molinzhao27/AmazingHand/README.md

## This fork: the 5-digit AmazingHand

This fork adds a pinky to the stock hand and rebuilds it around slim, styled 3-phalanx fingers and a powered 2-DOF wrist. The final version is the right hand `AH_Right_5F_3S_Wrist`.

| Full hand | Without the palm shell | Without shell or finger covers |
|:---:|:---:|:---:|
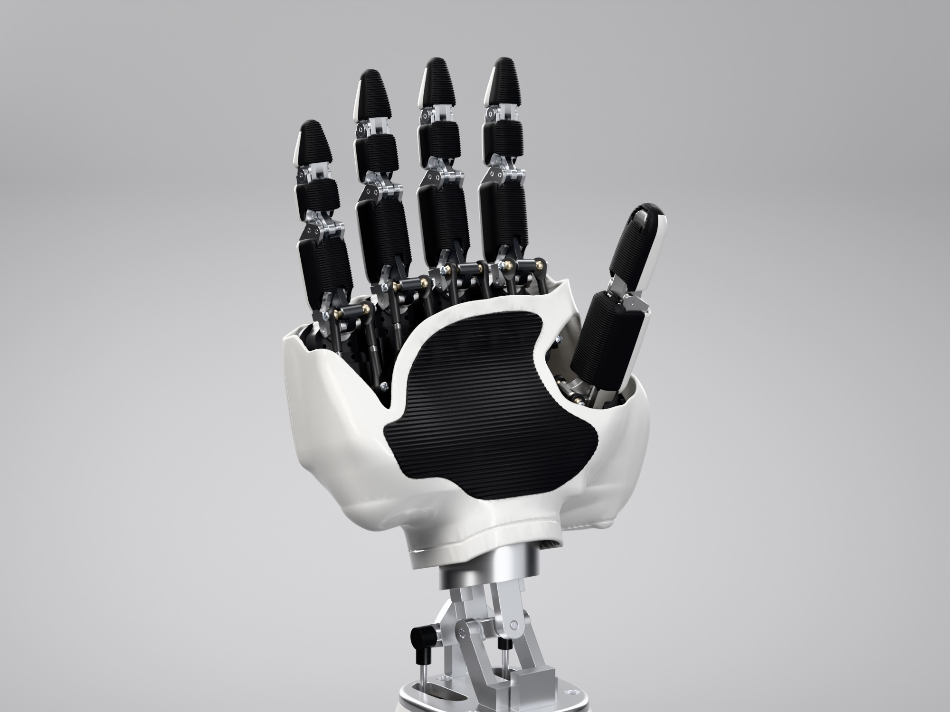
[picture p1: Demo/AHSimulation/five_finger/renders/beauty/hero.jpg]
final hand
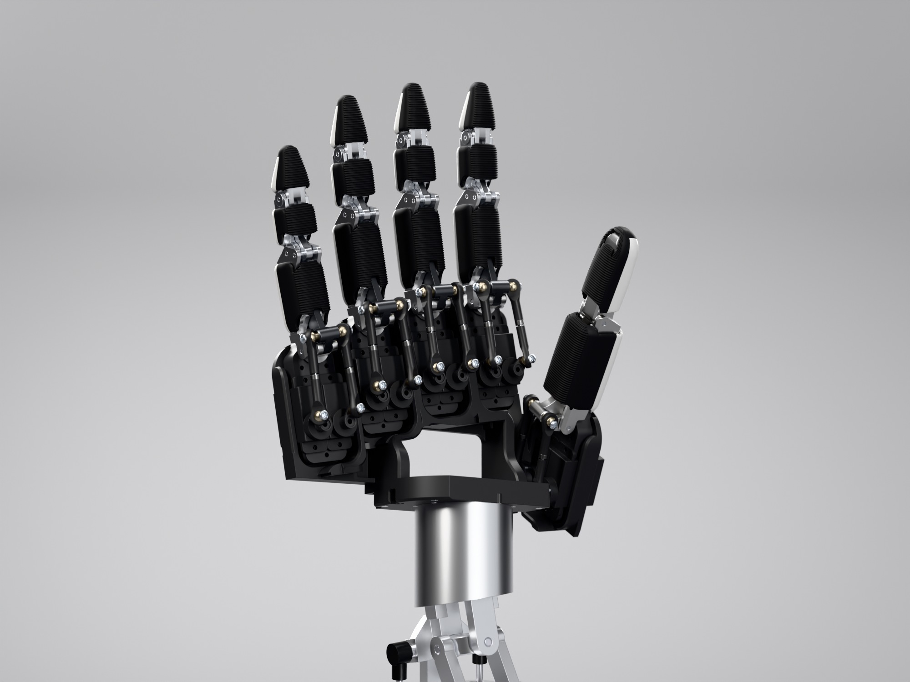
[picture p2: Demo/AHSimulation/five_finger/renders/beauty/no_shells/hero.jpg]
final hand, no palm shell
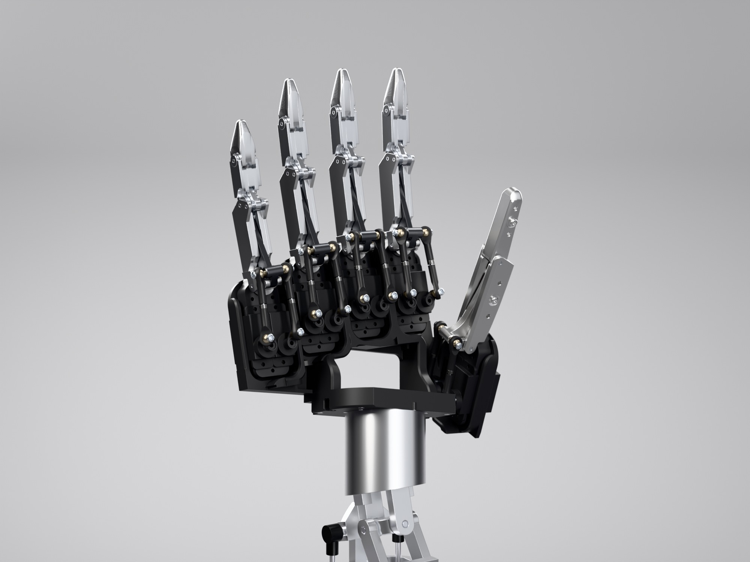
[picture p3: Demo/AHSimulation/five_finger/renders/beauty/no_covers/hero.jpg]
final hand, no shell or covers
|  |  |  |

| What | Where |
|---|---|
| Design notes, BOM delta, servo IDs, power | [FIVE_FINGER.md](FIVE_FINGER.md) |
| Assembled CAD (STEP + 3MF) | [cad/five_finger/assembly/](cad/five_finger/assembly/) |
| Palm plate, palm/back shells and grip pads (STL) | [cad/five_finger/stl/](cad/five_finger/stl/) |
| 3-phalanx fingers and thumb (STEP + STL) | [cad/five_finger/ultimate_finger/](cad/five_finger/ultimate_finger/) |
| Wrist and forearm base (STEP + STL) | [cad/five_finger/wrist/](cad/five_finger/wrist/) |
| MuJoCo model | [Demo/AHSimulation/AHSimulation/AH_Right_5F_3S_Wrist/mjcf/](Demo/AHSimulation/AHSimulation/AH_Right_5F_3S_Wrist/mjcf/) |
| Webcam teleop (sim; drives the final hand, wrist held straight) | [Demo/Teleop/](Demo/Teleop/) |

```bash
python -m mujoco.viewer --mjcf=Demo/AHSimulation/AHSimulation/AH_Right_5F_3S_Wrist/mjcf/scene_shells.xml
```

The other `AH_*_5F*` models are earlier steps. The build scripts still use `AH_Right_5F`, `AH_Right_5F_Slim` and `AH_Right_5F_3S` as inputs to the final one.

Everything below is the upstream Pollen Robotics README.

---

Project is licensed under [Apache 2.0](https://www.apache.org/licenses/LICENSE-2.0)

Mechanical design is licensed under a:
[Creative Commons Attribution 4.0 International License][cc-by].
[][cc-by]
[][cc-by]

[cc-by]: http://creativecommons.org/licenses/by/4.0/
[cc-by-image]: https://licensebuttons.net/l/by/4.0/88x31.png
[cc-by-shield]: https://img.shields.io/badge/License-CC%20BY-lightgrey.svg

# Amazing Hand project

Patterns

Robotic hands are often very expensive and not so expressive. More dexterous ones often need cables and deported actuators in the forearm, i.e.,

The aim of this project is to be able to explore humanoid hand possibilities on a real robot (and Reachy2 is the perfect candidate for that !) with moderate cost.
=> Wrist interface is designed for Reachy2's wrist (Orbita 3D), but it can be easily adapted to other robot's wrist...

Reachy

Amazing Hand is:
- 8 dofs humanoid hand with 4 fingers
- 2 phalanxes per finger articulated together
- flexible shells almost everywhere
- All actuators inside the hand, without any cables
- 3D printable
- 400g weight
- low-cost (<200€)
- open-source

[AmazingHand_Overview](/docs/AmazingHand_Overview.pdf)

Hand Overview
Each finger is driven by a parallel mechanism. 
That means 2x small Feetech SCS0009 servos are used to move each finger in flexion/extension and abduction/adduction

Finger Overview

Two control methods are available:
- Use a serial bus driver (Waveshare i.e.) + Python script
- Use an Arduino + Feetech TTL Linker

Detailed explanations are available for both ways, and basic demo software is also available.
Up to you !

##
## UPDATE : Amazing Hand become **enhanced**, follow the branch "Amazing Hand Enhanced" : https://github.com/pollen-robotics/AmazingHand/tree/Amazing-Hand-Enhanced/AmazingHand_Enhanced

## Table of contents

- [Build Resources](#build-resources)
    - [BOM (Bill Of Materials)](#bom-bill-of-materials)
    - [CAD Files and Onshape document](#cad-files-and-onshape-document)
    - [Assembly Guide](#assembly-guide)
    - [Run_basic_Demo](#run-basic-demo)    
- [Disclaimer](#disclaimer)
- [AmazingHand advanced Demo](#amazinghand-advanced-demo)   
- [Don't want to build it by yourself? Kits are available!](#don't-want-to-build-it-by-yourself-?)    
- [Project Updates & Community](#project-updates-&-community)
    - [To Do List](#to-do-list)
    - [FAQ](#faq)
    - [Contact](#contact)
    - [Thank you](#thank-you)

# Build Resources
## BOM (Bill Of Materials)
List of all needed components is available here:  
[AmazingHand BOM](https://docs.google.com/spreadsheets/d/1QH2ePseqXjAhkWdS9oBYAcHPrxaxkSRCgM_kOK0m52E/edit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)  
BOM

And remember to add control choice cost (2 options detailed previously)

Details for custom 3D printed parts are here: 
[3Dprinted parts](https://docs.google.com/spreadsheets/d/1QH2ePseqXjAhkWdS9oBYAcHPrxaxkSRCgM_kOK0m52E/edit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)

3Dparts

Here is a guide explaining how to print all the needed custom parts:
[=> 3D Printing Guide](/docs/AmazingHand_3DprintingTips.pdf)
3DPrint_example 

## CAD Files and Onshape document
STL and Steps files can be found [here](https://github.com/pollen-robotics/AmazingHand/tree/main/cad) 

Note that fingers are the same if you want to build a left hand, but some parts are symmetrical. Specific right hand parts are preceded by an "R", and other left hand parts by an "L".

Heart

Everyone can access the Onshape document too:   
[Link Onshape](https://cad.onshape.com/documents/430ff184cf3dd9557aaff2be/w/e3658b7152c139971d22c688/e/bd399bf1860732c6c6a2ee45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)  

Note that predefined positions are available in the "named position" tooling, with corresponding servo angles

Onshape&Named_Pos  

## Assembly Guide

Assembly guide for the Amazing Hand in combination with standard components in the BOM is here:  
[=> Assembly Guide](/docs/AmazingHand_Assembly.pdf)  
Assembly_example  

You will need a simple program / script to calibrate each finger, available here:
- With Python & Waveshare serial bus driver: [here](https://github.com/pollen-robotics/AmazingHand/tree/main/PythonExample)
- With Arduino & TTLinker: [here](https://github.com/pollen-robotics/AmazingHand/tree/main/ArduinoExample)

Note that this assembly guide is for a standalone right hand.

If you need to build a standalone left hand, you can keep the same IDs for servo locations, and select if it's a right or left hand in the software.

## Run basic Demo

A basic demo is available with both Python & Arduino.

You will need an external power supply to be able to power the 8 actuators inside the hand.

If you don't have one already, a simple external power supply could be a DC/DC 220V -> 5V / 2A adapter with jack connector.
Check on the BOM list:
[AmazingHand BOM](https://docs.google.com/spreadsheets/d/1QH2ePseqXjAhkWdS9oBYAcHPrxaxkSRCgM_kOK0m52E/edit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) 

- Python script: "AmazingHand_Demo.py" [here](https://github.com/pollen-robotics/AmazingHand/tree/main/ArduinoExample)
  
- Arduino program: "AmazingHand_Demo.ino" [here](https://github.com/pollen-robotics/AmazingHand/tree/main/PythonExample)

https://github.com/user-attachments/assets/485fc1f4-cc57-4e59-90b5-e84518b9fed0

## You need both right & left hands on the same bus ?

If you need to build both right and left hands to plug them on a robot, you will have to attribute different IDs for right and left hands. You can't have same ID for different servos on the same serial bus...
Very important thing is to keep same assembly order for servos, but set them different IDs than for the right hand, as follows:
IDs

Specific software is also needed, in order to drive each hand independently.
This simple demo runs the same hand patterns on both hands simultaneously, but it's only available in Python:
"AmazingHand_Demo_Both" [here](https://github.com/pollen-robotics/AmazingHand/tree/main/PythonExample)

# Disclaimer

I noticed some variations between theoretical angles for Flexion / Extension, Abduction / Adduction and angles in real life prototypes. This is probably due to several sources of variation (3D printed parts are not perfect, balljoint rods are manually adjusted one by one, servo horn rework, flexibility of plastic parts...).

This design has not yet been tested for long and complex prehensile tasks. Before being able to grasp objects safely (that means without damaging servos or mechanical parts), a kind of smart software needs to be built.
SCS0009 servos have smart capabilities as:
- Torque enable / disable
- Torque feedback
- Current position sensor
- Heat temperature feedback
- ...

# AmazingHand advanced Demo
Tracking demo (https://www.youtube.com/watch?v=U0TfeG3ZUto)

For more advanced usage using inverse/forward kinematics there are several examples in the [Demo](Demo) directory along with some useful tools to test/configure the motors.

# Don't want to build it by yourself?
=> Kits are available here :

Seeed Studio :
https://www.seeedstudio.com/Amazing-Hand-Right-Hand-The-Open-Source-Robotic-Hand-Developer-Kit.html

WowRobo :
https://shop.wowrobo.com/products/amazing-hand-the-open-source-robotic-hand-kit

# Project Updates & Community
## Updates from community

- ### Amazing Base for the amazing hand : 
Base
STL or Step file can be found [here](https://github.com/pollen-robotics/AmazingHand/tree/main/cad) 

- ### Specific Chinese BOM available here :
[Chinese BOM](https://docs.google.com/spreadsheets/d/1fHZiTky79vyZwICj5UGP2c_RiuLLm89K8HrB3vpb2h4/edit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)

Thanks to Jianliang Shen !

- ### Amazing Hand Control : Python GUI and CLI tools for controlling the AmazingHand
Key features :
- Control the fingers independently
- Real time monitoring of servo feedbacks
- Create custom animations by saving positions and replaying them sequentially
  
AmazingHandControl

Link to repository : [Link](https://github.com/Betatester777/AmazingHandControl)

Thanks to Betatester777 !

- ### Amazing hand with SG90 servos + force control setup 🔥

Force_control
Force_control_setup

GitHub with code: (https://github.com/joanbox24/AmazingHand-with-sg90-servo-force-control)

- ### Amazing hand interface for SO-Arm 🔥

SoHand

STL or Step file can be found [here](https://github.com/pollen-robotics/AmazingHand/tree/main/cad)
Or directly on onshape workspace, folder "community update"

## To Do List
- Design small custom pcb with serial hub and power supply functions, to fit everything in the hand
- Test with prehensile tasks 
      => Add smarter behaviour for closing hand, based on available motors feedbacks
- Study possibility to have 4 different fingers length, or add a 5th finger
- Study possibility to use STS3032 Feetech motors instead of SCS0009
      => Stronger for quite the same volume, but servo horn is different
- Study possibility to add compliancy by replacing rigid links to springs
- Add fingertip sensor to push one step higher smart control

## FAQ
WIP

## Contact

You can reach public discord channel here : 
[Discord AmazingHand](https://discord.com/channels/519098054377340948/1395021147346698300)

Or 
[Contact me or Pollen Robotics](/docs/contact.md)

## Thank you
Huge thanks to those who have contributed to this project so far:
- [Steve N'Guyen](https://github.com/SteveNguyen) for beta testing, Feetech motors integration in Rustypot, Mujoco/Mink and hand tracking demo
- [Pierre Rouanet](https://github.com/pierre-rouanet) for Feetech motors integration in pypot  
- [Augustin Crampette](https://fr.linkedin.com/in/augustin-crampette) & [Matthieu Lapeyre](https://www.linkedin.com/in/matthieulapeyre/) for open discussions and mechanical advices
