molinzhao27/AmazingHand/cad/five_finger/mockup/report.txt

All-printed mock-up of AH_Right_5F_3S_Wrist: printed stand-ins for the bought parts (generated by make_mockup.py; do not edit)

Fits (mm, diameter): PIN_D 2.0, AXLE_D 2.1, BALL_HOLE 2.0, PEG_D 2.0, STUB_D 4.0, HORN_BORE 3.9, BALL_D 5.0, CUP_CLEAR 0.15, CUP_LIP 1.2, SLIT_W 0.6, WBALL_D 5.8, WBALL_HOLE 3.2, BALL_HALF 2.0, HORN_BOSS 1.6, WCUP_LIP 1.4, STS_STUB_D 6.0, DISC_BORE 5.9, M25_PEG_D 2.4, DISC_HOLE 2.3, F683_OD 7.1, F683_BORE 3.25, PIN3_D 3.05, STUD_TOP_SHANK 4.1, STUD_ARM_SHANK 3.3, INSERT_OD 4.1, INSERT_ID 2.85, M3_PEG_D 3.0, FILAMENT 1.75, CLEAR_FRAME 0.15

stand-in                  qty   deepest overlap with a printed part  note
Axle_D2.1_L20               5    0.05 mm  thumb_Link                  through the Link's d2.2 ball-stud hole, a Ball_D5 pressed on each end
Ball_D5                    20    0.00 mm  -                           d5 ball, pressed flush on the end of a Link axle (2 per Link) or a horn's stud pin (1 per horn)
Bushing_0608               10    0.00 mm  thumb_Gimbal                replaces Bushing_0608 (same shape)
Dummy_SCS0009              10    0.00 mm  -                           servo stand-in; its ear holes (d2.0) take 1.75 mm filament pins into the finger frames
Mock_Horn                  10    0.00 mm  -                           cross horn + the stud's nut; slides onto the Dummy_SCS0009 stub (friction)
Peg_2.5x16                  3                 (no place in the sim)  back shell -> palm plate ribs (2.5x16 thermoplastic screws)
Peg_2.5x6                   4                 (no place in the sim)  hand adapter -> palm plate legs (2.5x6 thermoplastic screws)
Peg_2.5x8                  22                 (no place in the sim)  2.5x8 thermoplastic screw: gimbal (with the washer) 5, finger frames -> plate 3 per digit, back shell -> hand adapter 2
Pin_D2_L10                  6    0.70 mm  thumb_Proximal_Slim         d2 x 10 dowel: printed pin, or a 1.75 mm filament piece (looser)
Pin_D2_L12                 12    0.03 mm  middle_P1_Proximal          d2 x 12 dowel: printed pin, or a 1.75 mm filament piece (looser)
Pin_D2_L16                  6    0.00 mm  thumb_Proximal_Slim         d2 x 16 dowel: printed pin, or a 1.75 mm filament piece (looser)
Pin_D2_L8                   8    0.03 mm  pinky_P3_Distal_S088        d2 x 8 dowel: printed pin, or a 1.75 mm filament piece (looser)
Rod_index_M1                1    0.00 mm  -                           push rod, 33.00 mm between ball centres: cup with the mouth up on the horn ball, the other on the Link ball
Rod_index_M2                1    0.00 mm  -                           push rod, 33.00 mm between ball centres: cup with the mouth up on the horn ball, the other on the Link ball
Rod_middle_M1               1    0.00 mm  -                           push rod, 33.00 mm between ball centres: cup with the mouth up on the horn ball, the other on the Link ball
Rod_middle_M2               1    0.00 mm  -                           push rod, 33.00 mm between ball centres: cup with the mouth up on the horn ball, the other on the Link ball
Rod_pinky_M1                1    0.00 mm  -                           push rod, 33.00 mm between ball centres: cup with the mouth up on the horn ball, the other on the Link ball
Rod_pinky_M2                1    0.00 mm  -                           push rod, 33.00 mm between ball centres: cup with the mouth up on the horn ball, the other on the Link ball
Rod_ring_M1                 1    0.00 mm  -                           push rod, 33.00 mm between ball centres: cup with the mouth up on the horn ball, the other on the Link ball
Rod_ring_M2                 1    0.00 mm  -                           push rod, 33.00 mm between ball centres: cup with the mouth up on the horn ball, the other on the Link ball
Rod_thumb_M1                1    0.00 mm  -                           push rod, 33.00 mm between ball centres: cup with the mouth up on the horn ball, the other on the Link ball
Rod_thumb_M2                1    0.00 mm  -                           push rod, 33.00 mm between ball centres: cup with the mouth up on the horn ball, the other on the Link ball
Stud_Pin_D2.1_L8           10    0.00 mm  -                           the horn's ball stud: pressed through the arm and its boss, flush below; a Ball_D5 pressed on top
Washer_M2.5                 5    0.00 mm  thumb_Gimbal                replaces Washer_M2.5 (same shape)
Ball_D5.8                   4    0.00 mm  -                           d5.8 ball, pressed flush on the end of a ball stud's neck
Ball_Stud_Arm               2    0.23 mm  Wrist_Horn_Arm_2            M3 ball stud stand-in, a pin printed lying down: shank presses through the horn arm (no nut); a Ball_D5.8 pressed flush on the neck
Ball_Stud_Top               2    0.00 mm  -                           M3 ball stud stand-in, a pin printed lying down: shank presses into the lever bar's insert hole; a Ball_D5.8 pressed flush on the neck
Bushing_F683                4    0.09 mm  R-Wrist_Fork                F683ZZ flanged bearing stand-in (4 lugs)
Disc_Horn                   2    0.23 mm  Wrist_Horn_Arm_1            25T disc horn stand-in: slides onto the Dummy_STS3215 stub; the Wrist_Horn_Arm pegs onto it
Dummy_STS3215               2    0.10 mm  R-Wrist_Servo_Frame         STS3215 stand-in (make_wrist's servo box) with a plain d6 output stub
Insert_M3                  12                 (no place in the sim)  M3 heat-set insert stand-in, pressed into the d4.0 insert holes (the bar's 2 take the ball studs)
Peg_M2.5x6                  8                 (no place in the sim)  Wrist_Horn_Arm -> Disc_Horn (4 per arm)
Peg_M3x10                   8                 (no place in the sim)  fork cap 4, elbow flange 4
Peg_M3x8_CSK                4                 (no place in the sim)  servo frame
Pin_D3_L10                  4    0.10 mm  Wrist_Gimbal_Ring           d3 x 10 gimbal pin (press into the ring)
Rod_Wrist_M1                1    0.00 mm  -                           wrist push rod, 66.0 mm between ball centres (cups snap onto the studs)
Rod_Wrist_M2                1    0.00 mm  -                           wrist push rod, 96.0 mm between ball centres (cups snap onto the studs)
