molinzhao27/AmazingHand/cad/five_finger/assembly/report.txt

Assembled CAD of AH_Right_5F_3S_Wrist (generated by make_assembly.py; do not edit)

Sim: Demo/AHSimulation/AHSimulation/AH_Right_5F_3S_Wrist/mjcf/scene_shells.xml, keyframe 'zero' (wrist at wrist_flexion -0.107 deg, wrist_deviation +0.168 deg, wrist_motor1 +0.048 deg, wrist_motor2 +0.222 deg).
Frame: the hand's CAD frame (the palm plate's, as every part in cad/), mm: x index -> pinky, y along the fingers, z towards the back.
256 sim mesh geoms = 255 parts (the hand adapter is split in the sim: interface plate + neck).

AH_Right_5F_3S_Wrist_assembly.step: 98 parts as B-rep (STEP of the part, or the solid it is built from), in sub-assemblies palm, index, middle, ring, pinky, thumb, wrist.
  re-imported: 98 parts, names all match, vertices within 9.8e-11 mm of where they were put, volumes within 2.8e-06 (relative).
AH_Right_5F_3S_Wrist_assembly.3mf: all 255 parts as meshes (the sim meshes, 91 distinct), same names and frame.
  re-imported: 255 parts; every sim vertex within 1.2e-05 mm of its part's vertices.

Placement check (B-rep parts): sim -> CAD = distance of the sim mesh's world vertices to the placed B-rep surface, tessellated to 0.002 mm (max / 99th percentile, limit 0.05 mm); CAD -> sim = the B-rep's surface to the sim mesh (max, limit 1.0 mm): mostly the sim STL's own chordal error (the cad/ STLs are exported with cadquery's relative tolerance), it would catch a STEP feature that the STL lacks.
Mesh parts: the file placed by its 3MF transform vs the sim's world vertices: <= 4.2e-06 mm.
Result: every B-rep part is in place.

part                                       in    source                                                              sim->CAD max/p99  CAD->sim
R-Hand_Plate_5F                            STEP  cad/five_finger/step/R-Hand_Plate_5F.step                            0.0037 / 0.0009    0.0177
R-Palm_Pad_Palm_5F                         3MF   cad/five_finger/stl/R-Palm_Pad_Palm_5F.stl                         
R-Palm_Shell_5F                            3MF   cad/five_finger/stl/R-Palm_Shell_5F.stl                            
R-Top_Shell_5F                             3MF   cad/five_finger/stl/R-Top_Shell_5F.stl                             
index_Bushing_0608_1                       3MF   Demo/AHSimulation/AHSimulation/AH_Right_5F_3S_Wrist/mjcf/assets/bushing_0608_04.stl (m) 
index_Bushing_0608_2                       3MF   Demo/AHSimulation/AHSimulation/AH_Right_5F_3S_Wrist/mjcf/assets/bushing_0608_04.stl (m) 
index_Finger_Frame-1                       STEP  cad/step/Amazing Hand Parts - Finger_Frame-1.step (ICP onto the sim STL)   0.0004 / 0.0004    0.0054
index_Finger_Frame-2                       STEP  cad/step/Amazing Hand Parts - Finger_Frame-2.step (ICP onto the sim STL)   0.0003 / 0.0003    0.0038
index_Gimbal                               STEP  cad/step/Amazing Hand Parts - Gimbal.step (ICP onto the sim STL)     0.0009 / 0.0007    0.0095
index_L2_Coupler                           STEP  cad/five_finger/ultimate_finger/step/UF_L2_Coupler.step              0.0000 / 0.0000    0.0000
index_P1_Pad                               3MF   cad/five_finger/ultimate_finger/stl/UF_P1_Pad.stl                  
index_P1_Proximal                          STEP  cad/five_finger/ultimate_finger/step/UF_P1_Proximal.step             0.0034 / 0.0002    0.0017
index_P1_Shell                             3MF   cad/five_finger/ultimate_finger/stl/UF_P1_Shell.stl                
index_P2_Middle                            STEP  cad/five_finger/ultimate_finger/step/UF_P2_Middle.step               0.0000 / 0.0000    0.0000
index_P2_Pad                               3MF   cad/five_finger/ultimate_finger/stl/UF_P2_Pad.stl                  
index_P2_Shell                             3MF   cad/five_finger/ultimate_finger/stl/UF_P2_Shell.stl                
index_P3_Distal                            3MF   cad/five_finger/ultimate_finger/stl/UF_P3_Distal.stl               
index_P3_Pad                               3MF   cad/five_finger/ultimate_finger/stl/UF_P3_Pad.stl                  
index_P3_Shell                             3MF   cad/five_finger/ultimate_finger/stl/UF_P3_Shell.stl                
index_Pin_2x10                             3MF   Demo/AHSimulation/AHSimulation/AH_Right_5F_3S_Wrist/mjcf/assets/parallel_pin_2_x_10__fee063fca0c8b40e46bbc4ffff61d999.stl (m) 
index_Rod_M2_L18_M1                        3MF   Demo/AHSimulation/AHSimulation/AH_Right_5F_3S_Wrist/mjcf/assets/m2_rod_l18.stl (m) 
index_Rod_M2_L18_M2                        3MF   Demo/AHSimulation/AHSimulation/AH_Right_5F_3S_Wrist/mjcf/assets/m2_rod_l18.stl (m) 
index_Rotule_Ball_1                        3MF   Demo/AHSimulation/AHSimulation/AH_Right_5F_3S_Wrist/mjcf/assets/rotule_ball.stl (m) 
index_Rotule_Ball_2                        3MF   Demo/AHSimulation/AHSimulation/AH_Right_5F_3S_Wrist/mjcf/assets/rotule_ball.stl (m) 
index_Rotule_Ball_M1                       3MF   Demo/AHSimulation/AHSimulation/AH_Right_5F_3S_Wrist/mjcf/assets/rotule_ball.stl (m) 
index_Rotule_Ball_M2                       3MF   Demo/AHSimulation/AHSimulation/AH_Right_5F_3S_Wrist/mjcf/assets/rotule_ball.stl (m) 
index_Rotule_Lever_M1_1                    3MF   Demo/AHSimulation/AHSimulation/AH_Right_5F_3S_Wrist/mjcf/assets/rotule_lever.stl (m) 
index_Rotule_Lever_M1_2                    3MF   Demo/AHSimulation/AHSimulation/AH_Right_5F_3S_Wrist/mjcf/assets/rotule_lever.stl (m) 
index_Rotule_Lever_M2_1                    3MF   Demo/AHSimulation/AHSimulation/AH_Right_5F_3S_Wrist/mjcf/assets/rotule_lever.stl (m) 
index_Rotule_Lever_M2_2                    3MF   Demo/AHSimulation/AHSimulation/AH_Right_5F_3S_Wrist/mjcf/assets/rotule_lever.stl (m) 
index_SCS0009_Servo_M1                     3MF   Demo/AHSimulation/AHSimulation/AH_Right_5F_3S_Wrist/mjcf/assets/scs0009.stl (m) 
index_SCS0009_Servo_M2                     3MF   Demo/AHSimulation/AHSimulation/AH_Right_5F_3S_Wrist/mjcf/assets/scs0009.stl (m) 
index_Screw_2.5x8_Torx                     3MF   Demo/AHSimulation/AHSimulation/AH_Right_5F_3S_Wrist/mjcf/assets/std00333_plast_tcb_torx_2_5x8__configuration_copy_of_default.stl (m) 
index_Screw_M2x10_Pan_1                    3MF   Demo/AHSimulation/AHSimulation/AH_Right_5F_3S_Wrist/mjcf/assets/ph_pan_head_screw_m2x0_40_x_10__2803432263e518bbd16bccbbef8784ed.stl (m) 
index_Screw_M2x10_Pan_2                    3MF   Demo/AHSimulation/AHSimulation/AH_Right_5F_3S_Wrist/mjcf/assets/ph_pan_head_screw_m2x0_40_x_10__2803432263e518bbd16bccbbef8784ed.stl (m) 
index_Screw_M2x10_Pan_M1                   3MF   Demo/AHSimulation/AHSimulation/AH_Right_5F_3S_Wrist/mjcf/assets/ph_pan_head_screw_m2x0_40_x_10__2803432263e518bbd16bccbbef8784ed.stl (m) 
index_Screw_M2x10_Pan_M2                   3MF   Demo/AHSimulation/AHSimulation/AH_Right_5F_3S_Wrist/mjcf/assets/ph_pan_head_screw_m2x0_40_x_10__2803432263e518bbd16bccbbef8784ed.stl (m) 
index_Servo_Horn_M1                        3MF   Demo/AHSimulation/AHSimulation/AH_Right_5F_3S_Wrist/mjcf/assets/custom_servo_horn.stl (m) 
index_Servo_Horn_M2                        3MF   Demo/AHSimulation/AHSimulation/AH_Right_5F_3S_Wrist/mjcf/assets/custom_servo_horn.stl (m) 
index_Spacer_M1                            STEP  cad/step/BallJoint_Rod - Spacer.step (ICP onto the sim STL)          0.0002 / 0.0002    0.0019
index_Spacer_M2                            STEP  cad/step/BallJoint_Rod - Spacer.step (ICP onto the sim STL)          0.0002 / 0.0002    0.0019
index_UF_Link                              STEP  cad/five_finger/ultimate_finger/step/UF_Link.step                    0.0002 / 0.0002    0.0024
index_Washer_M2.5                          3MF   Demo/AHSimulation/AHSimulation/AH_Right_5F_3S_Wrist/mjcf/assets/plain_washer_large_grade_a_m2_5__9a369f0dc77bf9c598cdf3fb468977e5.stl (m) 
index_pin_2x12_A                           STEP  cad/five_finger/ultimate_finger/step/pin_2x12_A.step                 0.0000 / 0.0000    0.0008
index_pin_2x12_DIP                         STEP  cad/five_finger/ultimate_finger/step/pin_2x12_DIP.step               0.0000 / 0.0000    0.0008
index_pin_2x12_PIP                         STEP  cad/five_finger/ultimate_finger/step/pin_2x12_PIP.step               0.0000 / 0.0000    0.0008
index_pin_2x16_MCP                         STEP  cad/five_finger/ultimate_finger/step/pin_2x16_MCP.step               0.0000 / 0.0000    0.0008
index_pin_2x8_B                            STEP  cad/five_finger/ultimate_finger/step/pin_2x8_B.step                  0.0000 / 0.0000    0.0008
index_pin_2x8_P4                           STEP  cad/five_finger/ultimate_finger/step/pin_2x8_P4.step                 0.0000 / 0.0000    0.0008
middle_Bushing_0608_1                      3MF   Demo/AHSimulation/AHSimulation/AH_Right_5F_3S_Wrist/mjcf/assets/bushing_0608_04.stl (m) 
middle_Bushing_0608_2                      3MF   Demo/AHSimulation/AHSimulation/AH_Right_5F_3S_Wrist/mjcf/assets/bushing_0608_04.stl (m) 
middle_Finger_Frame-1                      STEP  cad/step/Amazing Hand Parts - Finger_Frame-1.step (ICP onto the sim STL)   0.0004 / 0.0004    0.0054
middle_Finger_Frame-2                      STEP  cad/step/Amazing Hand Parts - Finger_Frame-2.step (ICP onto the sim STL)   0.0003 / 0.0003    0.0038
middle_Gimbal                              STEP  cad/step/Amazing Hand Parts - Gimbal.step (ICP onto the sim STL)     0.0009 / 0.0007    0.0095
middle_L2_Coupler                          STEP  cad/five_finger/ultimate_finger/step/UF_L2_Coupler.step              0.0000 / 0.0000    0.0000
middle_P1_Pad                              3MF   cad/five_finger/ultimate_finger/stl/UF_P1_Pad.stl                  
middle_P1_Proximal                         STEP  cad/five_finger/ultimate_finger/step/UF_P1_Proximal.step             0.0034 / 0.0002    0.0017
middle_P1_Shell                            3MF   cad/five_finger/ultimate_finger/stl/UF_P1_Shell.stl                
middle_P2_Middle                           STEP  cad/five_finger/ultimate_finger/step/UF_P2_Middle.step               0.0000 / 0.0000    0.0000
middle_P2_Pad                              3MF   cad/five_finger/ultimate_finger/stl/UF_P2_Pad.stl                  
middle_P2_Shell                            3MF   cad/five_finger/ultimate_finger/stl/UF_P2_Shell.stl                
middle_P3_Distal                           3MF   cad/five_finger/ultimate_finger/stl/UF_P3_Distal.stl               
middle_P3_Pad                              3MF   cad/five_finger/ultimate_finger/stl/UF_P3_Pad.stl                  
middle_P3_Shell                            3MF   cad/five_finger/ultimate_finger/stl/UF_P3_Shell.stl                
middle_Pin_2x10                            3MF   Demo/AHSimulation/AHSimulation/AH_Right_5F_3S_Wrist/mjcf/assets/parallel_pin_2_x_10__fee063fca0c8b40e46bbc4ffff61d999.stl (m) 
middle_Rod_M2_L18_M1                       3MF   Demo/AHSimulation/AHSimulation/AH_Right_5F_3S_Wrist/mjcf/assets/m2_rod_l18.stl (m) 
middle_Rod_M2_L18_M2                       3MF   Demo/AHSimulation/AHSimulation/AH_Right_5F_3S_Wrist/mjcf/assets/m2_rod_l18.stl (m) 
middle_Rotule_Ball_1                       3MF   Demo/AHSimulation/AHSimulation/AH_Right_5F_3S_Wrist/mjcf/assets/rotule_ball.stl (m) 
middle_Rotule_Ball_2                       3MF   Demo/AHSimulation/AHSimulation/AH_Right_5F_3S_Wrist/mjcf/assets/rotule_ball.stl (m) 
middle_Rotule_Ball_M1                      3MF   Demo/AHSimulation/AHSimulation/AH_Right_5F_3S_Wrist/mjcf/assets/rotule_ball.stl (m) 
middle_Rotule_Ball_M2                      3MF   Demo/AHSimulation/AHSimulation/AH_Right_5F_3S_Wrist/mjcf/assets/rotule_ball.stl (m) 
middle_Rotule_Lever_M1_1                   3MF   Demo/AHSimulation/AHSimulation/AH_Right_5F_3S_Wrist/mjcf/assets/rotule_lever.stl (m) 
middle_Rotule_Lever_M1_2                   3MF   Demo/AHSimulation/AHSimulation/AH_Right_5F_3S_Wrist/mjcf/assets/rotule_lever.stl (m) 
middle_Rotule_Lever_M2_1                   3MF   Demo/AHSimulation/AHSimulation/AH_Right_5F_3S_Wrist/mjcf/assets/rotule_lever.stl (m) 
middle_Rotule_Lever_M2_2                   3MF   Demo/AHSimulation/AHSimulation/AH_Right_5F_3S_Wrist/mjcf/assets/rotule_lever.stl (m) 
middle_SCS0009_Servo_M1                    3MF   Demo/AHSimulation/AHSimulation/AH_Right_5F_3S_Wrist/mjcf/assets/scs0009.stl (m) 
middle_SCS0009_Servo_M2                    3MF   Demo/AHSimulation/AHSimulation/AH_Right_5F_3S_Wrist/mjcf/assets/scs0009.stl (m) 
middle_Screw_2.5x8_Torx                    3MF   Demo/AHSimulation/AHSimulation/AH_Right_5F_3S_Wrist/mjcf/assets/std00333_plast_tcb_torx_2_5x8__configuration_copy_of_default.stl (m) 
middle_Screw_M2x10_Pan_1                   3MF   Demo/AHSimulation/AHSimulation/AH_Right_5F_3S_Wrist/mjcf/assets/ph_pan_head_screw_m2x0_40_x_10__2803432263e518bbd16bccbbef8784ed.stl (m) 
middle_Screw_M2x10_Pan_2                   3MF   Demo/AHSimulation/AHSimulation/AH_Right_5F_3S_Wrist/mjcf/assets/ph_pan_head_screw_m2x0_40_x_10__2803432263e518bbd16bccbbef8784ed.stl (m) 
middle_Screw_M2x10_Pan_M1                  3MF   Demo/AHSimulation/AHSimulation/AH_Right_5F_3S_Wrist/mjcf/assets/ph_pan_head_screw_m2x0_40_x_10__2803432263e518bbd16bccbbef8784ed.stl (m) 
middle_Screw_M2x10_Pan_M2                  3MF   Demo/AHSimulation/AHSimulation/AH_Right_5F_3S_Wrist/mjcf/assets/ph_pan_head_screw_m2x0_40_x_10__2803432263e518bbd16bccbbef8784ed.stl (m) 
middle_Servo_Horn_M1                       3MF   Demo/AHSimulation/AHSimulation/AH_Right_5F_3S_Wrist/mjcf/assets/custom_servo_horn.stl (m) 
middle_Servo_Horn_M2                       3MF   Demo/AHSimulation/AHSimulation/AH_Right_5F_3S_Wrist/mjcf/assets/custom_servo_horn.stl (m) 
middle_Spacer_M1                           STEP  cad/step/BallJoint_Rod - Spacer.step (ICP onto the sim STL)          0.0002 / 0.0002    0.0019
middle_Spacer_M2                           STEP  cad/step/BallJoint_Rod - Spacer.step (ICP onto the sim STL)          0.0002 / 0.0002    0.0019
middle_UF_Link                             STEP  cad/five_finger/ultimate_finger/step/UF_Link.step                    0.0002 / 0.0002    0.0024
middle_Washer_M2.5                         3MF   Demo/AHSimulation/AHSimulation/AH_Right_5F_3S_Wrist/mjcf/assets/plain_washer_large_grade_a_m2_5__9a369f0dc77bf9c598cdf3fb468977e5.stl (m) 
middle_pin_2x12_A                          STEP  cad/five_finger/ultimate_finger/step/pin_2x12_A.step                 0.0000 / 0.0000    0.0008
middle_pin_2x12_DIP                        STEP  cad/five_finger/ultimate_finger/step/pin_2x12_DIP.step               0.0000 / 0.0000    0.0008
middle_pin_2x12_PIP                        STEP  cad/five_finger/ultimate_finger/step/pin_2x12_PIP.step               0.0000 / 0.0000    0.0008
middle_pin_2x16_MCP                        STEP  cad/five_finger/ultimate_finger/step/pin_2x16_MCP.step               0.0000 / 0.0000    0.0008
middle_pin_2x8_B                           STEP  cad/five_finger/ultimate_finger/step/pin_2x8_B.step                  0.0000 / 0.0000    0.0008
middle_pin_2x8_P4                          STEP  cad/five_finger/ultimate_finger/step/pin_2x8_P4.step                 0.0000 / 0.0000    0.0008
ring_Bushing_0608_1                        3MF   Demo/AHSimulation/AHSimulation/AH_Right_5F_3S_Wrist/mjcf/assets/bushing_0608_04.stl (m) 
ring_Bushing_0608_2                        3MF   Demo/AHSimulation/AHSimulation/AH_Right_5F_3S_Wrist/mjcf/assets/bushing_0608_04.stl (m) 
ring_Finger_Frame-1                        STEP  cad/step/Amazing Hand Parts - Finger_Frame-1.step (ICP onto the sim STL)   0.0004 / 0.0004    0.0054
ring_Finger_Frame-2                        STEP  cad/step/Amazing Hand Parts - Finger_Frame-2.step (ICP onto the sim STL)   0.0003 / 0.0003    0.0038
ring_Gimbal                                STEP  cad/step/Amazing Hand Parts - Gimbal.step (ICP onto the sim STL)     0.0009 / 0.0007    0.0095
ring_L2_Coupler                            STEP  cad/five_finger/ultimate_finger/step/UF_L2_Coupler.step              0.0000 / 0.0000    0.0000
ring_P1_Pad                                3MF   cad/five_finger/ultimate_finger/stl/UF_P1_Pad.stl                  
ring_P1_Proximal                           STEP  cad/five_finger/ultimate_finger/step/UF_P1_Proximal.step             0.0034 / 0.0002    0.0017
ring_P1_Shell                              3MF   cad/five_finger/ultimate_finger/stl/UF_P1_Shell.stl                
ring_P2_Middle                             STEP  cad/five_finger/ultimate_finger/step/UF_P2_Middle.step               0.0000 / 0.0000    0.0000
ring_P2_Pad                                3MF   cad/five_finger/ultimate_finger/stl/UF_P2_Pad.stl                  
ring_P2_Shell                              3MF   cad/five_finger/ultimate_finger/stl/UF_P2_Shell.stl                
ring_P3_Distal                             3MF   cad/five_finger/ultimate_finger/stl/UF_P3_Distal.stl               
ring_P3_Pad                                3MF   cad/five_finger/ultimate_finger/stl/UF_P3_Pad.stl                  
ring_P3_Shell                              3MF   cad/five_finger/ultimate_finger/stl/UF_P3_Shell.stl                
ring_Pin_2x10                              3MF   Demo/AHSimulation/AHSimulation/AH_Right_5F_3S_Wrist/mjcf/assets/parallel_pin_2_x_10__fee063fca0c8b40e46bbc4ffff61d999.stl (m) 
ring_Rod_M2_L18_M1                         3MF   Demo/AHSimulation/AHSimulation/AH_Right_5F_3S_Wrist/mjcf/assets/m2_rod_l18.stl (m) 
ring_Rod_M2_L18_M2                         3MF   Demo/AHSimulation/AHSimulation/AH_Right_5F_3S_Wrist/mjcf/assets/m2_rod_l18.stl (m) 
ring_Rotule_Ball_1                         3MF   Demo/AHSimulation/AHSimulation/AH_Right_5F_3S_Wrist/mjcf/assets/rotule_ball.stl (m) 
ring_Rotule_Ball_2                         3MF   Demo/AHSimulation/AHSimulation/AH_Right_5F_3S_Wrist/mjcf/assets/rotule_ball.stl (m) 
ring_Rotule_Ball_M1                        3MF   Demo/AHSimulation/AHSimulation/AH_Right_5F_3S_Wrist/mjcf/assets/rotule_ball.stl (m) 
ring_Rotule_Ball_M2                        3MF   Demo/AHSimulation/AHSimulation/AH_Right_5F_3S_Wrist/mjcf/assets/rotule_ball.stl (m) 
ring_Rotule_Lever_M1_1                     3MF   Demo/AHSimulation/AHSimulation/AH_Right_5F_3S_Wrist/mjcf/assets/rotule_lever.stl (m) 
ring_Rotule_Lever_M1_2                     3MF   Demo/AHSimulation/AHSimulation/AH_Right_5F_3S_Wrist/mjcf/assets/rotule_lever.stl (m) 
ring_Rotule_Lever_M2_1                     3MF   Demo/AHSimulation/AHSimulation/AH_Right_5F_3S_Wrist/mjcf/assets/rotule_lever.stl (m) 
ring_Rotule_Lever_M2_2                     3MF   Demo/AHSimulation/AHSimulation/AH_Right_5F_3S_Wrist/mjcf/assets/rotule_lever.stl (m) 
ring_SCS0009_Servo_M1                      3MF   Demo/AHSimulation/AHSimulation/AH_Right_5F_3S_Wrist/mjcf/assets/scs0009.stl (m) 
ring_SCS0009_Servo_M2                      3MF   Demo/AHSimulation/AHSimulation/AH_Right_5F_3S_Wrist/mjcf/assets/scs0009.stl (m) 
ring_Screw_2.5x8_Torx                      3MF   Demo/AHSimulation/AHSimulation/AH_Right_5F_3S_Wrist/mjcf/assets/std00333_plast_tcb_torx_2_5x8__configuration_copy_of_default.stl (m) 
ring_Screw_M2x10_Pan_1                     3MF   Demo/AHSimulation/AHSimulation/AH_Right_5F_3S_Wrist/mjcf/assets/ph_pan_head_screw_m2x0_40_x_10__2803432263e518bbd16bccbbef8784ed.stl (m) 
ring_Screw_M2x10_Pan_2                     3MF   Demo/AHSimulation/AHSimulation/AH_Right_5F_3S_Wrist/mjcf/assets/ph_pan_head_screw_m2x0_40_x_10__2803432263e518bbd16bccbbef8784ed.stl (m) 
ring_Screw_M2x10_Pan_M1                    3MF   Demo/AHSimulation/AHSimulation/AH_Right_5F_3S_Wrist/mjcf/assets/ph_pan_head_screw_m2x0_40_x_10__2803432263e518bbd16bccbbef8784ed.stl (m) 
ring_Screw_M2x10_Pan_M2                    3MF   Demo/AHSimulation/AHSimulation/AH_Right_5F_3S_Wrist/mjcf/assets/ph_pan_head_screw_m2x0_40_x_10__2803432263e518bbd16bccbbef8784ed.stl (m) 
ring_Servo_Horn_M1                         3MF   Demo/AHSimulation/AHSimulation/AH_Right_5F_3S_Wrist/mjcf/assets/custom_servo_horn.stl (m) 
ring_Servo_Horn_M2                         3MF   Demo/AHSimulation/AHSimulation/AH_Right_5F_3S_Wrist/mjcf/assets/custom_servo_horn.stl (m) 
ring_Spacer_M1                             STEP  cad/step/BallJoint_Rod - Spacer.step (ICP onto the sim STL)          0.0002 / 0.0002    0.0019
ring_Spacer_M2                             STEP  cad/step/BallJoint_Rod - Spacer.step (ICP onto the sim STL)          0.0002 / 0.0002    0.0019
ring_UF_Link                               STEP  cad/five_finger/ultimate_finger/step/UF_Link.step                    0.0002 / 0.0002    0.0024
ring_Washer_M2.5                           3MF   Demo/AHSimulation/AHSimulation/AH_Right_5F_3S_Wrist/mjcf/assets/plain_washer_large_grade_a_m2_5__9a369f0dc77bf9c598cdf3fb468977e5.stl (m) 
ring_pin_2x12_A                            STEP  cad/five_finger/ultimate_finger/step/pin_2x12_A.step                 0.0000 / 0.0000    0.0008
ring_pin_2x12_DIP                          STEP  cad/five_finger/ultimate_finger/step/pin_2x12_DIP.step               0.0000 / 0.0000    0.0008
ring_pin_2x12_PIP                          STEP  cad/five_finger/ultimate_finger/step/pin_2x12_PIP.step               0.0000 / 0.0000    0.0008
ring_pin_2x16_MCP                          STEP  cad/five_finger/ultimate_finger/step/pin_2x16_MCP.step               0.0000 / 0.0000    0.0008
ring_pin_2x8_B                             STEP  cad/five_finger/ultimate_finger/step/pin_2x8_B.step                  0.0000 / 0.0000    0.0008
ring_pin_2x8_P4                            STEP  cad/five_finger/ultimate_finger/step/pin_2x8_P4.step                 0.0000 / 0.0000    0.0008
pinky_Bushing_0608_1                       3MF   Demo/AHSimulation/AHSimulation/AH_Right_5F_3S_Wrist/mjcf/assets/bushing_0608_04.stl (m) 
pinky_Bushing_0608_2                       3MF   Demo/AHSimulation/AHSimulation/AH_Right_5F_3S_Wrist/mjcf/assets/bushing_0608_04.stl (m) 
pinky_Finger_Frame-1                       STEP  cad/step/Amazing Hand Parts - Finger_Frame-1.step (ICP onto the sim STL)   0.0004 / 0.0004    0.0054
pinky_Finger_Frame-2                       STEP  cad/step/Amazing Hand Parts - Finger_Frame-2.step (ICP onto the sim STL)   0.0003 / 0.0003    0.0038
pinky_Gimbal                               STEP  cad/step/Amazing Hand Parts - Gimbal.step (ICP onto the sim STL)     0.0009 / 0.0007    0.0095
pinky_L2_Coupler_S088                      STEP  cad/five_finger/ultimate_finger/step/UF_L2_Coupler_S088.step         0.0000 / 0.0000    0.0000
pinky_P1_Pad_S088                          3MF   cad/five_finger/ultimate_finger/stl/UF_P1_Pad_S088.stl             
pinky_P1_Proximal_S088                     STEP  cad/five_finger/ultimate_finger/step/UF_P1_Proximal_S088.step        0.0040 / 0.0002    0.0017
pinky_P1_Shell_S088                        3MF   cad/five_finger/ultimate_finger/stl/UF_P1_Shell_S088.stl           
pinky_P2_Middle_S088                       STEP  cad/five_finger/ultimate_finger/step/UF_P2_Middle_S088.step          0.0000 / 0.0000    0.0000
pinky_P2_Pad_S088                          3MF   cad/five_finger/ultimate_finger/stl/UF_P2_Pad_S088.stl             
pinky_P2_Shell_S088                        3MF   cad/five_finger/ultimate_finger/stl/UF_P2_Shell_S088.stl           
pinky_P3_Distal_S088                       3MF   cad/five_finger/ultimate_finger/stl/UF_P3_Distal_S088.stl          
pinky_P3_Pad_S088                          3MF   cad/five_finger/ultimate_finger/stl/UF_P3_Pad_S088.stl             
pinky_P3_Shell_S088                        3MF   cad/five_finger/ultimate_finger/stl/UF_P3_Shell_S088.stl           
pinky_Pin_2x10                             3MF   Demo/AHSimulation/AHSimulation/AH_Right_5F_3S_Wrist/mjcf/assets/parallel_pin_2_x_10__fee063fca0c8b40e46bbc4ffff61d999.stl (m) 
pinky_Rod_M2_L18_M1                        3MF   Demo/AHSimulation/AHSimulation/AH_Right_5F_3S_Wrist/mjcf/assets/m2_rod_l18.stl (m) 
pinky_Rod_M2_L18_M2                        3MF   Demo/AHSimulation/AHSimulation/AH_Right_5F_3S_Wrist/mjcf/assets/m2_rod_l18.stl (m) 
pinky_Rotule_Ball_1                        3MF   Demo/AHSimulation/AHSimulation/AH_Right_5F_3S_Wrist/mjcf/assets/rotule_ball.stl (m) 
pinky_Rotule_Ball_2                        3MF   Demo/AHSimulation/AHSimulation/AH_Right_5F_3S_Wrist/mjcf/assets/rotule_ball.stl (m) 
pinky_Rotule_Ball_M1                       3MF   Demo/AHSimulation/AHSimulation/AH_Right_5F_3S_Wrist/mjcf/assets/rotule_ball.stl (m) 
pinky_Rotule_Ball_M2                       3MF   Demo/AHSimulation/AHSimulation/AH_Right_5F_3S_Wrist/mjcf/assets/rotule_ball.stl (m) 
pinky_Rotule_Lever_M1_1                    3MF   Demo/AHSimulation/AHSimulation/AH_Right_5F_3S_Wrist/mjcf/assets/rotule_lever.stl (m) 
pinky_Rotule_Lever_M1_2                    3MF   Demo/AHSimulation/AHSimulation/AH_Right_5F_3S_Wrist/mjcf/assets/rotule_lever.stl (m) 
pinky_Rotule_Lever_M2_1                    3MF   Demo/AHSimulation/AHSimulation/AH_Right_5F_3S_Wrist/mjcf/assets/rotule_lever.stl (m) 
pinky_Rotule_Lever_M2_2                    3MF   Demo/AHSimulation/AHSimulation/AH_Right_5F_3S_Wrist/mjcf/assets/rotule_lever.stl (m) 
pinky_SCS0009_Servo_M1                     3MF   Demo/AHSimulation/AHSimulation/AH_Right_5F_3S_Wrist/mjcf/assets/scs0009.stl (m) 
pinky_SCS0009_Servo_M2                     3MF   Demo/AHSimulation/AHSimulation/AH_Right_5F_3S_Wrist/mjcf/assets/scs0009.stl (m) 
pinky_Screw_2.5x8_Torx                     3MF   Demo/AHSimulation/AHSimulation/AH_Right_5F_3S_Wrist/mjcf/assets/std00333_plast_tcb_torx_2_5x8__configuration_copy_of_default.stl (m) 
pinky_Screw_M2x10_Pan_1                    3MF   Demo/AHSimulation/AHSimulation/AH_Right_5F_3S_Wrist/mjcf/assets/ph_pan_head_screw_m2x0_40_x_10__2803432263e518bbd16bccbbef8784ed.stl (m) 
pinky_Screw_M2x10_Pan_2                    3MF   Demo/AHSimulation/AHSimulation/AH_Right_5F_3S_Wrist/mjcf/assets/ph_pan_head_screw_m2x0_40_x_10__2803432263e518bbd16bccbbef8784ed.stl (m) 
pinky_Screw_M2x10_Pan_M1                   3MF   Demo/AHSimulation/AHSimulation/AH_Right_5F_3S_Wrist/mjcf/assets/ph_pan_head_screw_m2x0_40_x_10__2803432263e518bbd16bccbbef8784ed.stl (m) 
pinky_Screw_M2x10_Pan_M2                   3MF   Demo/AHSimulation/AHSimulation/AH_Right_5F_3S_Wrist/mjcf/assets/ph_pan_head_screw_m2x0_40_x_10__2803432263e518bbd16bccbbef8784ed.stl (m) 
pinky_Servo_Horn_M1                        3MF   Demo/AHSimulation/AHSimulation/AH_Right_5F_3S_Wrist/mjcf/assets/custom_servo_horn.stl (m) 
pinky_Servo_Horn_M2                        3MF   Demo/AHSimulation/AHSimulation/AH_Right_5F_3S_Wrist/mjcf/assets/custom_servo_horn.stl (m) 
pinky_Spacer_M1                            STEP  cad/step/BallJoint_Rod - Spacer.step (ICP onto the sim STL)          0.0002 / 0.0002    0.0019
pinky_Spacer_M2                            STEP  cad/step/BallJoint_Rod - Spacer.step (ICP onto the sim STL)          0.0002 / 0.0002    0.0019
pinky_UF_Link_S088                         STEP  cad/five_finger/ultimate_finger/step/UF_Link_S088.step               0.0002 / 0.0002    0.0024
pinky_Washer_M2.5                          3MF   Demo/AHSimulation/AHSimulation/AH_Right_5F_3S_Wrist/mjcf/assets/plain_washer_large_grade_a_m2_5__9a369f0dc77bf9c598cdf3fb468977e5.stl (m) 
pinky_pin_2x12_A_S088                      STEP  cad/five_finger/ultimate_finger/step/pin_2x12_A_S088.step            0.0000 / 0.0000    0.0008
pinky_pin_2x12_DIP_S088                    STEP  cad/five_finger/ultimate_finger/step/pin_2x12_DIP_S088.step          0.0000 / 0.0000    0.0008
pinky_pin_2x12_PIP_S088                    STEP  cad/five_finger/ultimate_finger/step/pin_2x12_PIP_S088.step          0.0000 / 0.0000    0.0008
pinky_pin_2x16_MCP_S088                    STEP  cad/five_finger/ultimate_finger/step/pin_2x16_MCP_S088.step          0.0000 / 0.0000    0.0008
pinky_pin_2x8_B_S088                       STEP  cad/five_finger/ultimate_finger/step/pin_2x8_B_S088.step             0.0000 / 0.0000    0.0008
pinky_pin_2x8_P4_S088                      STEP  cad/five_finger/ultimate_finger/step/pin_2x8_P4_S088.step            0.0000 / 0.0000    0.0008
thumb_Bushing_0608_1                       3MF   Demo/AHSimulation/AHSimulation/AH_Right_5F_3S_Wrist/mjcf/assets/bushing_0608_04.stl (m) 
thumb_Bushing_0608_2                       3MF   Demo/AHSimulation/AHSimulation/AH_Right_5F_3S_Wrist/mjcf/assets/bushing_0608_04.stl (m) 
thumb_Distal_Pad                           3MF   cad/five_finger/ultimate_finger/stl/Thumb_Distal_Pad.stl           
thumb_Distal_Shell                         3MF   cad/five_finger/ultimate_finger/stl/Thumb_Distal_Shell.stl         
thumb_Distal_Slim                          STEP  cad/five_finger/slim_fingers/step/Distal_Slim.step                   0.0029 / 0.0011    0.0297
thumb_Finger_Frame-1                       STEP  cad/step/Amazing Hand Parts - Finger_Frame-1.step (ICP onto the sim STL)   0.0004 / 0.0004    0.0054
thumb_Finger_Frame-2                       STEP  cad/step/Amazing Hand Parts - Finger_Frame-2.step (ICP onto the sim STL)   0.0003 / 0.0003    0.0038
thumb_Gimbal                               STEP  cad/step/Amazing Hand Parts - Gimbal.step (ICP onto the sim STL)     0.0009 / 0.0007    0.0095
thumb_Link                                 STEP  cad/step/Amazing Hand Parts - Link.step (ICP onto the sim STL)       0.0009 / 0.0003    0.0750
thumb_Pin_2x10_1                           3MF   Demo/AHSimulation/AHSimulation/AH_Right_5F_3S_Wrist/mjcf/assets/parallel_pin_2_x_10__fee063fca0c8b40e46bbc4ffff61d999.stl (m) 
thumb_Pin_2x10_2                           3MF   Demo/AHSimulation/AHSimulation/AH_Right_5F_3S_Wrist/mjcf/assets/parallel_pin_2_x_10__fee063fca0c8b40e46bbc4ffff61d999.stl (m) 
thumb_Pin_2x16_1                           3MF   Demo/AHSimulation/AHSimulation/AH_Right_5F_3S_Wrist/mjcf/assets/parallel_pin_2_x_16__da4b7ddbe9d803fe3fbc70f2e822b99b.stl (m) 
thumb_Pin_2x16_2                           3MF   Demo/AHSimulation/AHSimulation/AH_Right_5F_3S_Wrist/mjcf/assets/parallel_pin_2_x_16__da4b7ddbe9d803fe3fbc70f2e822b99b.stl (m) 
thumb_Proximal_Pad                         3MF   cad/five_finger/ultimate_finger/stl/Thumb_Proximal_Pad.stl         
thumb_Proximal_Shell                       3MF   cad/five_finger/ultimate_finger/stl/Thumb_Proximal_Shell.stl       
thumb_Proximal_Slim                        STEP  cad/five_finger/slim_fingers/step/Proximal_Slim.step                 0.0036 / 0.0005    0.0473
thumb_Rod_M2_L18_M1                        3MF   Demo/AHSimulation/AHSimulation/AH_Right_5F_3S_Wrist/mjcf/assets/m2_rod_l18.stl (m) 
thumb_Rod_M2_L18_M2                        3MF   Demo/AHSimulation/AHSimulation/AH_Right_5F_3S_Wrist/mjcf/assets/m2_rod_l18.stl (m) 
thumb_Rotule_Ball_1                        3MF   Demo/AHSimulation/AHSimulation/AH_Right_5F_3S_Wrist/mjcf/assets/rotule_ball.stl (m) 
thumb_Rotule_Ball_2                        3MF   Demo/AHSimulation/AHSimulation/AH_Right_5F_3S_Wrist/mjcf/assets/rotule_ball.stl (m) 
thumb_Rotule_Ball_M1                       3MF   Demo/AHSimulation/AHSimulation/AH_Right_5F_3S_Wrist/mjcf/assets/rotule_ball.stl (m) 
thumb_Rotule_Ball_M2                       3MF   Demo/AHSimulation/AHSimulation/AH_Right_5F_3S_Wrist/mjcf/assets/rotule_ball.stl (m) 
thumb_Rotule_Lever_M1_1                    3MF   Demo/AHSimulation/AHSimulation/AH_Right_5F_3S_Wrist/mjcf/assets/rotule_lever.stl (m) 
thumb_Rotule_Lever_M1_2                    3MF   Demo/AHSimulation/AHSimulation/AH_Right_5F_3S_Wrist/mjcf/assets/rotule_lever.stl (m) 
thumb_Rotule_Lever_M2_1                    3MF   Demo/AHSimulation/AHSimulation/AH_Right_5F_3S_Wrist/mjcf/assets/rotule_lever.stl (m) 
thumb_Rotule_Lever_M2_2                    3MF   Demo/AHSimulation/AHSimulation/AH_Right_5F_3S_Wrist/mjcf/assets/rotule_lever.stl (m) 
thumb_SCS0009_Servo_M1                     3MF   Demo/AHSimulation/AHSimulation/AH_Right_5F_3S_Wrist/mjcf/assets/scs0009.stl (m) 
thumb_SCS0009_Servo_M2                     3MF   Demo/AHSimulation/AHSimulation/AH_Right_5F_3S_Wrist/mjcf/assets/scs0009.stl (m) 
thumb_Screw_2.5x5_Thermo_1                 3MF   Demo/AHSimulation/AHSimulation/AH_Right_5F_3S_Wrist/mjcf/assets/thermo_screw_m2_5x5.stl (m) 
thumb_Screw_2.5x5_Thermo_2                 3MF   Demo/AHSimulation/AHSimulation/AH_Right_5F_3S_Wrist/mjcf/assets/thermo_screw_m2_5x5.stl (m) 
thumb_Screw_2.5x5_Thermo_3                 3MF   Demo/AHSimulation/AHSimulation/AH_Right_5F_3S_Wrist/mjcf/assets/thermo_screw_m2_5x5.stl (m) 
thumb_Screw_2.5x5_Thermo_4                 3MF   Demo/AHSimulation/AHSimulation/AH_Right_5F_3S_Wrist/mjcf/assets/thermo_screw_m2_5x5.stl (m) 
thumb_Screw_2.5x8_Torx                     3MF   Demo/AHSimulation/AHSimulation/AH_Right_5F_3S_Wrist/mjcf/assets/std00333_plast_tcb_torx_2_5x8__configuration_copy_of_default.stl (m) 
thumb_Screw_M2x10_Pan_1                    3MF   Demo/AHSimulation/AHSimulation/AH_Right_5F_3S_Wrist/mjcf/assets/ph_pan_head_screw_m2x0_40_x_10__2803432263e518bbd16bccbbef8784ed.stl (m) 
thumb_Screw_M2x10_Pan_2                    3MF   Demo/AHSimulation/AHSimulation/AH_Right_5F_3S_Wrist/mjcf/assets/ph_pan_head_screw_m2x0_40_x_10__2803432263e518bbd16bccbbef8784ed.stl (m) 
thumb_Screw_M2x10_Pan_M1                   3MF   Demo/AHSimulation/AHSimulation/AH_Right_5F_3S_Wrist/mjcf/assets/ph_pan_head_screw_m2x0_40_x_10__2803432263e518bbd16bccbbef8784ed.stl (m) 
thumb_Screw_M2x10_Pan_M2                   3MF   Demo/AHSimulation/AHSimulation/AH_Right_5F_3S_Wrist/mjcf/assets/ph_pan_head_screw_m2x0_40_x_10__2803432263e518bbd16bccbbef8784ed.stl (m) 
thumb_Servo_Horn_M1                        3MF   Demo/AHSimulation/AHSimulation/AH_Right_5F_3S_Wrist/mjcf/assets/custom_servo_horn.stl (m) 
thumb_Servo_Horn_M2                        3MF   Demo/AHSimulation/AHSimulation/AH_Right_5F_3S_Wrist/mjcf/assets/custom_servo_horn.stl (m) 
thumb_Spacer_M1                            STEP  cad/step/BallJoint_Rod - Spacer.step (ICP onto the sim STL)          0.0002 / 0.0002    0.0019
thumb_Spacer_M2                            STEP  cad/step/BallJoint_Rod - Spacer.step (ICP onto the sim STL)          0.0002 / 0.0002    0.0019
thumb_Washer_M2.5                          3MF   Demo/AHSimulation/AHSimulation/AH_Right_5F_3S_Wrist/mjcf/assets/plain_washer_large_grade_a_m2_5__9a369f0dc77bf9c598cdf3fb468977e5.stl (m) 
Elbow_Flange                               STEP  cad/five_finger/wrist/step/Elbow_Flange.step                         0.0148 / 0.0009    0.0099
R-Forearm_Back                             STEP  cad/five_finger/wrist/step/R-Forearm_Back.step                       0.0277 / 0.0017    0.0124
R-Forearm_Front                            STEP  cad/five_finger/wrist/step/R-Forearm_Front.step                      0.0188 / 0.0017    0.0128
R-Wrist_Fork                               STEP  cad/five_finger/wrist/step/R-Wrist_Fork.step                         0.0028 / 0.0016    0.0137
R-Wrist_Hand_Adapter                       STEP  cad/five_finger/wrist/step/R-Wrist_Hand_Adapter.step                 0.0104 / 0.0012    0.0099
R-Wrist_Servo_Frame                        STEP  cad/five_finger/wrist/step/R-Wrist_Servo_Frame.step                  0.0000 / 0.0000    0.0006
Wrist_Gimbal_Ring                          STEP  cad/five_finger/wrist/step/Wrist_Gimbal_Ring.step                    0.0038 / 0.0000    0.0034
Wrist_Horn_Arm_1                           STEP  cad/five_finger/wrist/step/Wrist_Horn_Arm.step                       0.0029 / 0.0000    0.0039
Wrist_Horn_Arm_2                           STEP  cad/five_finger/wrist/step/Wrist_Horn_Arm.step (ICP onto the sim STL)   0.0029 / 0.0000    0.0039
wrist_F683ZZ_+x                            STEP  cad/five_finger/wrist/make_wrist.py                                  0.0000 / 0.0000    0.0013
wrist_F683ZZ_+z                            STEP  cad/five_finger/wrist/make_wrist.py                                  0.0000 / 0.0000    0.0013
wrist_F683ZZ_-x                            STEP  cad/five_finger/wrist/make_wrist.py                                  0.0000 / 0.0000    0.0013
wrist_F683ZZ_-z                            STEP  cad/five_finger/wrist/make_wrist.py                                  0.0000 / 0.0000    0.0013
wrist_STS3215_motor1                       STEP  cad/five_finger/wrist/make_wrist.py                                  0.0000 / 0.0000    0.0037
wrist_STS3215_motor2                       STEP  cad/five_finger/wrist/make_wrist.py                                  0.0000 / 0.0000    0.0037
wrist_link_bot_1                           STEP  cad/five_finger/wrist/make_wrist.py                                  0.0039 / 0.0024    0.0015
wrist_link_bot_2                           STEP  cad/five_finger/wrist/make_wrist.py                                  0.0039 / 0.0024    0.0015
wrist_link_top_1                           STEP  cad/five_finger/wrist/make_wrist.py                                  0.0039 / 0.0024    0.0015
wrist_link_top_2                           STEP  cad/five_finger/wrist/make_wrist.py                                  0.0040 / 0.0024    0.0015
wrist_pin_d3x10_+x                         STEP  cad/five_finger/wrist/make_wrist.py                                  0.0001 / 0.0001    0.0008
wrist_pin_d3x10_+z                         STEP  cad/five_finger/wrist/make_wrist.py                                  0.0001 / 0.0001    0.0008
wrist_pin_d3x10_-x                         STEP  cad/five_finger/wrist/make_wrist.py                                  0.0001 / 0.0001    0.0008
wrist_pin_d3x10_-z                         STEP  cad/five_finger/wrist/make_wrist.py                                  0.0001 / 0.0001    0.0008
wrist_rod_1                                STEP  cad/five_finger/wrist/make_wrist.py                                  0.0001 / 0.0001    0.0008
wrist_rod_2                                STEP  cad/five_finger/wrist/make_wrist.py                                  0.0001 / 0.0001    0.0008
wrist_stud_arm_1                           STEP  cad/five_finger/wrist/make_wrist.py                                  0.0010 / 0.0007    0.0062
wrist_stud_arm_2                           STEP  cad/five_finger/wrist/make_wrist.py                                  0.0010 / 0.0007    0.0071
wrist_stud_top_1                           STEP  cad/five_finger/wrist/make_wrist.py                                  0.0010 / 0.0007    0.0071
wrist_stud_top_2                           STEP  cad/five_finger/wrist/make_wrist.py                                  0.0010 / 0.0007    0.0062

Mesh-only parts (157, in the 3MF only; no B-rep of them exists in the repo: the shells, covers and pads are implicit/voxel solids, UF_P3_Distal is trimmed by a mesh boolean, the hand's bought parts are the onshape-to-robot meshes):
  Bushing_0608 x10, Distal_Pad x1, Distal_Shell x1, P1_Pad x3, P1_Pad_S088 x1, P1_Shell x3, P1_Shell_S088 x1, P2_Pad x3, P2_Pad_S088 x1, P2_Shell x3, P2_Shell_S088 x1, P3_Distal x3, P3_Distal_S088 x1, P3_Pad x3, P3_Pad_S088 x1, P3_Shell x3, P3_Shell_S088 x1, Pin_2x10 x6, Pin_2x16 x2, Proximal_Pad x1, Proximal_Shell x1, R-Palm_Pad_Palm_5F x1, R-Palm_Shell_5F x1, R-Top_Shell_5F x1, Rod_M2_L18 x10, Rotule_Ball x20, Rotule_Lever x20, SCS0009_Servo x10, Screw_2.5x5_Thermo x4, Screw_2.5x8_Torx x5, Screw_M2x10_Pan x20, Servo_Horn x10, Washer_M2.5 x5
