molinzhao27/AmazingHand/cad/five_finger/ultimate_finger/report_cad_S088.txt

make_ultimate_finger.py report (all mm, finger design frame); phalanx length scale 0.88
2D layout: 15 parts, motion sampled at 434 Link angles -26.8..81.5 deg [11 s]
cores and pins: 11 solids [6 s]
  P1 cover: back 150000 / glove 150000 faces; skin (inner offset to outer surface) min 1.22, 1st percentile 1.24, median 1.31 mm; thinner than 1.0 mm (opening r 0.5): 14.4 mm3, up to 0.27 mm deep
  P2 cover: back 88880 / glove 150000 faces; skin (inner offset to outer surface) min 1.23, 1st percentile 1.24, median 1.31 mm; thinner than 1.0 mm (opening r 0.5): 12.3 mm3, up to 0.17 mm deep
  P3 cover: back 109052 / glove 150000 faces; skin (inner offset to outer surface) min 1.22, 1st percentile 1.25, median 1.32 mm; thinner than 1.0 mm (opening r 0.5): 7.0 mm3, up to 0.17 mm deep
implicit covers [85 s]
  P3 core tip trimmed to the cap cavity - 0.30 mm from y = 69.24 (mesh boolean): 2075 -> 1579 mm3, watertight True
exported 17 parts [117 s]

== parts (B-rep validity of the re-imported STEP, 'STL only' for the implicit covers; STL watertight; volume from the STL; bbox mm)
  link                   valid True  solids 1  watertight True  volume   1012.1 mm3  x [ -5.15,   5.15] y [ -3.00,  41.45] z [-14.05,  -1.94]
  P1                     valid True  solids 1  watertight True  volume   3983.9 mm3  x [ -8.70,   7.50] y [ -3.30,  44.36] z [ -8.45,   9.57]
  P2                     valid True  solids 1  watertight True  volume   1341.2 mm3  x [ -6.00,   6.00] y [ 35.06,  67.24] z [ -4.40,   6.45]
  P3                     valid True  solids 1  watertight True  volume   1578.7 mm3  x [ -4.75,   4.75] y [ 54.19,  84.75] z [ -5.52,   6.15]
  L2                     valid True  solids 1  watertight True  volume    256.9 mm3  x [ -1.50,   1.50] y [ 37.41,  59.29] z [ -8.45,   6.25]
  pin_PIP                valid True  solids 1  watertight True  volume     37.4 mm3  x [ -6.00,   6.00] y [ 40.36,  42.36] z [ -1.00,   1.00]
  pin_A                  valid True  solids 1  watertight True  volume     37.4 mm3  x [ -6.00,   6.00] y [ 39.01,  41.01] z [ -6.85,  -4.85]
  pin_DIP                valid True  solids 1  watertight True  volume     37.4 mm3  x [ -6.00,   6.00] y [ 63.24,  65.24] z [ -1.00,   1.00]
  pin_P4                 valid True  solids 1  watertight True  volume     24.9 mm3  x [ -4.00,   4.00] y [ 36.56,  38.56] z [  2.95,   4.95]
  pin_B                  valid True  solids 1  watertight True  volume     24.9 mm3  x [ -4.00,   4.00] y [ 55.69,  57.69] z [  2.65,   4.65]
  pin_MCP                valid True  solids 1  watertight True  volume     50.0 mm3  x [ -8.60,   7.40] y [ -1.00,   1.00] z [ -1.00,   1.00]
  P1_Shell               valid STL only  solids 1  watertight True  volume    727.9 mm3  x [ -8.44,   8.44] y [  8.44,  38.05] z [  5.97,  11.94]
  P1_Pad                 valid STL only  solids 1  watertight True  volume   1218.2 mm3  x [ -8.45,   8.45] y [  8.34,  38.07] z [ -7.44,   6.82]
  P2_Shell               valid STL only  solids 1  watertight True  volume    266.9 mm3  x [ -7.94,   7.94] y [ 44.19,  60.56] z [  2.37,   7.31]
  P2_Pad                 valid STL only  solids 1  watertight True  volume    478.7 mm3  x [ -7.95,   7.95] y [ 45.34,  61.38] z [ -7.96,   2.60]
  P3_Shell               valid STL only  solids 1  watertight True  volume    325.2 mm3  x [ -6.66,   6.66] y [ 66.28,  81.89] z [ -1.02,   6.80]
  P3_Pad                 valid STL only  solids 1  watertight True  volume    513.7 mm3  x [ -6.66,   6.66] y [ 67.50,  86.29] z [ -8.16,   2.94]

== pin-hole walls in the rigid parts (in-plane, from the carved profiles; rule >= 1.5 mm)
  P1        PIP  hole d1.95: 4 slab(s), thinnest wall 2.02 mm (|x| band 4.25..6.00)
  P1        A    hole d1.95: 2 slab(s), thinnest wall 1.62 mm (|x| band 4.25..6.00)
  P2        PIP  hole d2.15: 4 slab(s), thinnest wall 1.62 mm (|x| band 1.75..4.00)
  P2        P4   hole d1.95: 4 slab(s), thinnest wall 1.52 mm (|x| band 1.75..4.00)
  P2        DIP  hole d1.95: 6 slab(s), thinnest wall 2.02 mm (|x| band 4.25..5.85)
  P3        DIP  hole d2.15: 5 slab(s), thinnest wall 1.92 mm (|x| band 1.50..1.75)
  P3        B    hole d1.95: 2 slab(s), thinnest wall 1.52 mm (|x| band 1.75..4.00)
  L2        A    hole d2.15: 1 slab(s), thinnest wall 1.52 mm (|x| band 1.50..1.50)
  L2        B    hole d2.15: 1 slab(s), thinnest wall 1.52 mm (|x| band 1.50..1.50)
  link_arm  P4   hole d2.15: 1 slab(s), thinnest wall 1.52 mm (|x| band 1.50..1.50)

== thin features: slab material narrower than 1.2 mm in-plane (volume, share of the part)
  P1            7.3 of  3960.7 mm3 ( 0.2 %)
  P2            6.6 of  1848.2 mm3 ( 0.4 %)
  P3            0.7 of  2118.9 mm3 ( 0.0 %)
  L2            0.0 of   278.8 mm3 ( 0.0 %)
  link_arm      0.6 of   644.2 mm3 ( 0.1 %)

== widths across the finger (x) and depths (z), including covers and pins
  proximal widest  16.90 mm at y  15.0 (x -8.45..+8.45); cover (shell + glove)  16.90 mm at y  15.0; cover depth 19.37 mm
  middle   widest  15.90 mm at y  50.4 (x -7.95..+7.95); cover (shell + glove)  15.90 mm at y  50.4; cover depth 15.28 mm
  distal   widest  13.32 mm at y  69.2 (x -6.66..+6.66); cover (shell + glove)  13.32 mm at y  69.2; cover depth 14.97 mm
  knuckles (cores + pins): MCP end 16.2 (stock Proximal ears around the stock gimbal), PIP 12.0, DIP 12.0

== cover skin (implicit field): inner offset surface to the outer surface, where the cover exists (rule >= 1.2);
   cut rims: material thinner than 1.0 mm (what an opening with a 0.5 mm ball removes; < 0.3 mm deep = rounded rim corners, deeper = a feathered wedge)
  P1         min 1.22, 1st percentile 1.24, median 1.31 mm; thinner than 1.0 mm: 14.4 mm3, at most 0.27 mm deep
  P2         min 1.23, 1st percentile 1.24, median 1.31 mm; thinner than 1.0 mm: 12.3 mm3, at most 0.17 mm deep
  P3         min 1.22, 1st percentile 1.25, median 1.32 mm; thinner than 1.0 mm: 7.0 mm3, at most 0.17 mm deep

== covers on their own core (straight finger): overlap and min gap core surface -> cover surfaces
  P1_Shell  overlap with its core 0.000 mm3; min gap 0.255 mm
  P1_Pad    overlap with its core 0.000 mm3; min gap 0.235 mm
  P2_Shell  overlap with its core 0.000 mm3; min gap 0.256 mm
  P2_Pad    overlap with its core 0.000 mm3; min gap 0.242 mm
  P3_Shell  overlap with its core 0.000 mm3; min gap 0.185 mm
  P3_Pad    overlap with its core 0.000 mm3; min gap 0.231 mm

== joint sweeps (3-D, whole servo travel, 0.5 deg Link steps): covers vs everything moving past them
  P1 cover (shell + glove) min clearance to swept: gimbal 0.77, link 0.62 (glove), P2 0.77 (glove), P3 >3, L2 0.81 (glove)
  P2 cover (shell + glove) min clearance to swept: gimbal >3, link >3, P1 0.77 (glove), P3 0.77 (glove), L2 0.73 (glove)
  P3 cover (shell + glove) min clearance to swept: gimbal >3, link >3, P1 >3, P2 0.77 (glove), L2 >3

done [296 s]
