molinzhao27/AmazingHand/cad/five_finger/fingers/report_sim.txt

styled model: /private/tmp/claude-501/-Users-molin-Documents-AmazingHand--claude-worktrees-priceless-hypatia-125ced/f9a6c4f0-93d0-4f45-a5e2-f4ccd045e29b/scratchpad/fingers/simwork/AH_Right_5F_styled/mjcf (mujoco 3.15.0)
  geoms: stock 208, styled 218 (+10 pads; 20 shell/pad geoms); body masses identical: True
== 1. palm side (CAD frame: x = pin axis, y = along the finger)
  OpenHand: index distal tip at [ 0.8 90.  -1.6] mm in the proximal shell frame, distal rotated -2.4 deg about the pin axis x
  CloseHand: index distal tip at [  0.8  65.8 -35.4] mm in the proximal shell frame, distal rotated -68.8 deg about the pin axis x
  -> flexing moves the distal tip -33.8 mm along z of the shell frame: the palm (flexion) side is -z (where the pads are)
== 2. self-clearance of the added surface over the 9x9 grid (all digits at the same command; samples every 0.3 mm, contact: < 0.225 mm) [settled in 1 s]
  index  proximal land/nail ( 7128 samples): min clearance  3.37 mm at (+90,-90) [distal_shell]; touching at 0/81 poses
  index  proximal pad       (26229 samples): min clearance  5.05 mm at (+90,-90) [distal_shell]; touching at 0/81 poses
  index  distal   land/nail (10634 samples): min clearance  6.25 mm at (+90,-90) [proximal_shell]; touching at 0/81 poses
  index  distal   pad       (35400 samples): min clearance  7.93 mm at (+90,-90) [proximal_shell]; touching at 0/81 poses
  middle proximal land/nail ( 7128 samples): min clearance  3.37 mm at (+90,-90) [distal_shell]; touching at 0/81 poses
  middle proximal pad       (26229 samples): min clearance  5.05 mm at (+90,-90) [distal_shell]; touching at 0/81 poses
  middle distal   land/nail (10634 samples): min clearance  6.25 mm at (+90,-90) [proximal_shell]; touching at 0/81 poses
  middle distal   pad       (35400 samples): min clearance  7.93 mm at (+90,-90) [proximal_shell]; touching at 0/81 poses
  ring   proximal land/nail ( 7128 samples): min clearance  3.37 mm at (+90,-90) [distal_shell]; touching at 0/81 poses
  ring   proximal pad       (26229 samples): min clearance  5.05 mm at (+90,-90) [distal_shell]; touching at 0/81 poses
  ring   distal   land/nail (10634 samples): min clearance  6.25 mm at (+90,-90) [proximal_shell]; touching at 0/81 poses
  ring   distal   pad       (35400 samples): min clearance  7.93 mm at (+90,-90) [proximal_shell]; touching at 0/81 poses
  thumb  proximal land/nail ( 7128 samples): min clearance  3.37 mm at (+90,-90) [distal_shell]; touching at 0/81 poses
  thumb  proximal pad       (26229 samples): min clearance  5.05 mm at (+90,-90) [distal_shell]; touching at 0/81 poses
  thumb  distal   land/nail (10634 samples): min clearance  6.25 mm at (+90,-90) [proximal_shell]; touching at 0/81 poses
  thumb  distal   pad       (35400 samples): min clearance  7.93 mm at (+90,-90) [proximal_shell]; touching at 0/81 poses
  pinky  proximal land/nail ( 7128 samples): min clearance  3.37 mm at (+90,-90) [distal_shell]; touching at 0/81 poses
  pinky  proximal pad       (26229 samples): min clearance  5.05 mm at (+90,-90) [distal_shell]; touching at 0/81 poses
  pinky  distal   land/nail (10634 samples): min clearance  6.25 mm at (+90,-90) [proximal_shell]; touching at 0/81 poses
  pinky  distal   pad       (35400 samples): min clearance  7.93 mm at (+90,-90) [proximal_shell]; touching at 0/81 poses
  -> added surface (lands, nail plates, pads) vs the rest of its digit and the palm: min clearance 3.37 mm (index proximal land/nail), touching poses 0 [129 s]
== 3. ring vs pinky, every pair of grid poses (81x81), stock vs styled shells:
  [stock] ring (A) vs pinky (B): min clearance 0.00 mm at A(-45,-45) B(+22,+68) [parallel_pin_2_x_10__fee063fca0c8b40e46bbc4ffff61d999 (parallel_pin_2_x_10__fee063fca0c8b40e46bbc4ffff61d999_3) / proximal (parallel_pin_2_x_16__da4b7ddbe9d803fe3fbc70f2e822b99b_5)]; pose pairs touching or overlapping (< 0.23 mm): 887/6561
    touching parts: proximal_shell/proximal_shell x228, proximal/proximal_shell x172, distal_shell/distal_shell x69, distal/distal_shell x60, ph_pan_head_screw_m2x0_40_x_10__2803432263e518bbd16bccbbef8784ed/proximal_shell x58, proximal_shell/std00447_thermoplastique_m2_5x6__configuration_default x57, proximal/proximal x46, distal_shell/proximal_shell x28, link/proximal_shell x24, link/proximal x21, proximal/std00447_thermoplastique_m2_5x6__configuration_default x17, distal_shell/std00447_thermoplastique_m2_5x6__configuration_default x17, distal/proximal x13, distal/proximal_shell x12, distal/distal x9, proximal_shell/rotule_lever x6, distal_shell/link x6, parallel_pin_2_x_16__da4b7ddbe9d803fe3fbc70f2e822b99b/proximal x5, distal_shell/proximal x5, parallel_pin_2_x_10__fee063fca0c8b40e46bbc4ffff61d999/proximal x5, distal/std00447_thermoplastique_m2_5x6__configuration_default x5, link/std00447_thermoplastique_m2_5x6__configuration_default x4, distal/link x4, distal/parallel_pin_2_x_10__fee063fca0c8b40e46bbc4ffff61d999 x3, link/parallel_pin_2_x_16__da4b7ddbe9d803fe3fbc70f2e822b99b x2, distal_shell/parallel_pin_2_x_10__fee063fca0c8b40e46bbc4ffff61d999 x2, parallel_pin_2_x_10__fee063fca0c8b40e46bbc4ffff61d999/parallel_pin_2_x_10__fee063fca0c8b40e46bbc4ffff61d999 x1, parallel_pin_2_x_10__fee063fca0c8b40e46bbc4ffff61d999/proximal_shell x1, proximal_shell/rotule_ball x1, std00447_thermoplastique_m2_5x6__configuration_default/std00447_thermoplastique_m2_5x6__configuration_default x1, parallel_pin_2_x_10__fee063fca0c8b40e46bbc4ffff61d999/parallel_pin_2_x_16__da4b7ddbe9d803fe3fbc70f2e822b99b x1, link/link x1, distal/parallel_pin_2_x_16__da4b7ddbe9d803fe3fbc70f2e822b99b x1, parallel_pin_2_x_16__da4b7ddbe9d803fe3fbc70f2e822b99b/proximal_shell x1, distal_shell/parallel_pin_2_x_16__da4b7ddbe9d803fe3fbc70f2e822b99b x1
    [221 s]
  [styled] ring (A) vs pinky (B): min clearance 0.00 mm at A(-90,-45) B(+90,+45) [proximal_pad (parallel_pin_2_x_16__da4b7ddbe9d803fe3fbc70f2e822b99b_3) / std00447_thermoplastique_m2_5x6__configuration_default (parallel_pin_2_x_16__da4b7ddbe9d803fe3fbc70f2e822b99b_5)]; pose pairs touching or overlapping (< 0.23 mm): 887/6561
    touching parts: proximal_shell/proximal_shell x177, proximal/proximal_shell x136, ph_pan_head_screw_m2x0_40_x_10__2803432263e518bbd16bccbbef8784ed/proximal_shell x62, distal_shell/distal_shell x57, proximal_shell/std00447_thermoplastique_m2_5x6__configuration_default x53, proximal/proximal x42, distal/distal_shell x41, proximal_pad/proximal_shell x40, distal_pad/distal_shell x32, proximal/proximal_pad x28, distal_shell/proximal_shell x21, proximal/std00447_thermoplastique_m2_5x6__configuration_default x21, distal_shell/std00447_thermoplastique_m2_5x6__configuration_default x21, distal/distal_pad x17, link/proximal x17, link/proximal_shell x13, distal/distal x12, distal/proximal x9, distal_shell/proximal x8, distal/proximal_shell x8, distal_pad/std00447_thermoplastique_m2_5x6__configuration_default x8, link/proximal_pad x7, distal/std00447_thermoplastique_m2_5x6__configuration_default x5, parallel_pin_2_x_16__da4b7ddbe9d803fe3fbc70f2e822b99b/proximal_shell x5, parallel_pin_2_x_10__fee063fca0c8b40e46bbc4ffff61d999/proximal x4, distal_pad/distal_pad x4, distal_shell/link x4, distal/link x3, parallel_pin_2_x_16__da4b7ddbe9d803fe3fbc70f2e822b99b/proximal x3, proximal_shell/rotule_lever x3, distal_shell/parallel_pin_2_x_10__fee063fca0c8b40e46bbc4ffff61d999 x3, link/std00447_thermoplastique_m2_5x6__configuration_default x3, parallel_pin_2_x_10__fee063fca0c8b40e46bbc4ffff61d999/proximal_shell x3, proximal_pad/std00447_thermoplastique_m2_5x6__configuration_default x2, distal_shell/parallel_pin_2_x_16__da4b7ddbe9d803fe3fbc70f2e822b99b x2, distal/parallel_pin_2_x_10__fee063fca0c8b40e46bbc4ffff61d999 x2, parallel_pin_2_x_10__fee063fca0c8b40e46bbc4ffff61d999/parallel_pin_2_x_16__da4b7ddbe9d803fe3fbc70f2e822b99b x2, proximal_pad/proximal_pad x1, parallel_pin_2_x_10__fee063fca0c8b40e46bbc4ffff61d999/parallel_pin_2_x_10__fee063fca0c8b40e46bbc4ffff61d999 x1, link/parallel_pin_2_x_10__fee063fca0c8b40e46bbc4ffff61d999 x1, distal/proximal_pad x1, std00447_thermoplastique_m2_5x6__configuration_default/std00447_thermoplastique_m2_5x6__configuration_default x1, link/link x1, distal/parallel_pin_2_x_16__da4b7ddbe9d803fe3fbc70f2e822b99b x1, parallel_pin_2_x_10__fee063fca0c8b40e46bbc4ffff61d999/proximal_pad x1, distal_pad/proximal_shell x1
    [173 s]
/Users/molin/Documents/AmazingHand/.claude/worktrees/priceless-hypatia-125ced/Demo/AHSimulation/five_finger/check_finger_shells.py:386: RuntimeWarning: invalid value encountered in subtract
  f"touch in stock: {np.min(np.where(np.isfinite(t_s) & (t_s >= touch), t_y - t_s, np.inf)) * 1e3:+.3f} mm")
  ring/pinky: touching pose pairs stock 887, styled 887; same touching set: True; touching only with the styled shells: 0; min clearance change over the pairs that do not touch in stock: -0.030 mm
== 3. index vs middle, every pair of grid poses (81x81), stock vs styled shells:
  [stock] index (A) vs middle (B): min clearance 0.00 mm at A(-90,-68) B(-22,-22) [distal (parallel_pin_2_x_10__fee063fca0c8b40e46bbc4ffff61d999) / distal_shell (parallel_pin_2_x_10__fee063fca0c8b40e46bbc4ffff61d999_2)]; pose pairs touching or overlapping (< 0.23 mm): 973/6561
    touching parts: proximal_shell/proximal_shell x244, proximal/proximal_shell x184, distal_shell/distal_shell x75, ph_pan_head_screw_m2x0_40_x_10__2803432263e518bbd16bccbbef8784ed/proximal_shell x65, proximal_shell/std00447_thermoplastique_m2_5x6__configuration_default x61, proximal/proximal x58, distal/distal_shell x50, proximal/std00447_thermoplastique_m2_5x6__configuration_default x37, link/proximal x29, link/proximal_shell x25, distal_shell/std00447_thermoplastique_m2_5x6__configuration_default x21, distal/proximal_shell x21, distal_shell/proximal_shell x20, distal/proximal x16, distal/distal x11, distal_shell/proximal x10, link/std00447_thermoplastique_m2_5x6__configuration_default x6, parallel_pin_2_x_16__da4b7ddbe9d803fe3fbc70f2e822b99b/proximal_shell x6, parallel_pin_2_x_16__da4b7ddbe9d803fe3fbc70f2e822b99b/proximal x5, distal/std00447_thermoplastique_m2_5x6__configuration_default x4, distal/parallel_pin_2_x_16__da4b7ddbe9d803fe3fbc70f2e822b99b x3, proximal_shell/rotule_lever x3, distal_shell/parallel_pin_2_x_10__fee063fca0c8b40e46bbc4ffff61d999 x3, distal_shell/link x3, distal/parallel_pin_2_x_10__fee063fca0c8b40e46bbc4ffff61d999 x2, distal_shell/parallel_pin_2_x_16__da4b7ddbe9d803fe3fbc70f2e822b99b x2, parallel_pin_2_x_10__fee063fca0c8b40e46bbc4ffff61d999/proximal_shell x2, link/parallel_pin_2_x_16__da4b7ddbe9d803fe3fbc70f2e822b99b x2, distal/link x1, parallel_pin_2_x_16__da4b7ddbe9d803fe3fbc70f2e822b99b/parallel_pin_2_x_16__da4b7ddbe9d803fe3fbc70f2e822b99b x1, link/link x1, proximal_shell/rotule_ball x1, std00447_thermoplastique_m2_5x6__configuration_default/std00447_thermoplastique_m2_5x6__configuration_default x1
    [190 s]
  [styled] index (A) vs middle (B): min clearance 0.00 mm at A( +0,-68) B(+45,+45) [distal_shell (parallel_pin_2_x_10__fee063fca0c8b40e46bbc4ffff61d999) / std00447_thermoplastique_m2_5x6__configuration_default (parallel_pin_2_x_10__fee063fca0c8b40e46bbc4ffff61d999_2)]; pose pairs touching or overlapping (< 0.23 mm): 971/6561
    touching parts: proximal_shell/proximal_shell x222, proximal/proximal_shell x135, distal_shell/distal_shell x70, ph_pan_head_screw_m2x0_40_x_10__2803432263e518bbd16bccbbef8784ed/proximal_shell x64, proximal_shell/std00447_thermoplastique_m2_5x6__configuration_default x54, proximal/proximal x48, proximal_pad/proximal_shell x40, distal/distal_shell x39, distal_pad/distal_shell x37, proximal/proximal_pad x34, proximal/std00447_thermoplastique_m2_5x6__configuration_default x28, link/proximal x26, distal_shell/std00447_thermoplastique_m2_5x6__configuration_default x23, distal_shell/proximal_shell x17, distal/distal_pad x15, link/proximal_shell x14, distal/proximal_shell x12, distal_shell/proximal x12, distal/proximal x11, distal/distal x9, distal/std00447_thermoplastique_m2_5x6__configuration_default x7, parallel_pin_2_x_16__da4b7ddbe9d803fe3fbc70f2e822b99b/proximal_shell x6, proximal_pad/std00447_thermoplastique_m2_5x6__configuration_default x5, link/std00447_thermoplastique_m2_5x6__configuration_default x4, parallel_pin_2_x_16__da4b7ddbe9d803fe3fbc70f2e822b99b/proximal x4, proximal_pad/proximal_pad x3, link/proximal_pad x3, distal_pad/std00447_thermoplastique_m2_5x6__configuration_default x3, distal/proximal_pad x3, proximal_shell/rotule_lever x3, distal_pad/distal_pad x3, distal_shell/link x3, distal/link x2, parallel_pin_2_x_10__fee063fca0c8b40e46bbc4ffff61d999/proximal_shell x2, distal_shell/parallel_pin_2_x_10__fee063fca0c8b40e46bbc4ffff61d999 x2, parallel_pin_2_x_16__da4b7ddbe9d803fe3fbc70f2e822b99b/parallel_pin_2_x_16__da4b7ddbe9d803fe3fbc70f2e822b99b x1, proximal_shell/rotule_ball x1, distal/parallel_pin_2_x_10__fee063fca0c8b40e46bbc4ffff61d999 x1, std00447_thermoplastique_m2_5x6__configuration_default/std00447_thermoplastique_m2_5x6__configuration_default x1, distal_pad/proximal x1, distal_shell/parallel_pin_2_x_16__da4b7ddbe9d803fe3fbc70f2e822b99b x1, link/parallel_pin_2_x_16__da4b7ddbe9d803fe3fbc70f2e822b99b x1, distal_pad/proximal_shell x1
    [157 s]
  index/middle: touching pose pairs stock 973, styled 971; same touching set: False; touching only with the styled shells: 0; min clearance change over the pairs that do not touch in stock: -0.036 mm
== 3. thumb vs index, every pair of grid poses (81x81), stock vs styled shells:
  [stock] thumb (A) vs index (B): min clearance 0.00 mm at A(+90,+22) B(+90,-68) [distal_shell (parallel_pin_2_x_10__fee063fca0c8b40e46bbc4ffff61d999_4) / std00447_thermoplastique_m2_5x6__configuration_default (parallel_pin_2_x_10__fee063fca0c8b40e46bbc4ffff61d999)]; pose pairs touching or overlapping (< 0.23 mm): 262/6561
    touching parts: distal_shell/distal_shell x113, distal_shell/proximal_shell x67, distal/distal_shell x46, distal/distal x10, distal_shell/std00447_thermoplastique_m2_5x6__configuration_default x9, distal/proximal_shell x8, distal_shell/proximal x5, distal/std00447_thermoplastique_m2_5x6__configuration_default x4
    [21 s]
  [styled] thumb (A) vs index (B): min clearance 0.00 mm at A(+22,-22) B(+90,-90) [distal_shell (parallel_pin_2_x_10__fee063fca0c8b40e46bbc4ffff61d999_4) / std00447_thermoplastique_m2_5x6__configuration_default (parallel_pin_2_x_10__fee063fca0c8b40e46bbc4ffff61d999)]; pose pairs touching or overlapping (< 0.23 mm): 273/6561
    touching parts: distal_pad/distal_shell x63, distal_shell/proximal_pad x58, distal_shell/distal_shell x49, distal/distal_pad x28, distal/distal_shell x19, distal_shell/proximal_shell x12, distal_shell/std00447_thermoplastique_m2_5x6__configuration_default x8, distal/proximal_pad x8, distal_pad/distal_pad x8, distal_shell/proximal x6, distal/distal x6, distal/proximal_shell x4, distal_pad/std00447_thermoplastique_m2_5x6__configuration_default x3, distal/std00447_thermoplastique_m2_5x6__configuration_default x1
    [33 s]
  thumb/index: touching pose pairs stock 262, styled 273; same touching set: False; touching only with the styled shells: 11; min clearance change over the pairs that do not touch in stock: -1.102 mm
== 4. thumb vs index in the demo poses (thumb tucks under the index on purpose in some)
  CloseHand  stock: min distance 0.01 mm [distal_shell / proximal], overlap 239.90 mm3 (distal/proximal_shell 98.89; distal_shell/proximal_shell 85.72; distal_shell/proximal 35.64; distal_shell/distal_shell 19.65) | styled: min distance 0.00 mm [distal / proximal_shell], overlap 348.67 mm3 (distal/proximal_shell 107.62; distal_shell/proximal_shell 90.71; distal/proximal_pad 40.05; distal_shell/proximal 39.04)
  Perfect    stock: min distance 0.01 mm [distal_shell / distal_shell], overlap 432.59 mm3 (distal/distal 157.41; distal_shell/distal 127.65; distal/distal_shell 92.55; distal_shell/distal_shell 54.97) | styled: min distance 0.01 mm [distal_shell / distal], overlap 470.73 mm3 (distal/distal 157.41; distal_shell/distal 128.57; distal/distal_shell 102.33; distal_shell/distal_shell 63.64)
  Pinched    stock: min distance 0.01 mm [distal_shell / distal_shell], overlap 118.58 mm3 (distal_shell/distal_shell 108.65; distal_shell/std00447_thermoplastique_m2_5x6__configuration_default 9.92; std00447_thermoplastique_m2_5x6__configuration_default/distal_shell 0.01) | styled: min distance 0.01 mm [distal_shell / distal_shell], overlap 125.17 mm3 (distal_shell/distal_shell 115.20; distal_shell/std00447_thermoplastique_m2_5x6__configuration_default 9.97; std00447_thermoplastique_m2_5x6__configuration_default/distal_shell 0.01)
  Fuck       stock: min distance 0.01 mm [distal_shell / distal_shell], overlap 118.58 mm3 (distal_shell/distal_shell 108.65; distal_shell/std00447_thermoplastique_m2_5x6__configuration_default 9.92; std00447_thermoplastique_m2_5x6__configuration_default/distal_shell 0.01) | styled: min distance 0.01 mm [distal_shell / distal_shell], overlap 125.17 mm3 (distal_shell/distal_shell 115.20; distal_shell/std00447_thermoplastique_m2_5x6__configuration_default 9.97; std00447_thermoplastique_m2_5x6__configuration_default/distal_shell 0.01)
  OpenHand   stock: > 5 mm apart, overlap 0.00 mm3 | styled: > 5 mm apart, overlap 0.00 mm3
== 5. renders: cad/five_finger/fingers/hand_styled_OpenHand.png, cad/five_finger/fingers/hand_styled_CloseHand.png
