molinzhao27/AmazingHand/cad/five_finger/slim_fingers/width_table.md

| section | stock shell width | slim shell width | reduction | core width |
|---|---|---|---|---|
| proximal phalanx, through the shell screw (y = 30) | 23.56 | 19.41 | -4.15 mm (-17.6 %) | 16.20 |
| distal phalanx (y = 66) | 21.35 | 14.84 | -6.51 mm (-30.5 %) | 10.00 |
| distal phalanx, through the shell screw (y = 74.4) | 20.90 | 14.49 | -6.41 mm (-30.7 %) | 10.00 |
