molinzhao27/AmazingHand/cad/five_finger/fingers/hand_styled_CloseHand.png

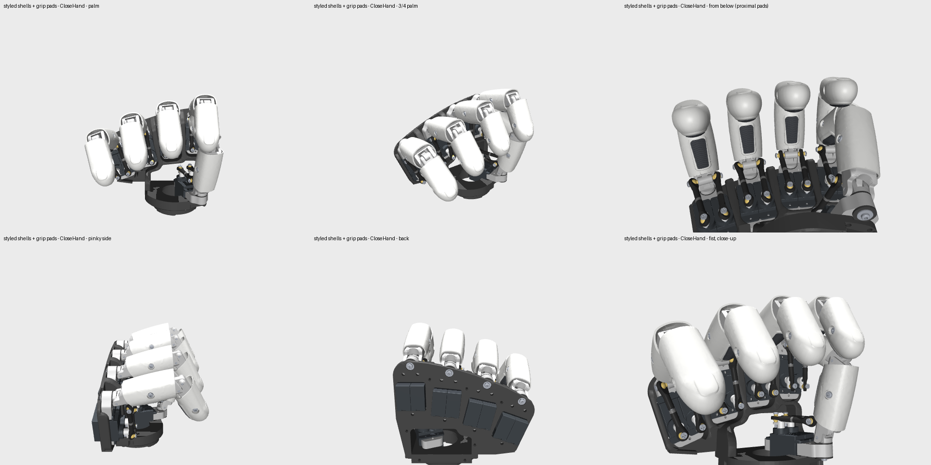
cad/five_finger/fingers/hand_styled_CloseHand.png
