molinzhao27/AmazingHand/cad/five_finger/fingers/hand_styled_OpenHand.png

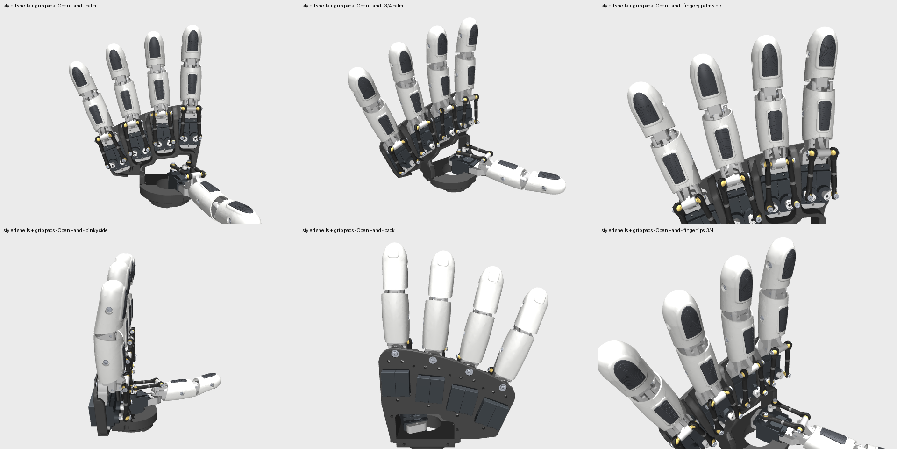
cad/five_finger/fingers/hand_styled_OpenHand.png
