molinzhao27/AmazingHand/cad/five_finger/fingers/pads.png

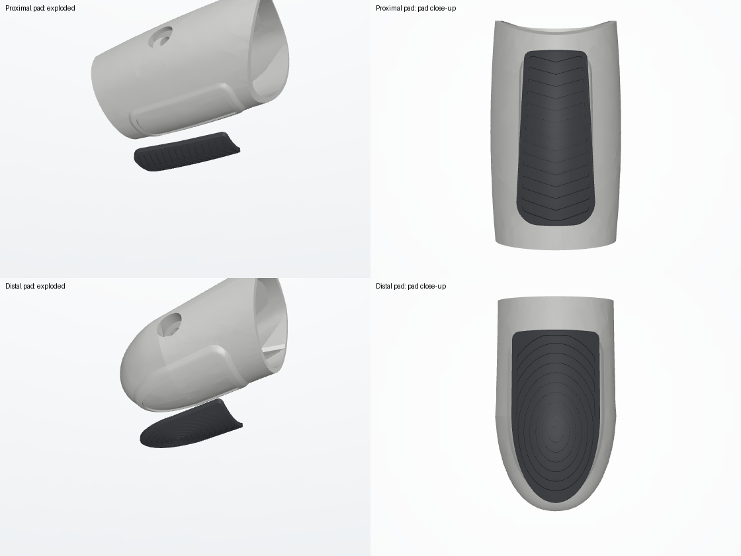
cad/five_finger/fingers/pads.png
