molinzhao27/AmazingHand/cad/five_finger/fingers/styled_vs_stock.png

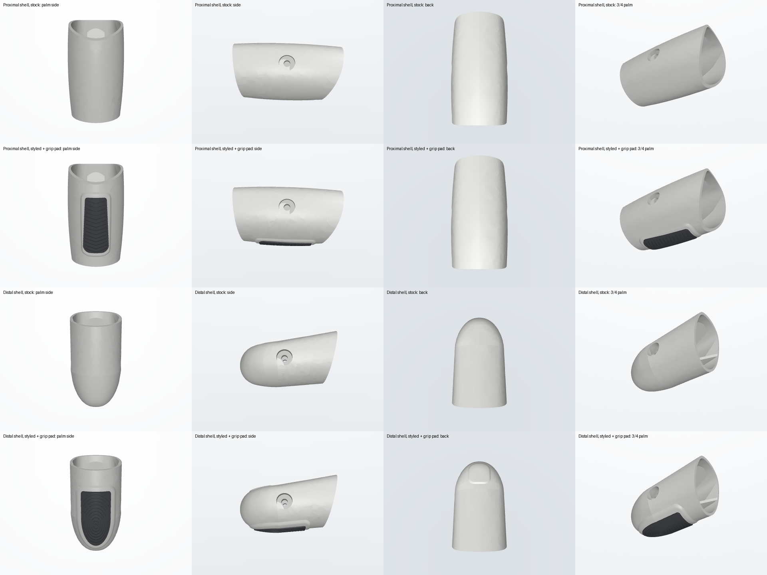
cad/five_finger/fingers/styled_vs_stock.png
