molinzhao27/AmazingHand/cad/five_finger/slim_fingers/preview_side.png

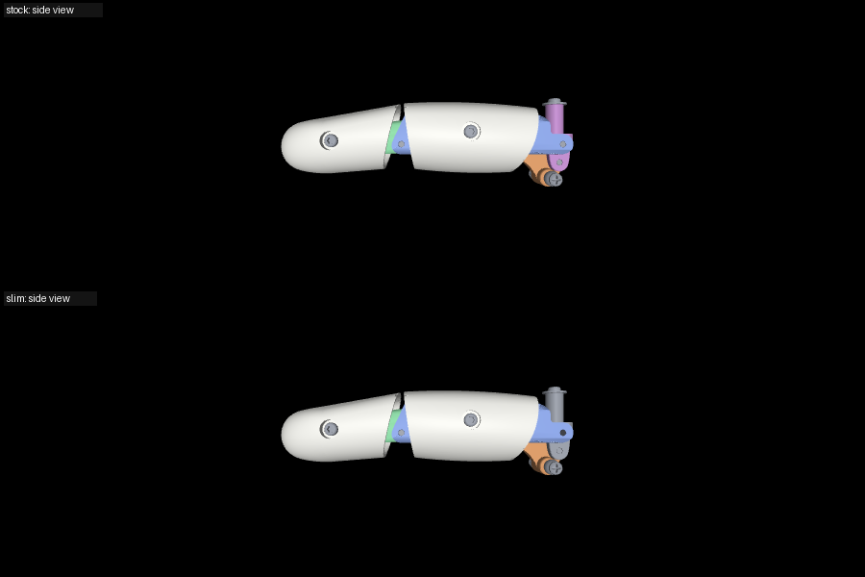
cad/five_finger/slim_fingers/preview_side.png
