molinzhao27/AmazingHand/cad/five_finger/three_segment/figures/cad_side_poses.png

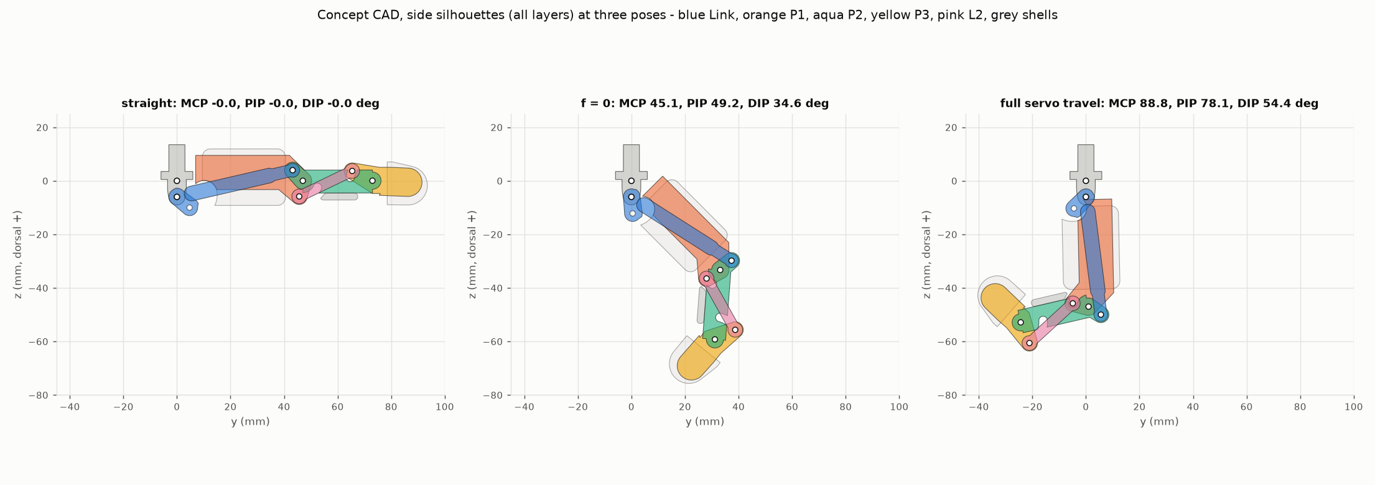
cad/five_finger/three_segment/figures/cad_side_poses.png
