molinzhao27/AmazingHand/cad/five_finger/ultimate_finger/figures/layers.png

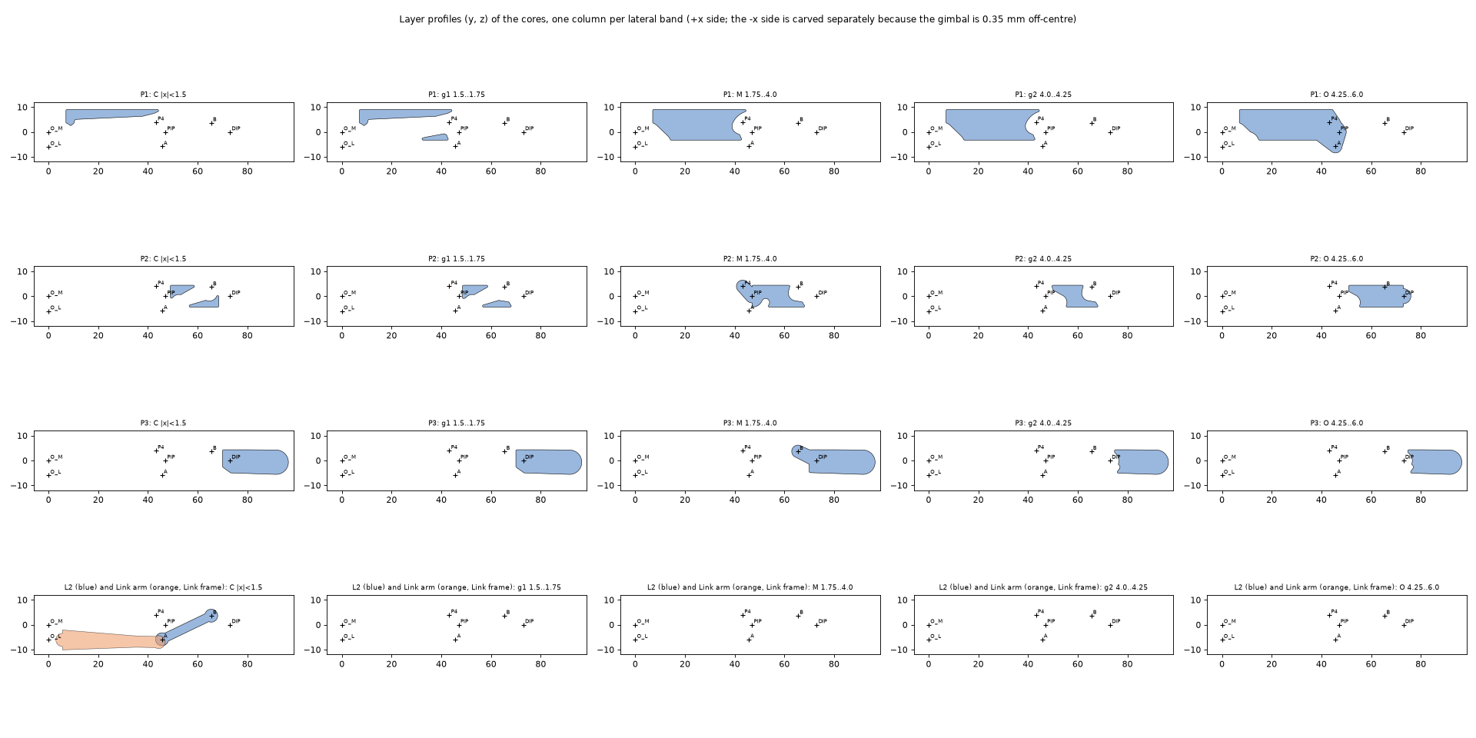
cad/five_finger/ultimate_finger/figures/layers.png
