molinzhao27/AmazingHand/cad/five_finger/ultimate_finger/figures/layers_S088.png

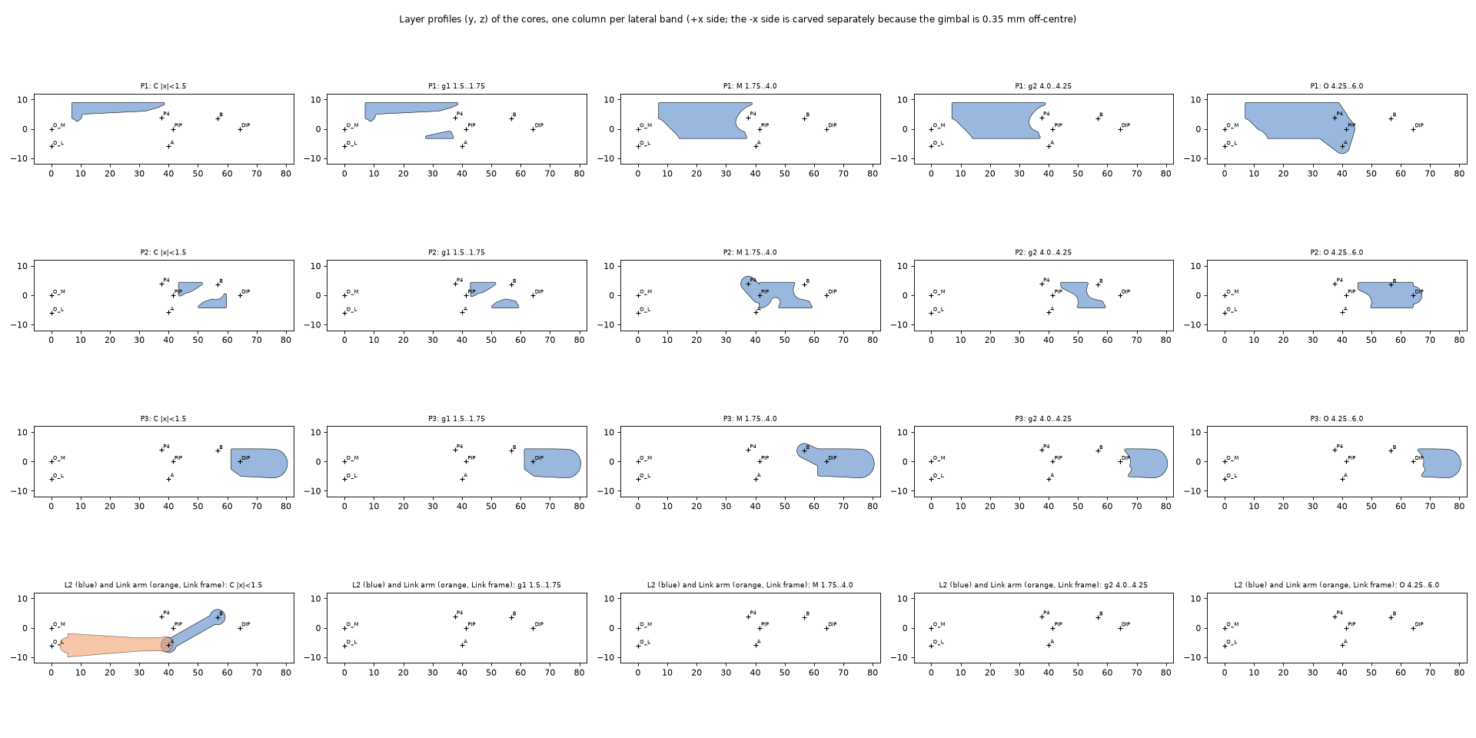
cad/five_finger/ultimate_finger/figures/layers_S088.png
