molinzhao27/AmazingHand/cad/five_finger/ultimate_finger/figures/strength.png

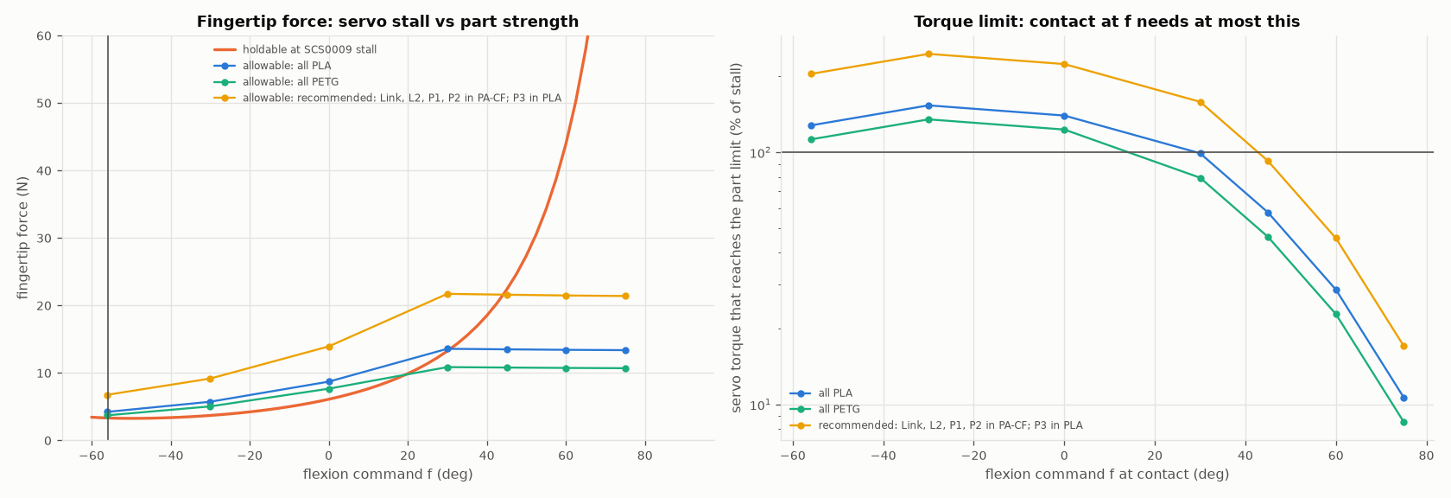
cad/five_finger/ultimate_finger/figures/strength.png
