molinzhao27/AmazingHand/cad/five_finger/ultimate_finger/figures/width_profile_S088.png

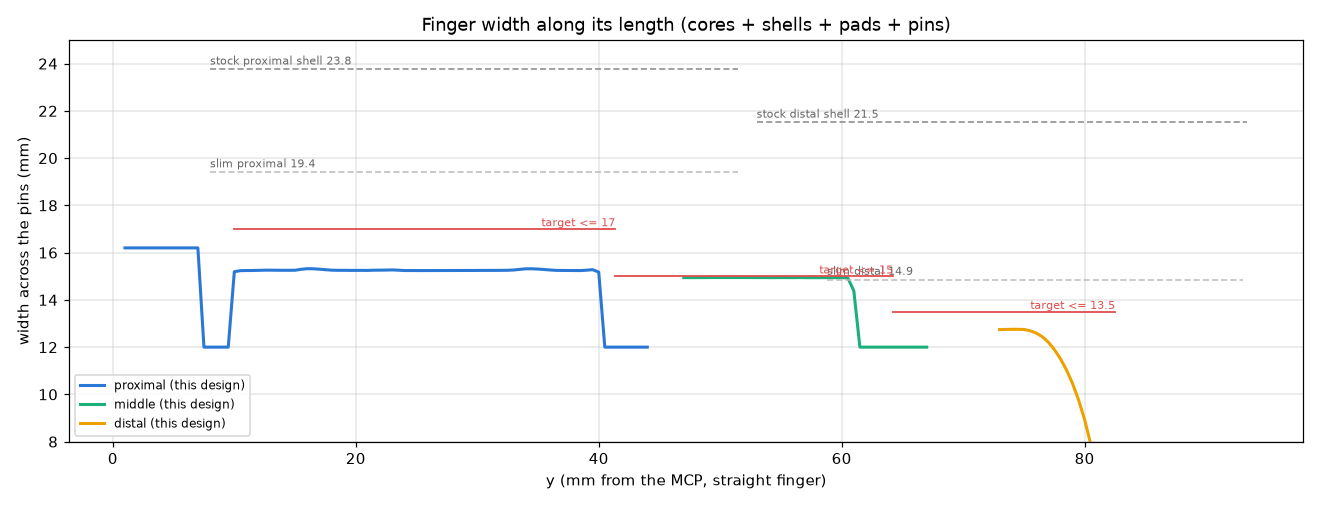
cad/five_finger/ultimate_finger/figures/width_profile_S088.png
