molinzhao27/AmazingHand/cad/five_finger/wrist/previews/exploded.jpg

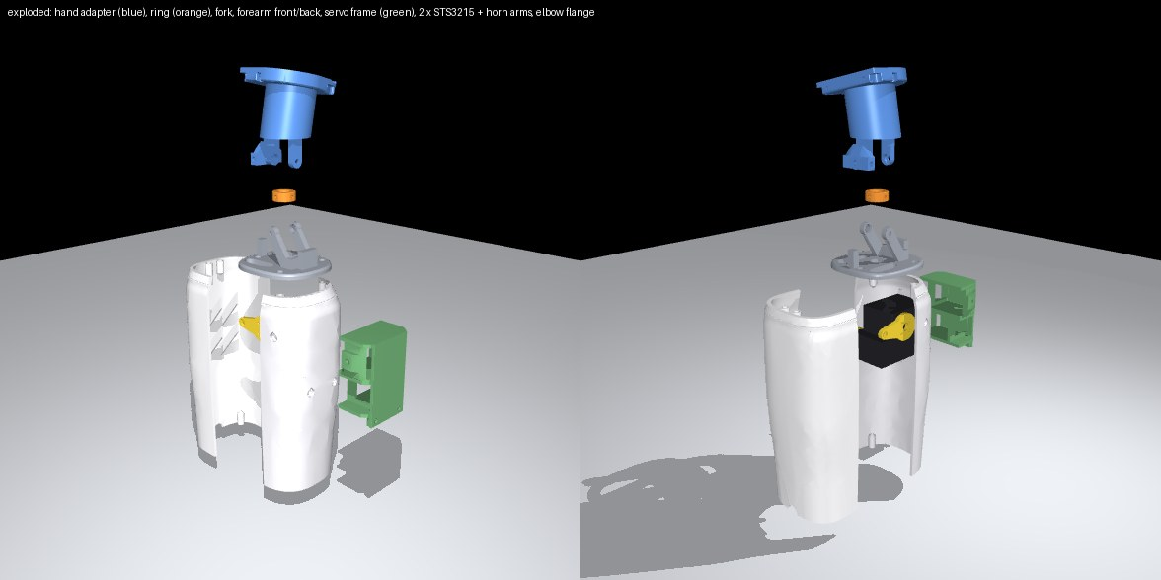
cad/five_finger/wrist/previews/exploded.jpg
