molinzhao27/AmazingHand/Demo/AHSimulation/five_finger/renders/5f_01_OpenHand.jpg

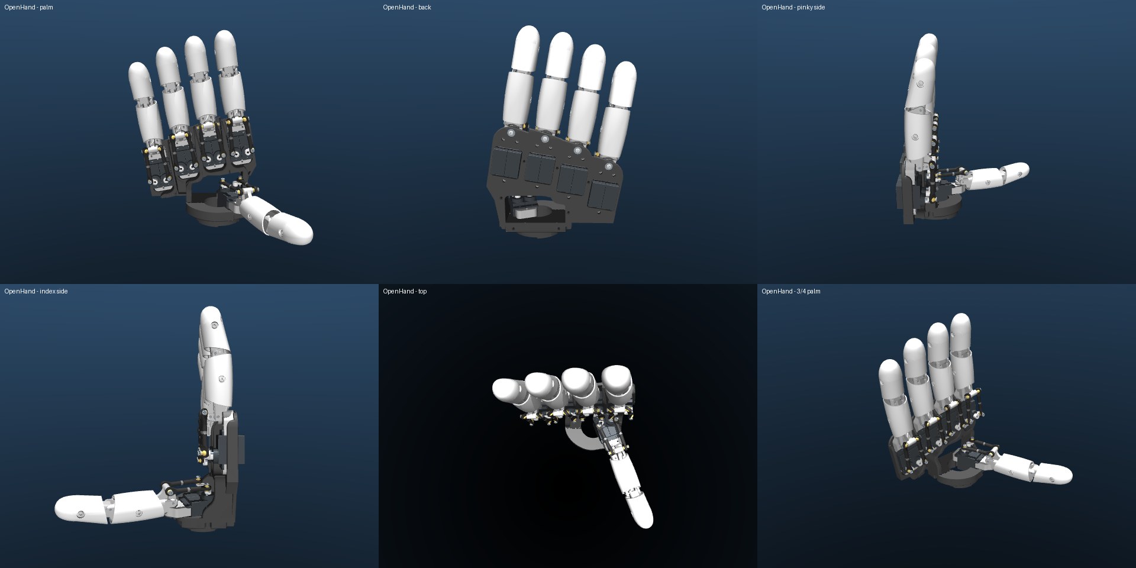
Demo/AHSimulation/five_finger/renders/5f_01_OpenHand.jpg
