molinzhao27/AmazingHand/Demo/AHSimulation/five_finger/renders/5f_02_CloseHand.jpg

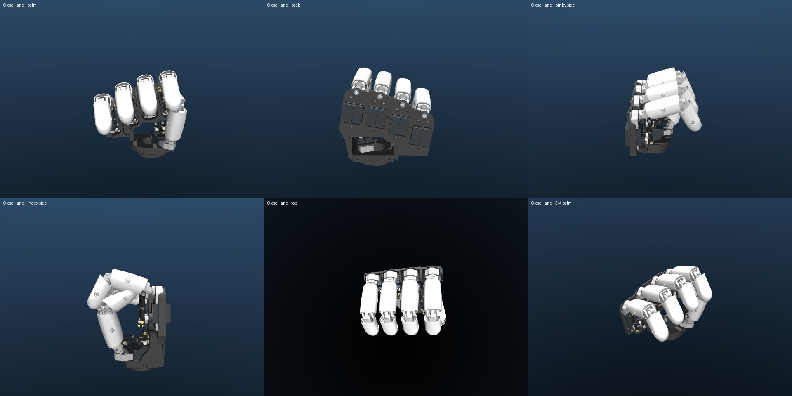
Demo/AHSimulation/five_finger/renders/5f_02_CloseHand.jpg
