molinzhao27/AmazingHand/Demo/AHSimulation/five_finger/renders/5f_05_Perfect.jpg

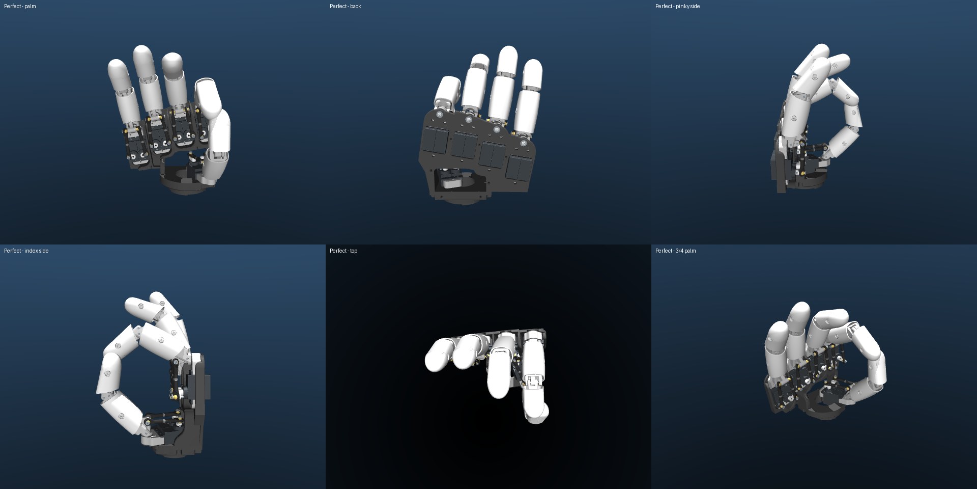
Demo/AHSimulation/five_finger/renders/5f_05_Perfect.jpg
