molinzhao27/AmazingHand/Demo/AHSimulation/five_finger/renders/beauty/no_covers/arm.jpg

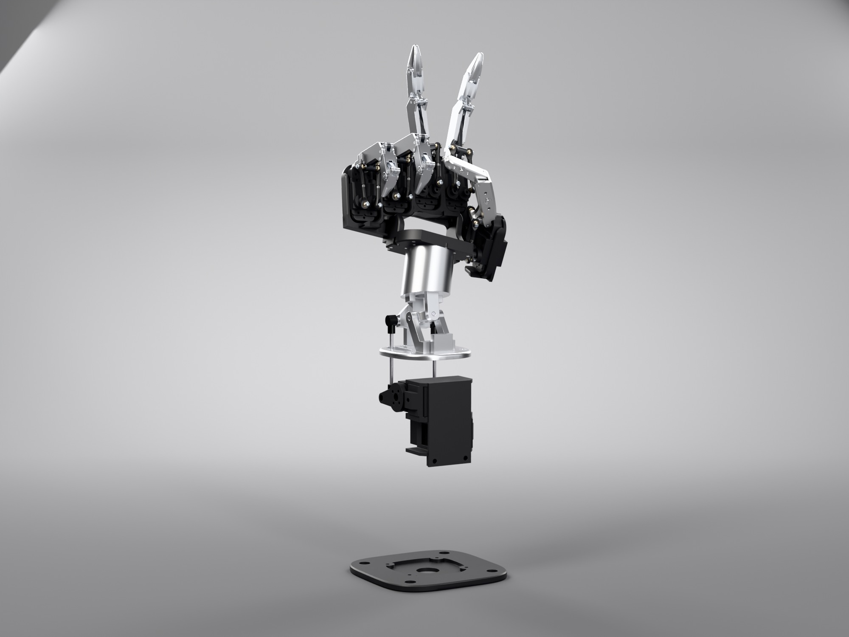
Demo/AHSimulation/five_finger/renders/beauty/no_covers/arm.jpg
