molinzhao27/AmazingHand/Demo/AHSimulation/five_finger/renders/beauty/no_covers/contact_sheet.jpg

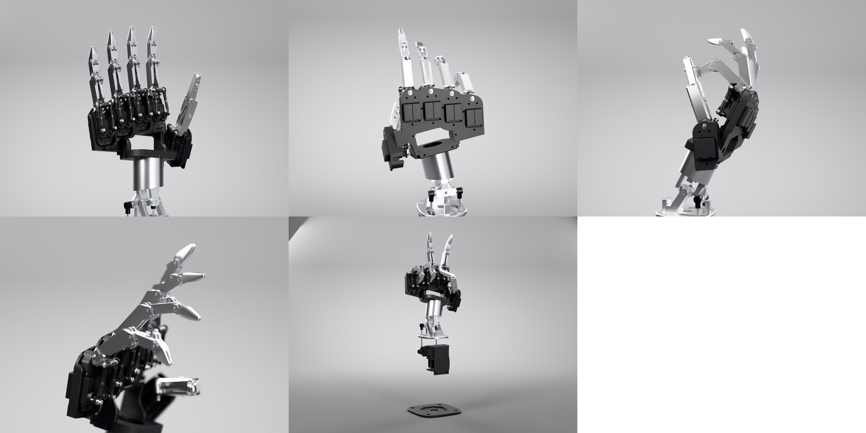
Demo/AHSimulation/five_finger/renders/beauty/no_covers/contact_sheet.jpg
