molinzhao27/AmazingHand/Demo/AHSimulation/five_finger/renders/beauty/no_shells/contact_sheet.jpg

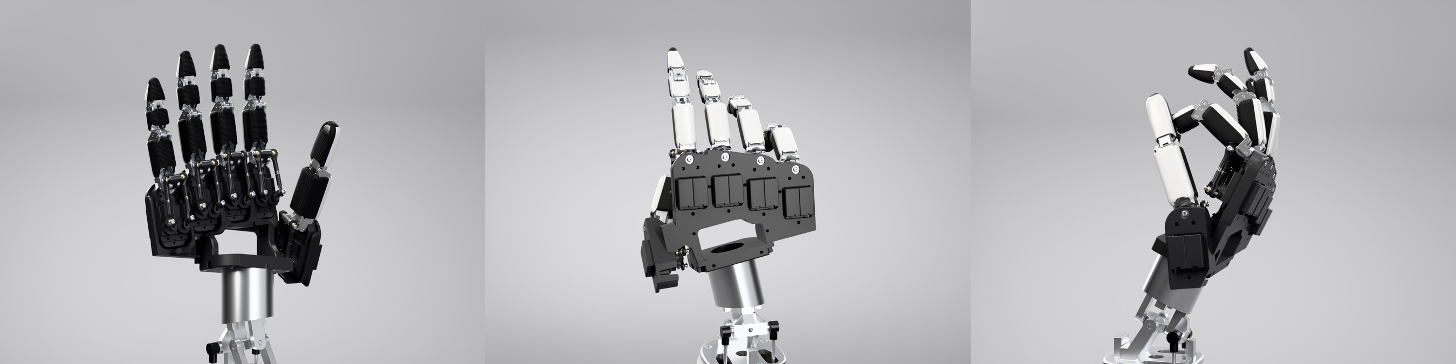
Demo/AHSimulation/five_finger/renders/beauty/no_shells/contact_sheet.jpg
