molinzhao27/AmazingHand/Demo/AHSimulation/five_finger/renders/beauty/peace.jpg

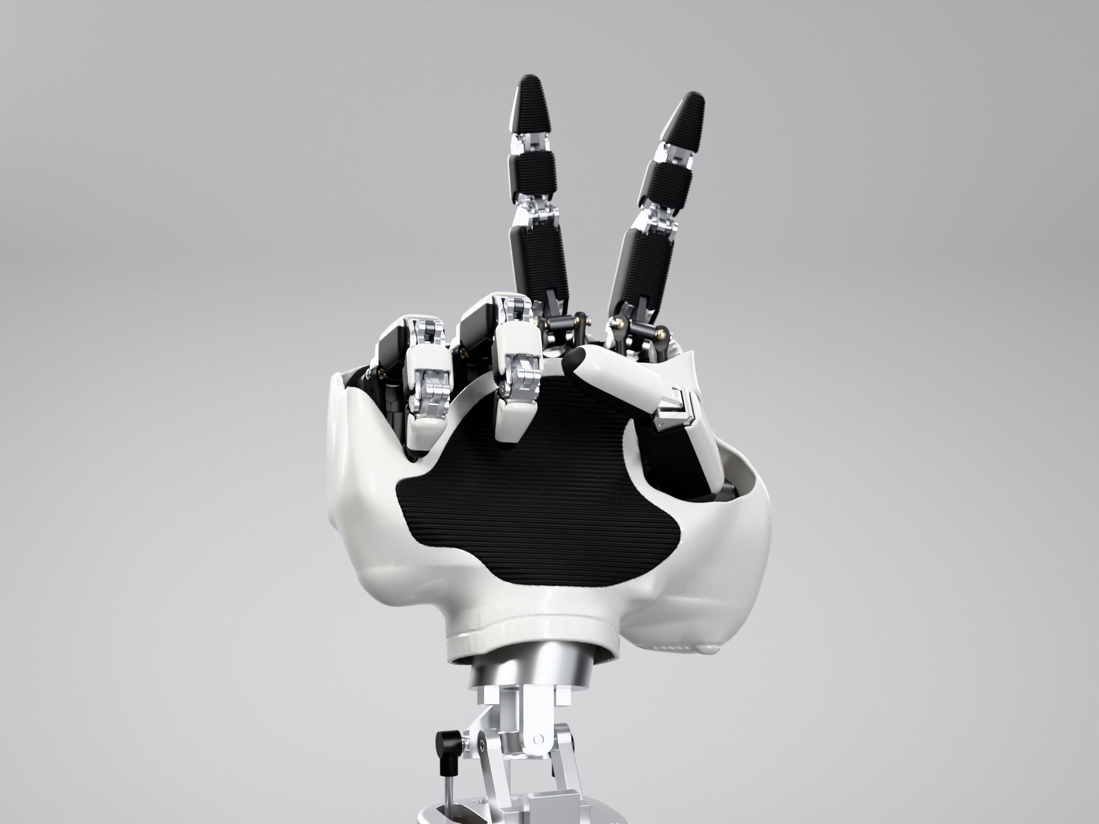
Demo/AHSimulation/five_finger/renders/beauty/peace.jpg
