molinzhao27/AmazingHand/Demo/AHSimulation/five_finger/renders/beauty/pointing.jpg

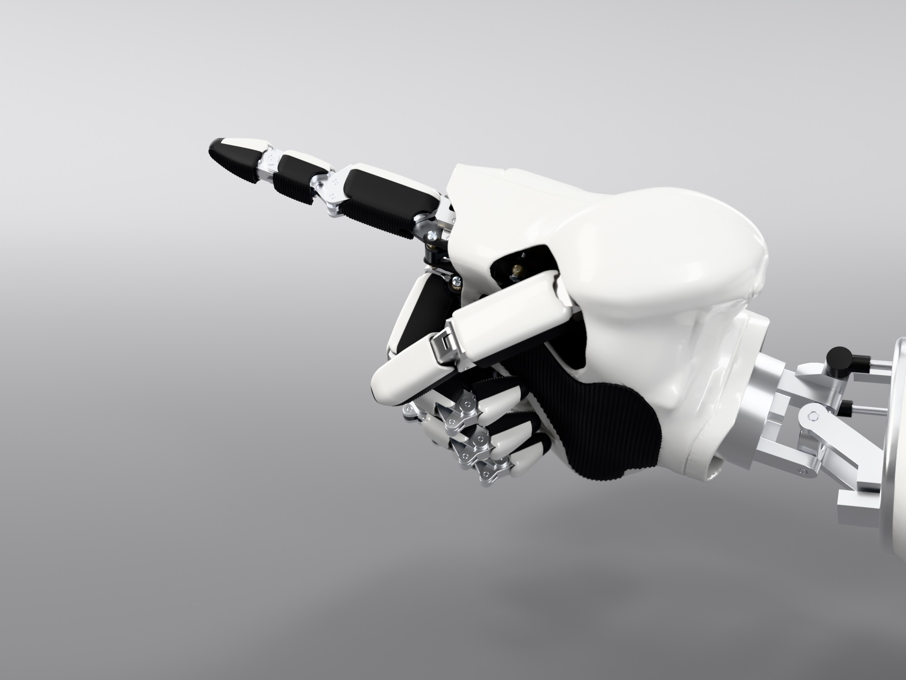
Demo/AHSimulation/five_finger/renders/beauty/pointing.jpg
