molinzhao27/AmazingHand/Demo/AHSimulation/five_finger/renders/before_after_heel.jpg

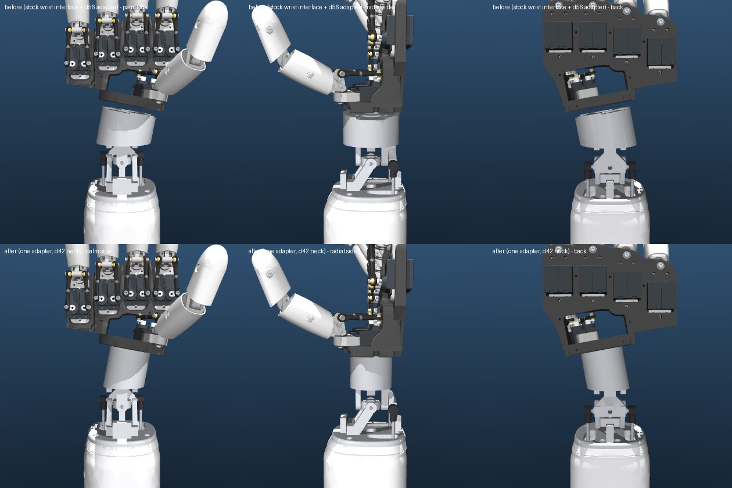
Demo/AHSimulation/five_finger/renders/before_after_heel.jpg
