molinzhao27/AmazingHand/Demo/AHSimulation/five_finger/renders/left_5f_00_keyframe_zero.jpg

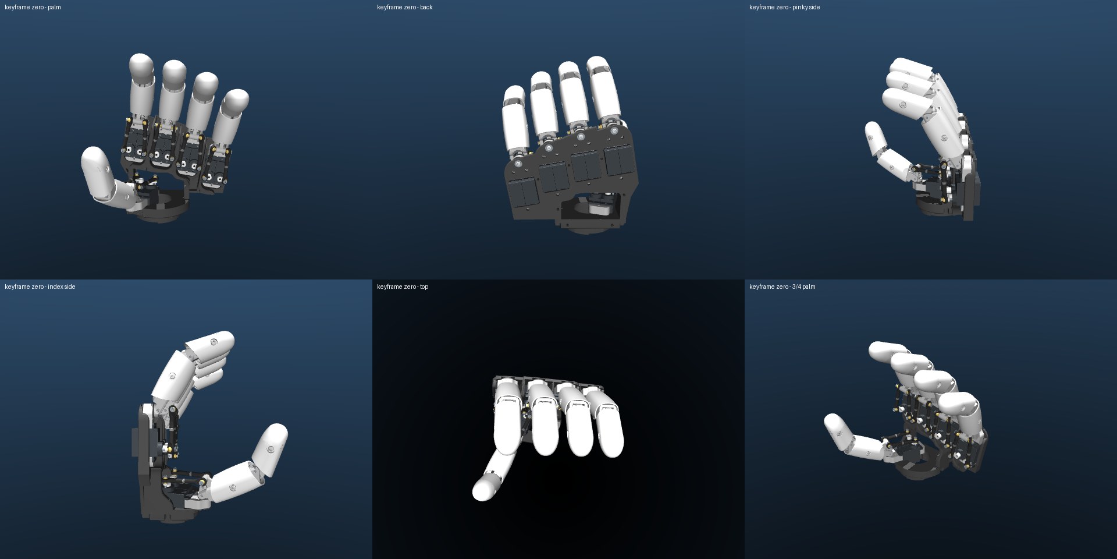
Demo/AHSimulation/five_finger/renders/left_5f_00_keyframe_zero.jpg
