molinzhao27/AmazingHand/Demo/AHSimulation/five_finger/renders/left_5f_03_SpreadHand.jpg

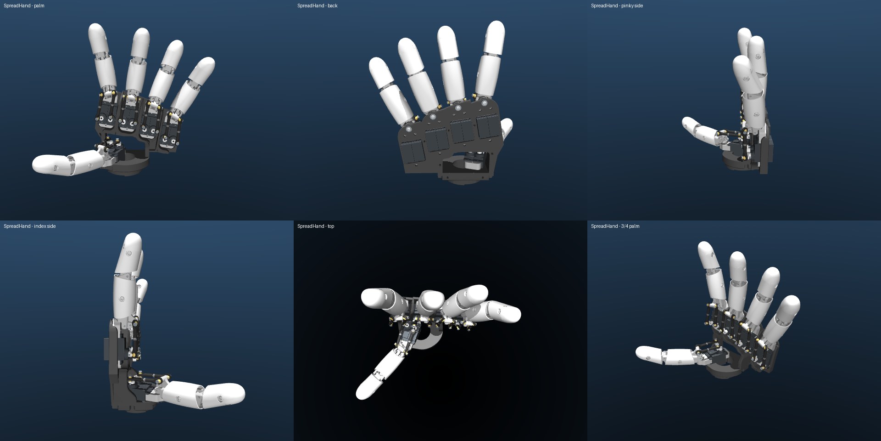
Demo/AHSimulation/five_finger/renders/left_5f_03_SpreadHand.jpg
