molinzhao27/AmazingHand/Demo/AHSimulation/five_finger/renders/left_5f_04_ClenchHand.jpg

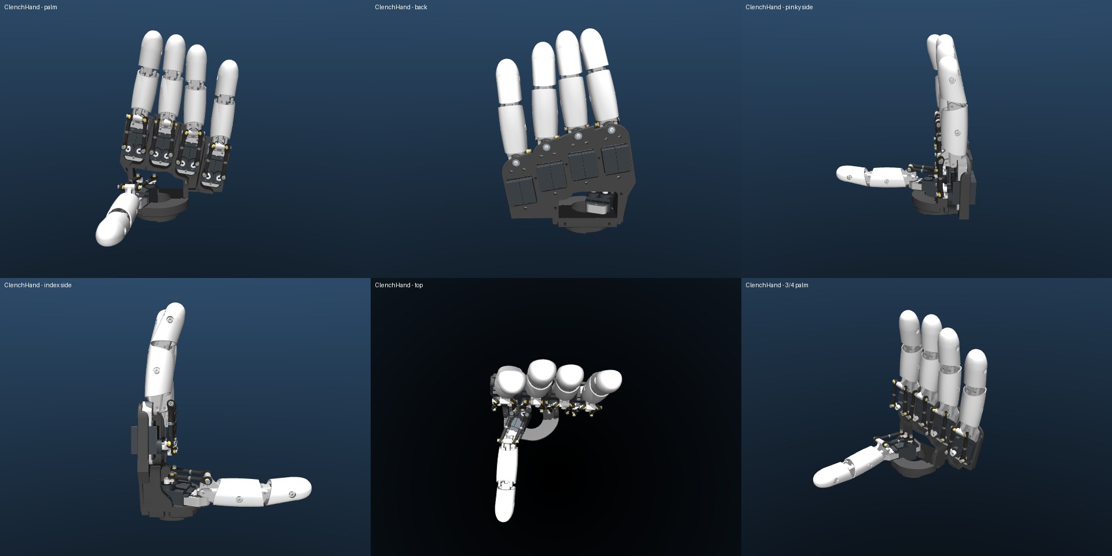
Demo/AHSimulation/five_finger/renders/left_5f_04_ClenchHand.jpg
