molinzhao27/AmazingHand/Demo/AHSimulation/five_finger/renders/left_compare_stock_vs_5f.jpg

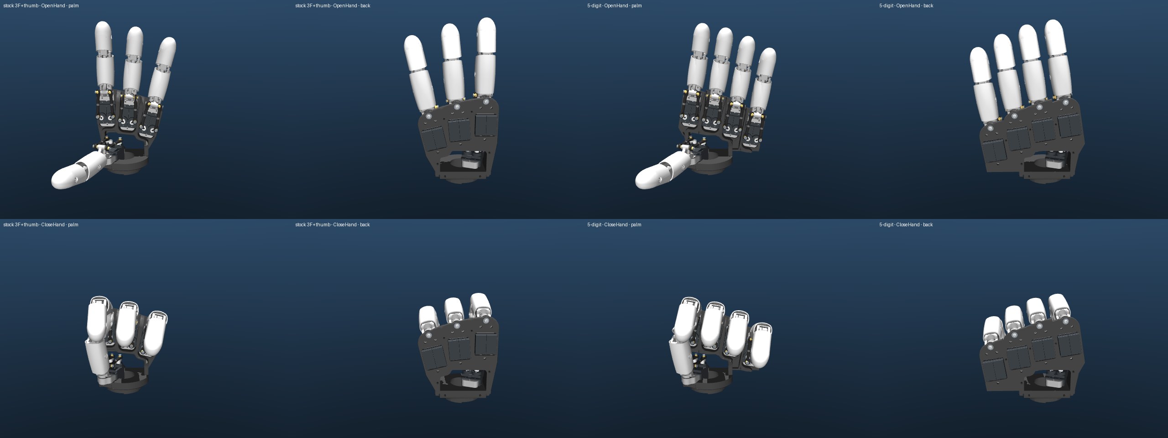
Demo/AHSimulation/five_finger/renders/left_compare_stock_vs_5f.jpg
