molinzhao27/AmazingHand/Demo/AHSimulation/five_finger/renders/shells_5f_01_CloseHand.jpg

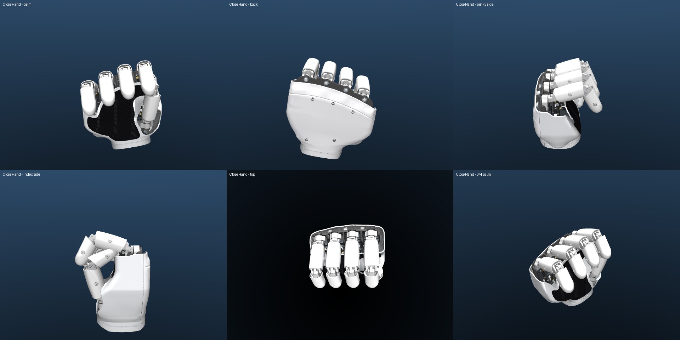
Demo/AHSimulation/five_finger/renders/shells_5f_01_CloseHand.jpg
