molinzhao27/AmazingHand/Demo/AHSimulation/five_finger/renders/shells_5f_03_Perfect.jpg

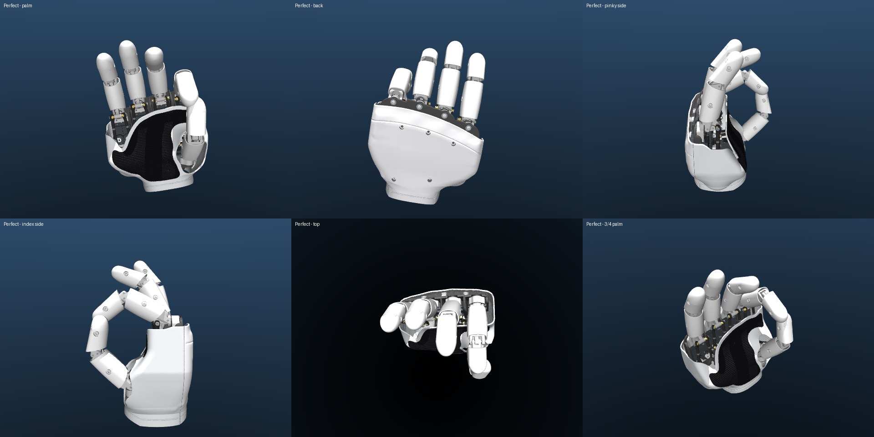
Demo/AHSimulation/five_finger/renders/shells_5f_03_Perfect.jpg
