molinzhao27/AmazingHand/Demo/AHSimulation/slim_fingers/renders/compare_CloseHand.jpg

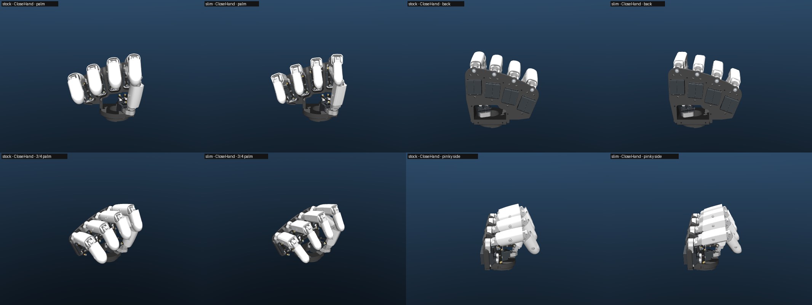
Demo/AHSimulation/slim_fingers/renders/compare_CloseHand.jpg
