molinzhao27/AmazingHand/Demo/AHSimulation/slim_fingers/renders/compare_OpenHand.jpg

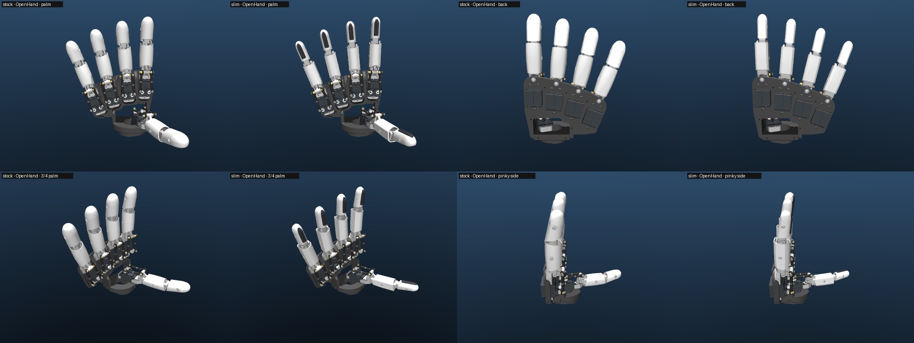
Demo/AHSimulation/slim_fingers/renders/compare_OpenHand.jpg
