molinzhao27/AmazingHand/Demo/AHSimulation/slim_fingers/renders/compare_Perfect.jpg

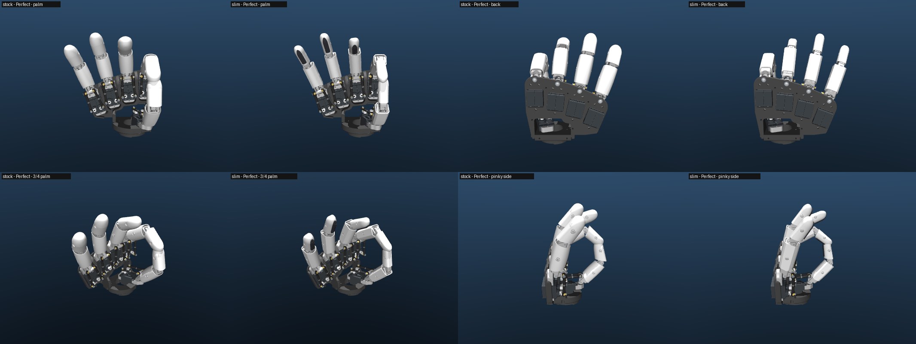
Demo/AHSimulation/slim_fingers/renders/compare_Perfect.jpg
