molinzhao27/AmazingHand/Demo/AHSimulation/slim_fingers/renders/compare_shells_Perfect.jpg

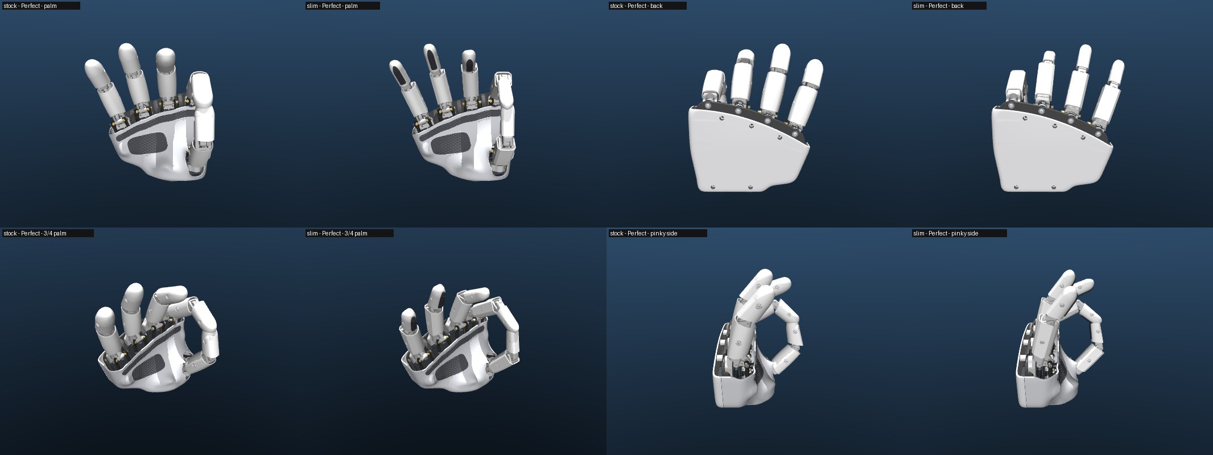
Demo/AHSimulation/slim_fingers/renders/compare_shells_Perfect.jpg
