molinzhao27/AmazingHand/Demo/AHSimulation/slim_fingers/renders/extremes.jpg

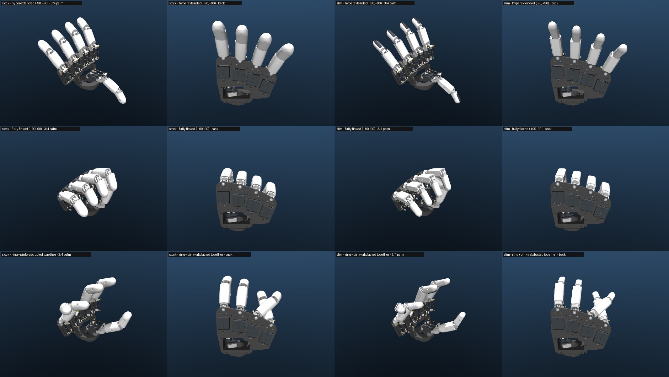
Demo/AHSimulation/slim_fingers/renders/extremes.jpg
