molinzhao27/AmazingHand/Demo/AHSimulation/slim_fingers/renders/finger_closeup.jpg

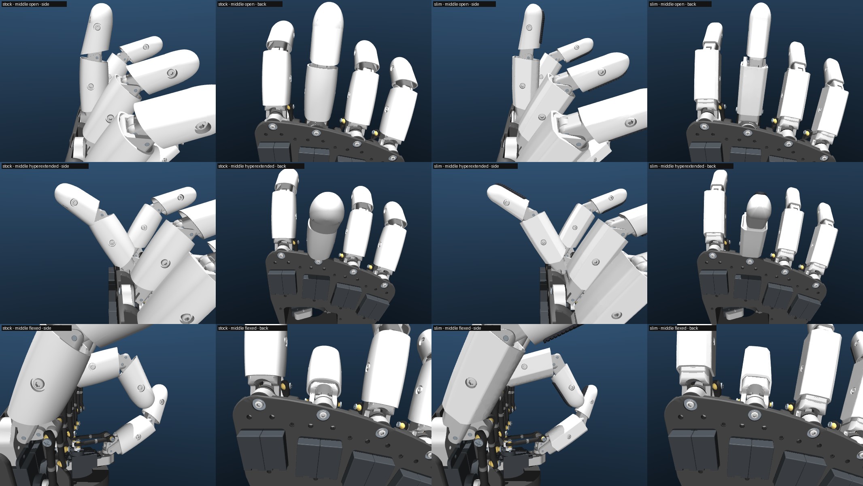
Demo/AHSimulation/slim_fingers/renders/finger_closeup.jpg
