molinzhao27/AmazingHand/Demo/AHSimulation/three_segment/renders/finger_3seg_poses.jpg

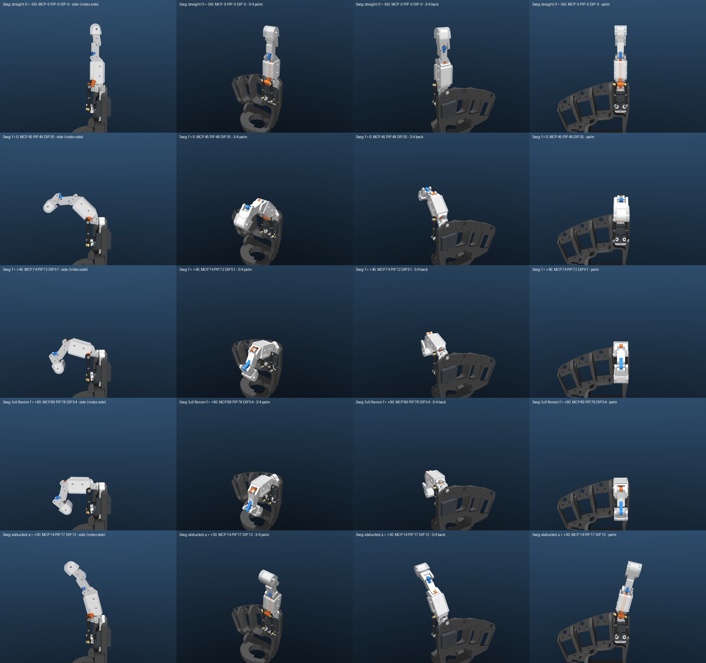
Demo/AHSimulation/three_segment/renders/finger_3seg_poses.jpg
