molinzhao27/AmazingHand/Demo/AHSimulation/three_segment/renders/finger_stock_poses.jpg

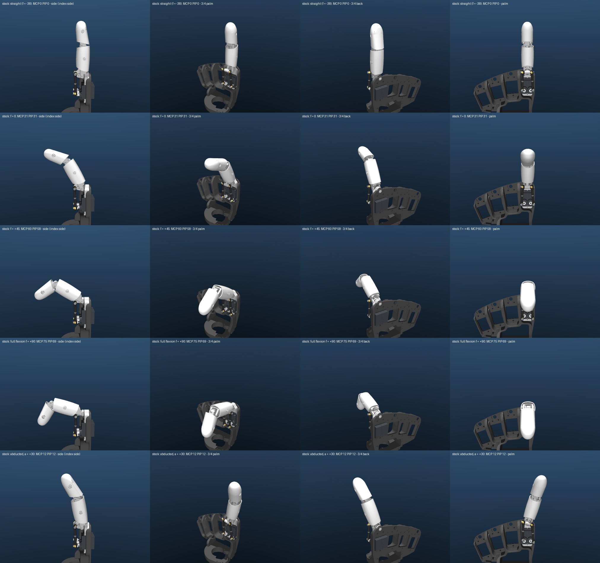
Demo/AHSimulation/three_segment/renders/finger_stock_poses.jpg
