molinzhao27/AmazingHand/Demo/AHSimulation/ultimate_finger/renders/hand_CloseHand_shells.jpg

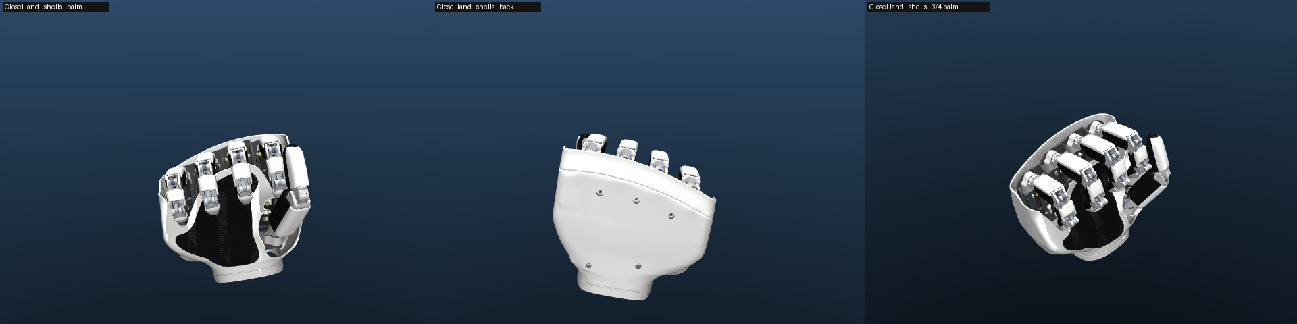
Demo/AHSimulation/ultimate_finger/renders/hand_CloseHand_shells.jpg
