molinzhao27/AmazingHand/Demo/AHSimulation/ultimate_finger/renders/hand_compare_OpenHand.jpg

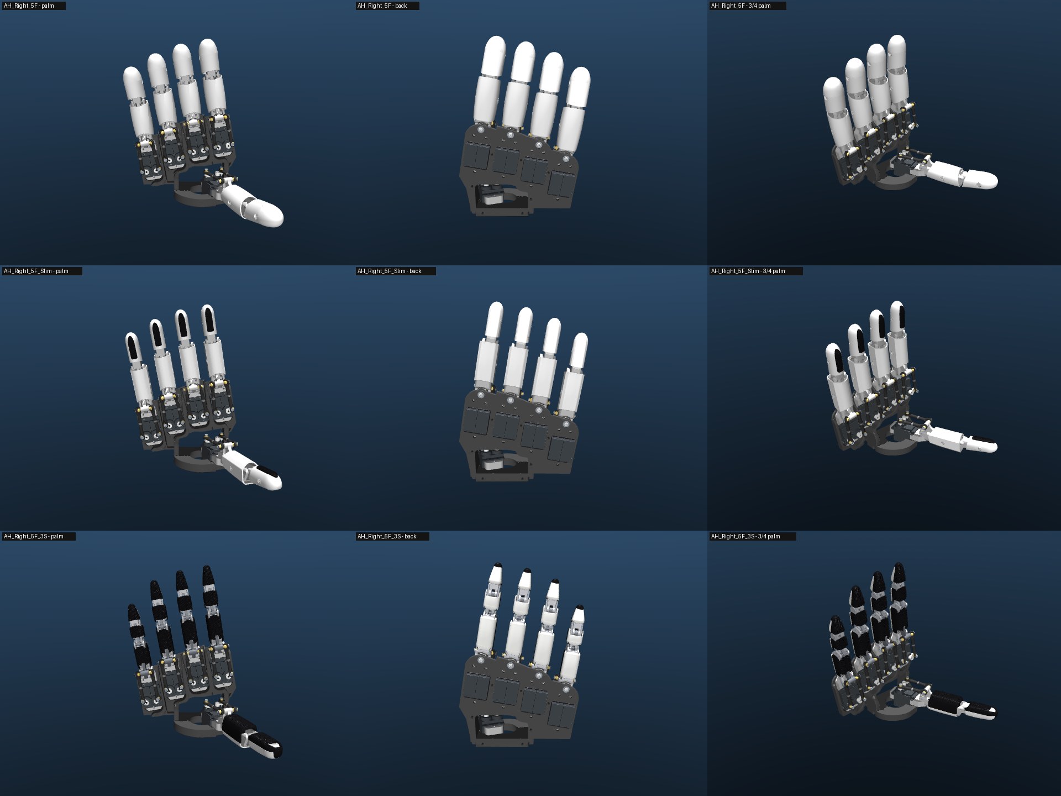
Demo/AHSimulation/ultimate_finger/renders/hand_compare_OpenHand.jpg
