molinzhao27/AmazingHand/Demo/AHSimulation/ultimate_finger/sixbar/sixbar_study.png

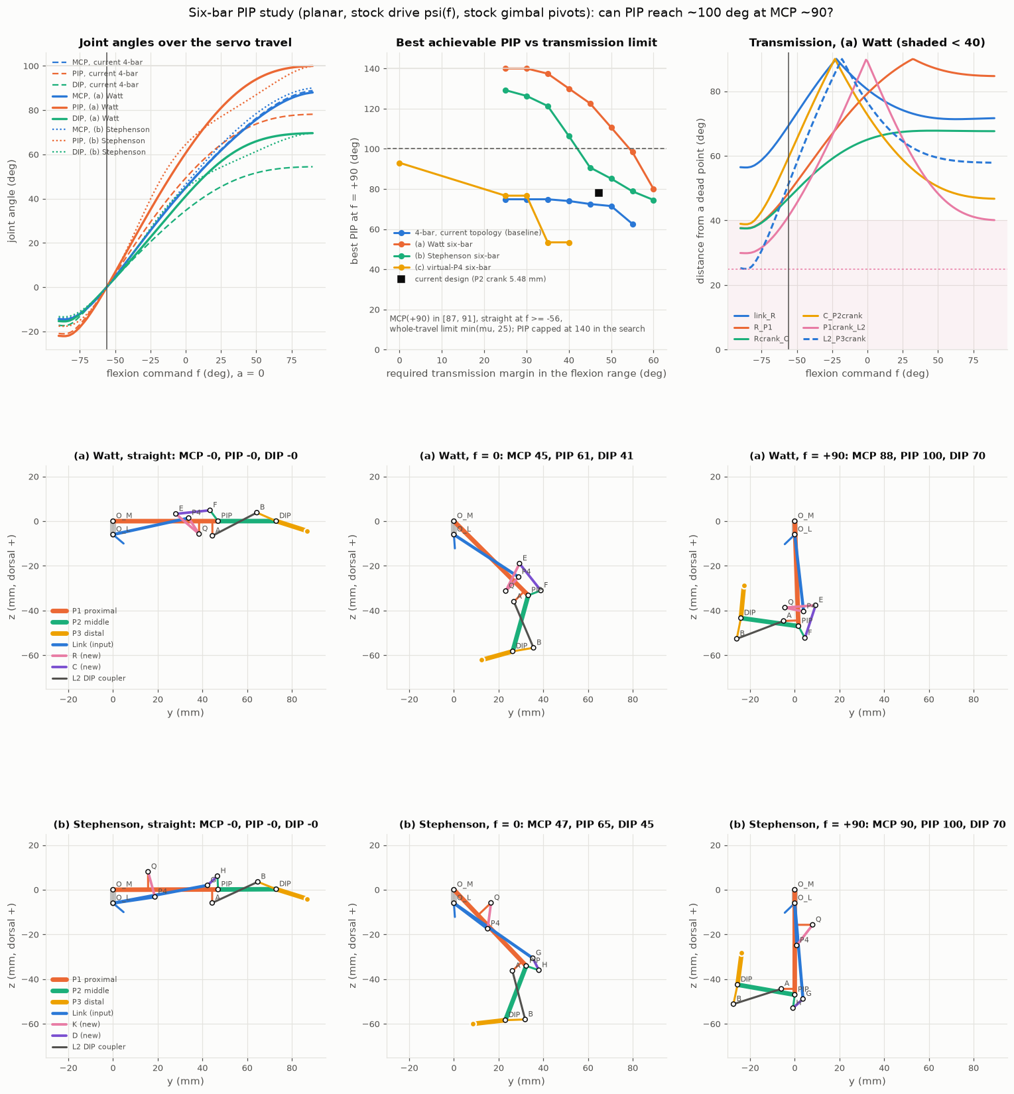
Demo/AHSimulation/ultimate_finger/sixbar/sixbar_study.png
