molinzhao27/AmazingHand/Demo/AHSimulation/wrist/renders/wrist_00_neutral.jpg

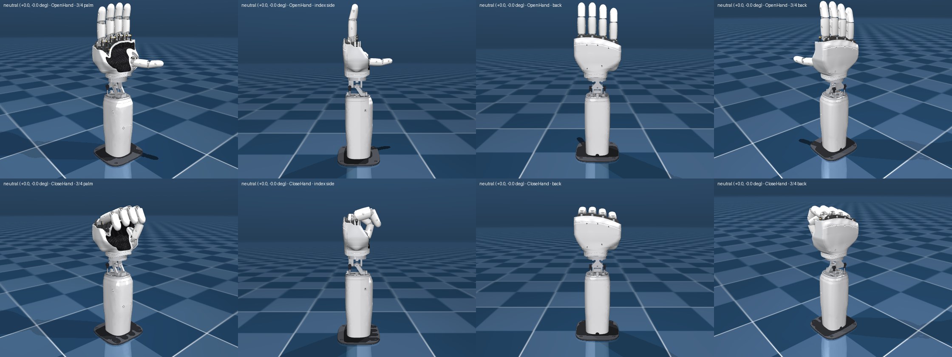
Demo/AHSimulation/wrist/renders/wrist_00_neutral.jpg
