molinzhao27/AmazingHand/Demo/AHSimulation/wrist/renders/wrist_01_palm-ward_flexion_60.jpg

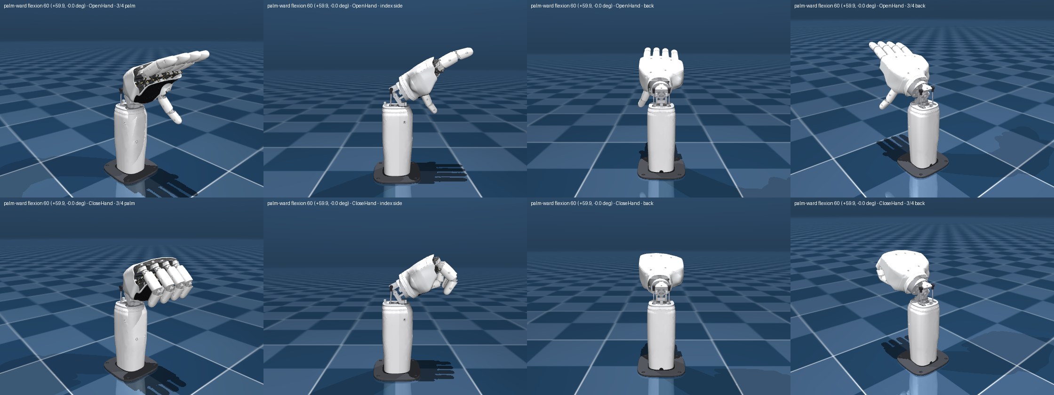
Demo/AHSimulation/wrist/renders/wrist_01_palm-ward_flexion_60.jpg
