molinzhao27/AmazingHand/Demo/AHSimulation/wrist/renders/wrist_02_extension_60.jpg

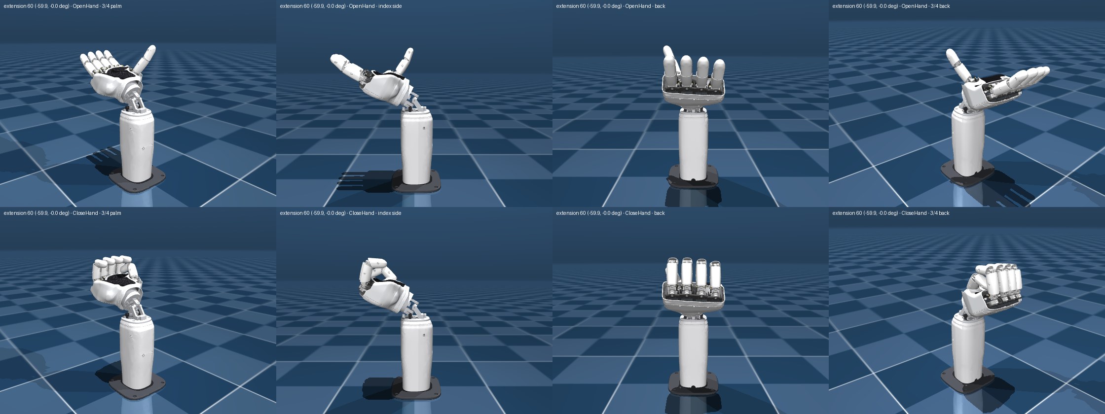
Demo/AHSimulation/wrist/renders/wrist_02_extension_60.jpg
