molinzhao27/AmazingHand/Demo/AHSimulation/wrist/renders/wrist_04_ulnar_deviation_25.jpg

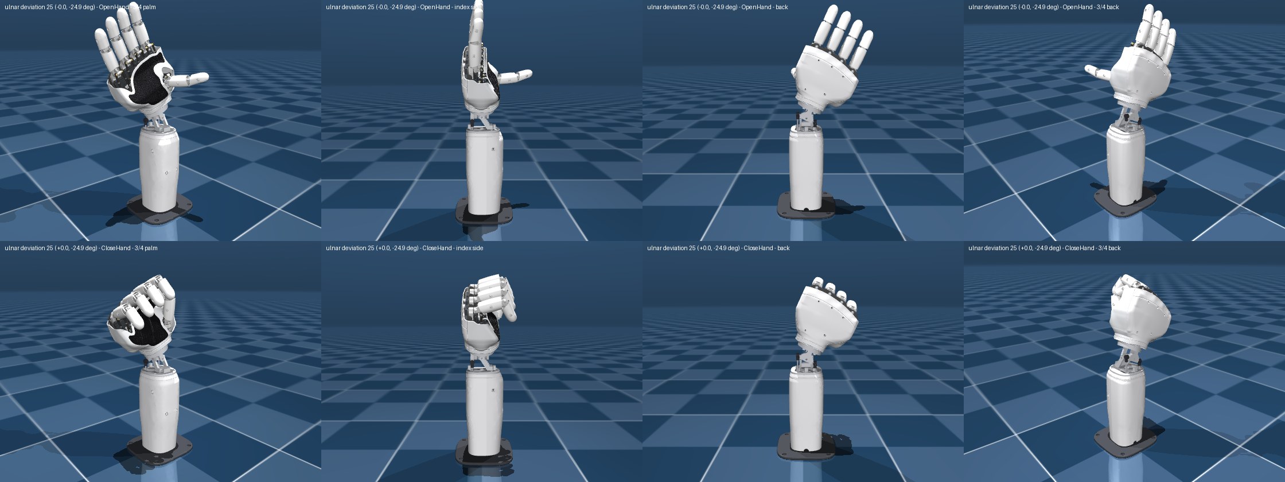
Demo/AHSimulation/wrist/renders/wrist_04_ulnar_deviation_25.jpg
