molinzhao27/AmazingHand/cad/five_finger/slim_fingers/preview_parts.png

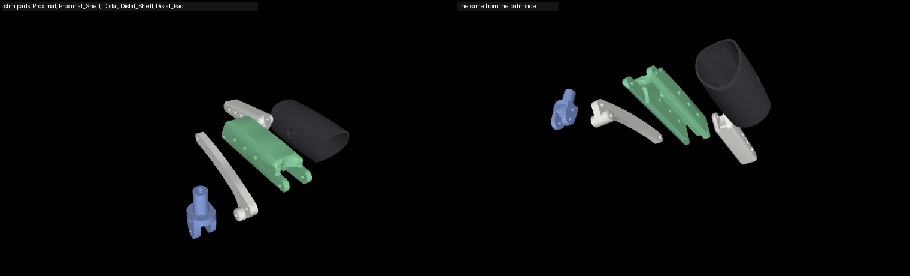
cad/five_finger/slim_fingers/preview_parts.png
