molinzhao27/AmazingHand/cad/five_finger/three_segment/step/Finger_3S_assembly.step

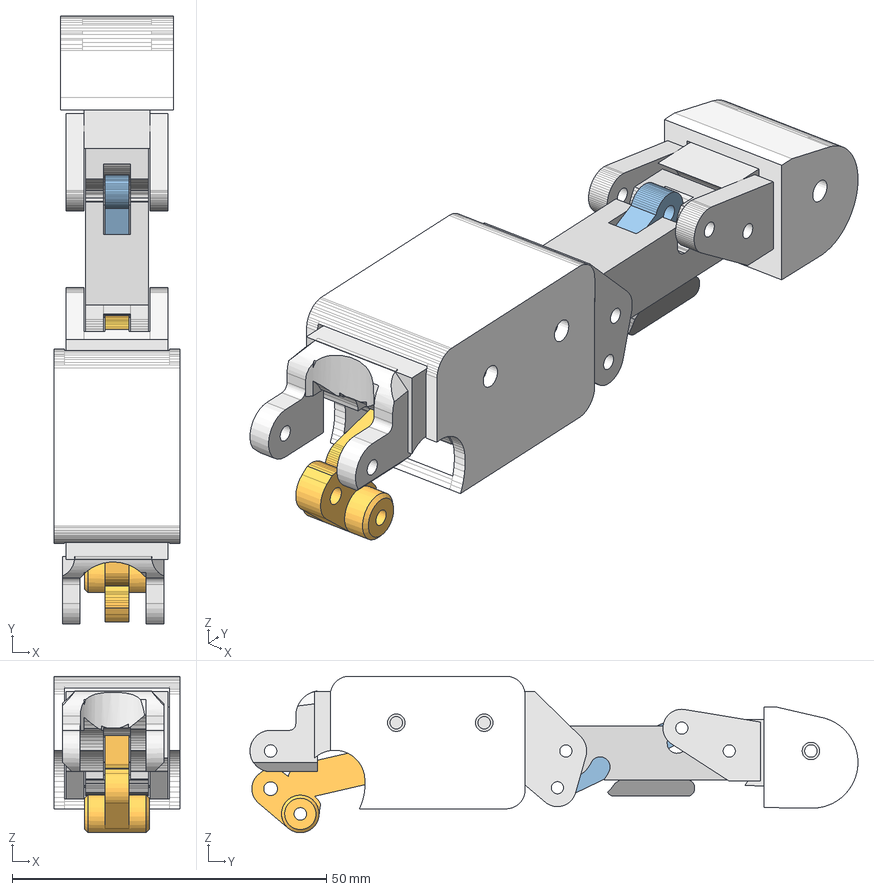
[picture p101: CAD file, 2026-10-13]
cad/five_finger/three_segment/step/Finger_3S_assembly.step
20.0 x 96.8 x 24.9 mm
Link_3S
P1_Proximal_3S
P2_Middle_3S
P3_Distal_3S
L2_Coupler_3S
P1_Shell_3S
P2_Pad_3S
P3_Shell_3S
