molinzhao27/AmazingHand/cad/five_finger/fingers/step/Proximal_Shell_Styled.step

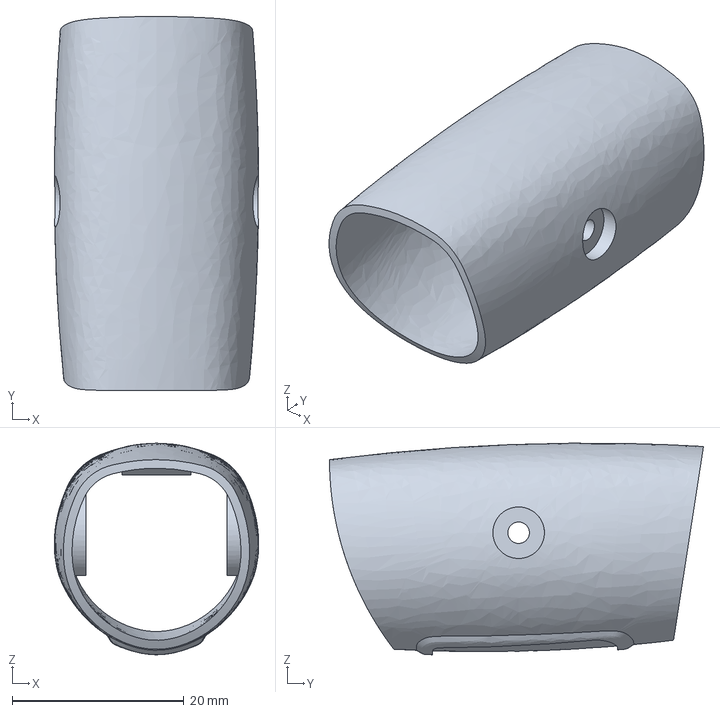
[picture p102: CAD file, 2026-10-14]
cad/five_finger/fingers/step/Proximal_Shell_Styled.step
23.8 x 43.5 x 24.6 mm
