molinzhao27/AmazingHand/cad/five_finger/fingers/stl/print/Proximal_Pad_print.stl

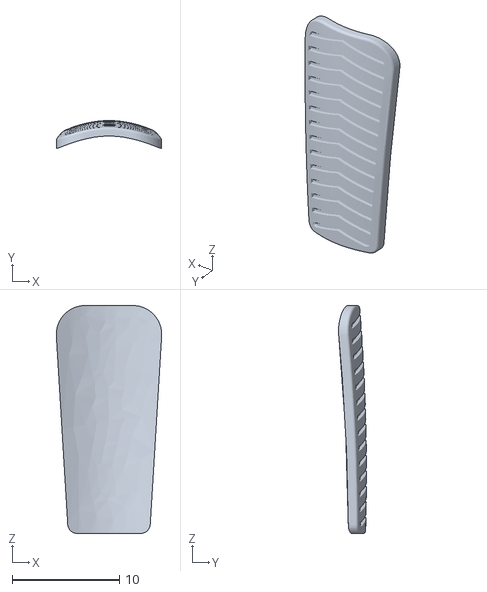
[picture p103: CAD file, 2026-10-14]
cad/five_finger/fingers/stl/print/Proximal_Pad_print.stl
9.85 x 2.61 x 21.3
