molinzhao27/AmazingHand/cad/five_finger/mockup/stl/Ball_Stud_Top.stl

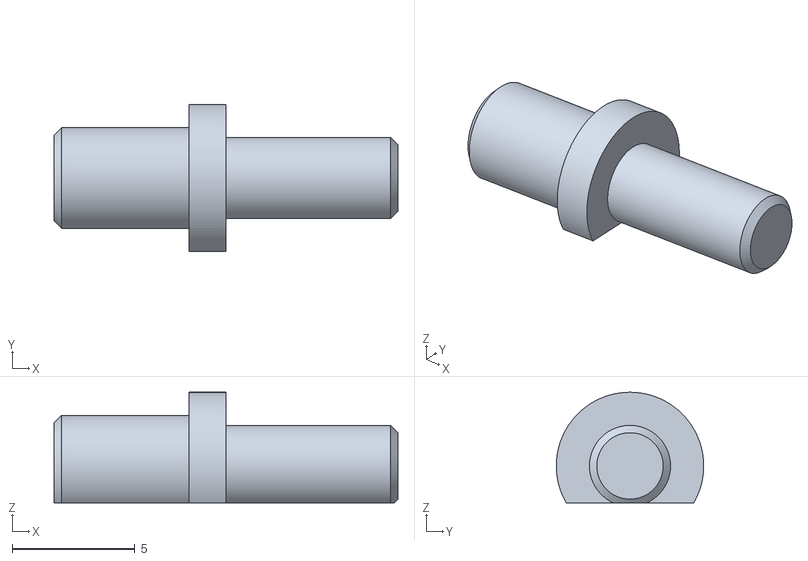
[picture p104: CAD file, 2026-10-18]
cad/five_finger/mockup/stl/Ball_Stud_Top.stl
14.0 x 6.00 x 4.50
