molinzhao27/AmazingHand/cad/five_finger/mockup/stl/test/Fit_Ball_Hand_Post.stl

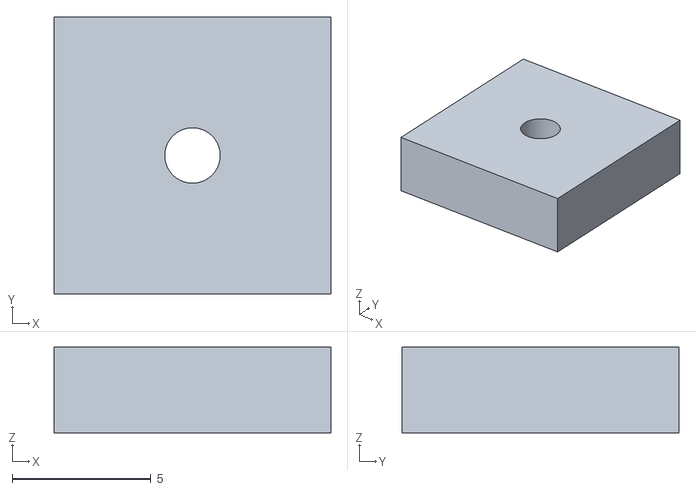
[picture p105: CAD file, 2026-10-18]
cad/five_finger/mockup/stl/test/Fit_Ball_Hand_Post.stl
10.0 x 10.0 x 3.10
