molinzhao27/AmazingHand/cad/five_finger/slim_fingers/step/Distal_Pad_Slim_untextured.step

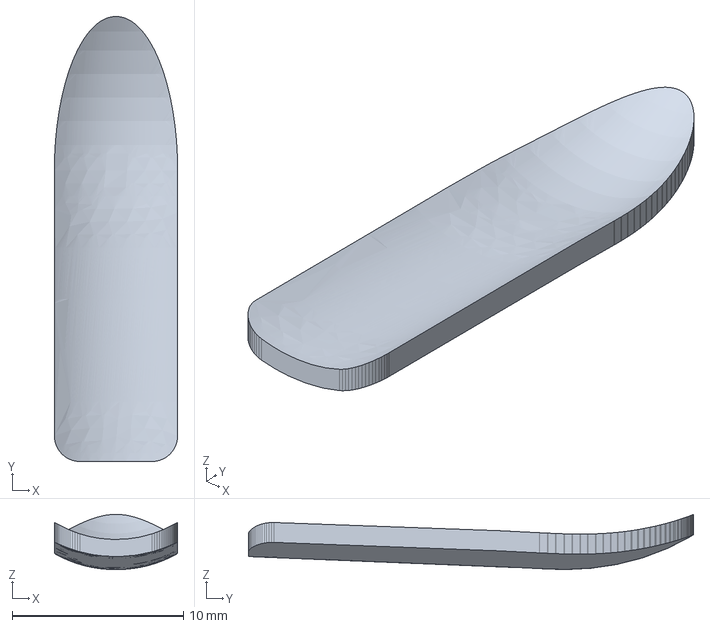
[picture p106: CAD file, 2026-10-14]
cad/five_finger/slim_fingers/step/Distal_Pad_Slim_untextured.step
7.20 x 26.0 x 3.23 mm
