molinzhao27/AmazingHand/cad/five_finger/slim_fingers/stl/Distal_Shell_Slim_OnePiece.stl

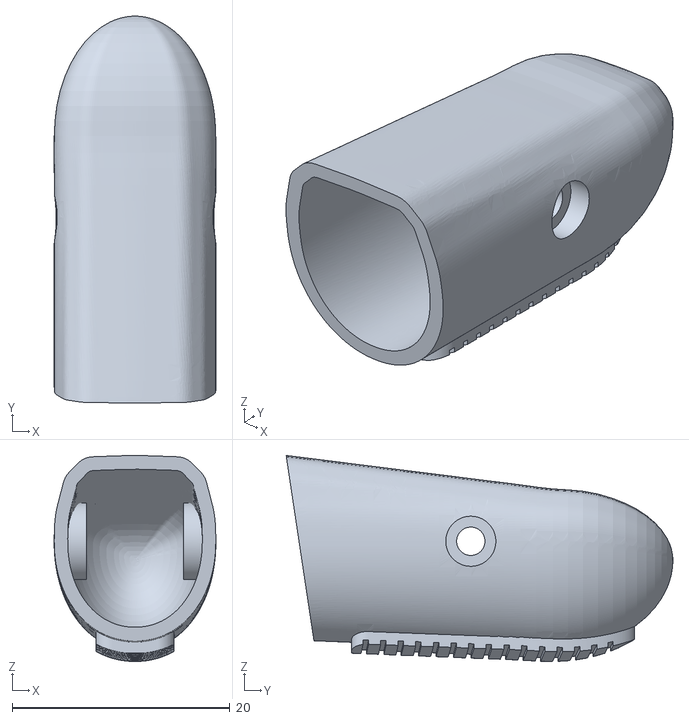
[picture p107: CAD file, 2026-10-14]
cad/five_finger/slim_fingers/stl/Distal_Shell_Slim_OnePiece.stl
14.9 x 35.5 x 18.9
