molinzhao27/AmazingHand/cad/five_finger/step/L-Hand_Plate_5F.step

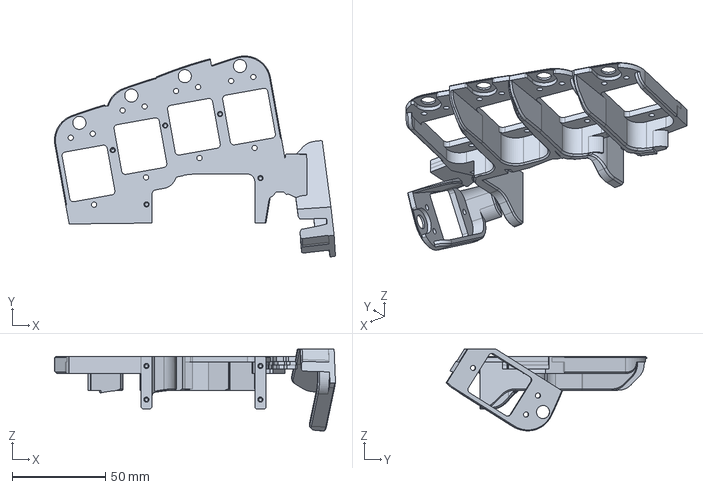
[picture p108: CAD file, 2026-10-15]
cad/five_finger/step/L-Hand_Plate_5F.step
150.4 x 107.6 x 43.7 mm
