molinzhao27/AmazingHand/cad/five_finger/stl/L-Palm_Shell_5F.stl

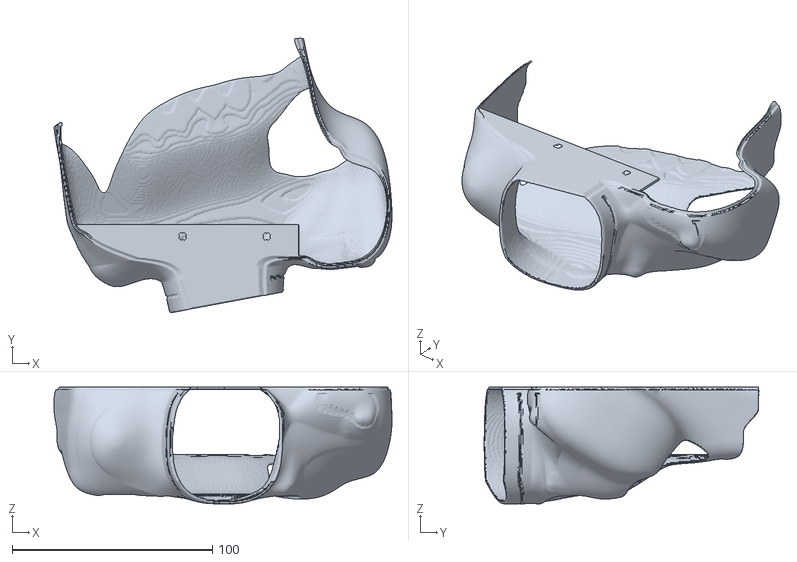
[picture p109: CAD file, 2026-10-16]
cad/five_finger/stl/L-Palm_Shell_5F.stl
168.6 x 137.0 x 58.4
