molinzhao27/AmazingHand/cad/five_finger/three_segment/stl/palm_shells/R-Palm_Pad_Palm_5F.stl

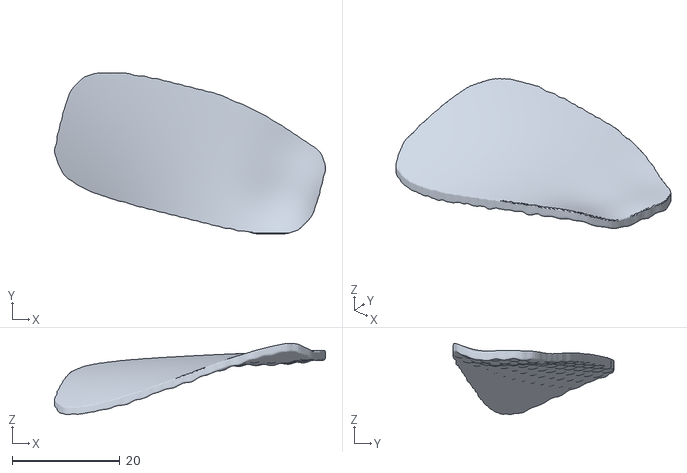
[picture p110: CAD file, 2026-10-13]
cad/five_finger/three_segment/stl/palm_shells/R-Palm_Pad_Palm_5F.stl
50.2 x 29.8 x 13.2
