molinzhao27/AmazingHand/cad/five_finger/ultimate_finger/step/UF_P3_Distal_untrimmed.step

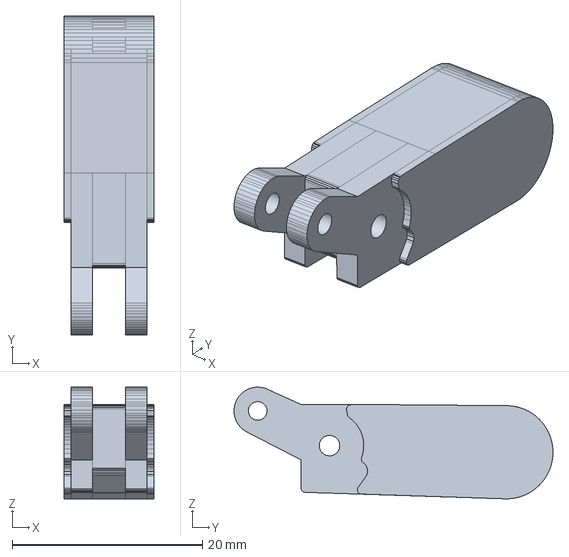
[picture p111: CAD file, 2026-10-14]
cad/five_finger/ultimate_finger/step/UF_P3_Distal_untrimmed.step
9.50 x 33.5 x 11.7 mm
