molinzhao27/AmazingHand/cad/five_finger/ultimate_finger/stl/UF_P2_Shell_S088.stl

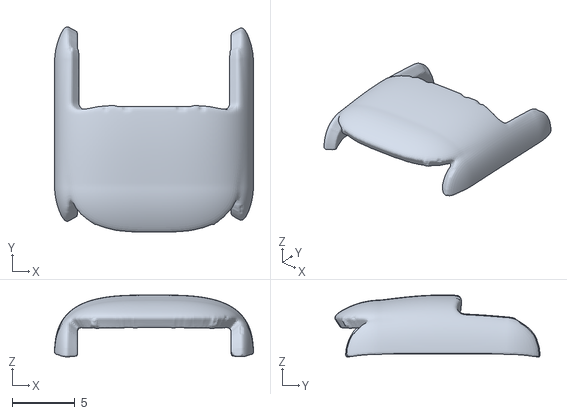
[picture p112: CAD file, 2026-10-14]
cad/five_finger/ultimate_finger/stl/UF_P2_Shell_S088.stl
15.9 x 16.4 x 4.94
