molinzhao27/AmazingHand/cad/five_finger/wrist/step/R-Forearm_Front.step

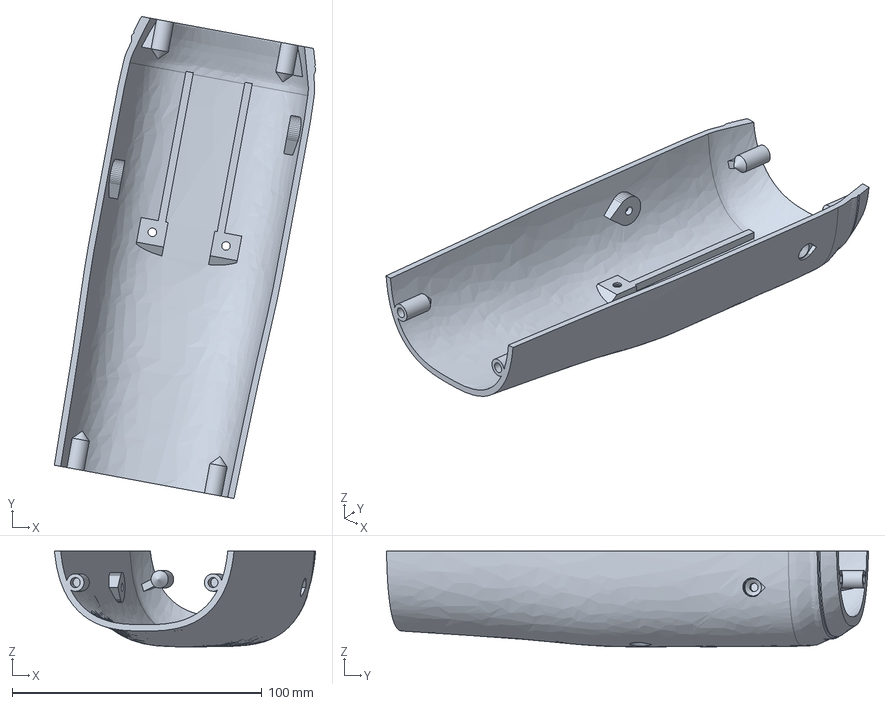
[picture p113: CAD file, 2026-10-15]
cad/five_finger/wrist/step/R-Forearm_Front.step
104.6 x 193.0 x 38.3 mm
