molinzhao27/AmazingHand/cad/five_finger/wrist/stl/ref/link_top_2.stl

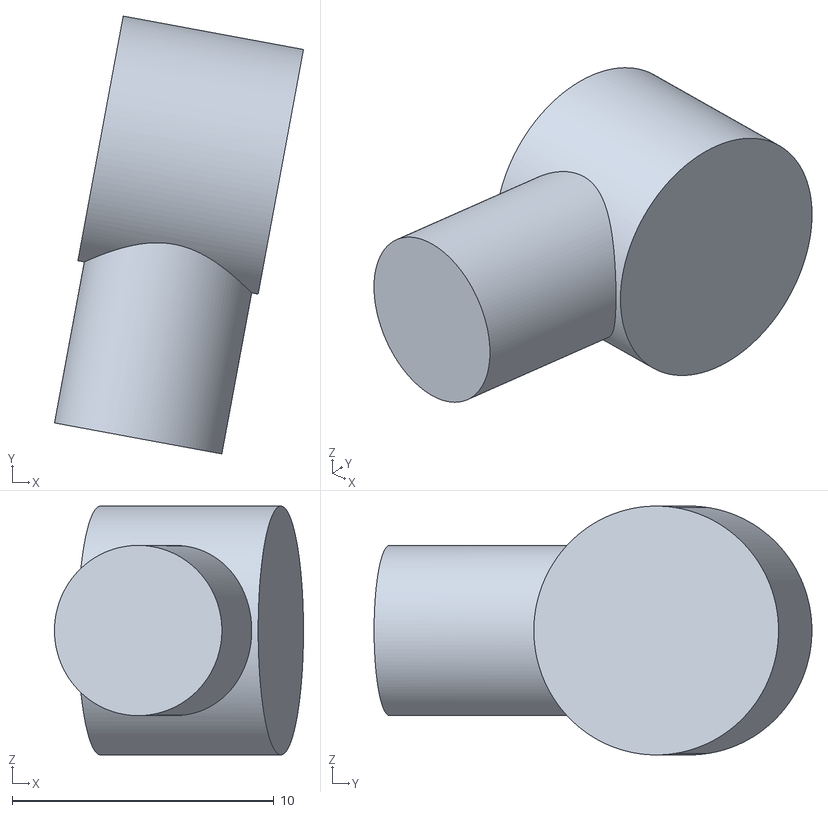
[picture p114: CAD file, 2026-10-15]
cad/five_finger/wrist/stl/ref/link_top_2.stl
9.51 x 16.7 x 9.50
