molinzhao27/AmazingHand/Demo/AHSimulation/AHSimulation/AH_Left_5F/mjcf/assets/l_wrist_interface.stl

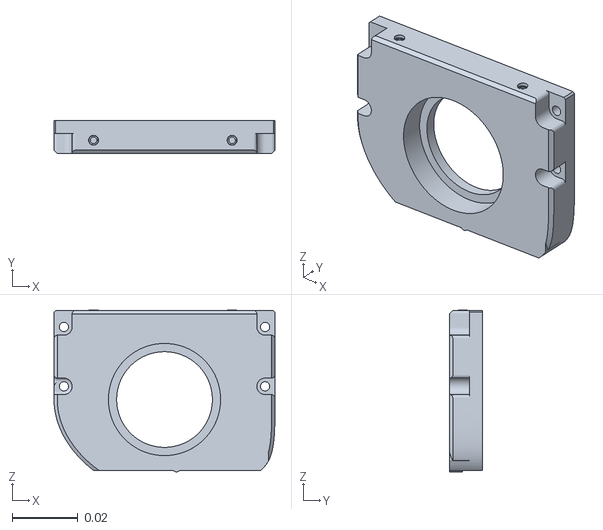
[picture p115: CAD file, 2026-10-16]
Demo/AHSimulation/AHSimulation/AH_Left_5F/mjcf/assets/l_wrist_interface.stl
0.067 x 0.01 x 0.049
