molinzhao27/AmazingHand/cad/five_finger/fingers/step/Distal_Pad.step

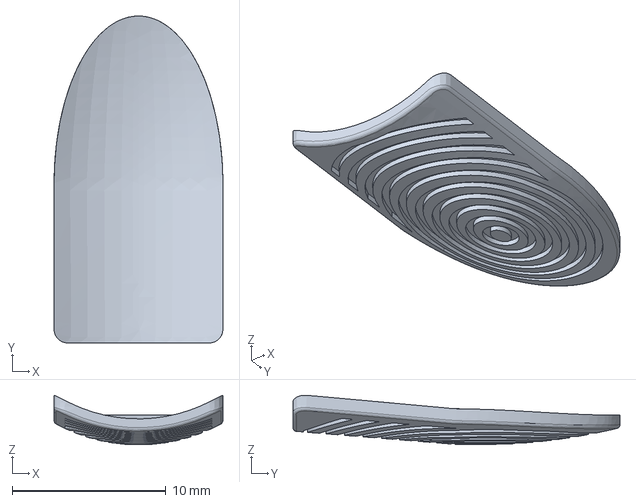
[picture p116: CAD file, 2026-10-14]
cad/five_finger/fingers/step/Distal_Pad.step
11.0 x 21.3 x 3.22 mm
