molinzhao27/AmazingHand/cad/five_finger/mockup/stl/Stud_Pin_D2.1_L8.stl

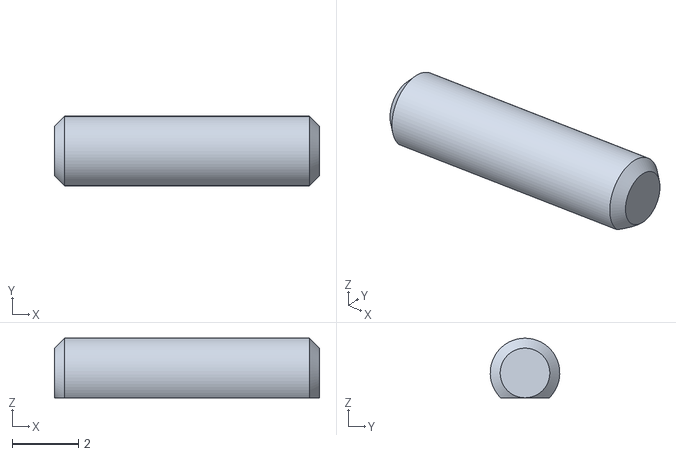
[picture p117: CAD file, 2026-10-18]
cad/five_finger/mockup/stl/Stud_Pin_D2.1_L8.stl
8.00 x 2.10 x 1.80
