molinzhao27/AmazingHand/cad/five_finger/mockup/stl/test/Fit_Ball_Wrist_Pin.stl

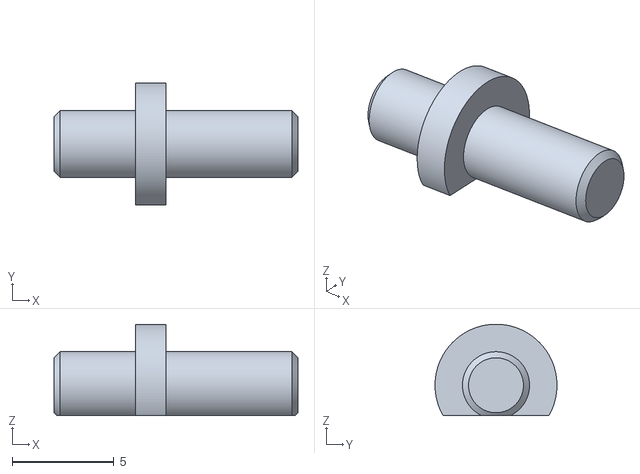
[picture p118: CAD file, 2026-10-18]
cad/five_finger/mockup/stl/test/Fit_Ball_Wrist_Pin.stl
12.0 x 6.00 x 4.50
