molinzhao27/AmazingHand/cad/five_finger/slim_fingers/step/Distal_Slim.step

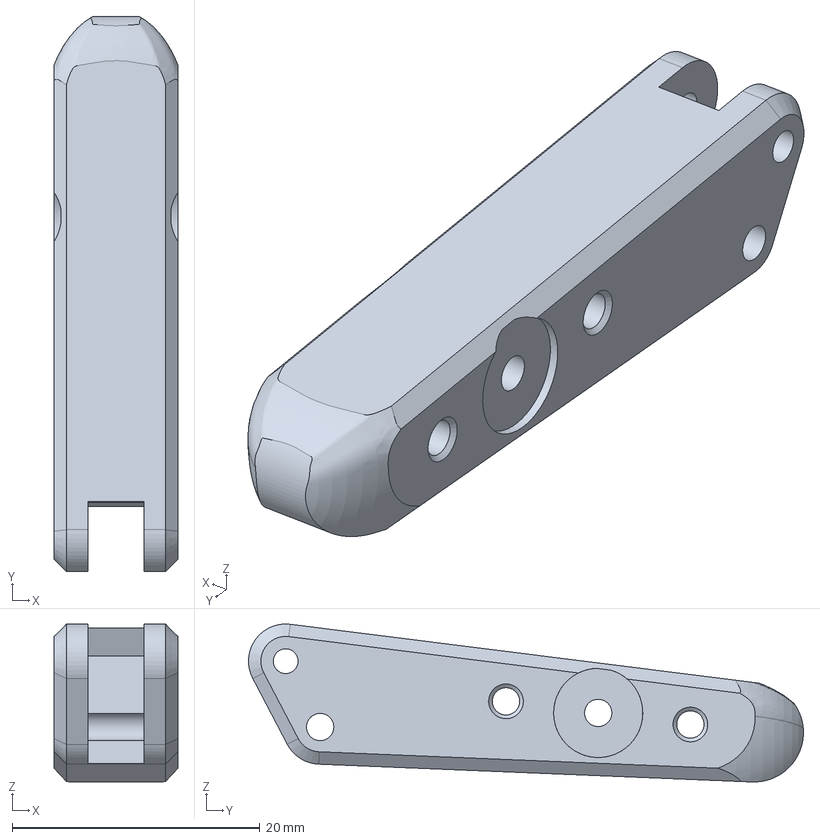
[picture p119: CAD file, 2026-10-14]
cad/five_finger/slim_fingers/step/Distal_Slim.step
10.0 x 44.8 x 12.8 mm
