molinzhao27/AmazingHand/cad/five_finger/three_segment/step/P3_Distal_3S.step

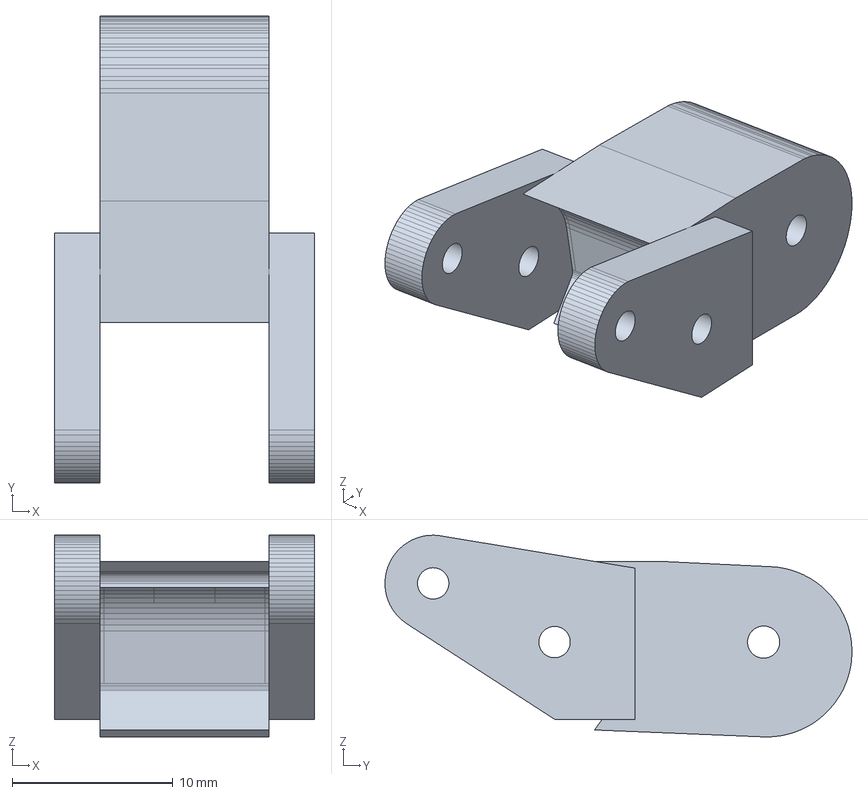
[picture p120: CAD file, 2026-10-13]
cad/five_finger/three_segment/step/P3_Distal_3S.step
16.2 x 29.0 x 12.5 mm
