molinzhao27/AmazingHand/cad/five_finger/three_segment/stl/palm_shells/R-Palm_Pad_Band_5F.stl

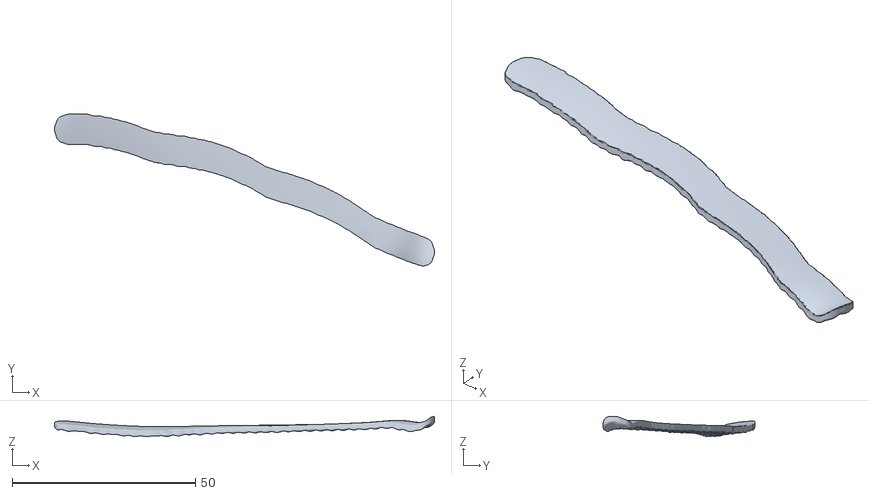
[picture p121: CAD file, 2026-10-13]
cad/five_finger/three_segment/stl/palm_shells/R-Palm_Pad_Band_5F.stl
103.8 x 41.5 x 5.59
