molinzhao27/AmazingHand/cad/five_finger/ultimate_finger/step/pin_2x12_A.step

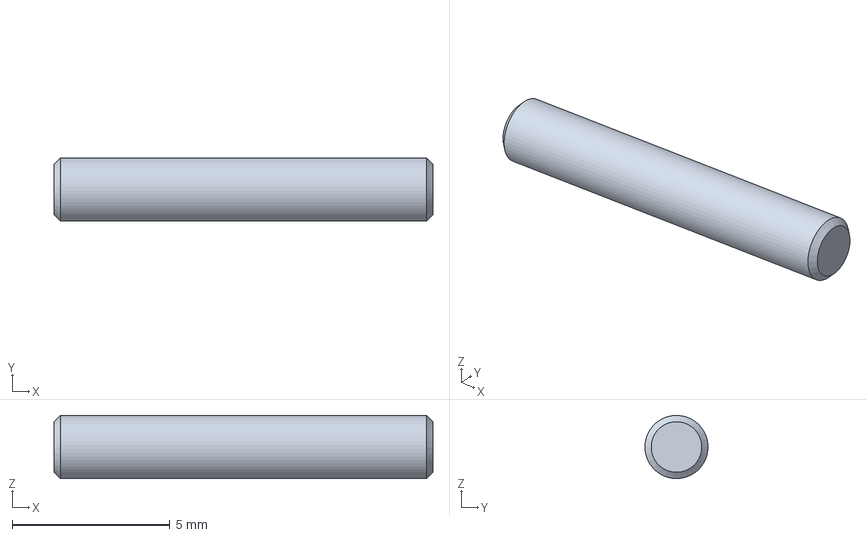
[picture p122: CAD file, 2026-10-14]
cad/five_finger/ultimate_finger/step/pin_2x12_A.step
12.0 x 2.00 x 2.00 mm
