molinzhao27/AmazingHand/cad/five_finger/ultimate_finger/stl/UF_P1_Shell.stl

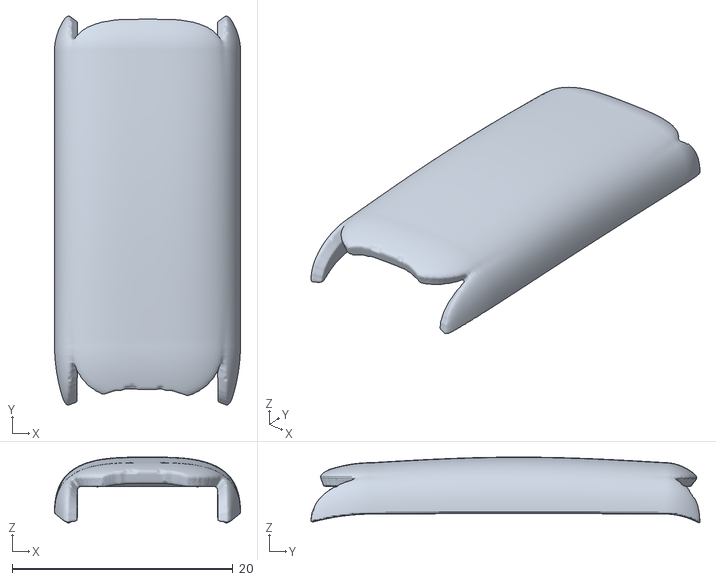
[picture p123: CAD file, 2026-10-14]
cad/five_finger/ultimate_finger/stl/UF_P1_Shell.stl
16.9 x 35.3 x 5.97
