molinzhao27/AmazingHand/cad/five_finger/wrist/step/R-Wrist_Hand_Adapter.step

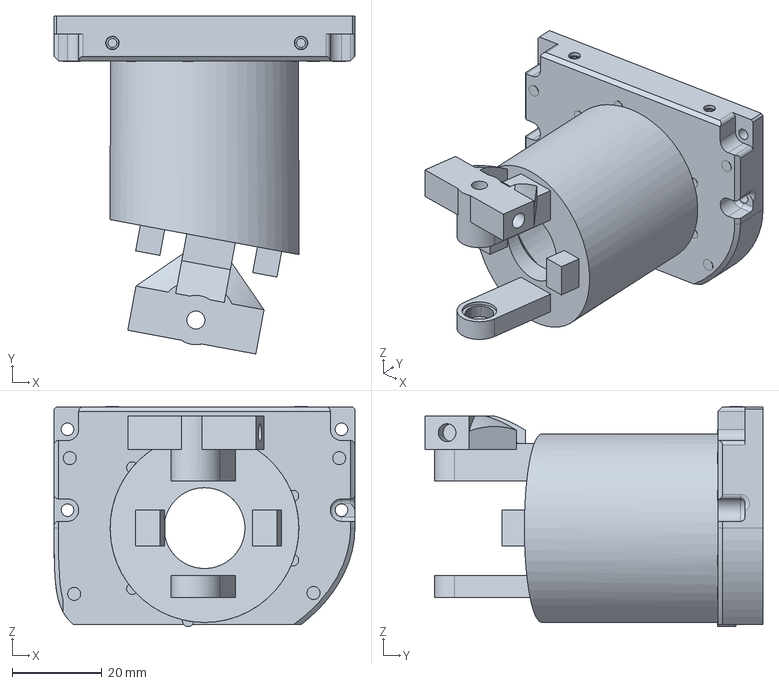
[picture p124: CAD file, 2026-10-15]
cad/five_finger/wrist/step/R-Wrist_Hand_Adapter.step
67.0 x 75.2 x 49.0 mm
