molinzhao27/AmazingHand/cad/five_finger/wrist/stl/ref/pin_d3x10_+x.stl

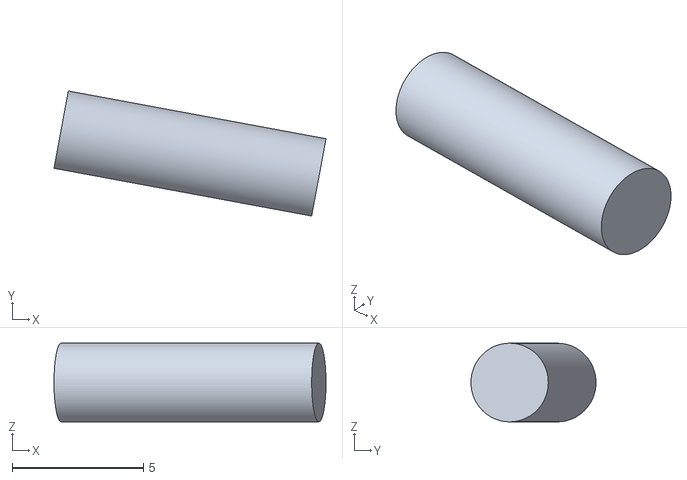
[picture p125: CAD file, 2026-10-15]
cad/five_finger/wrist/stl/ref/pin_d3x10_+x.stl
10.4 x 4.77 x 3.00
