molinzhao27/AmazingHand/Demo/AHSimulation/AHSimulation/AH_Right_5F_Slim_Wrist/mjcf/assets/wrist_wrist_horn_arm_motor2_placed.stl

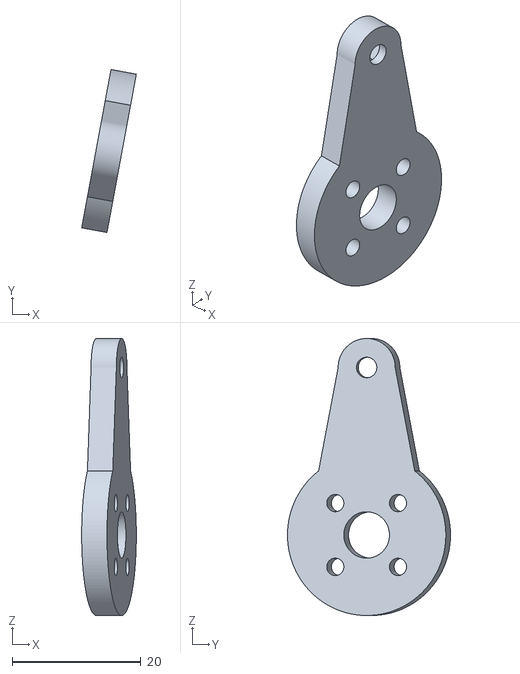
[picture p126: CAD file, 2026-10-15]
Demo/AHSimulation/AHSimulation/AH_Right_5F_Slim_Wrist/mjcf/assets/wrist_wrist_horn_arm_motor2_placed.stl
8.49 x 25.3 x 43.0
