molinzhao27/AmazingHand/cad/five_finger/mockup/stl/Ball_D5.8.stl

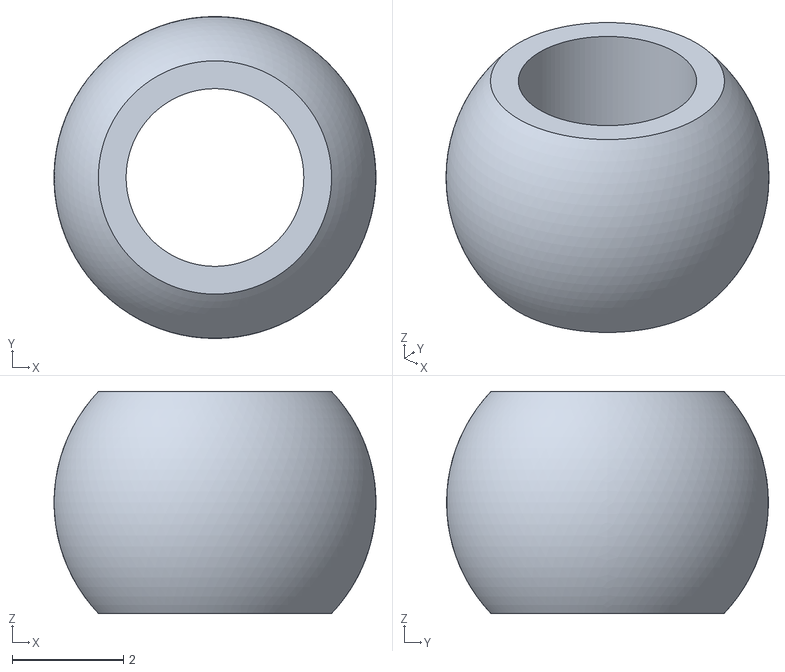
[picture p127: CAD file, 2026-10-18]
cad/five_finger/mockup/stl/Ball_D5.8.stl
5.80 x 5.80 x 4.00
