molinzhao27/AmazingHand/cad/five_finger/slim_fingers/step/Distal_Shell_Slim.step

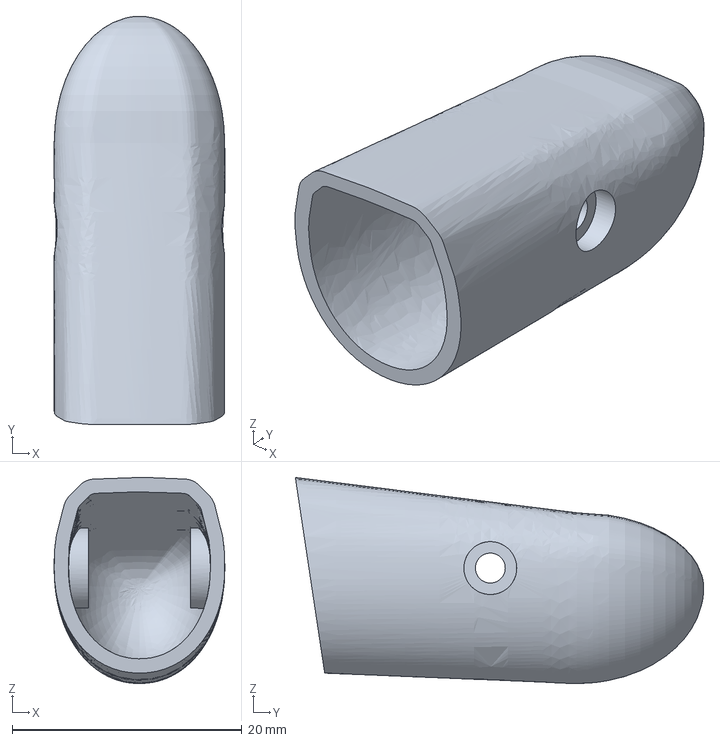
[picture p128: CAD file, 2026-10-14]
cad/five_finger/slim_fingers/step/Distal_Shell_Slim.step
14.8 x 35.5 x 17.9 mm
