molinzhao27/AmazingHand/cad/five_finger/stl/R-Palm_Pad_Palm_5F.stl

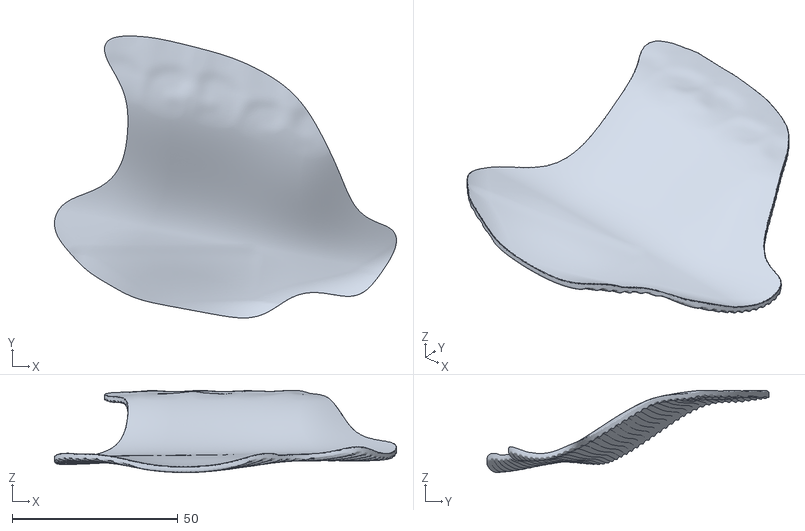
[picture p129: CAD file, 2026-10-15]
cad/five_finger/stl/R-Palm_Pad_Palm_5F.stl
103.1 x 85.0 x 24.8
