molinzhao27/AmazingHand/cad/five_finger/three_segment/step/P2_Middle_3S.step

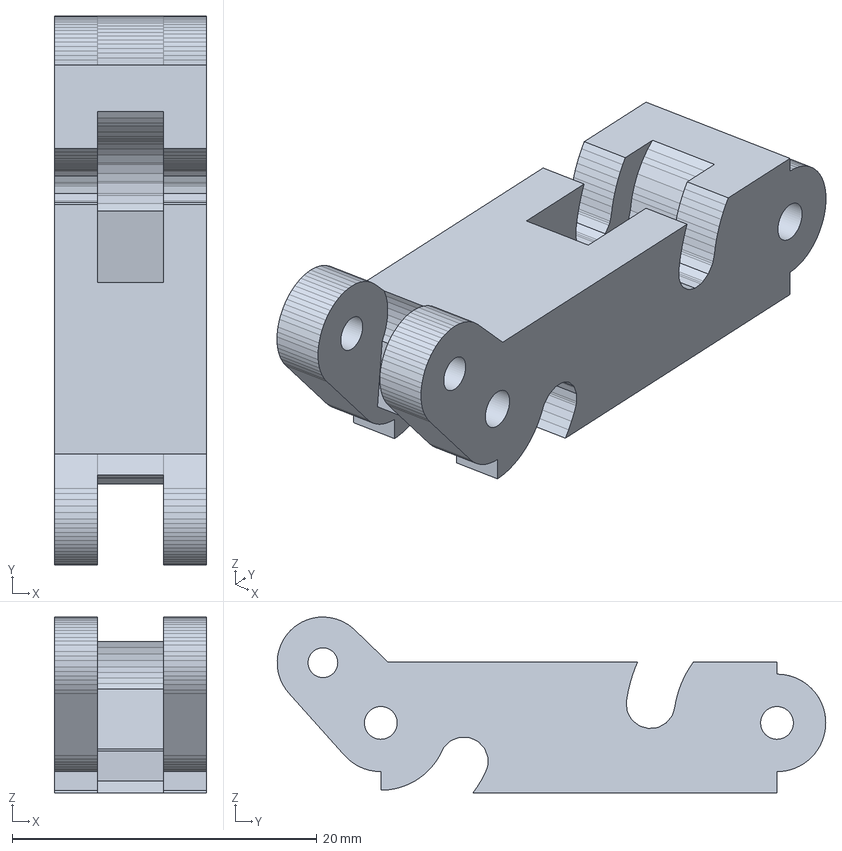
[picture p130: CAD file, 2026-10-13]
cad/five_finger/three_segment/step/P2_Middle_3S.step
10.0 x 36.0 x 11.6 mm
