molinzhao27/AmazingHand/cad/five_finger/three_segment/stl/palm_shells/R-Palm_Shell_5F.stl

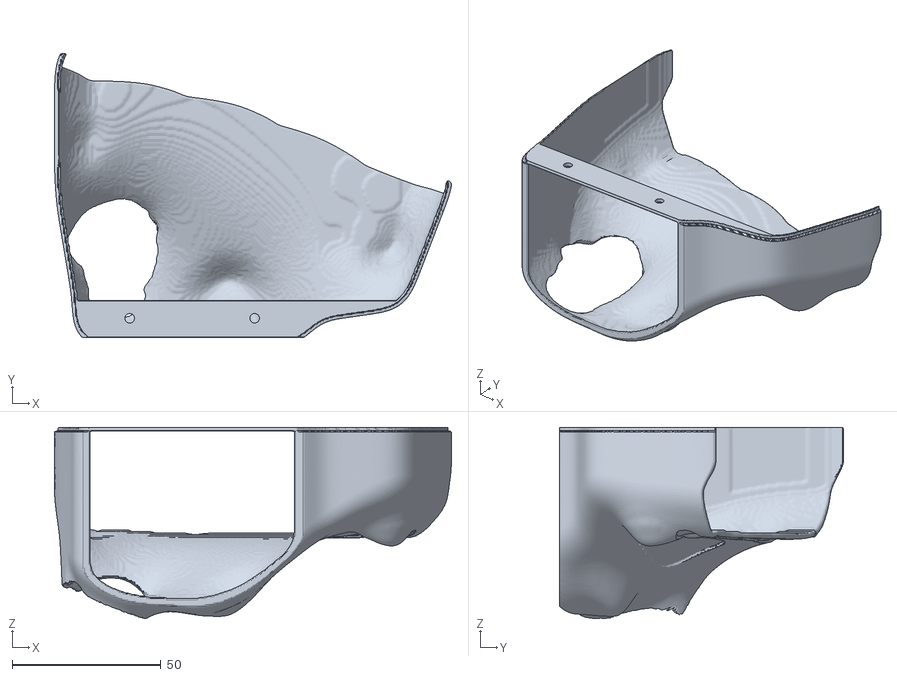
[picture p131: CAD file, 2026-10-13]
cad/five_finger/three_segment/stl/palm_shells/R-Palm_Shell_5F.stl
133.5 x 95.6 x 64.4
