molinzhao27/AmazingHand/cad/five_finger/ultimate_finger/stl/UF_P3_Shell.stl

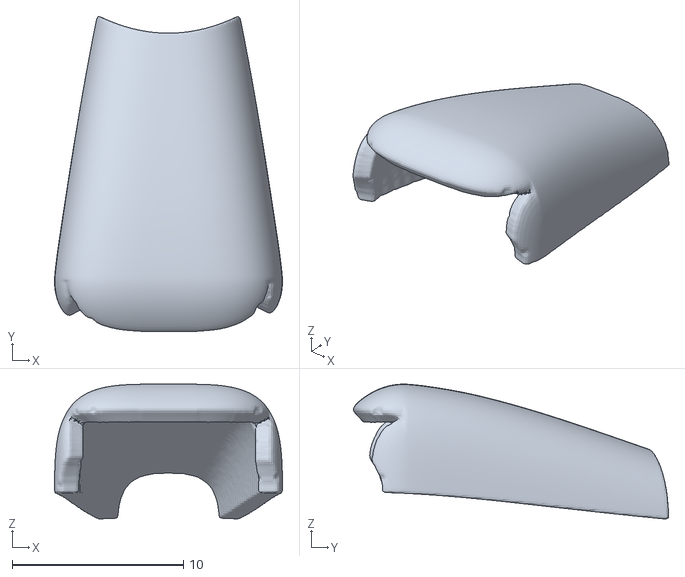
[picture p132: CAD file, 2026-10-14]
cad/five_finger/ultimate_finger/stl/UF_P3_Shell.stl
13.3 x 18.4 x 7.88
