molinzhao27/AmazingHand/Demo/AHSimulation/AHSimulation/AH_Right_5F_3S_Wrist/mjcf/assets/wrist_sts3215_motor1.stl

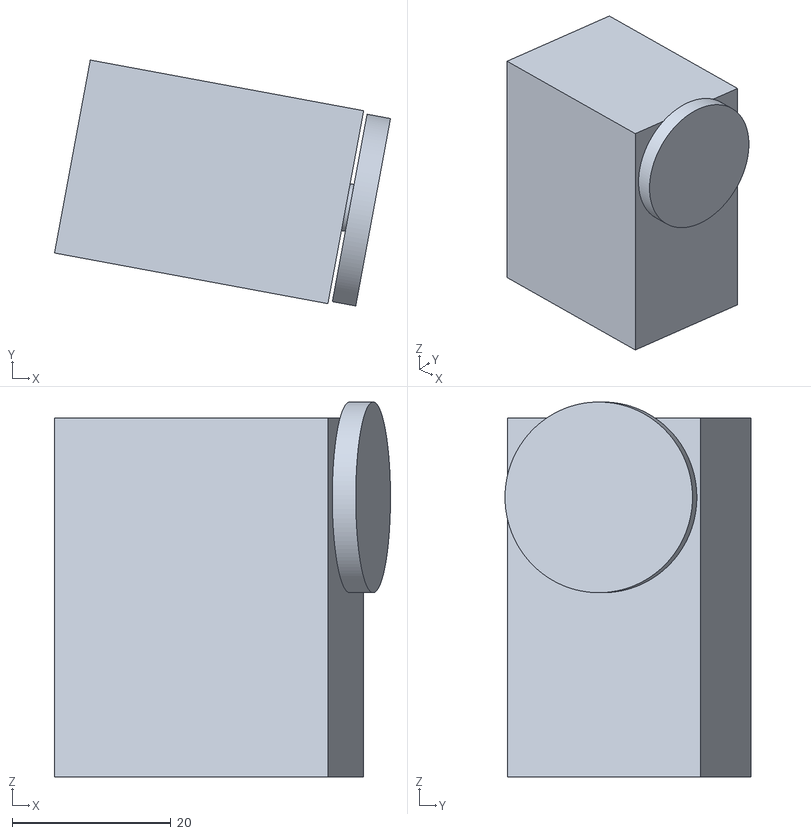
[picture p133: CAD file, 2026-10-15]
Demo/AHSimulation/AHSimulation/AH_Right_5F_3S_Wrist/mjcf/assets/wrist_sts3215_motor1.stl
42.3 x 31.0 x 47.2
