molinzhao27/AmazingHand/Demo/AHSimulation/AHSimulation/AH_Right_5F_Slim_Wrist/mjcf/assets/wrist_elbow_flange.stl

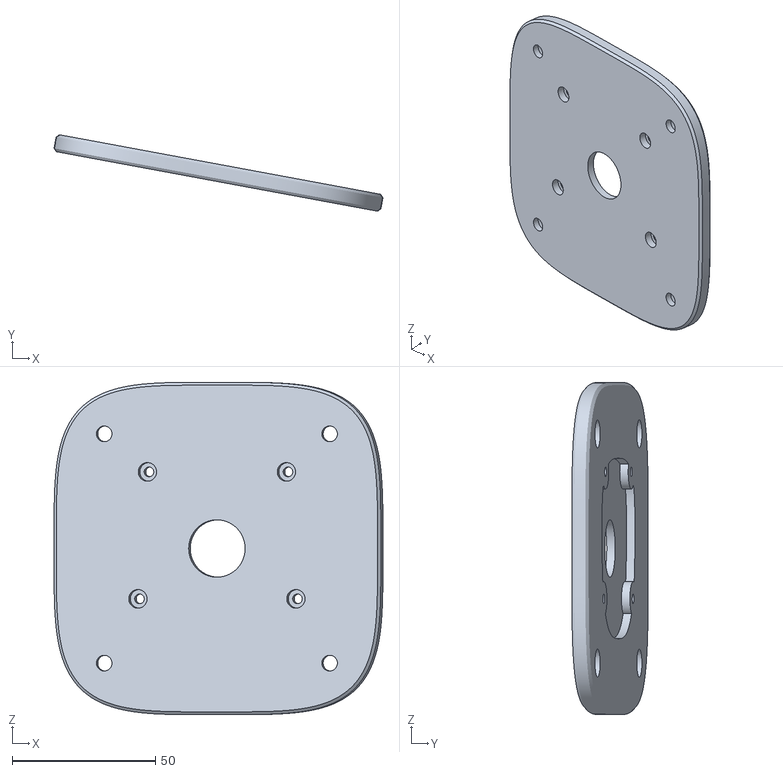
[picture p134: CAD file, 2026-10-15]
Demo/AHSimulation/AHSimulation/AH_Right_5F_Slim_Wrist/mjcf/assets/wrist_elbow_flange.stl
114.8 x 26.7 x 116.0
