molinzhao27/AmazingHand/Demo/AHSimulation/AHSimulation/AH_Right_5F_Wrist/mjcf/assets/wrist_stud_top_2.stl

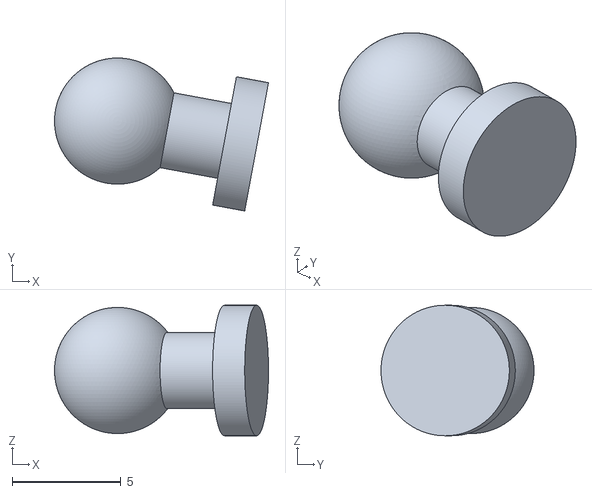
[picture p135: CAD file, 2026-10-15]
Demo/AHSimulation/AHSimulation/AH_Right_5F_Wrist/mjcf/assets/wrist_stud_top_2.stl
9.84 x 7.03 x 6.00
