molinzhao27/AmazingHand/cad/five_finger/fingers/step/Distal_Shell_Styled.step

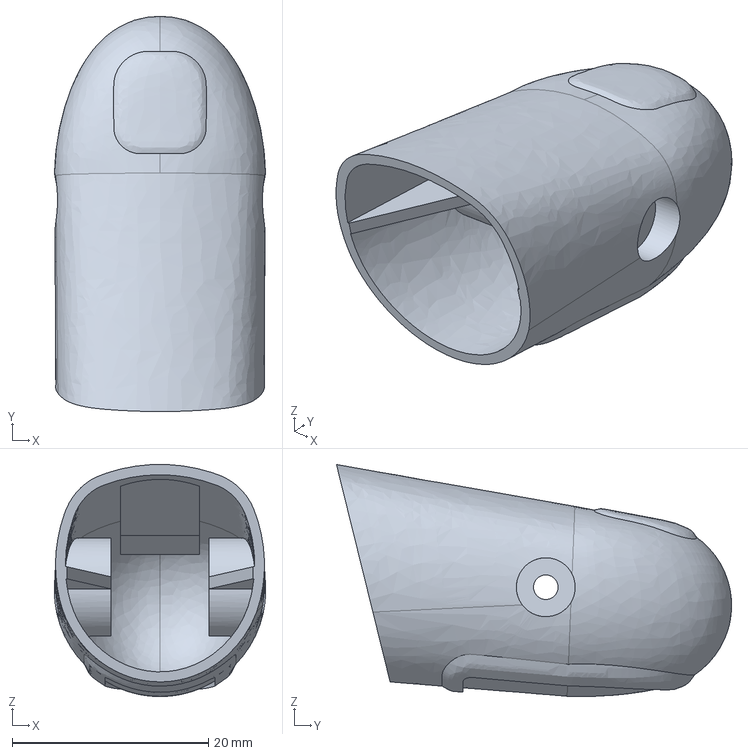
[picture p136: CAD file, 2026-10-14]
cad/five_finger/fingers/step/Distal_Shell_Styled.step
21.5 x 40.3 x 23.6 mm
