molinzhao27/AmazingHand/cad/five_finger/mockup/stl/Mock_Horn.stl

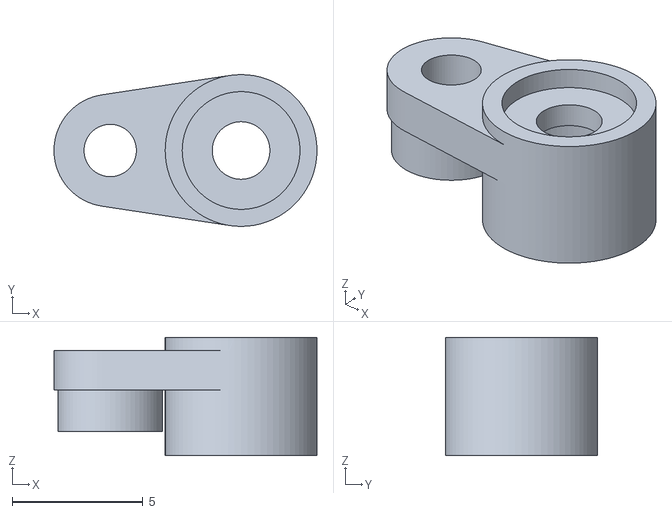
[picture p137: CAD file, 2026-10-18]
cad/five_finger/mockup/stl/Mock_Horn.stl
10.0 x 5.80 x 4.51
