molinzhao27/AmazingHand/cad/five_finger/mockup/stl/test/Fit_Ball_Wrist_Post.stl

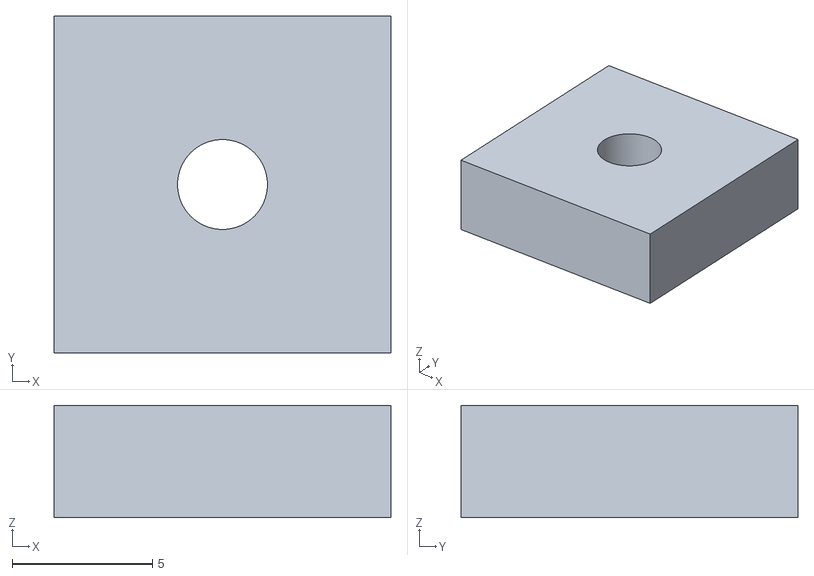
[picture p138: CAD file, 2026-10-18]
cad/five_finger/mockup/stl/test/Fit_Ball_Wrist_Post.stl
12.0 x 12.0 x 4.00
