molinzhao27/AmazingHand/cad/five_finger/slim_fingers/step/Proximal_Slim.step

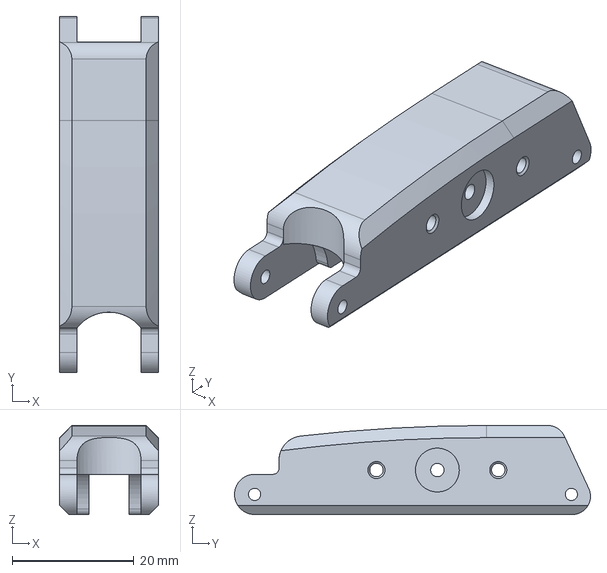
[picture p139: CAD file, 2026-10-14]
cad/five_finger/slim_fingers/step/Proximal_Slim.step
16.2 x 58.4 x 14.6 mm
