molinzhao27/AmazingHand/cad/five_finger/stl/L-Top_Shell_5F.stl

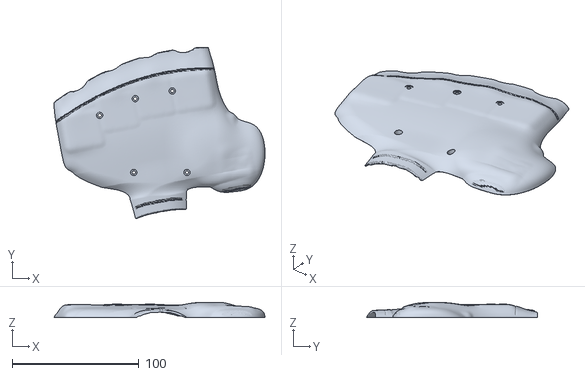
[picture p140: CAD file, 2026-10-15]
cad/five_finger/stl/L-Top_Shell_5F.stl
166.7 x 135.4 x 12.1
