molinzhao27/AmazingHand/cad/five_finger/three_segment/step/P2_Pad_3S.step

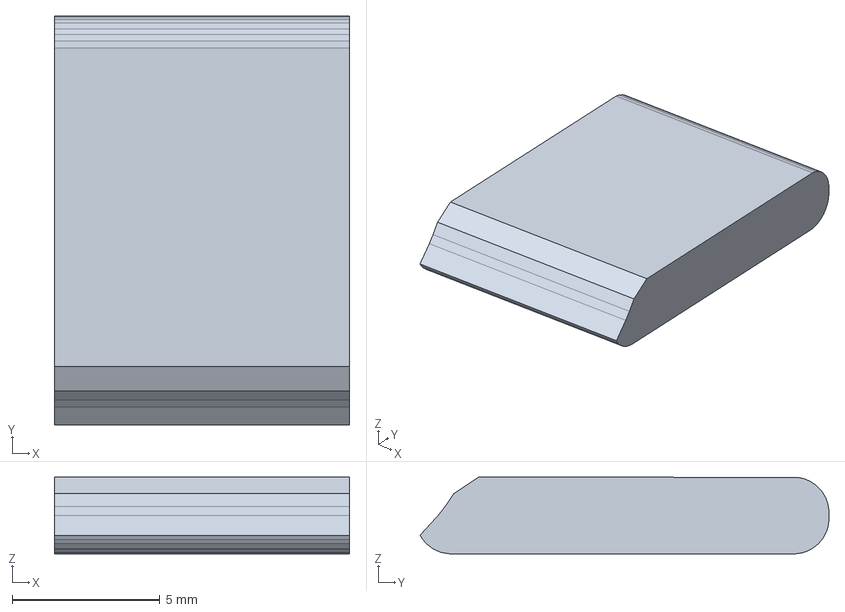
[picture p141: CAD file, 2026-10-13]
cad/five_finger/three_segment/step/P2_Pad_3S.step
10.0 x 13.9 x 2.60 mm
