molinzhao27/AmazingHand/cad/five_finger/ultimate_finger/step/pin_2x16_MCP_S088.step

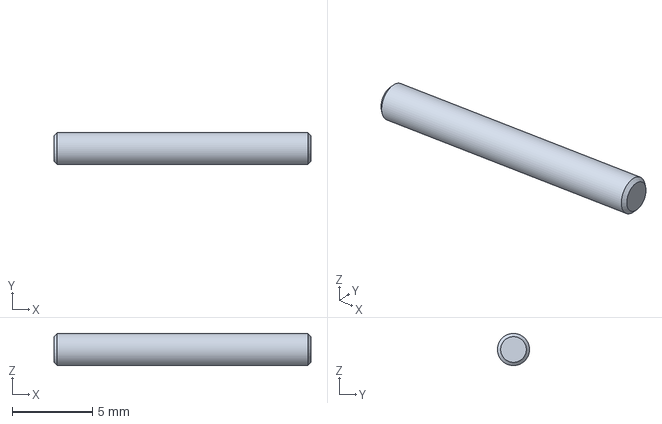
[picture p142: CAD file, 2026-10-14]
cad/five_finger/ultimate_finger/step/pin_2x16_MCP_S088.step
16.0 x 2.00 x 2.00 mm
