molinzhao27/AmazingHand/cad/five_finger/ultimate_finger/stl/UF_P1_Pad.stl

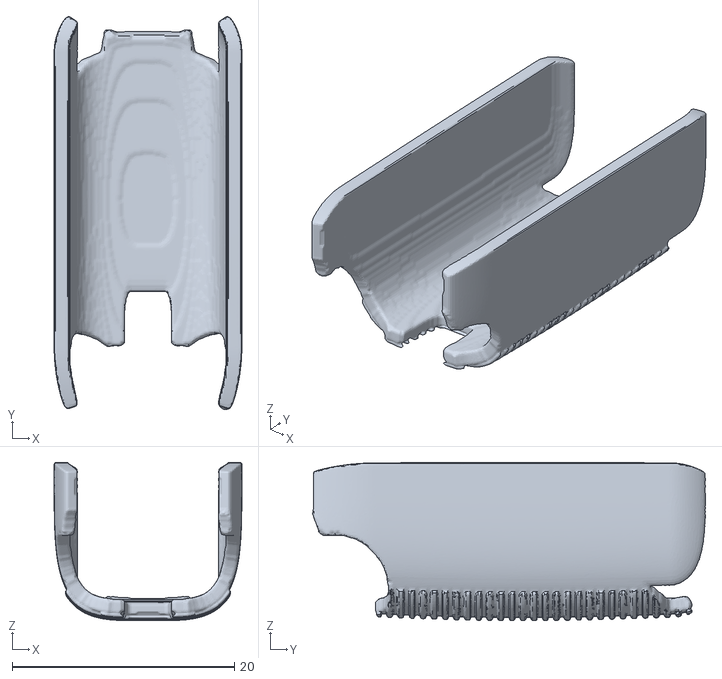
[picture p143: CAD file, 2026-10-14]
cad/five_finger/ultimate_finger/stl/UF_P1_Pad.stl
16.9 x 35.4 x 14.3
