molinzhao27/AmazingHand/cad/five_finger/wrist/step/R-Wrist_Servo_Frame.step

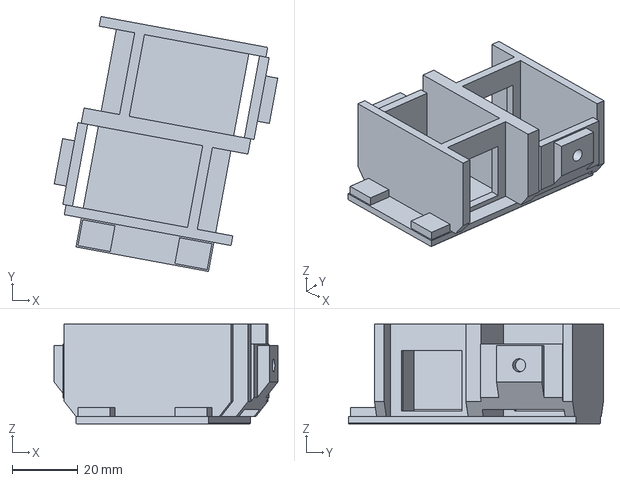
[picture p144: CAD file, 2026-10-15]
cad/five_finger/wrist/step/R-Wrist_Servo_Frame.step
68.0 x 77.6 x 30.3 mm
