molinzhao27/AmazingHand/cad/five_finger/wrist/stl/ref/L-Wrist_Hand_Adapter_palm.stl

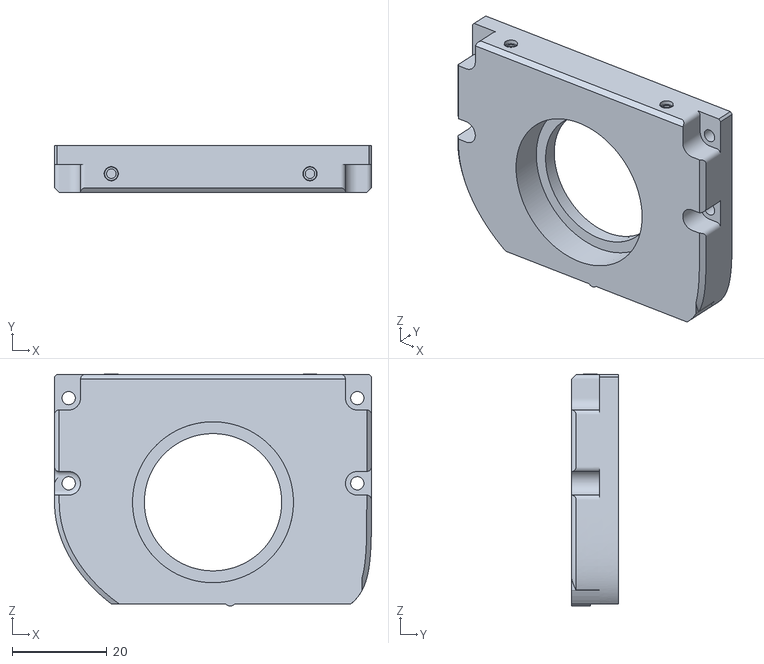
[picture p145: CAD file, 2026-10-15]
cad/five_finger/wrist/stl/ref/L-Wrist_Hand_Adapter_palm.stl
67.0 x 10.0 x 49.0
