molinzhao27/AmazingHand/Demo/AHSimulation/AHSimulation/AH_Right_5F_3S_Wrist/mjcf/assets/wrist_rod_2.stl

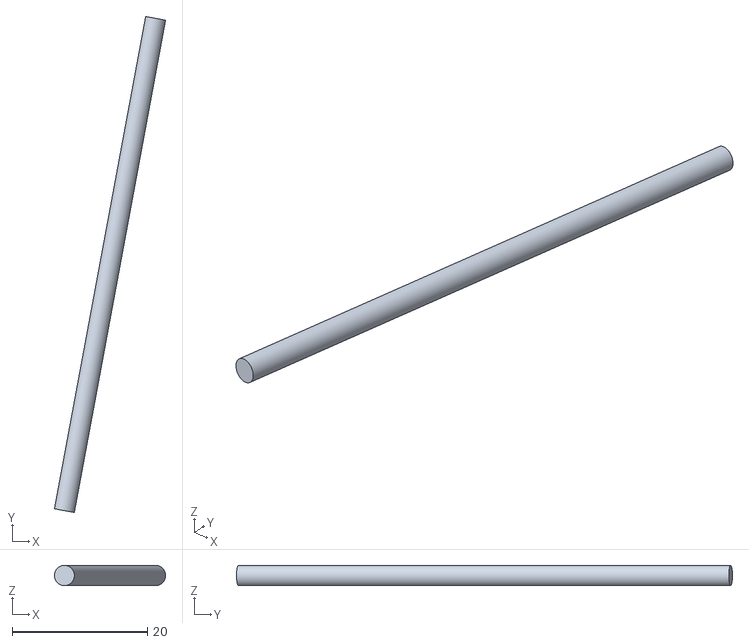
[picture p146: CAD file, 2026-10-15]
Demo/AHSimulation/AHSimulation/AH_Right_5F_3S_Wrist/mjcf/assets/wrist_rod_2.stl
16.4 x 73.3 x 3.00
