molinzhao27/AmazingHand/Demo/AHSimulation/AHSimulation/AH_Right_5F_Wrist/mjcf/assets/wrist_r_wrist_fork.stl

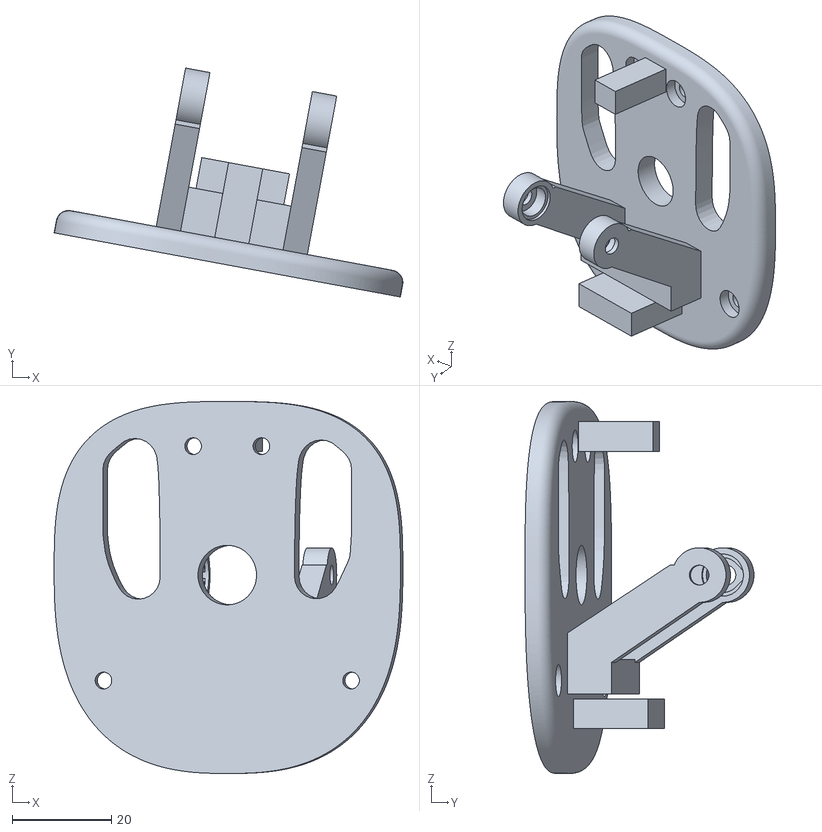
[picture p147: CAD file, 2026-10-15]
Demo/AHSimulation/AHSimulation/AH_Right_5F_Wrist/mjcf/assets/wrist_r_wrist_fork.stl
70.3 x 46.2 x 75.0
