molinzhao27/AmazingHand/cad/five_finger/mockup/stl/test/Fit_Ball_Hand_Ball.stl

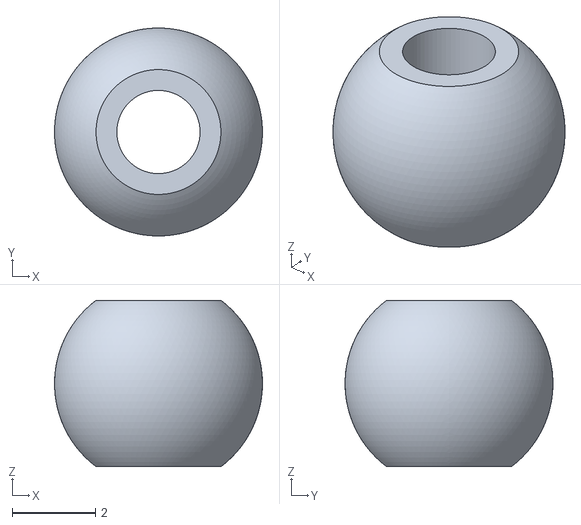
[picture p148: CAD file, 2026-10-18]
cad/five_finger/mockup/stl/test/Fit_Ball_Hand_Ball.stl
5.00 x 5.00 x 4.00
