molinzhao27/AmazingHand/cad/five_finger/slim_fingers/step/Proximal_Shell_Slim.step

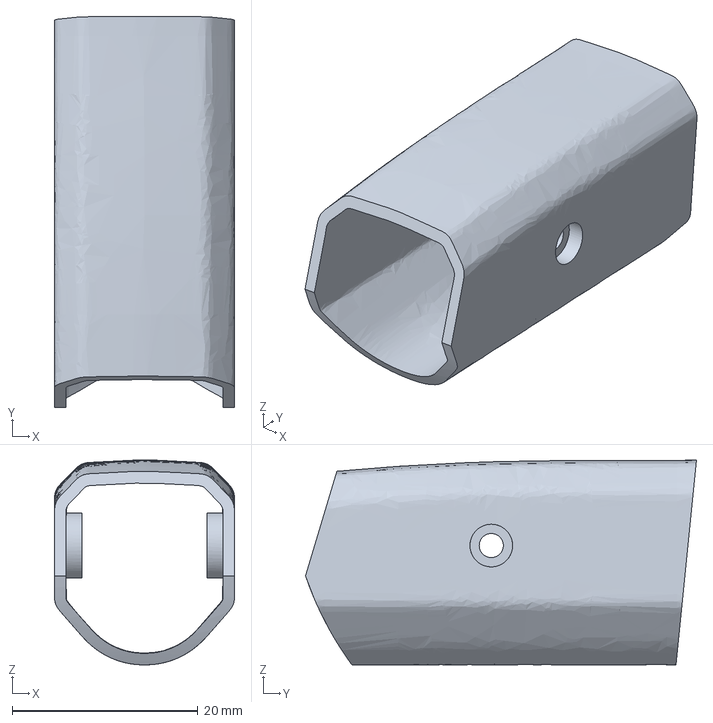
[picture p149: CAD file, 2026-10-14]
cad/five_finger/slim_fingers/step/Proximal_Shell_Slim.step
19.4 x 42.2 x 22.1 mm
