molinzhao27/AmazingHand/cad/five_finger/three_segment/step/L2_Coupler_3S.step

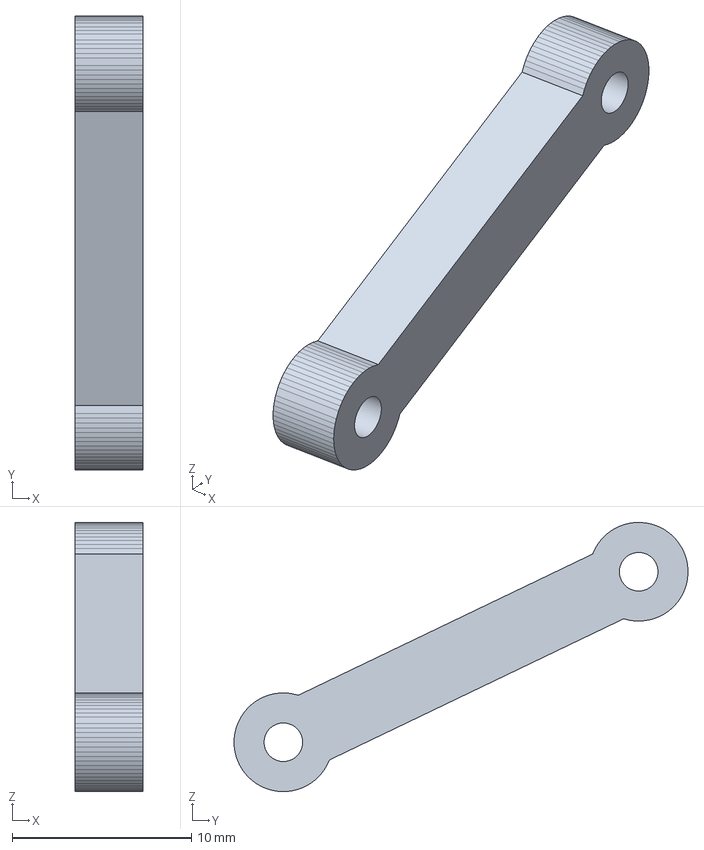
[picture p150: CAD file, 2026-10-13]
cad/five_finger/three_segment/step/L2_Coupler_3S.step
3.80 x 25.3 x 15.0 mm
