molinzhao27/AmazingHand/cad/five_finger/ultimate_finger/stl/Thumb_Proximal_Shell.stl

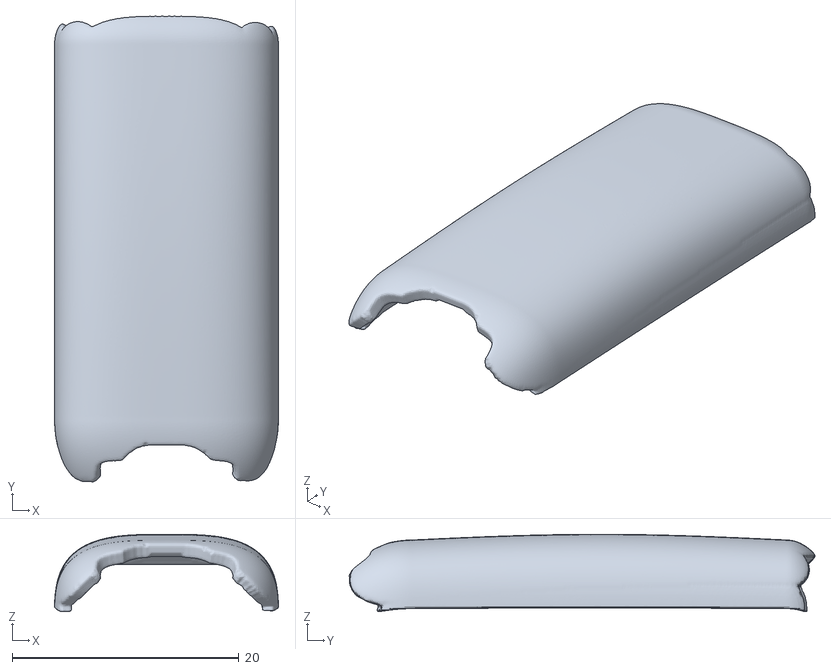
[picture p151: CAD file, 2026-10-14]
cad/five_finger/ultimate_finger/stl/Thumb_Proximal_Shell.stl
19.8 x 41.1 x 6.83
