molinzhao27/AmazingHand/cad/five_finger/wrist/stl/ref/rod_1.stl

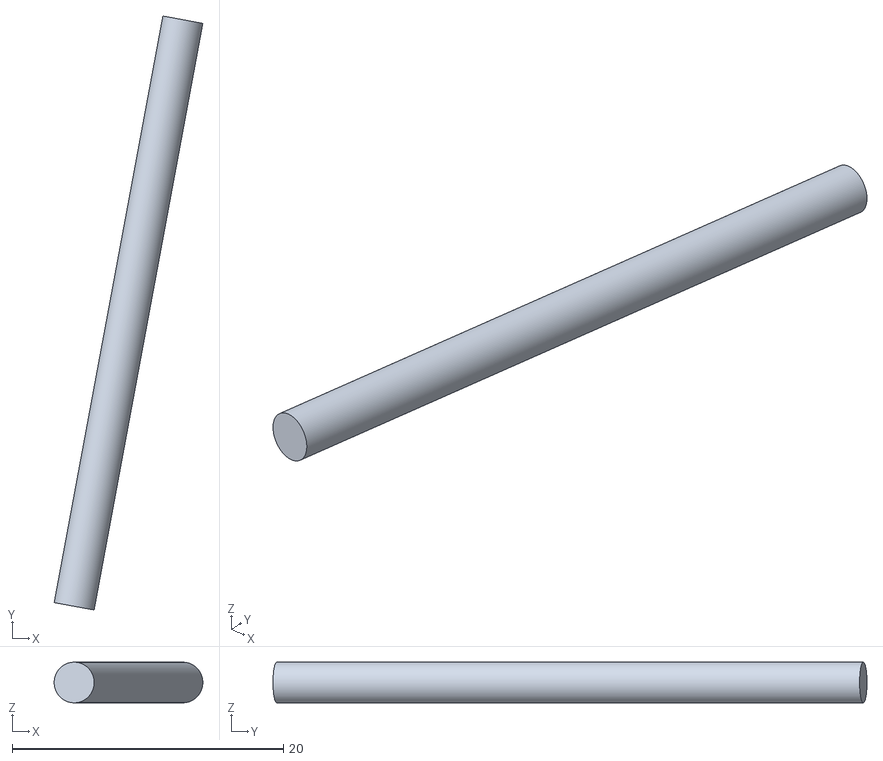
[picture p152: CAD file, 2026-10-15]
cad/five_finger/wrist/stl/ref/rod_1.stl
11.0 x 43.8 x 3.00
