molinzhao27/AmazingHand/Demo/AHSimulation/AHSimulation/AH_Right_5F_Slim_Wrist/mjcf/assets/wrist_r_wrist_hand_adapter_neck.stl

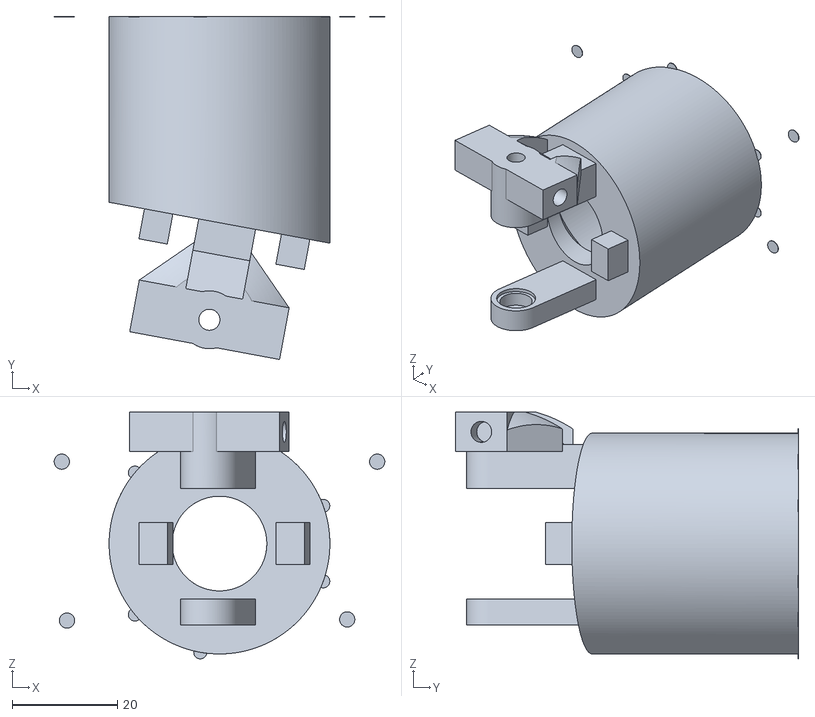
[picture p153: CAD file, 2026-10-15]
Demo/AHSimulation/AHSimulation/AH_Right_5F_Slim_Wrist/mjcf/assets/wrist_r_wrist_hand_adapter_neck.stl
62.9 x 65.2 x 46.9
