molinzhao27/AmazingHand/Demo/AHSimulation/AHSimulation/AH_Right_5F_Wrist/mjcf/assets/wrist_stud_arm_1.stl

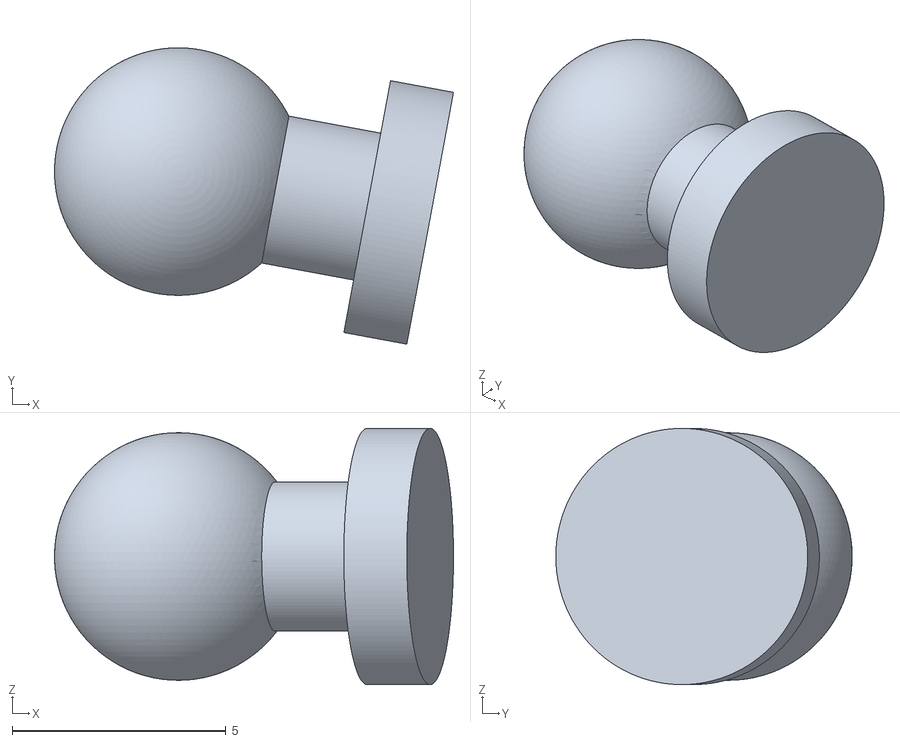
[picture p154: CAD file, 2026-10-15]
Demo/AHSimulation/AHSimulation/AH_Right_5F_Wrist/mjcf/assets/wrist_stud_arm_1.stl
9.34 x 6.94 x 6.00
