molinzhao27/AmazingHand/cad/five_finger/three_segment/step/P3_Shell_3S.step

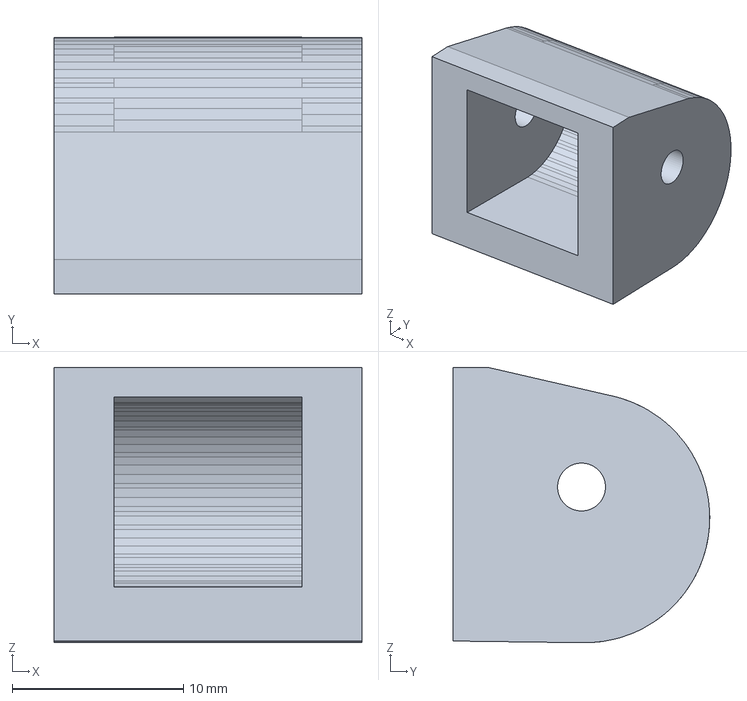
[picture p155: CAD file, 2026-10-13]
cad/five_finger/three_segment/step/P3_Shell_3S.step
18.0 x 15.0 x 16.1 mm
