molinzhao27/AmazingHand/cad/five_finger/ultimate_finger/step/pin_2x8_B.step

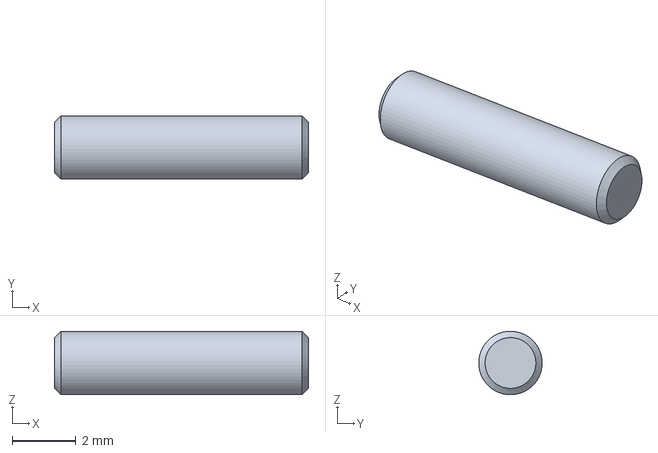
[picture p156: CAD file, 2026-10-14]
cad/five_finger/ultimate_finger/step/pin_2x8_B.step
8.00 x 2.00 x 2.00 mm
