molinzhao27/AmazingHand/cad/five_finger/ultimate_finger/stl/UF_P3_Distal.stl

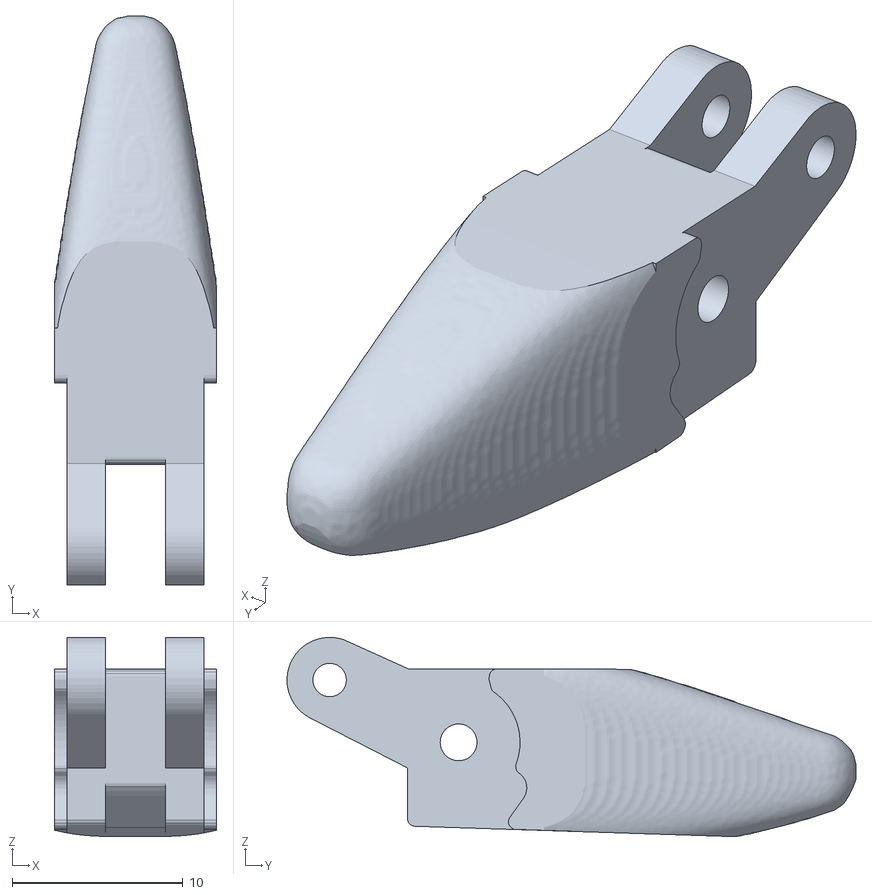
[picture p157: CAD file, 2026-10-14]
cad/five_finger/ultimate_finger/stl/UF_P3_Distal.stl
9.50 x 33.3 x 11.7
