molinzhao27/AmazingHand/Demo/AHSimulation/AHSimulation/AH_Left_5F/mjcf/assets/l_hand_plate.stl

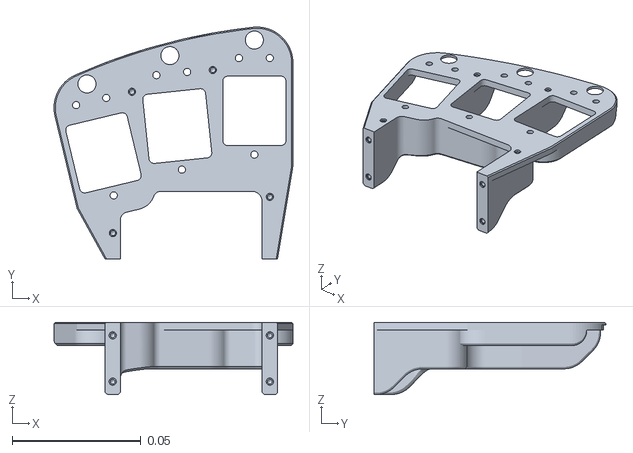
[picture p158: CAD file, 2026-10-13]
Demo/AHSimulation/AHSimulation/AH_Left_5F/mjcf/assets/l_hand_plate.stl
0.0928 x 0.0901 x 0.028
