molinzhao27/AmazingHand/Demo/AHSimulation/AHSimulation/AH_Right_5F_3S/mjcf/assets/thumb_distal_pad.stl

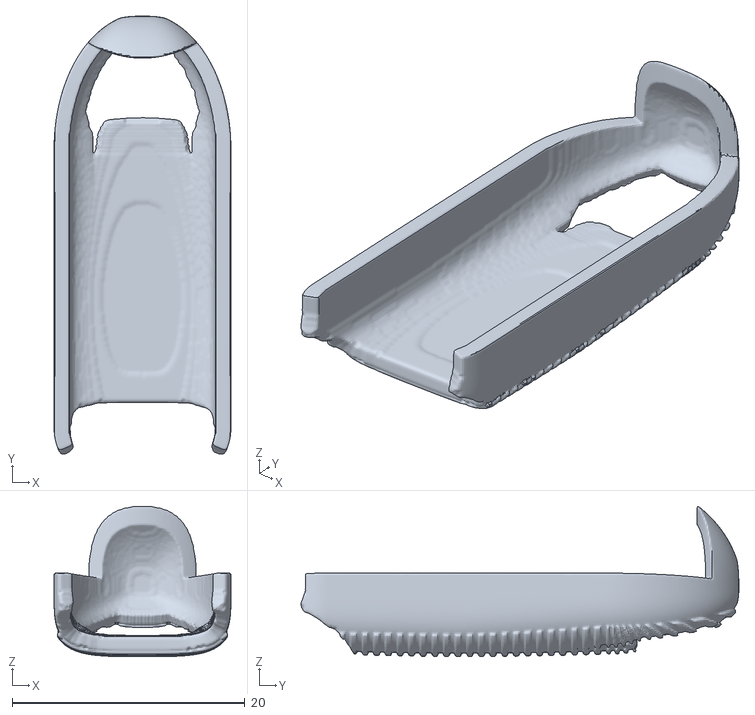
[picture p159: CAD file, 2026-10-14]
Demo/AHSimulation/AHSimulation/AH_Right_5F_3S/mjcf/assets/thumb_distal_pad.stl
15.2 x 37.6 x 12.9
