molinzhao27/AmazingHand/Demo/AHSimulation/AHSimulation/AH_Right_5F_3S_Wrist/mjcf/assets/wrist_pin_d3x10_pz.stl

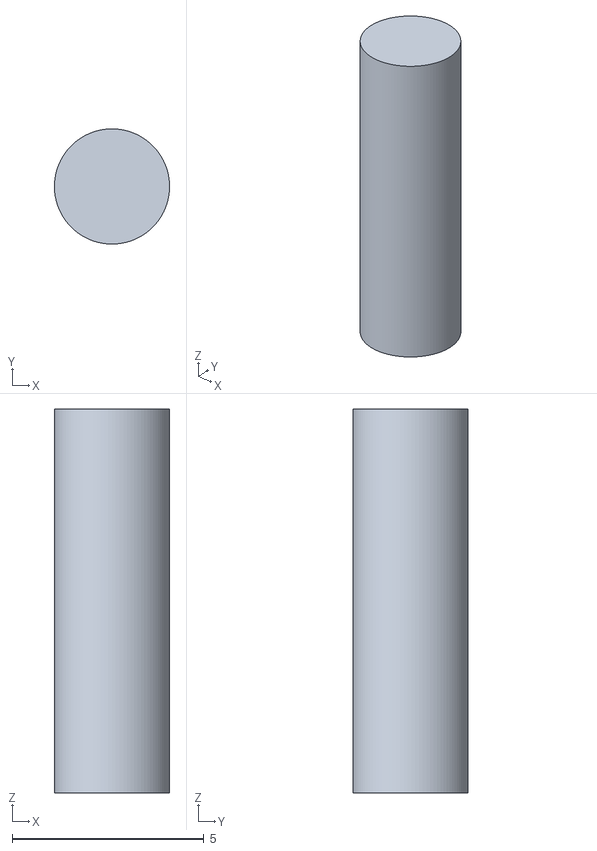
[picture p160: CAD file, 2026-10-15]
Demo/AHSimulation/AHSimulation/AH_Right_5F_3S_Wrist/mjcf/assets/wrist_pin_d3x10_pz.stl
3.00 x 3.00 x 10.0
