molinzhao27/AmazingHand/cad/five_finger/mockup/stl/Rod_middle_M2.stl

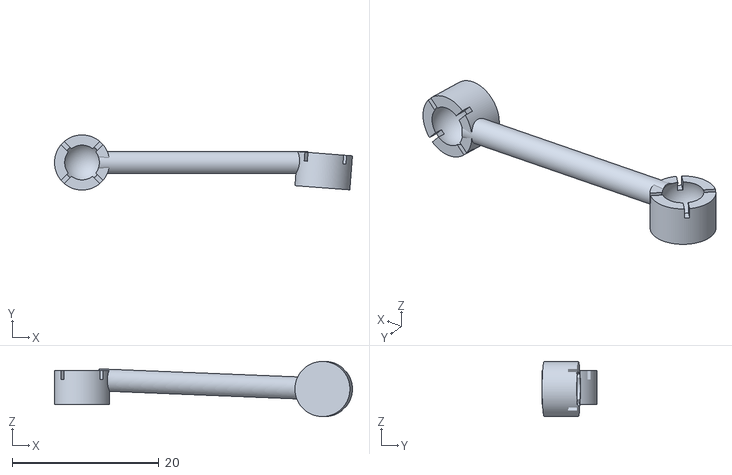
[picture p161: CAD file, 2026-10-17]
cad/five_finger/mockup/stl/Rod_middle_M2.stl
40.6 x 7.50 x 7.50
