molinzhao27/AmazingHand/cad/five_finger/mockup/stl/test/Fit_Pin_D1.90.stl

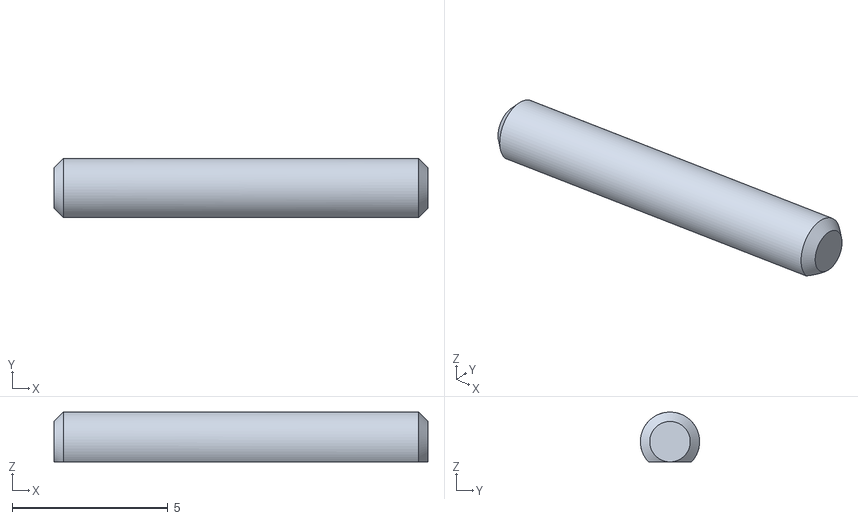
[picture p162: CAD file, 2026-10-17]
cad/five_finger/mockup/stl/test/Fit_Pin_D1.90.stl
12.0 x 1.90 x 1.60
