molinzhao27/AmazingHand/cad/five_finger/three_segment/step/P1_Proximal_3S.step

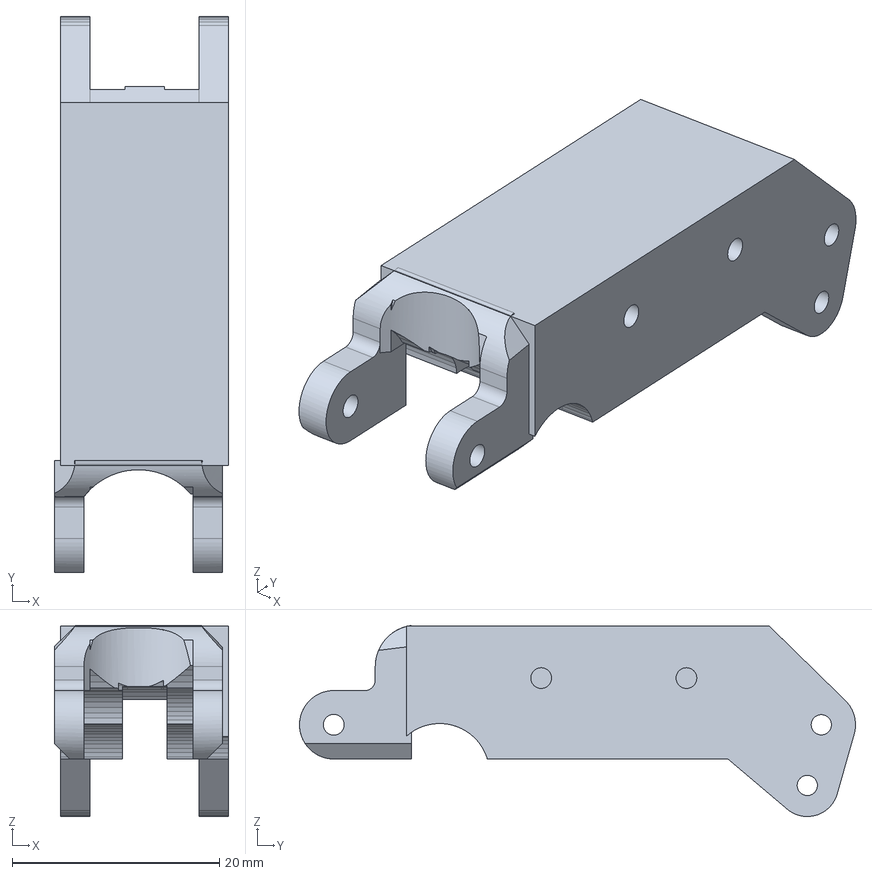
[picture p163: CAD file, 2026-10-13]
cad/five_finger/three_segment/step/P1_Proximal_3S.step
16.8 x 53.6 x 18.4 mm
