molinzhao27/AmazingHand/cad/five_finger/ultimate_finger/stl/UF_P1_Pad_S088.stl

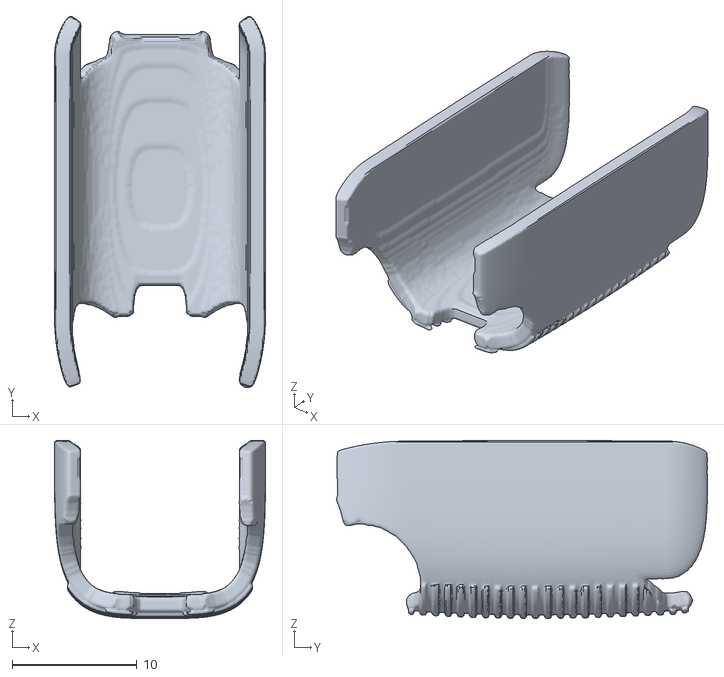
[picture p164: CAD file, 2026-10-14]
cad/five_finger/ultimate_finger/stl/UF_P1_Pad_S088.stl
16.9 x 29.7 x 14.3
