molinzhao27/AmazingHand/Demo/AHSimulation/AHSimulation/AH_Left_5F/mjcf/assets/distal.stl

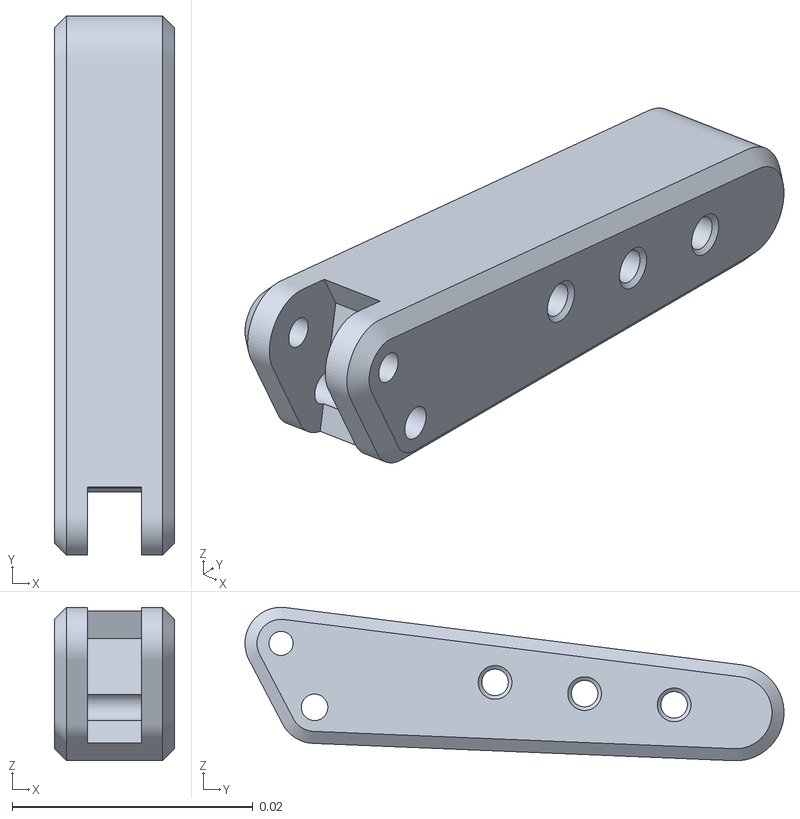
[picture p165: CAD file, 2026-10-13]
Demo/AHSimulation/AHSimulation/AH_Left_5F/mjcf/assets/distal.stl
0.01 x 0.0448 x 0.0127
