molinzhao27/AmazingHand/Demo/AHSimulation/AHSimulation/AH_Right_5F_3S_Wrist/mjcf/assets/wrist_f683zz__x.stl

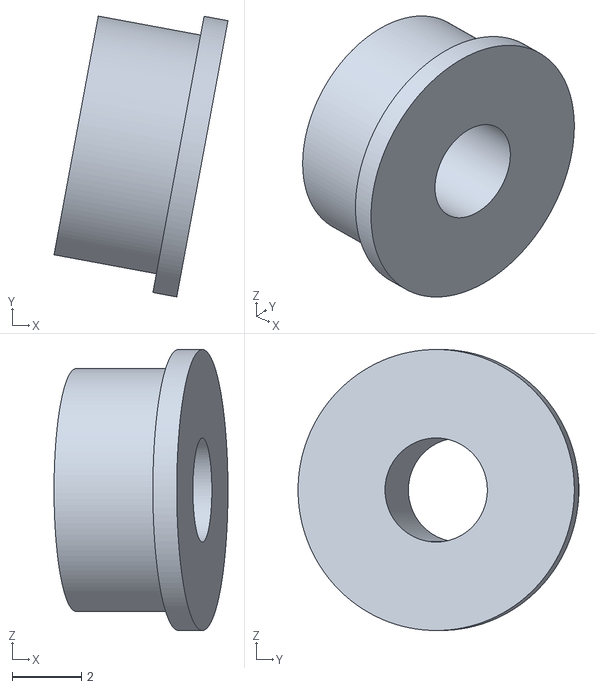
[picture p166: CAD file, 2026-10-15]
Demo/AHSimulation/AHSimulation/AH_Right_5F_3S_Wrist/mjcf/assets/wrist_f683zz__x.stl
5.01 x 8.10 x 8.10
