molinzhao27/AmazingHand/Demo/AHSimulation/AHSimulation/AH_Right_5F_Slim_Wrist/mjcf/assets/wrist_wrist_gimbal_ring.stl

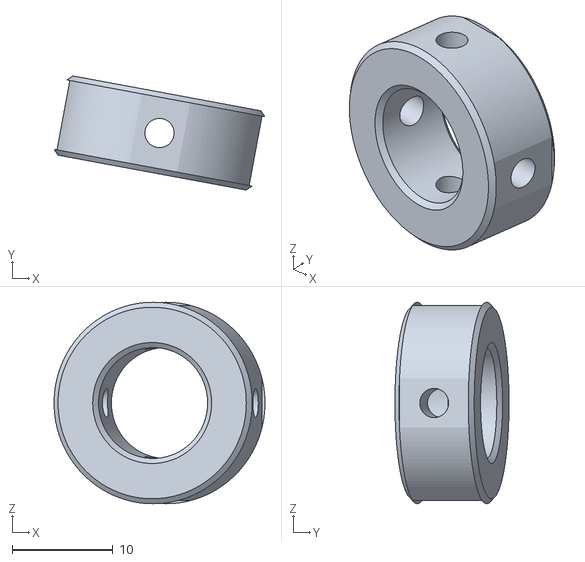
[picture p167: CAD file, 2026-10-15]
Demo/AHSimulation/AHSimulation/AH_Right_5F_Slim_Wrist/mjcf/assets/wrist_wrist_gimbal_ring.stl
20.9 x 11.3 x 20.0
