molinzhao27/AmazingHand/Demo/AHSimulation/AHSimulation/AH_Right_5F_Wrist/mjcf/assets/wrist_f683zz__z.stl

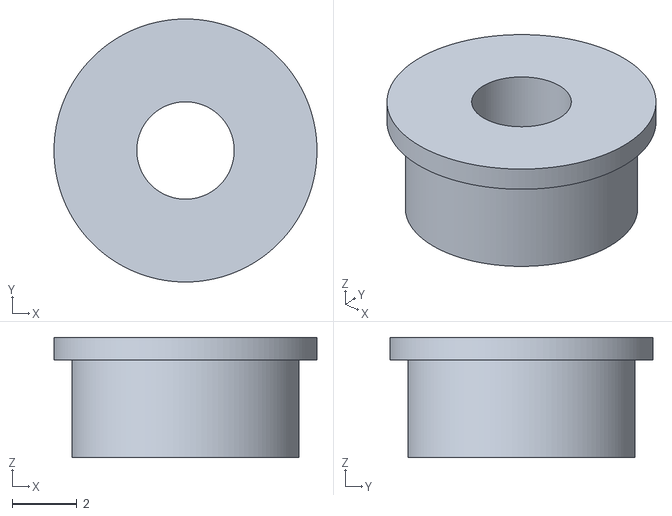
[picture p168: CAD file, 2026-10-15]
Demo/AHSimulation/AHSimulation/AH_Right_5F_Wrist/mjcf/assets/wrist_f683zz__z.stl
8.10 x 8.10 x 3.70
