molinzhao27/AmazingHand/cad/five_finger/mockup/stl/Peg_2.5x6.stl

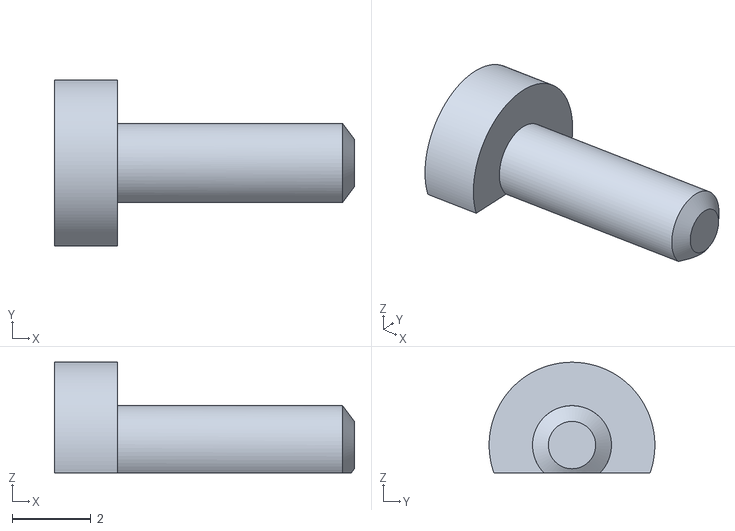
[picture p169: CAD file, 2026-10-17]
cad/five_finger/mockup/stl/Peg_2.5x6.stl
7.60 x 4.20 x 2.80
