molinzhao27/AmazingHand/cad/five_finger/mockup/stl/test/Fit_Axle_D2.10.stl

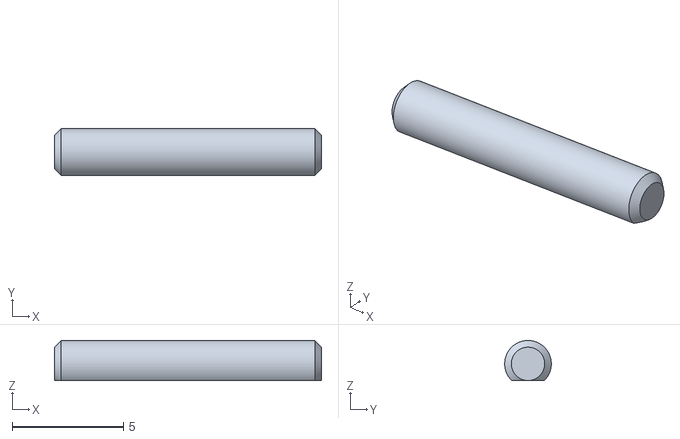
[picture p170: CAD file, 2026-10-17]
cad/five_finger/mockup/stl/test/Fit_Axle_D2.10.stl
12.0 x 2.10 x 1.80
