molinzhao27/AmazingHand/cad/five_finger/three_segment/step/Link_3S.step

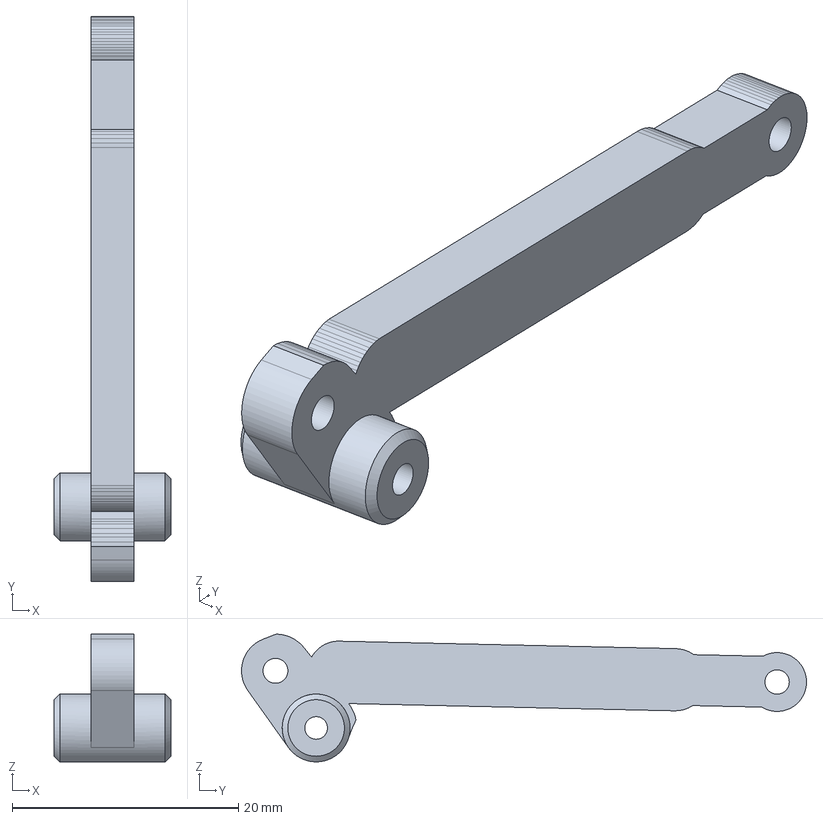
[picture p171: CAD file, 2026-10-13]
cad/five_finger/three_segment/step/Link_3S.step
10.3 x 49.9 x 11.3 mm
