molinzhao27/AmazingHand/cad/five_finger/ultimate_finger/stl/UF_P2_Shell.stl

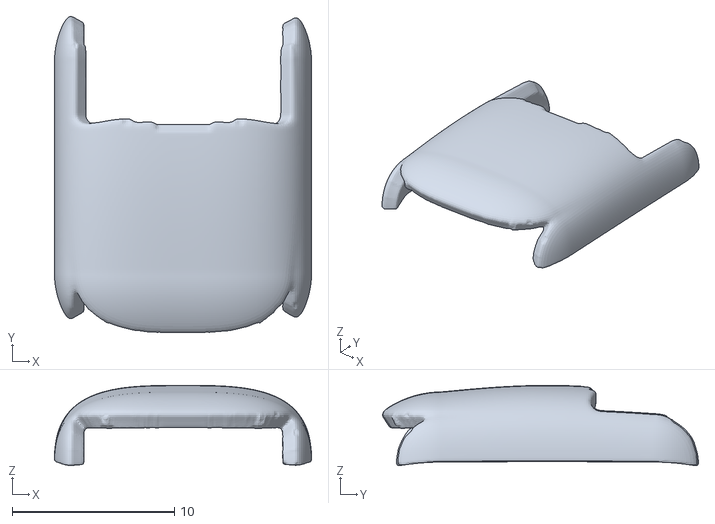
[picture p172: CAD file, 2026-10-14]
cad/five_finger/ultimate_finger/stl/UF_P2_Shell.stl
15.9 x 19.5 x 4.95
