molinzhao27/AmazingHand/Demo/AHSimulation/AHSimulation/AH_Right_5F_3S/mjcf/assets/uf_p2_pad.stl

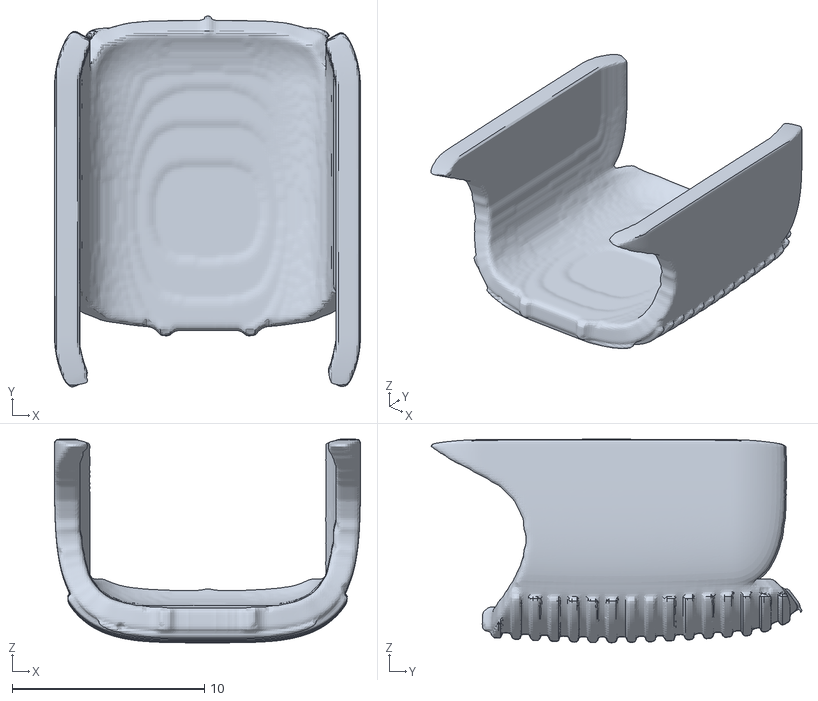
[picture p173: CAD file, 2026-10-14]
Demo/AHSimulation/AHSimulation/AH_Right_5F_3S/mjcf/assets/uf_p2_pad.stl
15.9 x 19.3 x 10.6
