molinzhao27/AmazingHand/cad/five_finger/mockup/stl/Rod_thumb_M1.stl

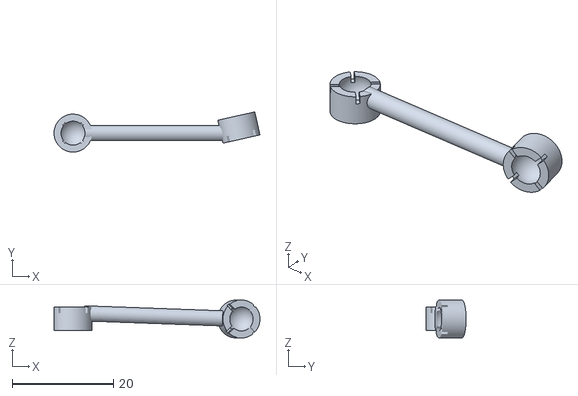
[picture p174: CAD file, 2026-10-17]
cad/five_finger/mockup/stl/Rod_thumb_M1.stl
40.6 x 7.94 x 7.50
