molinzhao27/AmazingHand/cad/five_finger/mockup/stl/test/Fit_Horn_Bore_D4.00.stl

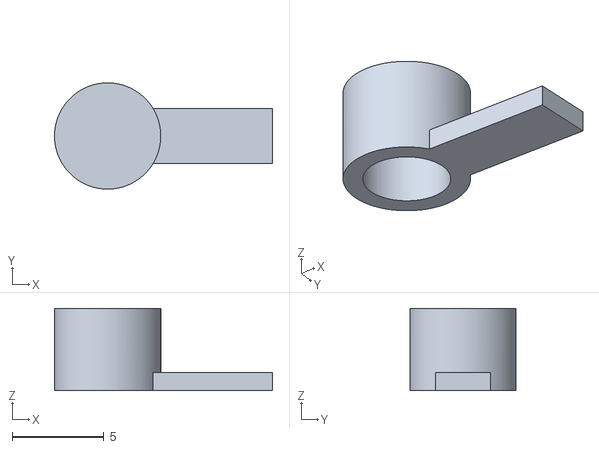
[picture p175: CAD file, 2026-10-17]
cad/five_finger/mockup/stl/test/Fit_Horn_Bore_D4.00.stl
11.9 x 5.80 x 4.50
