molinzhao27/AmazingHand/cad/five_finger/three_segment/step/P1_Shell_3S.step

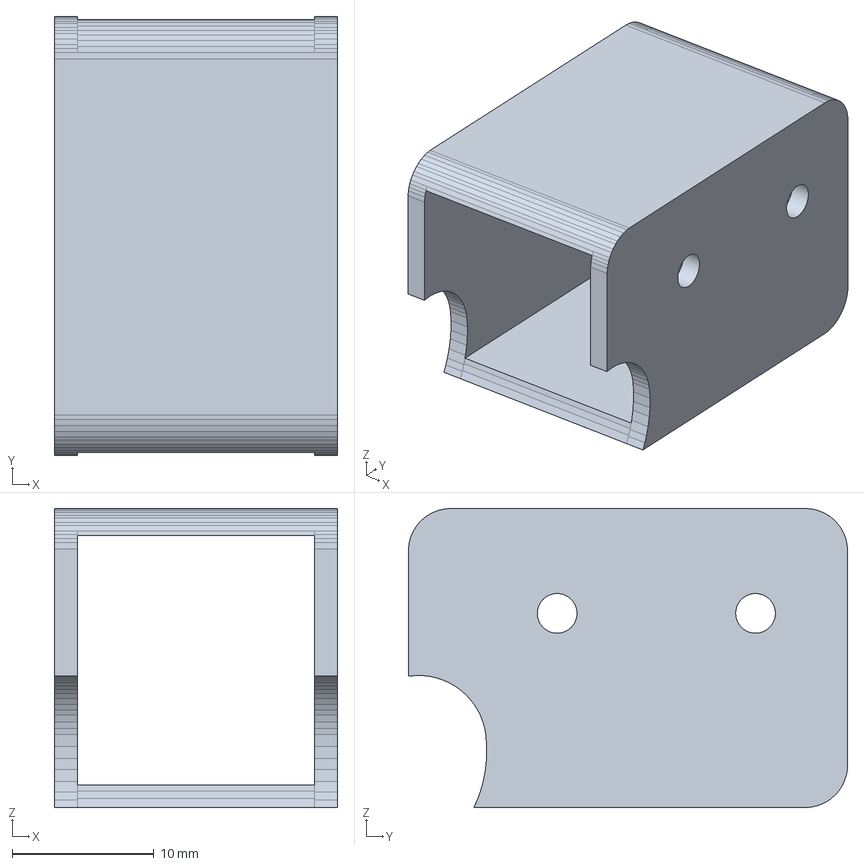
[picture p176: CAD file, 2026-10-13]
cad/five_finger/three_segment/step/P1_Shell_3S.step
20.0 x 31.0 x 21.1 mm
