molinzhao27/AmazingHand/cad/five_finger/ultimate_finger/stl/UF_P1_Shell_S088.stl

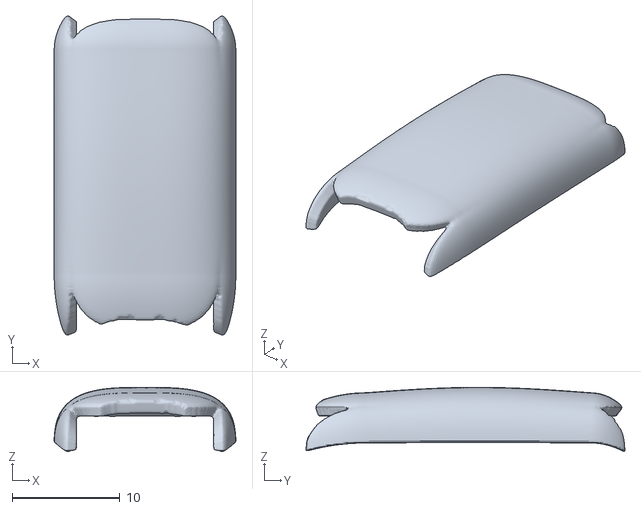
[picture p177: CAD file, 2026-10-14]
cad/five_finger/ultimate_finger/stl/UF_P1_Shell_S088.stl
16.9 x 29.6 x 5.97
