molinzhao27/AmazingHand/Demo/AHSimulation/AHSimulation/AH_Left_5F/mjcf/assets/proximal.stl

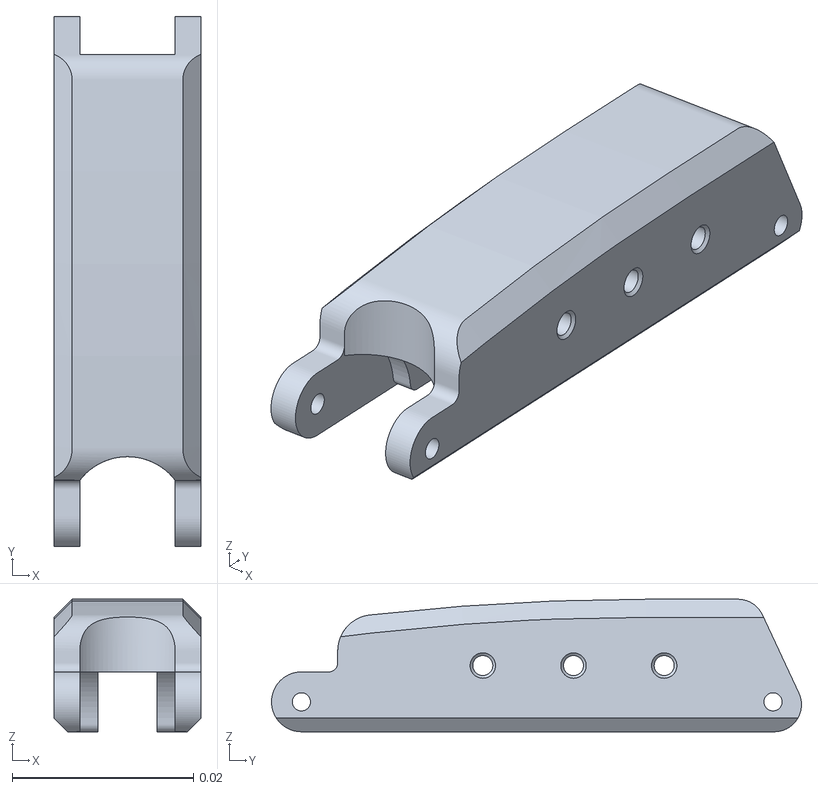
[picture p178: CAD file, 2026-10-13]
Demo/AHSimulation/AHSimulation/AH_Left_5F/mjcf/assets/proximal.stl
0.0162 x 0.0584 x 0.0146
