molinzhao27/AmazingHand/Demo/AHSimulation/AHSimulation/AH_Right_5F_3S/mjcf/assets/ufpk_p2.stl

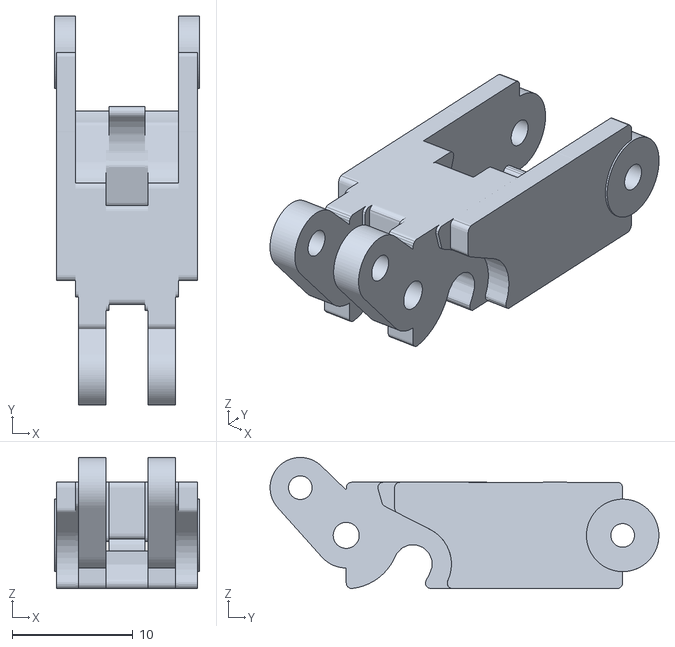
[picture p179: CAD file, 2026-10-14]
Demo/AHSimulation/AHSimulation/AH_Right_5F_3S/mjcf/assets/ufpk_p2.stl
12.0 x 32.2 x 10.8
