molinzhao27/AmazingHand/cad/five_finger/mockup/stl/Pin_D3_L10.stl

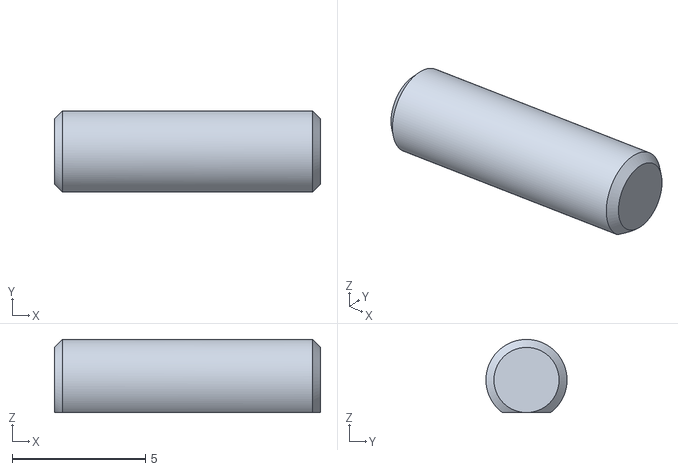
[picture p180: CAD file, 2026-10-17]
cad/five_finger/mockup/stl/Pin_D3_L10.stl
10.0 x 3.05 x 2.75
