molinzhao27/AmazingHand/cad/five_finger/mockup/stl/test/Fit_Cup_Hand_Lip1.2.stl

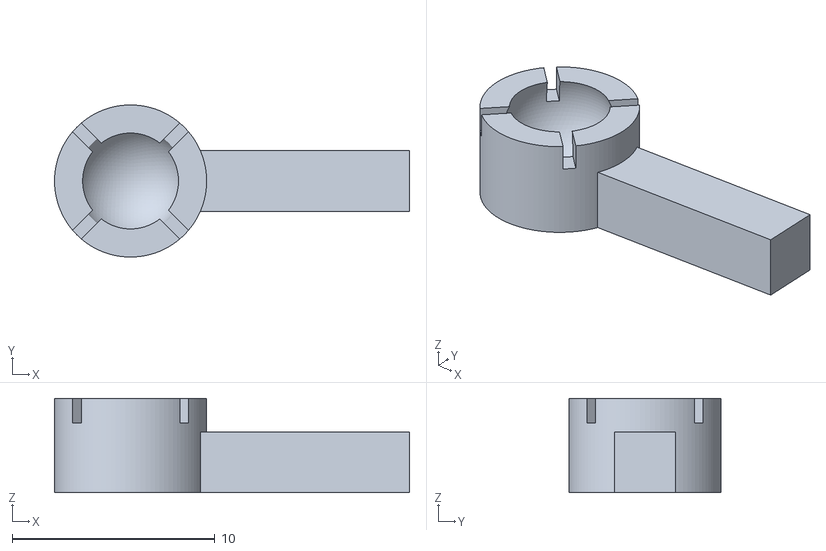
[picture p181: CAD file, 2026-10-17]
cad/five_finger/mockup/stl/test/Fit_Cup_Hand_Lip1.2.stl
17.5 x 7.50 x 4.65
