molinzhao27/AmazingHand/cad/five_finger/ultimate_finger/step/UF_L2_Coupler.step

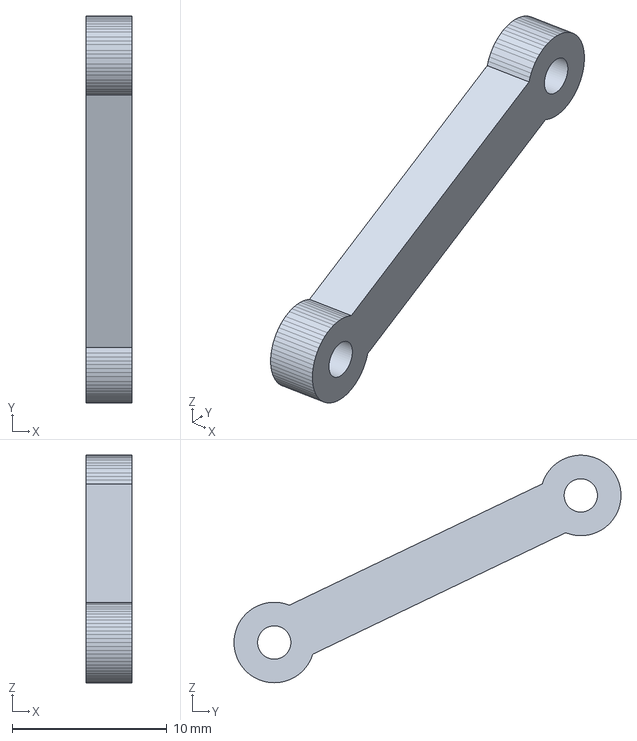
[picture p182: CAD file, 2026-10-14]
cad/five_finger/ultimate_finger/step/UF_L2_Coupler.step
3.00 x 25.0 x 14.7 mm
