molinzhao27/AmazingHand/cad/five_finger/ultimate_finger/stl/UF_P3_Pad_S088.stl

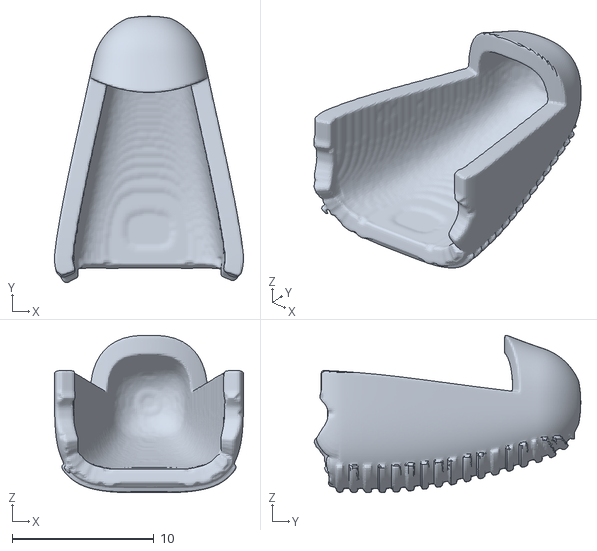
[picture p183: CAD file, 2026-10-14]
cad/five_finger/ultimate_finger/stl/UF_P3_Pad_S088.stl
13.3 x 18.8 x 11.1
