molinzhao27/AmazingHand/Demo/AHSimulation/AHSimulation/AH_Left_5F/mjcf/assets/finger_frame_1.stl

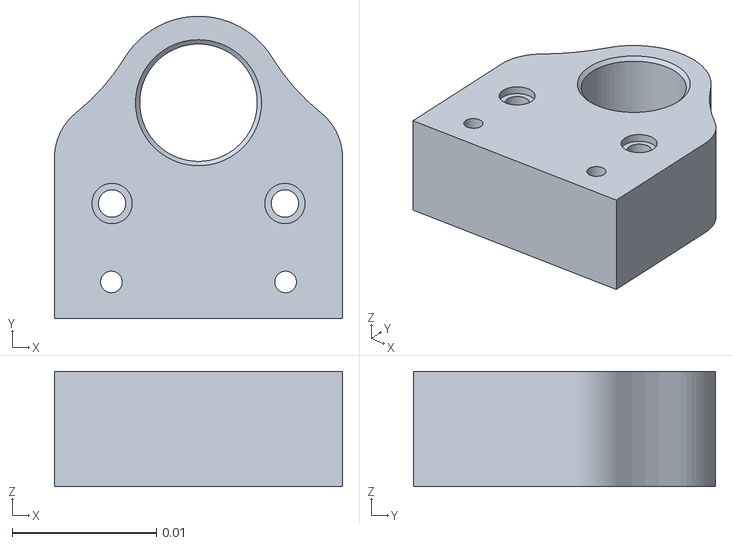
[picture p184: CAD file, 2026-10-13]
Demo/AHSimulation/AHSimulation/AH_Left_5F/mjcf/assets/finger_frame_1.stl
0.02 x 0.021 x 0.008
