molinzhao27/AmazingHand/cad/five_finger/mockup/stl/Rod_middle_M1.stl

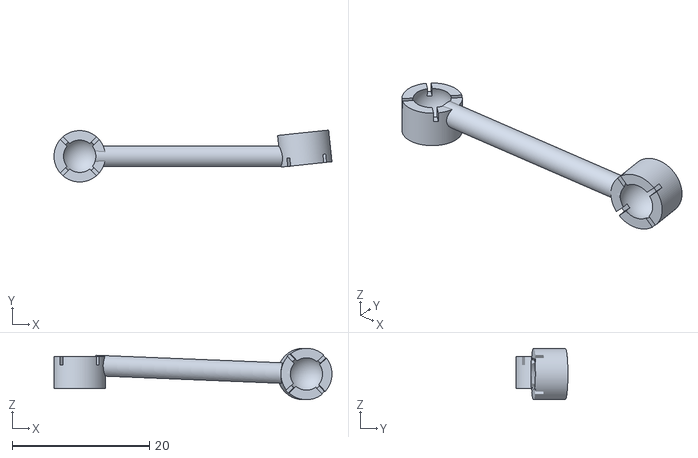
[picture p185: CAD file, 2026-10-17]
cad/five_finger/mockup/stl/Rod_middle_M1.stl
40.6 x 7.58 x 7.50
