molinzhao27/AmazingHand/cad/five_finger/ultimate_finger/step/UF_Link.step

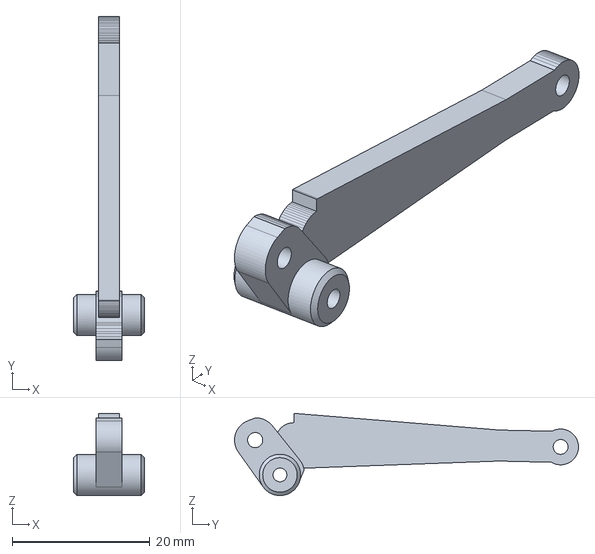
[picture p186: CAD file, 2026-10-14]
cad/five_finger/ultimate_finger/step/UF_Link.step
10.3 x 49.9 x 11.9 mm
