molinzhao27/AmazingHand/(list of files, cad)

Other CAD files:
cad/five_finger/assembly/AH_Right_5F_3S_Wrist_assembly.step
Demo/AHSimulation/AHSimulation/AH_Right_5F/mjcf/assets/r_palm_shell_5f.stl
Demo/AHSimulation/AHSimulation/AH_Right_5F_3S/mjcf/assets/r_palm_shell_5f.stl
Demo/AHSimulation/AHSimulation/AH_Right_5F_3S_Wrist/mjcf/assets/r_wrist_interface.stl
Demo/AHSimulation/AHSimulation/AH_Right_5F_Slim_Wrist/mjcf/assets/r_palm_shell_5f.stl
Demo/AHSimulation/AHSimulation/AH_Right_5F_Wrist/mjcf/assets/r_wrist_interface.stl
cad/five_finger/fingers/stl/print/Distal_Pad_print.stl
cad/five_finger/step/R-Hand_Plate_5F.step
cad/five_finger/stl/R-Palm_Shell_5F.stl
Demo/AHSimulation/AHSimulation/AH_Right_5F/mjcf/assets/r_wrist_interface.stl
Demo/AHSimulation/AHSimulation/AH_Right_5F_3S/mjcf/assets/r_wrist_interface.stl
Demo/AHSimulation/AHSimulation/AH_Right_5F_3S_Wrist/mjcf/assets/r_palm_shell_5f.stl
Demo/AHSimulation/AHSimulation/AH_Right_5F_Wrist/mjcf/assets/r_palm_shell_5f.stl
cad/five_finger/fingers/step/Proximal_Pad.step
cad/five_finger/ultimate_finger/step/pin_2x12_PIP_S088.step
cad/five_finger/wrist/step/L-Forearm_Front.step
cad/five_finger/wrist/stl/ref/link_bot_2.stl
Demo/AHSimulation/AHSimulation/AH_Left_5F/mjcf/assets/l_hand_plate_5f.stl
Demo/AHSimulation/AHSimulation/AH_Right_5F/mjcf/assets/r_hand_plate_5f.stl
Demo/AHSimulation/AHSimulation/AH_Right_5F_3S/mjcf/assets/r_hand_plate_5f.stl
Demo/AHSimulation/AHSimulation/AH_Left_5F/mjcf/assets/l_palm_pad_palm_5f.stl
Demo/AHSimulation/AHSimulation/AH_Right_5F_Slim_Wrist/mjcf/assets/wrist_wrist_horn_arm.stl
cad/five_finger/stl/L-Palm_Pad_Palm_5F.stl
cad/five_finger/ultimate_finger/step/pin_2x12_A_S088.step
cad/five_finger/wrist/step/L-Wrist_Servo_Frame.step
Demo/AHSimulation/AHSimulation/AH_Right_5F/mjcf/assets/r_top_shell_5f.stl
Demo/AHSimulation/AHSimulation/AH_Right_5F_3S/mjcf/assets/r_top_shell_5f.stl
cad/five_finger/stl/R-Top_Shell_5F.stl
cad/five_finger/wrist/step/Elbow_Flange.step
cad/five_finger/wrist/stl/ref/STS3215_motor2.stl
Demo/AHSimulation/AHSimulation/AH_Right_5F_Wrist/mjcf/assets/wrist_link_bot_1.stl
cad/five_finger/ultimate_finger/step/pin_2x8_P4.step
cad/five_finger/wrist/step/Wrist_Horn_Arm.step
cad/five_finger/ultimate_finger/step/pin_2x8_P4_S088.step
cad/five_finger/wrist/step/R-Wrist_Fork.step
Demo/AHSimulation/AHSimulation/AH_Right_5F_3S_Wrist/mjcf/assets/wrist_link_bot_1.stl
Demo/AHSimulation/AHSimulation/AH_Right_5F_Slim_Wrist/mjcf/assets/wrist_link_bot_1.stl
Demo/AHSimulation/AHSimulation/AH_Right_5F_Wrist/mjcf/assets/wrist_f683zz_pz.stl
cad/five_finger/ultimate_finger/step/pin_2x16_MCP.step
cad/five_finger/wrist/step/Wrist_Gimbal_Ring.step
cad/five_finger/wrist/stl/ref/link_bot_1.stl
cad/five_finger/wrist/step/L-Wrist_Hand_Adapter.step
cad/five_finger/wrist/stl/ref/F683ZZ_+z.stl
Demo/AHSimulation/AHSimulation/AH_Right_5F_Slim_Wrist/mjcf/assets/wrist_pin_d3x10__x.stl
cad/five_finger/mockup/stl/test/Fit_F683_OD7.20.stl
Demo/AHSimulation/AHSimulation/AH_Left_5F/mjcf/assets/bushing_0608_04.stl
Demo/AHSimulation/AHSimulation/AH_Left_5F/mjcf/assets/custom_servo_horn.stl
Demo/AHSimulation/AHSimulation/AH_Left_5F/mjcf/assets/distal_shell.stl
Demo/AHSimulation/AHSimulation/AH_Left_5F/mjcf/assets/finger_frame_2.stl
Demo/AHSimulation/AHSimulation/AH_Left_5F/mjcf/assets/gimbal.stl
Demo/AHSimulation/AHSimulation/AH_Left_5F/mjcf/assets/link.stl
Demo/AHSimulation/AHSimulation/AH_Left_5F/mjcf/assets/m2_rod_l18.stl
Demo/AHSimulation/AHSimulation/AH_Left_5F/mjcf/assets/parallel_pin_2_x_10__fee063fca0c8b40e46bbc4ffff61d999.stl
Demo/AHSimulation/AHSimulation/AH_Left_5F/mjcf/assets/parallel_pin_2_x_16__da4b7ddbe9d803fe3fbc70f2e822b99b.stl
Demo/AHSimulation/AHSimulation/AH_Left_5F/mjcf/assets/ph_pan_head_screw_m2x0_40_x_10__2803432263e518bbd16bccbbef8784ed.stl
Demo/AHSimulation/AHSimulation/AH_Left_5F/mjcf/assets/plain_washer_large_grade_a_m2_5__9a369f0dc77bf9c598cdf3fb468977e5.stl
Demo/AHSimulation/AHSimulation/AH_Left_5F/mjcf/assets/proximal_shell.stl
Demo/AHSimulation/AHSimulation/AH_Left_5F/mjcf/assets/rotule_ball.stl
Demo/AHSimulation/AHSimulation/AH_Left_5F/mjcf/assets/rotule_lever.stl
Demo/AHSimulation/AHSimulation/AH_Left_5F/mjcf/assets/scs0009.stl
Demo/AHSimulation/AHSimulation/AH_Left_5F/mjcf/assets/spacer.stl
Demo/AHSimulation/AHSimulation/AH_Left_5F/mjcf/assets/std00333_plast_tcb_torx_2_5x8__configuration_copy_of_default.stl
Demo/AHSimulation/AHSimulation/AH_Left_5F/mjcf/assets/std00447_thermoplastique_m2_5x6__configuration_default.stl
Demo/AHSimulation/AHSimulation/AH_Right_5F_3S/mjcf/assets/thumb_distal_shell.stl
Demo/AHSimulation/AHSimulation/AH_Right_5F_3S/mjcf/assets/thumb_proximal_pad.stl
Demo/AHSimulation/AHSimulation/AH_Right_5F_3S/mjcf/assets/uf_p2.stl
Demo/AHSimulation/AHSimulation/AH_Right_5F_3S/mjcf/assets/uf_p3_pad.stl
Demo/AHSimulation/AHSimulation/AH_Right_5F_3S/mjcf/assets/ufpk_p2_pad.stl
Demo/AHSimulation/AHSimulation/AH_Right_5F_3S/mjcf/assets/ufpk_p3.stl
Demo/AHSimulation/AHSimulation/AH_Right_5F_3S/mjcf/assets/ufpk_p3_shell.stl
Demo/AHSimulation/AHSimulation/AH_Right_5F_3S_Wrist/mjcf/assets/bushing_0608_04.stl
Demo/AHSimulation/AHSimulation/AH_Right_5F_3S_Wrist/mjcf/assets/custom_servo_horn.stl
Demo/AHSimulation/AHSimulation/AH_Right_5F_3S_Wrist/mjcf/assets/distal_slim.stl
Demo/AHSimulation/AHSimulation/AH_Right_5F_3S_Wrist/mjcf/assets/finger_frame_2.stl
Demo/AHSimulation/AHSimulation/AH_Right_5F_3S_Wrist/mjcf/assets/gimbal.stl
Demo/AHSimulation/AHSimulation/AH_Right_5F_3S_Wrist/mjcf/assets/link.stl
Demo/AHSimulation/AHSimulation/AH_Right_5F_3S_Wrist/mjcf/assets/m2_rod_l18.stl
Demo/AHSimulation/AHSimulation/AH_Right_5F_3S_Wrist/mjcf/assets/parallel_pin_2_x_10__fee063fca0c8b40e46bbc4ffff61d999.stl
Demo/AHSimulation/AHSimulation/AH_Right_5F_3S_Wrist/mjcf/assets/parallel_pin_2_x_16__da4b7ddbe9d803fe3fbc70f2e822b99b.stl
Demo/AHSimulation/AHSimulation/AH_Right_5F_3S_Wrist/mjcf/assets/ph_pan_head_screw_m2x0_40_x_10__2803432263e518bbd16bccbbef8784ed.stl
Demo/AHSimulation/AHSimulation/AH_Right_5F_3S_Wrist/mjcf/assets/plain_washer_large_grade_a_m2_5__9a369f0dc77bf9c598cdf3fb468977e5.stl
Demo/AHSimulation/AHSimulation/AH_Right_5F_3S_Wrist/mjcf/assets/proximal_slim.stl
Demo/AHSimulation/AHSimulation/AH_Right_5F_3S_Wrist/mjcf/assets/r_hand_plate_5f.stl
Demo/AHSimulation/AHSimulation/AH_Right_5F_3S_Wrist/mjcf/assets/r_top_shell_5f.stl
Demo/AHSimulation/AHSimulation/AH_Right_5F_3S_Wrist/mjcf/assets/rotule_ball.stl
Demo/AHSimulation/AHSimulation/AH_Right_5F_3S_Wrist/mjcf/assets/rotule_lever.stl
Demo/AHSimulation/AHSimulation/AH_Right_5F_3S_Wrist/mjcf/assets/scs0009.stl
Demo/AHSimulation/AHSimulation/AH_Right_5F_3S_Wrist/mjcf/assets/spacer.stl
Demo/AHSimulation/AHSimulation/AH_Right_5F_3S_Wrist/mjcf/assets/std00333_plast_tcb_torx_2_5x8__configuration_copy_of_default.stl
Demo/AHSimulation/AHSimulation/AH_Right_5F_3S_Wrist/mjcf/assets/thermo_screw_m2_5x5.stl
Demo/AHSimulation/AHSimulation/AH_Right_5F_3S_Wrist/mjcf/assets/thumb_distal_shell.stl
Demo/AHSimulation/AHSimulation/AH_Right_5F_3S_Wrist/mjcf/assets/thumb_proximal_pad.stl
Demo/AHSimulation/AHSimulation/AH_Right_5F_3S_Wrist/mjcf/assets/uf_l2.stl
Demo/AHSimulation/AHSimulation/AH_Right_5F_3S_Wrist/mjcf/assets/uf_link.stl
Demo/AHSimulation/AHSimulation/AH_Right_5F_3S_Wrist/mjcf/assets/uf_p1.stl
Demo/AHSimulation/AHSimulation/AH_Right_5F_3S_Wrist/mjcf/assets/uf_p2.stl
Demo/AHSimulation/AHSimulation/AH_Right_5F_3S_Wrist/mjcf/assets/uf_p3_pad.stl
Demo/AHSimulation/AHSimulation/AH_Right_5F_3S_Wrist/mjcf/assets/uf_pin_a.stl
Demo/AHSimulation/AHSimulation/AH_Right_5F_3S_Wrist/mjcf/assets/uf_pin_b.stl
Demo/AHSimulation/AHSimulation/AH_Right_5F_3S_Wrist/mjcf/assets/uf_pin_dip.stl
Demo/AHSimulation/AHSimulation/AH_Right_5F_3S_Wrist/mjcf/assets/uf_pin_mcp.stl
Demo/AHSimulation/AHSimulation/AH_Right_5F_3S_Wrist/mjcf/assets/uf_pin_p4.stl
Demo/AHSimulation/AHSimulation/AH_Right_5F_3S_Wrist/mjcf/assets/uf_pin_pip.stl
Demo/AHSimulation/AHSimulation/AH_Right_5F_3S_Wrist/mjcf/assets/ufpk_l2.stl
Demo/AHSimulation/AHSimulation/AH_Right_5F_3S_Wrist/mjcf/assets/ufpk_link.stl
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
