molinzhao27/AmazingHand/Demo/AHSimulation/five_finger/reports/verify_AH_Left_5F.txt

model: Demo/AHSimulation/AHSimulation/AH_Left_5F/mjcf  (mujoco 3.15.0, digits: ['index', 'middle', 'ring', 'thumb', 'pinky'])
== 1. structure
  nbody=47 njnt=40 nq=85 nv=70 nu=10 neq=25 nsite=55 ngeom=208 nkey=1 nmocap=5
  names unique: bodies, joints, sites, actuators
  actuators: ['finger1_motor1', 'finger1_motor2', 'finger2_motor1', 'finger2_motor2', 'finger3_motor1', 'finger3_motor2', 'finger4_motor1', 'finger4_motor2', 'finger5_motor1', 'finger5_motor2']
  every ctrlrange = +-1.5708 rad
  keyframe 'zero': qpos size 85 == nq 85; max equality error 0.0002 mm
  mocap finger1_target -> site tip1: 0.002 mm apart at the keyframe
  mocap finger2_target -> site tip2: 0.004 mm apart at the keyframe
  mocap finger3_target -> site tip3: 0.004 mm apart at the keyframe
  mocap finger4_target -> site tip4: 0.004 mm apart at the keyframe
  mocap finger5_target -> site tip5: 0.004 mm apart at the keyframe
== 2. pinky is an exact copy of the ring finger
  tip in own finger frame, ring vs pinky, 10 commands: max difference 0.0011 mm (only gravity acts differently on the two)
== 3./4. stability and equality-constraint error while sweeping the actuators
  each actuator alone 0->max->min->0       55.0 s sim  max|qvel|    1.90 rad/s  eq err max  0.007 mm (settled  0.001 mm)  max |q_motor - ctrl| settled  0.08 deg  warnings none  [1.4 s wall]
  all digits around their range corners    12.0 s sim  max|qvel|    2.52 rad/s  eq err max  0.015 mm (settled  0.001 mm)  max |q_motor - ctrl| settled  0.07 deg  warnings none  [0.4 s wall]
  demo poses (DEMO_POSES_5F), x2           18.0 s sim  max|qvel|   10.56 rad/s  eq err max  0.044 mm (settled  0.001 mm)  max |q_motor - ctrl| settled  0.08 deg  warnings none  [0.5 s wall]
  60 abrupt random full-range steps        36.0 s sim  max|qvel|   87.32 rad/s  eq err max  0.934 mm (settled  0.003 mm)  max |q_motor - ctrl| settled  0.15 deg  warnings none  [1.1 s wall]
  per digit (all sequences): max equality error transient / settled
    index    0.791 mm /  0.002 mm
    middle   0.526 mm /  0.003 mm
    ring     0.632 mm /  0.002 mm
    thumb    0.934 mm /  0.001 mm
    pinky    0.861 mm /  0.002 mm
  worst pair overall: 'closing_1 (4)_1_z' / 'closing_1 (4)_2_z' 0.934 mm
== 5. interference: 9x9 grid per digit over (motor1, motor2) in [-90, 90] deg (22.5 deg steps); surface samples every 1.0 mm, 0.3 mm below 3 mm clearance
  settled 81 grid poses (0.6 s); max equality error at the grid poses: index 0.002 mm, middle 0.002 mm, ring 0.002 mm, thumb 0.002 mm, pinky 0.002 mm
  ring vs pinky, palm-fixed parts only (servos, finger frames): > 5 mm
  ring (A) vs pinky (B): min clearance 0.00 mm at A(+22,-68) B(-45,-22) [proximal_shell (parallel_pin_2_x_16__da4b7ddbe9d803fe3fbc70f2e822b99b_3) / proximal_shell (parallel_pin_2_x_16__da4b7ddbe9d803fe3fbc70f2e822b99b_5)]; pose pairs touching or overlapping (< 0.23 mm): 1691/6561
    touching parts: proximal_shell/proximal_shell x345, proximal/proximal_shell x330, proximal/proximal x125, ph_pan_head_screw_m2x0_40_x_10__2803432263e518bbd16bccbbef8784ed/proximal_shell x121, proximal_shell/std00447_thermoplastique_m2_5x6__configuration_default x104, distal_shell/distal_shell x67, proximal/std00447_thermoplastique_m2_5x6__configuration_default x61, proximal_shell/rotule_ball x47, distal/distal_shell x46, proximal_shell/rotule_lever x44, link/proximal_shell x38, distal/proximal x37, distal_shell/proximal_shell x34, link/proximal x30, distal_shell/proximal x28, rotule_lever/std00447_thermoplastique_m2_5x6__configuration_default x25, distal_shell/std00447_thermoplastique_m2_5x6__configuration_default x24, distal/distal x19, distal/proximal_shell x17, proximal/rotule_lever x16, link/std00447_thermoplastique_m2_5x6__configuration_default x16, ph_pan_head_screw_m2x0_40_x_10__2803432263e518bbd16bccbbef8784ed/proximal x16, rotule_ball/std00447_thermoplastique_m2_5x6__configuration_default x11, proximal/rotule_ball x11, distal/std00447_thermoplastique_m2_5x6__configuration_default x11, ph_pan_head_screw_m2x0_40_x_10__2803432263e518bbd16bccbbef8784ed/std00447_thermoplastique_m2_5x6__configuration_default x10, parallel_pin_2_x_10__fee063fca0c8b40e46bbc4ffff61d999/proximal x8, parallel_pin_2_x_16__da4b7ddbe9d803fe3fbc70f2e822b99b/proximal_shell x8, distal_shell/parallel_pin_2_x_10__fee063fca0c8b40e46bbc4ffff61d999 x7, std00447_thermoplastique_m2_5x6__configuration_default/std00447_thermoplastique_m2_5x6__configuration_default x6, parallel_pin_2_x_16__da4b7ddbe9d803fe3fbc70f2e822b99b/proximal x5, distal_shell/link x4, distal/link x4, link/link x4, distal_shell/parallel_pin_2_x_16__da4b7ddbe9d803fe3fbc70f2e822b99b x3, distal/parallel_pin_2_x_10__fee063fca0c8b40e46bbc4ffff61d999 x3, parallel_pin_2_x_10__fee063fca0c8b40e46bbc4ffff61d999/proximal_shell x2, link/parallel_pin_2_x_10__fee063fca0c8b40e46bbc4ffff61d999 x2, parallel_pin_2_x_10__fee063fca0c8b40e46bbc4ffff61d999/std00447_thermoplastique_m2_5x6__configuration_default x1, link/parallel_pin_2_x_16__da4b7ddbe9d803fe3fbc70f2e822b99b x1
    [200 s]
  middle vs ring, palm-fixed parts only (servos, finger frames): > 5 mm
  middle (A) vs ring (B): min clearance 0.00 mm at A(-45,+90) B(-90,+45) [std00447_thermoplastique_m2_5x6__configuration_default (parallel_pin_2_x_10__fee063fca0c8b40e46bbc4ffff61d999_2) / distal_shell (parallel_pin_2_x_10__fee063fca0c8b40e46bbc4ffff61d999_3)]; pose pairs touching or overlapping (< 0.23 mm): 1644/6561
    touching parts: proximal_shell/proximal_shell x421, proximal/proximal_shell x380, proximal_shell/std00447_thermoplastique_m2_5x6__configuration_default x146, proximal/proximal x117, ph_pan_head_screw_m2x0_40_x_10__2803432263e518bbd16bccbbef8784ed/proximal_shell x87, distal/distal_shell x60, distal_shell/distal_shell x58, proximal/std00447_thermoplastique_m2_5x6__configuration_default x58, link/proximal_shell x35, proximal_shell/rotule_lever x34, link/proximal x33, distal_shell/proximal_shell x31, distal_shell/proximal x24, distal_shell/std00447_thermoplastique_m2_5x6__configuration_default x21, distal/distal x21, proximal_shell/rotule_ball x20, distal/proximal_shell x19, distal/proximal x18, link/std00447_thermoplastique_m2_5x6__configuration_default x9, parallel_pin_2_x_16__da4b7ddbe9d803fe3fbc70f2e822b99b/proximal_shell x7, distal/std00447_thermoplastique_m2_5x6__configuration_default x6, distal/link x6, parallel_pin_2_x_16__da4b7ddbe9d803fe3fbc70f2e822b99b/proximal x5, std00447_thermoplastique_m2_5x6__configuration_default/std00447_thermoplastique_m2_5x6__configuration_default x5, distal_shell/link x4, link/link x4, distal_shell/parallel_pin_2_x_10__fee063fca0c8b40e46bbc4ffff61d999 x3, ph_pan_head_screw_m2x0_40_x_10__2803432263e518bbd16bccbbef8784ed/proximal x2, parallel_pin_2_x_10__fee063fca0c8b40e46bbc4ffff61d999/proximal_shell x2, distal/parallel_pin_2_x_10__fee063fca0c8b40e46bbc4ffff61d999 x2, distal/parallel_pin_2_x_16__da4b7ddbe9d803fe3fbc70f2e822b99b x2, rotule_lever/std00447_thermoplastique_m2_5x6__configuration_default x1, distal_shell/parallel_pin_2_x_16__da4b7ddbe9d803fe3fbc70f2e822b99b x1, parallel_pin_2_x_10__fee063fca0c8b40e46bbc4ffff61d999/proximal x1, link/parallel_pin_2_x_16__da4b7ddbe9d803fe3fbc70f2e822b99b x1
    [198 s]
  thumb vs pinky, palm-fixed parts only (servos, finger frames): > 5 mm
  thumb (A) vs pinky (B): > 5 mm apart in all 6561 pose pairs
    thumb inside its command envelope (layout.thumb_command_ok, 18 of 81): > 5 mm apart, pose pairs touching 0/1458
    [4 s]
  thumb vs ring, palm-fixed parts only (servos, finger frames): > 5 mm
  thumb (A) vs ring (B): min clearance 0.00 mm at A(+68,-45) B(-90,-45) [distal_shell (parallel_pin_2_x_10__fee063fca0c8b40e46bbc4ffff61d999_4) / ph_pan_head_screw_m2x0_40_x_10__2803432263e518bbd16bccbbef8784ed (rotule_ball_6)]; pose pairs touching or overlapping (< 0.23 mm): 1353/6561
    touching parts: distal_shell/rotule_lever x480, distal_shell/ph_pan_head_screw_m2x0_40_x_10__2803432263e518bbd16bccbbef8784ed x257, distal_shell/rotule_ball x201, distal/rotule_lever x89, distal_shell/proximal_shell x60, distal/rotule_ball x58, distal_shell/m2_rod_l18 x58, custom_servo_horn/distal_shell x48, distal/ph_pan_head_screw_m2x0_40_x_10__2803432263e518bbd16bccbbef8784ed x40, distal_shell/spacer x24, distal/m2_rod_l18 x10, distal_shell/proximal x7, distal/proximal_shell x7, rotule_lever/std00447_thermoplastique_m2_5x6__configuration_default x5, distal/std00447_thermoplastique_m2_5x6__configuration_default x4, distal_shell/std00447_thermoplastique_m2_5x6__configuration_default x3, distal/spacer x2
    thumb inside its command envelope (layout.thumb_command_ok, 18 of 81): > 5 mm apart, pose pairs touching 0/1458
    [43 s]
  ring/pinky contact vs relative abduction c = a_pinky - a_ring (a = (m1+m2)/2, > 0 = towards index): touching pairs have c >= -180.0 deg
    c = -180.0 deg: 1/1 pose pairs touch (min clearance of the others inf mm)
    c = -157.5 deg: 10/10 pose pairs touch (min clearance of the others inf mm)
    c = -135.0 deg: 35/35 pose pairs touch (min clearance of the others inf mm)
    c = -112.5 deg: 83/84 pose pairs touch (min clearance of the others 0.63 mm)
    c =  -90.0 deg: 145/165 pose pairs touch (min clearance of the others 0.31 mm)
    c =  -67.5 deg: 198/270 pose pairs touch (min clearance of the others 0.43 mm)
    c =  -45.0 deg: 206/375 pose pairs touch (min clearance of the others 0.24 mm)
    c =  -22.5 deg: 115/456 pose pairs touch (min clearance of the others 0.24 mm)
    c =   +0.0 deg: 39/489 pose pairs touch (min clearance of the others 0.25 mm)
    c =  +22.5 deg: 10/456 pose pairs touch (min clearance of the others 0.25 mm)
    c =  +45.0 deg: 1/375 pose pairs touch (min clearance of the others 0.96 mm)
  pinky/ring vs stock middle/ring: same set of pose pairs within 5 mm: False; max |clearance difference| 3.123 mm; same touching set: False
  index  moving parts vs palm (plate + wrist interface): min clearance  0.01 mm at (-68,+90) [proximal_shell (parallel_pin_2_x_16__da4b7ddbe9d803fe3fbc70f2e822b99b) / r_hand_plate]; grid poses touching: 7/81
  middle moving parts vs palm (plate + wrist interface): min clearance  0.02 mm at (-68,+45) [proximal_shell (parallel_pin_2_x_16__da4b7ddbe9d803fe3fbc70f2e822b99b_2) / r_hand_plate]; grid poses touching: 11/81
  ring   moving parts vs palm (plate + wrist interface): min clearance  0.03 mm at (-68,+90) [proximal_shell (parallel_pin_2_x_16__da4b7ddbe9d803fe3fbc70f2e822b99b_3) / r_hand_plate]; grid poses touching: 11/81
  thumb  moving parts vs palm (plate + wrist interface): min clearance  0.01 mm at (-68,+90) [proximal_shell (parallel_pin_2_x_16__da4b7ddbe9d803fe3fbc70f2e822b99b_4) / r_hand_plate]; grid poses touching: 17/81
         inside the thumb's command envelope (layout.thumb_command_ok, 18 of the 81 grid poses): touching 0, min clearance 0.40 mm
  pinky  moving parts vs palm (plate + wrist interface): min clearance  0.03 mm at (-68,+90) [proximal_shell (parallel_pin_2_x_16__da4b7ddbe9d803fe3fbc70f2e822b99b_5) / r_hand_plate]; grid poses touching: 11/81
== 6. demo poses with a pinky (DEMO_POSES_5F): clearance between neighbouring digits (samples every 0.3 mm)
  OpenHand        index/middle 3.30 mm, middle/ring 3.65 mm, ring/pinky 4.69 mm
  CloseHand       index/middle 4.98 mm, thumb/index 2.61 mm
  SpreadHand      all neighbouring digits > 5 mm apart
  ClenchHand      index/middle 2.63 mm, middle/ring 1.42 mm
  Index_Pointing  thumb/index 4.18 mm, thumb/middle 0.03 mm TOUCH
  Perfect         index/middle 3.52 mm, middle/ring 1.84 mm, ring/pinky 3.69 mm, thumb/index 3.20 mm
  Victory         all neighbouring digits > 5 mm apart
  Pinched         thumb/index 1.03 mm
  Fuck            thumb/index 2.61 mm
