molinzhao27/AmazingHand/Demo/AHSimulation/three_segment/reports/verify_hand5_3seg.txt

== 5-digit right hand with 3-phalanx index/middle/ring/pinky (thumb stock): model/hand5_3seg
   checks imported unchanged from Demo/AHSimulation/five_finger/verify_5f_model.py
== 1. structure
  nbody=50 njnt=48 nq=93 nv=78 nu=10 neq=29 nsite=63 ngeom=210 nkey=1 nmocap=0
  names unique: bodies, joints, sites, actuators
  actuators: ['finger1_motor1', 'finger1_motor2', 'finger2_motor1', 'finger2_motor2', 'finger3_motor1', 'finger3_motor2', 'finger4_motor1', 'finger4_motor2', 'finger5_motor1', 'finger5_motor2']
  every ctrlrange = +-1.5708 rad
  keyframe 'zero': qpos size 93 == nq 93; max equality error 0.0001 mm
== 2. pinky is an exact copy of the ring finger
  tip in own finger frame, ring vs pinky, 10 commands: max difference 0.0016 mm (only gravity acts differently on the two)
== 2b. every 3-phalanx finger of the hand vs the standalone finger model (tip in its own finger frame, 6 commands): max difference 0.0711 mm
   demo poses re-mapped for the 3-phalanx fingers (right hand, deg):
     OpenHand        index (-53.1, 53.1)  middle (-53.1, 53.1)  ring (-53.1, 53.1)  pinky (-53.1, 53.1)  thumb (-35, 35)
     CloseHand       index (90.0, -90.0)  middle (90.0, -90.0)  ring (90.0, -90.0)  pinky (90.0, -90.0)  thumb (90, -90)
     SpreadHand      index (-30.0, 90.0)  middle (-49.7, 49.7)  ring (-85.0, 35.0)  pinky (-90.0, 30.0)  thumb (-90, -4)
     ClenchHand      index (-77.4, 17.4)  middle (-53.1, 53.1)  ring (-18.1, 88.1)  pinky (-18.1, 88.1)  thumb (-4, 90)
     Index_Pointing  index (-58.5, 58.5)  middle (90.0, -90.0)  ring (90.0, -90.0)  pinky (90.0, -90.0)  thumb (90, -90)
     Perfect         index (44.2, -44.2)  middle (-13.0, 13.0)  ring (-35.9, 35.9)  pinky (-35.9, 35.9)  thumb (65, 12)
     Victory         index (-33.5, 83.5)  middle (-83.5, 33.5)  ring (90.0, -90.0)  pinky (90.0, -90.0)  thumb (90, -90)
     Pinched         index (90.0, -90.0)  middle (90.0, -90.0)  ring (90.0, -90.0)  pinky (90.0, -90.0)  thumb (0, -75)
     Fuck            index (90.0, -90.0)  middle (-53.1, 53.1)  ring (90.0, -90.0)  pinky (90.0, -90.0)  thumb (0, -75)
== 3./4. stability and equality-constraint error while sweeping the actuators
  each actuator alone 0->max->min->0       55.0 s sim  max|qvel|    1.90 rad/s  eq err max  0.012 mm (settled  0.001 mm)  max |q_motor - ctrl| settled  0.11 deg  warnings none  [3.2 s wall]
  all digits around their range corners    12.0 s sim  max|qvel|    2.53 rad/s  eq err max  0.031 mm (settled  0.004 mm)  max |q_motor - ctrl| settled  0.10 deg  warnings none  [0.8 s wall]
  demo poses (DEMO_POSES_5F), x2           18.0 s sim  max|qvel|   12.12 rad/s  eq err max  0.089 mm (settled  0.003 mm)  max |q_motor - ctrl| settled  0.15 deg  warnings none  [0.9 s wall]
  60 abrupt random full-range steps        36.0 s sim  max|qvel|   86.74 rad/s  eq err max  0.933 mm (settled  0.008 mm)  max |q_motor - ctrl| settled  0.29 deg  warnings none  [1.6 s wall]
  per digit (all sequences): max equality error transient / settled
    index    0.828 mm /  0.005 mm
    middle   0.795 mm /  0.008 mm
    ring     0.674 mm /  0.004 mm
    thumb    0.933 mm /  0.001 mm
    pinky    0.807 mm /  0.005 mm
  worst pair overall: 'closing_1 (4)_1_z' / 'closing_1 (4)_2_z' 0.933 mm
== 5. interference: 9x9 grid per digit over (motor1, motor2) in [-90, 90] deg (22.5 deg steps); surface samples every 1.0 mm, 0.3 mm below 3 mm clearance
  settled 81 grid poses (0.7 s); max equality error at the grid poses: index 0.007 mm, middle 0.008 mm, ring 0.007 mm, thumb 0.002 mm, pinky 0.007 mm
  ring vs pinky, palm-fixed parts only (servos, finger frames): 4.41 mm [scs0009_6 / scs0009_9]
  ring (A) vs pinky (B): min clearance 0.00 mm at A(-45,-45) B(+45,+68) [p2 (p2_3) / p2 (p2_5)]; pose pairs touching or overlapping (< 0.23 mm): 691/6561
    touching parts: p1_shell/p1_shell x328, p1/p1_shell x148, p1/p1 x46, p1/p2 x24, p3/p3 x17, p3/p3_shell x16, p2/p3 x15, link3s/p1 x15, link3s/p1_shell x12, p3_shell/p3_shell x12, p2/p2 x11, l2/p2 x10, p1_shell/p2 x10, l2/p3 x8, link3s/p2 x5, p2/p3_shell x4, l2/link3s x4, l2/p1 x3, p2/p2_pad x1, link3s/p2_pad x1, link3s/link3s x1
    [113 s]
  middle vs ring, palm-fixed parts only (servos, finger frames): 4.41 mm [scs0009_3 / scs0009_7]
  middle (A) vs ring (B): min clearance 0.00 mm at A(-22,-90) B(+45,+90) [p1 (p1_2) / p1 (p1_3)]; pose pairs touching or overlapping (< 0.23 mm): 691/6561
    touching parts: p1_shell/p1_shell x332, p1/p1_shell x144, p1/p1 x50, p1/p2 x26, p3/p3_shell x20, link3s/p1 x18, p2/p2 x14, p3/p3 x14, p2/p3 x12, p3_shell/p3_shell x11, link3s/p1_shell x10, l2/p2 x8, p1_shell/p2 x8, l2/p3 x6, link3s/p2 x5, p2/p3_shell x4, l2/link3s x3, l2/p1 x2, p2/p2_pad x1, link3s/p2_pad x1, link3s/link3s x1, l2/p2_pad x1
    [171 s]
  thumb vs pinky, palm-fixed parts only (servos, finger frames): > 5 mm
  thumb (A) vs pinky (B): > 5 mm apart in all 6561 pose pairs
    [8 s]
  thumb vs ring, palm-fixed parts only (servos, finger frames): > 5 mm
  thumb (A) vs ring (B): > 5 mm apart in all 6561 pose pairs
    [7 s]
  ring/pinky contact vs relative abduction c = a_pinky - a_ring (a = (m1+m2)/2, > 0 = towards index): touching pairs have c >= 45.0 deg
    c =  +45.0 deg: 7/375 pose pairs touch (min clearance of the others 0.64 mm)
    c =  +67.5 deg: 91/270 pose pairs touch (min clearance of the others 0.23 mm)
    c =  +90.0 deg: 120/165 pose pairs touch (min clearance of the others 0.29 mm)
    c = +112.5 deg: 82/84 pose pairs touch (min clearance of the others 1.01 mm)
    c = +135.0 deg: 35/35 pose pairs touch (min clearance of the others inf mm)
    c = +157.5 deg: 10/10 pose pairs touch (min clearance of the others inf mm)
    c = +180.0 deg: 1/1 pose pairs touch (min clearance of the others inf mm)
  pinky/ring vs stock middle/ring: same set of pose pairs within 5 mm: False; max |clearance difference| 0.520 mm; same touching set: False
  index  moving parts vs palm (plate + wrist interface): min clearance  0.40 mm at (-68,+90) [plain_washer_large_grade_a_m2_5__9a369f0dc77bf9c598cdf3fb468977e5 (std00333_plast_tcb_torx_2_5x8__configuration_copy_of_default) / r_hand_plate]; grid poses touching: 0/81
  middle moving parts vs palm (plate + wrist interface): min clearance  0.40 mm at (-68,+90) [plain_washer_large_grade_a_m2_5__9a369f0dc77bf9c598cdf3fb468977e5 (std00333_plast_tcb_torx_2_5x8__configuration_copy_of_default_2) / r_hand_plate]; grid poses touching: 0/81
  ring   moving parts vs palm (plate + wrist interface): min clearance  0.40 mm at (-68,+90) [plain_washer_large_grade_a_m2_5__9a369f0dc77bf9c598cdf3fb468977e5 (std00333_plast_tcb_torx_2_5x8__configuration_copy_of_default_3) / r_hand_plate]; grid poses touching: 0/81
  thumb  moving parts vs palm (plate + wrist interface): min clearance  0.40 mm at (+22,+22) [plain_washer_large_grade_a_m2_5__9a369f0dc77bf9c598cdf3fb468977e5 (std00333_plast_tcb_torx_2_5x8__configuration_copy_of_default_4) / r_wrist_interface]; grid poses touching: 0/81
  pinky  moving parts vs palm (plate + wrist interface): min clearance  0.40 mm at (-68,+90) [plain_washer_large_grade_a_m2_5__9a369f0dc77bf9c598cdf3fb468977e5 (std00333_plast_tcb_torx_2_5x8__configuration_copy_of_default_5) / r_hand_plate]; grid poses touching: 0/81
== 6. demo poses with a pinky (DEMO_POSES_5F): clearance between neighbouring digits (samples every 0.3 mm)
  OpenHand        all neighbouring digits > 5 mm apart
  CloseHand       thumb/index 0.00 mm TOUCH
  SpreadHand      all neighbouring digits > 5 mm apart
  ClenchHand      index/middle 3.40 mm, middle/ring 4.80 mm
  Index_Pointing  all neighbouring digits > 5 mm apart
  Perfect         index/middle 2.37 mm, middle/ring 2.11 mm, ring/pinky 3.82 mm, thumb/index 0.00 mm TOUCH
  Victory         all neighbouring digits > 5 mm apart
  Pinched         thumb/index 1.34 mm
  Fuck            thumb/index 1.34 mm
