molinzhao27/AmazingHand/cad/five_finger/mockup/fit_test_pieces.png

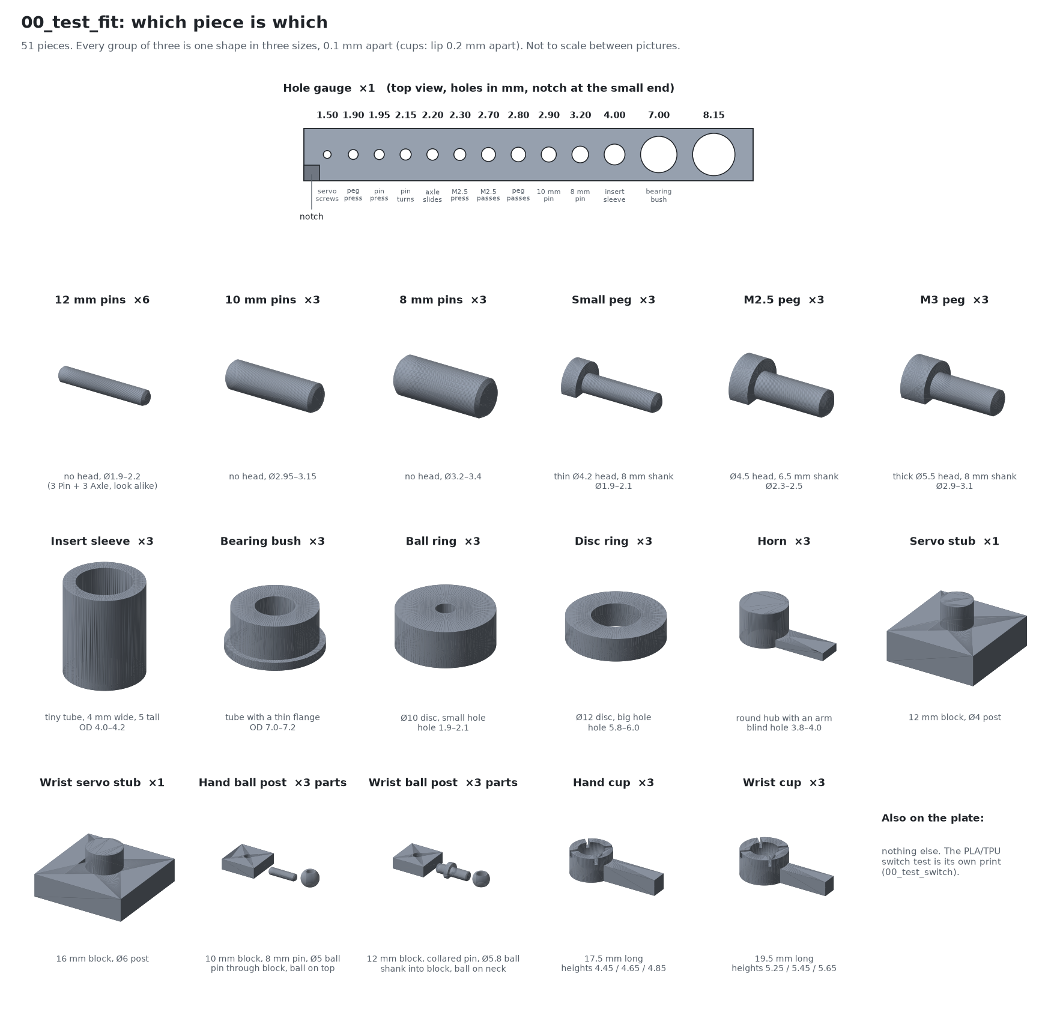
cad/five_finger/mockup/fit_test_pieces.png
