molinzhao27/AmazingHand/Demo/AHSimulation/AHSimulation/AH_Left_5F/mjcf/robot.xml

<?xml version="1.0" ?>
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
<mujoco model="mjcf">
  <compiler angle="radian" meshdir="assets" autolimits="true"/>
  <default>
    <default class="mjcf">
      <joint frictionloss="0.1" armature="0.005"/>
      <position kp="50" dampratio="1"/>
      <default class="visual">
        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
      </default>
      <default class="collision">
        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
      </default>
    </default>
  </default>
  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
  <default>
    <default class="perfect_actuator">
      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
      <joint damping="0.095" frictionloss="0.001" armature="0.001" range="-1.5707963267948966 1.5707963267948966"/>
      <position kp="10.0" kv="0.0" forcerange="-10.0 10.0"/>
      <default class="chosen_actuator"/>
    </default>
    <default class="xc330m288t">
      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
      <joint damping="0.095" frictionloss="0.058" armature="0.0018"/>
      <position kp="2.54" kv="0.0" forcerange="-0.8 0.8"/>
    </default>
    <default class="sts3215_345">
      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
      <joint damping="0.56" frictionloss="0.068" armature="0.027"/>
      <position kp="17.11" kv="0.0" forcerange="-3.23 3.23"/>
    </default>
    <default class="sts3215_147">
      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
      <joint damping="0.1" frictionloss="0.028" armature="0.011"/>
      <position kp="17.11" kv="0.0" forcerange="-1.35 1.35"/>
    </default>
  </default>
  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
  <default>
    <equality solref="0.002 1" solimp="0.99 0.999 0.0005 0.5 2"/>
  </default>
  <worldbody>
    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
    <body name="l_wrist_interface" pos="0 0 0" quat="1 0 0 0" childclass="mjcf">
      <inertial pos="0 0 0" mass="1e-09" fullinertia="1e-09 1e-09 1e-09 0 0 0"/>
      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
      <body name="custom_servo_horn" pos="-0.00755 -0.0193333 0.0683238" quat="0.542448 0.453597 -0.542448 -0.453597">
        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
        <joint axis="0 0 1" name="finger1_motor1" type="hinge" range="-1.5707963267680816 1.5707963268217116"/>
        <inertial pos="-0.005 1.45507e-17 -0.00655938" mass="0.000410988" fullinertia="4.63584e-09 4.63584e-09 1e-09 -5.13695e-25 5.13695e-25 -1.47358e-24"/>
        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
        <body name="ball_link" pos="-0.005 6.93889e-17 -0.0069" quat="0.00510149 -0.888984 0.0544589 0.454661">
          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
          <joint axis="0 0 1" name="passive_ball1" type="ball"/>
          <inertial pos="-1.373e-13 -0.0165 -1.373e-13" mass="0.000463323" fullinertia="6.40121e-08 1.59688e-09 6.40121e-08 6.6602e-19 -4.97671e-14 -6.66028e-19"/>
          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
          <body name="rotule_ball" pos="-5.09575e-18 -0.033 0" quat="0.707107 0 -0.707107 1.26027e-16">
            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
            <joint axis="0 0 1" name="passive_ball2" type="ball"/>
            <inertial pos="-0.0054579 -0.0141744 -0.00370248" mass="0.00277119" fullinertia="7.66485e-07 1.05617e-07 7.96842e-07 1.1411e-07 -1.27899e-08 -3.77417e-08"/>
            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
            <body name="std00333_plast_tcb_torx_2_5x8__configuration_copy_of_default" pos="-0.0116897 -0.000368272 -0.00081146" quat="0.778258 -0.271383 0.369077 -0.429475">
              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
              <joint axis="0 0 1" name="passive2 (1)" type="hinge"/>
              <inertial pos="-0.00530874 -0.00868244 0.00225" mass="0.00201325" fullinertia="9.34482e-08 4.69015e-08 1.16807e-07 -4.54529e-08 -5.39352e-21 1.85294e-21"/>
              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
            </body>
            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
            <body name="parallel_pin_2_x_10__fee063fca0c8b40e46bbc4ffff61d999" pos="0.00373407 -0.0482013 -0.00704062" quat="0.271383 0.778258 -0.429475 -0.369077">
              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
              <joint axis="0 0 1" name="passive4 (1)" type="hinge"/>
              <inertial pos="0.014571 -0.0133924 0.00225" mass="0.00540375" fullinertia="3.60212e-07 5.51031e-07 7.69492e-07 3.36413e-07 4.59548e-20 6.21363e-20"/>
              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
              <body name="parallel_pin_2_x_16__da4b7ddbe9d803fe3fbc70f2e822b99b" pos="-0.000346366 -0.00598999 0.00655" quat="1.94185e-14 -0.999998 -0.00198164 -2.33228e-14">
                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
                <joint axis="0 0 1" name="passive_5 (1)" type="hinge"/>
                <inertial pos="-0.0249171 -0.00392936 0.0052354" mass="0.0101851" fullinertia="4.96149e-07 2.52849e-06 2.3577e-06 2.45138e-08 1.19032e-10 3.03943e-10"/>
                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
              </body>
            </body>
          </body>
        </body>
      </body>
      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
      <body name="rotule_ball_2" pos="-0.00755 -0.0312422 0.0704655" quat="0.453597 -0.542448 -0.453597 0.542448">
        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
        <joint axis="0 0 1" name="finger1_motor2" type="hinge" range="-1.570796326794806 1.5707963267949872"/>
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
                <inertial pos="-0.0249171 -0.00392936 0.0052354" mass="0.0101851" fullinertia="4.96149e-07 2.52849e-06 2.3577e-06 2.45138e-08 1.19032e-10 3.03943e-10"/>
                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
              </body>
            </body>
          </body>
        </body>
      </body>
      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
      <body name="rotule_ball_10" pos="-0.00755 0.0546558 0.0400631" quat="0.453597 -0.542448 -0.453597 0.542448">
        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
        <joint axis="0 0 1" name="finger5_motor2" type="hinge" range="-1.5707963267948912 1.5707963267949019"/>
        <inertial pos="-0.005 2.16114e-17 -0.00655938" mass="0.000410988" fullinertia="4.63584e-09 4.63584e-09 1e-09 -6.78768e-25 1.99843e-24 1.14113e-24"/>
        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
        <body name="ball_link_9" pos="-0.005 1.8735e-16 -0.0069" quat="0.920605 0.0030407 0.387891 0.0449247">
          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
          <joint axis="0 0 1" name="passive_ball15" type="ball"/>
          <inertial pos="-1.37297e-13 -0.0165 -1.37299e-13" mass="0.000463323" fullinertia="6.40121e-08 1.59688e-09 6.40121e-08 6.66027e-19 -4.97671e-14 -6.66027e-19"/>
          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
        </body>
      </body>
    </body>
  </worldbody>
  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
  <actuator>
    <position class="mjcf" name="finger1_motor1" joint="finger1_motor1" inheritrange="1"/>
    <position class="mjcf" name="finger1_motor2" joint="finger1_motor2" inheritrange="1"/>
    <position class="mjcf" name="finger2_motor1" joint="finger2_motor1" inheritrange="1"/>
    <position class="mjcf" name="finger2_motor2" joint="finger2_motor2" inheritrange="1"/>
    <position class="mjcf" name="finger3_motor1" joint="finger3_motor1" inheritrange="1"/>
    <position class="mjcf" name="finger3_motor2" joint="finger3_motor2" inheritrange="1"/>
    <position class="mjcf" name="finger4_motor1" joint="finger4_motor1" inheritrange="1"/>
    <position class="mjcf" name="finger4_motor2" joint="finger4_motor2" inheritrange="1"/>
    <position class="mjcf" name="finger5_motor1" joint="finger5_motor1" inheritrange="1"/>
    <position class="mjcf" name="finger5_motor2" joint="finger5_motor2" inheritrange="1"/>
  </actuator>
  <equality>
    <connect site1="closing_1 (1)_1" site2="closing_1 (1)_2"/>
    <connect site1="closing_1 (1)_1_z" site2="closing_1 (1)_2_z"/>
    <connect site1="closing_3 (1)_1" site2="closing_3 (1)_2"/>
    <connect site1="closing_3 (1)_1_z" site2="closing_3 (1)_2_z"/>
    <connect site1="closing_1 (2)_1" site2="closing_1 (2)_2"/>
    <connect site1="closing_1 (2)_1_z" site2="closing_1 (2)_2_z"/>
    <connect site1="closing_3 (2)_1" site2="closing_3 (2)_2"/>
    <connect site1="closing_3 (2)_1_z" site2="closing_3 (2)_2_z"/>
    <connect site1="closing_1 (3)_1" site2="closing_1 (3)_2"/>
    <connect site1="closing_1 (3)_1_z" site2="closing_1 (3)_2_z"/>
    <connect site1="closing_3 (3)_1" site2="closing_3 (3)_2"/>
    <connect site1="closing_3 (3)_1_z" site2="closing_3 (3)_2_z"/>
    <connect site1="closing_1 (4)_1" site2="closing_1 (4)_2"/>
    <connect site1="closing_1 (4)_1_z" site2="closing_1 (4)_2_z"/>
    <connect site1="closing_3 (4)_1" site2="closing_3 (4)_2"/>
    <connect site1="closing_3 (4)_1_z" site2="closing_3 (4)_2_z"/>
    <connect site1="closing_1 (5)_1" site2="closing_1 (5)_2"/>
    <connect site1="closing_1 (5)_1_z" site2="closing_1 (5)_2_z"/>
    <connect site1="closing_3 (5)_1" site2="closing_3 (5)_2"/>
    <connect site1="closing_3 (5)_1_z" site2="closing_3 (5)_2_z"/>
    <connect site1="closing_ball1_1" site2="closing_ball1_2"/>
    <connect site1="closing_ball2_1" site2="closing_ball2_2"/>
    <connect site1="closing_ball3_1" site2="closing_ball3_2"/>
    <connect site1="closing_ball4_1" site2="closing_ball4_2"/>
    <connect site1="closing_ball5_1" site2="closing_ball5_2"/>
  </equality>
</mujoco>
