molinzhao27/AmazingHand/Demo/AHSimulation/five_finger/build_5f_model.py

#!/usr/bin/env python3
"""Generate the 5-digit (4 fingers + thumb) MJCF from the stock AH_Right (or AH_Left) model.

The pinky (finger5) is a rigid copy of the ring finger (finger3): every finger3 part that is
fixed to the palm (servos, finger frames, bushings, closing sites) and both of its motor chains
are copied and moved by the same rigid transform that takes the middle finger (finger2) onto the
ring finger (finger3), i.e. a 7.5 deg rotation about the palm-normal (x) axis plus the matching
translation. The pinky therefore relates to the ring finger exactly the way the ring finger
relates to the middle finger in the stock hand.

finger5 is appended after the thumb, so qpos[0:68], ctrl[0:8] and mocap[0:4] keep the stock
layout; finger5 adds qpos[68:85], ctrl[8:10] and mocap[4].

Then the four finger modules are placed by the layout of cad/five_finger/layout.py (default
"parallel": every module stood parallel to the forearm axis of the powered wrist at a 30 mm knuckle
pitch). Each module - its servos, finger frames and bushings (fixed to the palm), its closing sites
and both motor chains - is moved rigidly, so the finger and its drive are unchanged. --layout stock
keeps the stock fan.

The thumb module (finger4: its servos, finger frames, bushings, knuckle sites and both motor chains) is
re-mounted the same way, by the rigid transform of layout.py THUMB_MOUNT (default "slim": the servo pack
lies flatter in the lower radial corner of the palm instead of hanging below it); --thumb stock keeps the
stock mount on the wrist interface.

Usage:  python build_5f_model.py              (writes AHSimulation/AH_Right_5F/mjcf)
        python build_5f_model.py --side left  (writes AHSimulation/AH_Left_5F/mjcf)
        add --keyframe to regenerate keyframes.xml by settling at the home ctrl (0, the thumb at layout.clamp_thumb(0, 0))
        --layout stock|parallel (default: cad/five_finger/layout.py LAYOUT)
        --thumb stock|slim (default: cad/five_finger/layout.py THUMB_MOUNT)
"""

import argparse
import copy
import sys
import re
import shutil
import xml.etree.ElementTree as ET
from pathlib import Path

import mujoco
import numpy as np
import trimesh

HERE = Path(__file__).resolve().parent
SIM_DIR = HERE.parent / "AHSimulation"
CAD_STL = HERE.parent.parent.parent / "cad" / "five_finger" / "stl"
sys.path.insert(0, str(CAD_STL.parent))
import layout as LAYOUT  # noqa: E402
# Widened palm plates come from cad/five_finger/make_5f_plate.py (the stock plates have 3 finger mounts).
# The stock wrist interface is replaced by the powered wrist's hand adapter (cad/five_finger/wrist/make_wrist.py): its
# interface plate (the same plate, without the stock d49 spigot) is the root's wrist-interface mesh.
WRIST_REF = CAD_STL.parent / "wrist" / "stl" / "ref"
SIDES = {
    "right": dict(src=SIM_DIR / "AH_Right" / "mjcf", dst=SIM_DIR / "AH_Right_5F" / "mjcf", root="r_wrist_interface",
                  plate="r_hand_plate", plate_src=CAD_STL / "R-Hand_Plate_5F.stl", iface_src=WRIST_REF / "R-Wrist_Hand_Adapter_palm.stl"),
    "left": dict(src=SIM_DIR / "AH_Left" / "mjcf", dst=SIM_DIR / "AH_Left_5F" / "mjcf", root="l_wrist_interface",
                 plate="l_hand_plate", plate_src=CAD_STL / "L-Hand_Plate_5F.stl", iface_src=WRIST_REF / "L-Wrist_Hand_Adapter_palm.stl"),
}
SRC, DST = SIDES["right"]["src"], SIDES["right"]["dst"]

# Root-level parts (by their "Part ..." comment) of finger2/finger3 in the right model, and the
# finger5 names they get; build_robot() finds them geometrically and checks against these.
F2_PARTS = ["scs0009_5", "scs0009_3", "finger_frame_1_2", "finger_frame_2", "bushing_0608_04", "bushing_0608_04_4"]
F3_PARTS = ["scs0009_7", "scs0009_6", "finger_frame_1_3", "finger_frame_2_2", "bushing_0608_04_3", "bushing_0608_04_7"]
# Instance names for the new finger5 parts (continuing the onshape-to-robot numbering).
F5_PARTS = ["scs0009_9", "scs0009_10", "finger_frame_1_5", "finger_frame_2_5", "bushing_0608_04_9", "bushing_0608_04_10"]

F2_SITES = ["closing_1 (2)_2", "closing_1 (2)_2_z"]
F3_SITES = ["closing_1 (3)_2", "closing_1 (3)_2_z"]

# Top-level bodies of each chain: (motor1 chain, motor2 chain).
F2_BODIES = ["custom_servo_horn_2", "rotule_ball_4"]
F3_BODIES = ["custom_servo_horn_3", "rotule_ball_6"]

# Every named element in finger3's chains and root sites -> its finger5 name.
RENAME = {
    # bodies
    "custom_servo_horn_3": "custom_servo_horn_5",
    "ball_link_4": "ball_link_8",
    "rotule_ball_5": "rotule_ball_9",
    "std00333_plast_tcb_torx_2_5x8__configuration_copy_of_default_3": "std00333_plast_tcb_torx_2_5x8__configuration_copy_of_default_5",
    "parallel_pin_2_x_10__fee063fca0c8b40e46bbc4ffff61d999_3": "parallel_pin_2_x_10__fee063fca0c8b40e46bbc4ffff61d999_5",
    "parallel_pin_2_x_16__da4b7ddbe9d803fe3fbc70f2e822b99b_3": "parallel_pin_2_x_16__da4b7ddbe9d803fe3fbc70f2e822b99b_5",
    "rotule_ball_6": "rotule_ball_10",
    "ball_link_5": "ball_link_9",
    # joints
    "finger3_motor1": "finger5_motor1",
    "finger3_motor2": "finger5_motor2",
    "passive_ball7": "passive_ball13",
    "passive_ball8": "passive_ball14",
    "passive_ball9": "passive_ball15",
    "passive2 (3)": "passive2 (5)",
    "passive4 (3)": "passive4 (5)",
    "passive_5 (3)": "passive_5 (5)",
    # sites
    "closing_1 (3)_1": "closing_1 (5)_1",
    "closing_1 (3)_1_z": "closing_1 (5)_1_z",
    "closing_1 (3)_2": "closing_1 (5)_2",
    "closing_1 (3)_2_z": "closing_1 (5)_2_z",
    "closing_3 (3)_1": "closing_3 (5)_1",
    "closing_3 (3)_1_z": "closing_3 (5)_1_z",
    "closing_3 (3)_2": "closing_3 (5)_2",
    "closing_3 (3)_2_z": "closing_3 (5)_2_z",
    "closing_ball3_1": "closing_ball5_1",
    "closing_ball3_2": "closing_ball5_2",
    "tip3": "tip5",
}
RENAME_RE = re.compile(
    "|".join(rf"(?<![\w(]){re.escape(k)}(?![\w)])" for k in sorted(RENAME, key=len, reverse=True))
)


# ---------------------------------------------------------------- pose helpers
def quat_mul(a, b):
    r = np.zeros(4)
    mujoco.mju_mulQuat(r, np.asarray(a, float), np.asarray(b, float))
    return r


def quat_conj(q):
    q = np.asarray(q, float)
    return np.array([q[0], -q[1], -q[2], -q[3]])


def rotate(q, v):
    r = np.zeros(3)
    mujoco.mju_rotVecQuat(r, np.asarray(v, float), np.asarray(q, float))
    return r


def get_pose(el):
    pos = np.array([float(x) for x in el.get("pos", "0 0 0").split()])
    quat = np.array([float(x) for x in el.get("quat", "1 0 0 0").split()])
    return pos, quat / np.linalg.norm(quat)


def apply(T, pose):
    (tD, qD), (p, q) = T, pose
    return rotate(qD, p) + tD, quat_mul(qD, q)


def same_pose(a, b, tol=2e-5):
    (pa, qa), (pb, qb) = a, b
    return np.linalg.norm(pa - pb) < tol and min(np.linalg.norm(qa - qb), np.linalg.norm(qa + qb)) < tol


def fmt(v):
    return " ".join(f"{x:.6g}" for x in v)


def set_pose(el, pose):
    pos, quat = pose
    el.set("pos", fmt(pos))
    el.set("quat", fmt(quat))


# ---------------------------------------------------------------- xml helpers
def parse(path):
    return ET.parse(path, parser=ET.XMLParser(target=ET.TreeBuilder(insert_comments=True)))


def is_comment(el):
    return el.tag is ET.Comment


def part_geoms(body):
    """Map 'Part <name>' comments to the geom that follows them (direct children only)."""
    out, children = {}, list(body)
    for c, nxt in zip(children, children[1:]):
        if is_comment(c) and c.text.strip().startswith("Part ") and nxt.tag == "geom":
            out[c.text.strip()[5:]] = (c, nxt)
    return out


def child_by_name(parent, tag, name):
    for el in parent:
        if el.tag == tag and el.get("name") == name:
            return el
    raise KeyError(f"<{tag} name='{name}'> not found")


def preceding_comment(parent, el):
    children = list(parent)
    i = children.index(el)
    return children[i - 1] if i > 0 and is_comment(children[i - 1]) else None


def rename_subtree(el):
    for sub in el.iter():
        if is_comment(sub):
            text = sub.text
            if text.strip().startswith("Part "):
                sub.text = f" Part {text.strip()[5:]} (finger5 copy) "
            else:
                sub.text = RENAME_RE.sub(lambda m: RENAME[m.group(0)], text)
        elif sub.get("name") is not None:
            name = sub.get("name")
            if name not in RENAME:
                raise KeyError(f"no finger5 name for '{name}'")
            sub.set("name", RENAME[name])
        for attr in ("site1", "site2", "joint"):
            if sub.get(attr) in RENAME:
                sub.set(attr, RENAME[sub.get(attr)])


def indent(tree):
    ET.indent(tree, space="  ")


# ---------------------------------------------------------------- build
def finger_step_transform(root_body):
    """Rigid transform taking finger2 onto finger3 (from the finger pivot sites), the finger3 parts
    fixed to the palm (the parts that are an exact image of a finger2 part) and their finger5 names.
    The step is checked on every matched part, closing site and chain root."""
    p2 = get_pose(child_by_name(root_body, "site", F2_SITES[0]))
    p3 = get_pose(child_by_name(root_body, "site", F3_SITES[0]))
    qD = quat_mul(p3[1], quat_conj(p2[1]))
    tD = p3[0] - rotate(qD, p2[0])
    T = (tD, qD)

    geoms = part_geoms(root_body)
    matched = [(n2, n3) for n3, (_, g3) in geoms.items() for n2, (_, g2) in geoms.items()
               if n2 != n3 and g2.get("mesh") == g3.get("mesh") and same_pose(apply(T, get_pose(g2)), get_pose(g3))]
    assert len(matched) == 6 and len({n3 for _, n3 in matched}) == 6, f"finger2/finger3 parts not found: {matched}"
    pairs = [(geoms[a][1], geoms[b][1]) for a, b in matched]
    pairs += [(child_by_name(root_body, "site", a), child_by_name(root_body, "site", b)) for a, b in zip(F2_SITES, F3_SITES)]
    pairs += [(child_by_name(root_body, "body", a), child_by_name(root_body, "body", b)) for a, b in zip(F2_BODIES, F3_BODIES)]
    for e2, e3 in pairs:
        assert same_pose(apply(T, get_pose(e2)), get_pose(e3)), f"finger2->finger3 step is not rigid for {e2.attrib}"

    # finger5 names continue the per-mesh instance numbering; the part nearest the motor1 horn first
    horn = get_pose(child_by_name(root_body, "body", F3_BODIES[0]))[0]
    used = {}
    for name, (_, g) in geoms.items():
        mesh = g.get("mesh")
        suffix = name[len(mesh) + 1:] if name.startswith(mesh + "_") else ""
        used[mesh] = max(used.get(mesh, 1), int(suffix) if suffix.isdigit() else 1)
    order = ["scs0009", "finger_frame_1", "finger_frame_2", "bushing_0608_04"]  # servos, frames, bushings
    f3 = sorted((n3 for _, n3 in matched),
                key=lambda n: (order.index(geoms[n][1].get("mesh")), np.linalg.norm(get_pose(geoms[n][1])[0] - horn)))
    new = {}
    for n3 in f3:
        mesh = geoms[n3][1].get("mesh")
        used[mesh] += 1
        new[n3] = f"{mesh}_{used[mesh]}"

    angle = 2 * np.degrees(np.arctan2(np.linalg.norm(qD[1:]), qD[0]))
    print(f"finger2->finger3 step: {angle:.3f} deg about {np.round(qD[1:] / np.linalg.norm(qD[1:]), 4)}, "
          f"t = {np.round(tD * 1000, 3)} mm (verified on {len(pairs)} elements)")
    return T, new


def build_robot(side, plate_mesh, layout, thumb=None):
    src, dst = side["src"], side["dst"]
    tree = parse(src / "robot.xml")
    mj = tree.getroot()
    root_body = mj.find("worldbody/body")
    assert root_body.get("name") == side["root"]
    T, f5_names = finger_step_transform(root_body)
    if side["root"] == "r_wrist_interface":
        assert f5_names == dict(zip(F3_PARTS, F5_PARTS)), f5_names

    geoms = part_geoms(root_body)
    children = list(root_body)
    first_body = next(i for i, c in enumerate(children) if c.tag == "body")
    insert_at = first_body - 1  # before the comment that precedes the first body

    new_fixed = [ET.Comment(" finger5 (pinky): fixed parts, copied from finger3 and moved by the finger2->finger3 step ")]
    for f3, f5 in f5_names.items():
        _, geom = geoms[f3]
        g = copy.deepcopy(geom)
        set_pose(g, apply(T, get_pose(geom)))
        new_fixed += [ET.Comment(f" Part {f5} "), g]
    for name in F3_SITES:
        site = child_by_name(root_body, "site", name)
        s = copy.deepcopy(site)
        set_pose(s, apply(T, get_pose(site)))
        rename_subtree(s)
        new_fixed += [ET.Comment(f" Frame {s.get('name')} "), s]
    for i, el in enumerate(new_fixed):
        root_body.insert(insert_at + i, el)

    root_body.append(ET.Comment(" finger5 (pinky): motor chains, copied from finger3 and moved by the finger2->finger3 step "))
    for name in F3_BODIES:
        body = child_by_name(root_body, "body", name)
        b = copy.deepcopy(body)
        set_pose(b, apply(T, get_pose(body)))
        rename_subtree(b)
        root_body.append(ET.Comment(f" Link {b.get('name')} "))
        root_body.append(b)

    actuator = mj.find("actuator")
    for name in ("finger3_motor1", "finger3_motor2"):
        a = copy.deepcopy(child_by_name(actuator, "position", name))
        rename_subtree(a)
        actuator.append(a)

    equality = mj.find("equality")
    eqs = list(equality)
    last_closing = max(i for i, e in enumerate(eqs) if e.get("site1").startswith("closing_") and "ball" not in e.get("site1"))
    f3_closing = [e for e in eqs if "(3)" in e.get("site1")]
    f3_ball = [e for e in eqs if e.get("site1") == "closing_ball3_1"]
    for k, e in enumerate(f3_closing):
        c = copy.deepcopy(e)
        rename_subtree(c)
        equality.insert(last_closing + 1 + k, c)
    for e in f3_ball:
        c = copy.deepcopy(e)
        rename_subtree(c)
        equality.append(c)

    assets = {}
    for mesh in mj.find("asset").iter("mesh"):
        stem = Path(mesh.get("file")).stem
        if mesh.get("name", stem) in MODULE_MESHES:
            scale = float(mesh.get("scale", "1 1 1").split()[0])
            assets[mesh.get("name", stem)] = trimesh.load(src / "assets" / mesh.get("file")).centroid * scale
    moves = apply_layout(side, root_body, assets, layout)
    moves["thumb"] = apply_thumb(side, root_body, assets, thumb)

    if plate_mesh:  # same part frame as the stock plate, but in mm like the other cad/ exports
        for mesh in mj.find("asset").iter("mesh"):
            if mesh.get("file") == side["plate"] + ".stl":
                mesh.set("name", side["plate"])
                mesh.set("file", plate_mesh)
                mesh.set("scale", "0.001 0.001 0.001")

    indent(tree)
    text = ET.tostring(mj, encoding="unicode").replace(" />", "/>")
    header = "".join((src / "robot.xml").read_text().splitlines(keepends=True)[:3]) + (
        "<!-- 5-digit variant: finger5 (pinky) added and the finger and thumb modules placed (cad/five_finger/layout.py) by "
        "Demo/AHSimulation/five_finger/build_5f_model.py. Do not edit by hand. -->\n"
    )
    (dst / "robot.xml").write_text(header + text + "\n")
    return T, moves


# ---------------------------------------------------------------- finger-module layout
MODULE_MESHES = ("scs0009", "finger_frame_1", "finger_frame_2", "bushing_0608_04")  # palm-fixed parts of a module
FINGER_NUM = {"index": 1, "middle": 2, "ring": 3, "pinky": 5, "thumb": 4}
FINGER_BODIES = {1: ["custom_servo_horn", "rotule_ball_2"], 2: F2_BODIES, 3: F3_BODIES, 5: ["custom_servo_horn_5", "rotule_ball_10"],
                 4: ["custom_servo_horn_4", "rotule_ball_8"]}


def quat_z(R_cad2root, deg):
    """Quaternion (root frame) of a rotation by deg about CAD z."""
    q = np.zeros(4)
    mujoco.mju_axisAngle2Quat(q, R_cad2root @ np.array([0.0, 0.0, 1.0]), np.radians(deg))
    return q


def layout_transforms(side, root_body, layout):
    """{finger: function(pose) -> pose} in the root frame, from cad/five_finger/layout.py."""
    tf = LAYOUT.transforms(layout)
    if side["root"].startswith("l_"):
        tf = LAYOUT.mirrored(tf)
    plate_p, plate_q = get_pose(part_geoms(root_body)[side["plate"]][1])
    R = np.zeros(9)
    mujoco.mju_quat2Mat(R, plate_q)
    R = R.reshape(3, 3)
    out = {}
    for f, (phi, p0, p1) in tf.items():
        site = get_pose(child_by_name(root_body, "site", f"closing_1 ({FINGER_NUM[f]})_2"))[0]
        assert np.allclose(R.T @ (site - plate_p) * 1000, p0, atol=0.01), f"{f}: knuckle not at the layout's stock pivot"
        q = quat_z(R, phi)
        p0r, p1r = plate_p + R @ p0 / 1000, plate_p + R @ p1 / 1000

        def move(pose, q=q, p0r=p0r, p1r=p1r):
            pos, quat = pose
            return rotate(q, pos - p0r) + p1r, quat_mul(q, quat)
        out[f] = (move, (phi, p0, p1), R, plate_p)
    return out


def apply_layout(side, root_body, assets, layout):
    """Move every finger module (palm-fixed parts, closing sites, motor chains) by the layout."""
    moves = layout_transforms(side, root_body, layout)
    if all(abs(t[1][0]) < 1e-9 and np.allclose(t[1][1], t[1][2]) for t in moves.values()):
        return moves
    # palm-fixed parts of each module, found geometrically (mesh centroid in the module's stock frame)
    owner = {}
    for name, (_, g) in part_geoms(root_body).items():
        mesh = g.get("mesh")
        if mesh not in MODULE_MESHES:
            continue
        pos, quat = get_pose(g)
        c = pos + rotate(quat, assets[mesh])
        for f, (_, (phi, p0, _p1), R, plate_p) in moves.items():
            d = (R.T @ (c - plate_p) * 1000 - p0)[:2]
            ang = np.radians(LAYOUT.STOCK[f][1] if side["root"].startswith("r_") else -LAYOUT.STOCK[f][1])
            local = np.array([d[0] * np.cos(ang) - d[1] * np.sin(ang), d[0] * np.sin(ang) + d[1] * np.cos(ang)])
            if abs(local[0]) < 16 and -55 < local[1] < 12:
                assert name not in owner, f"{name} claimed by two modules"
                owner[name] = f
    geoms = part_geoms(root_body)
    for f, (move, *_rest) in moves.items():
        parts = [n for n, o in owner.items() if o == f]
        assert len(parts) == 6, f"{f}: module parts {parts}"
        for n in parts:
            set_pose(geoms[n][1], move(get_pose(geoms[n][1])))
        n = FINGER_NUM[f]
        for el in [child_by_name(root_body, "site", f"closing_1 ({n})_2"), child_by_name(root_body, "site", f"closing_1 ({n})_2_z")] + \
                  [child_by_name(root_body, "body", b) for b in FINGER_BODIES[n]]:
            set_pose(el, move(get_pose(el)))
    print(f"layout '{layout}': " + ", ".join(f"{f} {t[1][0]:+.2f} deg, knuckle {np.round(t[1][2][:2], 2).tolist()}"
                                           for f, t in moves.items()))
    return moves


# ---------------------------------------------------------------- thumb-module mount
THUMB_SITES = ["closing_1 (4)_2", "closing_1 (4)_2_z"]  # the knuckle site's frame is the thumb module's frame


def apply_thumb(side, root_body, assets, mount=None):
    """Move the thumb module rigidly by layout.thumb_transform(mount): its palm-fixed parts (servos, finger frames,
    bushings; found geometrically, in the module frame), its knuckle sites and both motor chains. The thumb, its drive,
    kinematics and calibration are unchanged; only where it sits on the palm changes. Returns (move, transform, R, plate_p)
    like apply_layout (move: pose in the root frame -> moved pose)."""
    tf = LAYOUT.thumb_transform(mount)
    if side["root"].startswith("l_"):
        tf = LAYOUT.thumb_mirrored(tf)
    Rc, p0, p1 = tf
    plate_p, plate_q = get_pose(part_geoms(root_body)[side["plate"]][1])
    R = np.zeros(9)
    mujoco.mju_quat2Mat(R, plate_q)
    R = R.reshape(3, 3)
    site_p, site_q = get_pose(child_by_name(root_body, "site", THUMB_SITES[0]))
    assert np.allclose(R.T @ (site_p - plate_p) * 1000, p0, atol=0.01), "thumb: knuckle not at the layout's stock pivot"
    Q = R @ Rc @ R.T  # the CAD rotation, in the root frame
    q = np.zeros(4)
    mujoco.mju_mat2Quat(q, Q.ravel())
    t_root = plate_p + R @ p1 / 1000 - Q @ (plate_p + R @ p0 / 1000)

    def move(pose):
        pos, quat = pose
        return Q @ pos + t_root, quat_mul(q, quat)

    if np.allclose(Rc, np.eye(3)) and np.allclose(p0, p1):
        return move, tf, R, plate_p
    Rs = np.zeros(9)
    mujoco.mju_quat2Mat(Rs, site_q)
    Rs = Rs.reshape(3, 3)
    geoms = part_geoms(root_body)
    parts = []
    for name, (_, g) in geoms.items():
        if g.get("mesh") not in MODULE_MESHES:
            continue
        pos, quat = get_pose(g)
        u, v, w = Rs.T @ (pos + rotate(quat, assets[g.get("mesh")]) - site_p) * 1000  # module frame, mm
        if abs(u) < 16 and -55 < v < 12 and -25 < w < 25:
            parts.append(name)
    assert len(parts) == 6, f"thumb: module parts {parts}"
    for n in parts:
        set_pose(geoms[n][1], move(get_pose(geoms[n][1])))
    for el in [child_by_name(root_body, "site", s) for s in THUMB_SITES] + \
              [child_by_name(root_body, "body", b) for b in FINGER_BODIES[4]]:
        set_pose(el, move(get_pose(el)))
    ang = np.degrees(np.arccos(np.clip((np.trace(Rc) - 1) / 2, -1, 1)))
    print(f"thumb mount '{mount or LAYOUT.THUMB_MOUNT}': {ang:.2f} deg turn, knuckle {np.round(p0, 2).tolist()} -> "
          f"{np.round(p1, 2).tolist()} (CAD mm); parts {parts}")
    return move, tf, R, plate_p


def build_scene(side, T, moves):
    text = (side["src"] / "scene.xml").read_text()
    tree = parse(side["src"] / "scene.xml")
    f3 = child_by_name(tree.getroot().find("worldbody"), "body", "finger3_target")
    pos, quat = apply(T, get_pose(f3))
    target5 = (
        f'        <body name="finger5_target" pos="{fmt(pos)}" quat="{fmt(quat)}" mocap="true">\n'
        '          <geom type="sphere" size=".01" contype="0" conaffinity="0" rgba="1 0. 0. .2"/>\n'
        "        </body>\n\n"
    )
    anchor = "    </worldbody>"
    assert anchor in text
    text = text.replace(anchor, target5 + anchor)
    # the IK targets move with their finger modules (the hand root is the world frame)
    for f, (move, *_rest) in moves.items():
        pat = re.compile(rf'(<body name="finger{FINGER_NUM[f]}_target" )pos="([^"]+)" quat="([^"]+)"')
        mo = pat.search(text)
        pose = (np.array(mo.group(2).split(), float), np.array(mo.group(3).split(), float))
        pos, quat = move((pose[0], pose[1] / np.linalg.norm(pose[1])))
        text = text[:mo.start()] + f'{mo.group(1)}pos="{fmt(pos)}" quat="{fmt(quat)}"' + text[mo.end():]
    (side["dst"] / "scene.xml").write_text(text)


# 5-finger palm/back shells and grip pad from cad/five_finger/make_5f_shells.py: (part, rgba); white shells, black TPU pad
SHELL_PARTS = [("Top_Shell", "0.95 0.95 0.96 1"), ("Palm_Shell", "0.92 0.93 0.94 1"), ("Palm_Pad_Palm", "0.07 0.07 0.08 1")]


def build_shell_scene(side):
    """scene_shells.xml: scene.xml plus the shells and pads as static visual meshes on the palm."""
    letter = "R" if side["root"].startswith("r_") else "L"
    srcs = [CAD_STL / f"{letter}-{part}_5F.stl" for part, _ in SHELL_PARTS]
    if not all(p.exists() for p in srcs):
        print("shells not found, skipping scene_shells.xml (run cad/five_finger/make_5f_shells.py)")
        return
    root = parse(side["dst"] / "robot.xml").getroot().find("worldbody/body")
    pos, quat = get_pose(part_geoms(root)[side["plate"]][1])  # all CAD parts share the plate's frame
    assets, geoms = [], []
    for (part, rgba), src in zip(SHELL_PARTS, srcs):
        name = f"{letter.lower()}_{part.lower()}_5f"
        shutil.copy2(src, side["dst"] / "assets" / f"{name}.stl")
        assets.append(f'        <mesh name="{name}" file="{name}.stl" scale="0.001 0.001 0.001"/>')
        geoms.append(f'          <geom type="mesh" mesh="{name}" rgba="{rgba}" contype="0" conaffinity="0" group="2"/>')
    text = (side["dst"] / "scene.xml").read_text()
    shells = ("    <asset>\n" + "\n".join(assets) + "\n    </asset>\n\n"
              "    <worldbody>\n"
              f'        <!-- palm/back shells and grip pads (static: the palm is fixed to the world) -->\n'
              f'        <body name="shells" pos="{fmt(pos)}" quat="{fmt(quat)}">\n' + "\n".join(geoms) + "\n        </body>\n"
              "    </worldbody>\n")
    anchor = '    <include file="keyframes.xml"/>'
    assert anchor in text
    (side["dst"] / "scene_shells.xml").write_text(text.replace(anchor, shells + anchor))


def write_keyframe(dst, qpos, ctrl=None):
    (dst / "keyframes.xml").write_text(
        "<mujoco>\n  <keyframe>\n    <key name=\"zero\"\n         qpos=\""
        + " ".join(f"{x:.6g}" for x in qpos)
        + ("" if ctrl is None or not np.any(ctrl) else "\"\n         ctrl=\"" + " ".join(f"{x:.6g}" for x in ctrl))
        + "\"\n         />\n  </keyframe>\n</mujoco>\n"
    )


def home_ctrl(m, left=False):
    """Home ctrl (rad): every finger at 0, the thumb at layout.clamp_thumb(0, 0) - with a re-mounted thumb, (0, 0) can
    lie outside its command envelope (the slim mount: inside the palm shell); (0, 22.5) deg for the slim mount, mirrored
    on the left hand."""
    c = np.zeros(m.nu)
    t = LAYOUT.clamp_thumb(0.0, 0.0, side="left" if left else "right")
    for k, name in enumerate(("finger4_motor1", "finger4_motor2")):
        c[mujoco.mj_name2id(m, mujoco.mjtObj.mjOBJ_ACTUATOR, name)] = np.radians(t[k])
    return c


def move_thumb_target(dst, m, d0, d1):
    """Move the thumb's IK target (finger4_target) in scene.xml / scene_shells.xml with the thumb tip from pose d0 to
    pose d1 (MjData; the hand root is the world frame)."""
    b = m.site_bodyid[mujoco.mj_name2id(m, mujoco.mjtObj.mjOBJ_SITE, "tip4")]
    R0, R1 = d0.xmat[b].reshape(3, 3), d1.xmat[b].reshape(3, 3)
    R = R1 @ R0.T
    t = d1.xpos[b] - R @ d0.xpos[b]
    qR = np.zeros(4)
    mujoco.mju_mat2Quat(qR, R.ravel())
    pat = re.compile(r'(<body name="finger4_target" )pos="([^"]+)" quat="([^"]+)"')
    for f in ("scene.xml", "scene_shells.xml"):
        if not (dst / f).exists():
            continue
        text = (dst / f).read_text()
        mo = pat.search(text)
        pos, quat = np.array(mo.group(2).split(), float), np.array(mo.group(3).split(), float)
        q = np.zeros(4)
        mujoco.mju_mulQuat(q, qR, quat / np.linalg.norm(quat))
        text = text[:mo.start()] + f'{mo.group(1)}pos="{fmt(R @ pos + t)}" quat="{fmt(q)}"' + text[mo.end():]
        (dst / f).write_text(text)


def settle_keyframe(side):
    """Settle the new model at the home ctrl (home_ctrl: 0, the thumb inside its envelope) from the stock keyframe
    (+ finger3's values for finger5); the thumb's IK target follows its tip to the home pose."""
    src, dst = side["src"], side["dst"]
    stock = mujoco.MjModel.from_xml_path(str(src / "scene.xml"))
    q_stock = stock.key_qpos[0].copy()

    (dst / "keyframes.xml").write_text("<mujoco><keyframe/></mujoco>\n")  # the old 68-value key would not compile
    m = mujoco.MjModel.from_xml_path(str(dst / "scene.xml"))
    d = mujoco.MjData(m)

    def qadr(model, joint):
        return model.jnt_qposadr[mujoco.mj_name2id(model, mujoco.mjtObj.mjOBJ_JOINT, joint)]

    d.qpos[: stock.nq] = q_stock
    f3 = slice(qadr(stock, "finger3_motor1"), qadr(stock, "finger4_motor1"))  # finger3 = both of its chains
    d.qpos[stock.nq:] = q_stock[f3]
    d.ctrl[:] = 0
    for _ in range(5000):  # 10 s
        mujoco.mj_step(m, d)
    assert np.all(np.isfinite(d.qpos))
    print(f"settled keyframe: max |qvel| = {np.abs(d.qvel).max():.2e}, "
          f"stock part max |dq| = {np.abs(d.qpos[:stock.nq] - q_stock).max():.2e}, "
          f"finger5 vs finger3 max |dq| = {np.abs(d.qpos[stock.nq:] - d.qpos[f3]).max():.2e}")
    home = home_ctrl(m, left=side["root"].startswith("l_"))
    if np.any(home):   # the thumb's home is not (0, 0): settle it there and move its IK target along
        d0 = copy.copy(d)
        d.ctrl[:] = home
        for _ in range(5000):
            mujoco.mj_step(m, d)
        assert np.all(np.isfinite(d.qpos))
        move_thumb_target(dst, m, d0, d)
        print(f"  thumb home {np.round(np.degrees(home[[mujoco.mj_name2id(m, mujoco.mjtObj.mjOBJ_ACTUATOR, a) for a in ('finger4_motor1', 'finger4_motor2')]]), 2).tolist()} deg "
              f"(layout.clamp_thumb(0, 0)): max |qvel| = {np.abs(d.qvel).max():.2e}")
    write_keyframe(dst, d.qpos, d.ctrl)


def main():
    ap = argparse.ArgumentParser(description=__doc__, formatter_class=argparse.RawDescriptionHelpFormatter)
    ap.add_argument("--keyframe", action="store_true", help="regenerate keyframes.xml by settling at the home ctrl (0; the thumb at layout.clamp_thumb(0, 0))")
    ap.add_argument("--stock-plate", action="store_true", help="use the stock 3-finger palm plate mesh")
    ap.add_argument("--side", choices=SIDES, default="right")
    ap.add_argument("--layout", choices=["parallel", "stock"], default=LAYOUT.LAYOUT, help="finger-module layout")
    ap.add_argument("--thumb", choices=list(LAYOUT.THUMB_MOUNTS), default=LAYOUT.THUMB_MOUNT, help="thumb-module mount")
    args = ap.parse_args()
    side = SIDES[args.side]
    src, dst = side["src"], side["dst"]

    (dst / "assets").mkdir(parents=True, exist_ok=True)
    for stl in src.glob("assets/*.stl"):
        shutil.copy2(stl, dst / "assets" / stl.name)
    for f in ("joints_properties.xml", "additional.xml"):
        shutil.copy2(src / f, dst / f)

    plate = None
    if not args.stock_plate and side["plate_src"].exists():
        plate = side["plate"] + "_5f.stl"
        shutil.copy2(side["plate_src"], dst / "assets" / plate)
    print(f"palm plate mesh: {plate or side['plate'] + '.stl (stock, 3 fingers + thumb)'}")
    if side["iface_src"].exists():   # the hand adapter's interface plate (CAD mm) over the stock interface mesh (m)
        trimesh.load(side["iface_src"]).apply_scale(0.001).export(dst / "assets" / f"{side['root']}.stl")
        print(f"wrist interface mesh: {side['iface_src'].name} (the hand adapter's interface plate)")

    T, moves = build_robot(side, plate, args.layout, args.thumb)
    build_scene(side, T, moves)
    build_shell_scene(side)
    if args.keyframe or not (dst / "keyframes.xml").exists():
        settle_keyframe(side)

    m = mujoco.MjModel.from_xml_path(str(dst / "scene.xml"))
    print(f"wrote {dst.relative_to(HERE.parent.parent.parent)}: nbody={m.nbody} njnt={m.njnt} nq={m.nq} "
          f"nu={m.nu} neq={m.neq} nkey={m.nkey} nmocap={m.nmocap}")


if __name__ == "__main__":
    main()
