molinzhao27/AmazingHand/(commit log)

2026-10-13 Add 5-digit right-hand MuJoCo model (AH_Right_5F)
    finger5 (pinky) is a rigid copy of finger3 (ring): its servos, finger
    frames, bushings, closing sites, both motor chains and their equality
    constraints are moved by the same transform that takes finger2 onto
    finger3 (7.5 deg about the palm normal + translation), so the pinky sits
    next to the ring finger exactly like the ring finger sits next to the
    middle finger. All names are unique (finger5_motor1/2, passive_ball13-15,
    closing_1 (5)_*, closing_3 (5)_*, closing_ball5_*, tip5, ...).
    finger5 is appended after the thumb so the stock qpos/ctrl/mocap layout
    is unchanged; the keyframe was regenerated by settling at ctrl = 0.
    The model is generate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
    [additional.xml, bushing_0608_04.stl, custom_servo_horn.stl, dist.stl, dist_shell.stl, distal.stl, distal_shell.stl, finger_frame_1.stl]
2026-10-13 Add widened right palm plate with a pinky mount (R-Hand_Plate_5F)
    cad/five_finger/make_5f_plate.py builds the plate with CadQuery from the
    stock R-Hand_Plate STEP: the ring finger's unit (servo window, pivot
    boss, screw holes, ribs and outer rim) is copied with the same
    finger2->finger3 step the MuJoCo model uses (-7.5 deg about the plate
    normal, read from the stock MJCF), a strip of the middle unit fills the
    stock plate's rounded corner at the seam, and a web of the stock back
    sheet/rim thickness connects the new unit down to the plate foot.
    Nothing of the stock plate is removed, so fingers 1-3 and the thumb mount
    exactly as before and the pinky mounts like the ring finger.
    STEP + STL (mm,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
    [R-Hand_Plate_5F.step, R-Hand_Plate_5F.stl, r_hand_plate_5f.stl, robot.xml]
2026-10-13 Add 5-finger verification, renders and notes
    - five_finger/verify_5f_model.py: load/naming checks, ring->pinky copy
    check, actuator sweeps (stability, equality-constraint error), a mesh
    interference sweep over a 9x9 grid per digit (ring/pinky vs the stock
    middle/ring pair, thumb, palm plate) and demo poses with a pinky.
    - five_finger/check_shells.py: clearance of the palm/top shells, which the
    MuJoCo export does not contain; shows the stock shells cannot be used
    with the pinky.
    - five_finger/render_5f_model.py + renders/, reports/ (5-finger and stock
    baseline runs).
    - FIVE_FINGER.md: placement rationale, results, CAD, BOM delta, servo
    IDs (pinky 9/10, left 19/20), power check a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
    [check_shells.py, render_5f_model.py, verify_5f_model.py]
2026-10-13 Add left-hand 5-digit model (AH_Left_5F) and mirrored plate
    - build_5f_model.py --side left builds AH_Left_5F from the stock AH_Left
    model. finger3's palm-fixed parts are now found geometrically (the parts
    that are an exact image of a finger2 part under the step), since the
    left export numbers its parts differently; AH_Right_5F is unchanged.
    - make_5f_plate.py also writes L-Hand_Plate_5F, the right plate mirrored
    about x = -50 mm, after checking that the stock L plate is exactly the
    mirrored R plate.
    - verify_5f_model.py / render_5f_model.py handle left models (part names
    mapped to the mirrored right parts, mirrored demo poses and cameras);
    left reports and renders added, notes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
    [L-Hand_Plate_5F.step, L-Hand_Plate_5F.stl, additional.xml, bushing_0608_04.stl, custom_servo_horn.stl, distal.stl, distal_shell.stl, finger_frame_1.stl]
2026-10-13 Add 5-finger palm/back shells and grip pads
    cad/five_finger/make_5f_shells.py generates new shells around the
    5-digit mechanism (the stock shells cut through the pinky's servo):
    implicit solids on a 0.5 mm voxel grid, built from keep-out volumes
    taken from the MuJoCo model with every digit swept over 19x19 motor
    poses. The walls enclose the plate, wrist interface, servos, frames,
    horns and push rods with >= 1 mm clearance and stay >= 1.2 mm from the
    moving finger and thumb parts. Styled after the user's reference: flat
    crowned back, sculpted palm with a thenar bulge, exposed knuckles, a
    smooth palm edge just under the finger sweeps, and two grey TPU grip
    pads (hex texture) in 1 mm recesses.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
    [L-Palm_Pad_Band_5F.stl, L-Palm_Pad_Palm_5F.stl, L-Palm_Shell_5F.stl, L-Top_Shell_5F.stl, R-Palm_Pad_Band_5F.stl, R-Palm_Pad_Palm_5F.stl, R-Palm_Shell_5F.stl, R-Top_Shell_5F.stl]
2026-10-13 Add 3-phalanx finger study, prototype model and concept CAD
    Answers 'what would it take to make 3 finger segments': keep the 2
    SCS0009 servos per finger and add a second passive four-bar.
    - analyze_stock_finger.py: the stock finger is already a crossed
    four-bar (Link input, gimbal ground, distal coupler, proximal output);
    planar model matches the sim within 0.06 deg; PIP ~ 0.92 MCP.
    - synth_linkage.py: 47/26/13.85 mm phalanges (stock overall length);
    loop 1 is the re-dimensioned stock four-bar (old distal -> middle),
    loop 2 a new crossed four-bar giving DIP = 0.70 PIP. Stock Link base,
    servos, horns, rods and gimbal unchanged. Reaches MCP 89 / PIP 78 /
    DIP 54 deg (stock 75 / 69)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
    [Finger_3S_assembly.step, L2_Coupler_3S.step, L2_Coupler_3S.stl, Link_3S.step, Link_3S.stl, P1_Proximal_3S.step, P1_Proximal_3S.stl, P1_Shell_3S.step]
2026-10-13 Add powered 2-DOF wrist and forearm base (AH_Right_5F_Wrist)
    - Ring Cardan gimbal 25 mm below the stock wrist interface (flexion on
    the forearm fork, deviation on the hand adapter, F683ZZ bearings, d3
    pins, 11 mm cable bore). Hand bolts on unchanged via an adapter keyed
    into the interface's pads (4 of its 6 holes on the 42 mm circle).
    - Parallel drive like the AmazingHand finger: 2x Feetech STS3215 C018
    (12 V, 30 kg.cm) in the forearm push M3 ball-link rods; flexion
    ~ (m1 - m2)/2, deviation ~ (m1 + m2)/2. ROM flexion +-60 deg,
    deviation +-25 deg tapering to +-15 at +-60 (clamp_wrist()).
    - Tapered two-piece forearm, servo frame, electronics bay, elbow flange
    (4x M5 on a 100 mm s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
    [Elbow_Flange.step, Elbow_Flange.stl, F683ZZ_+x.stl, F683ZZ_+z.stl, F683ZZ_-x.stl, F683ZZ_-z.stl, L-Forearm_Back.step, L-Forearm_Back.stl]
2026-10-14 Add styled finger shells with grey grip pads
    cad/five_finger/fingers/make_styled_finger_shells.py builds styled
    versions of the stock Proximal_Shell and Distal_Shell with CadQuery,
    fitting the stock finger kit unchanged (inner/attachment surfaces kept,
    0 mm3 removed from the stock shells):
    - separate grey TPU grip pads in a 0.45 mm raised rim on the palm side:
    a U-shaped fingertip pad with concentric (fingerprint-like) grooves
    and a tapered chevron pad on the proximal; 0.1 mm glue gap;
    - a 0.3 mm raised nail plate on the back of the fingertip;
    - no growth on the sides (ring/pinky contacts stay 887/6561, same set).
    The stock shells are 1.0 mm thick, so the pads sit on top of the stock
    wal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
    [Distal_Pad.step, Distal_Pad.stl, Distal_Pad_print.stl, Distal_Shell_Styled.step, Distal_Shell_Styled.stl, Proximal_Pad.step, Proximal_Pad.stl, Proximal_Pad_print.stl]
2026-10-14 Notes: styled finger shells, wrist/forearm and 3-phalanx study
2026-10-14 Add slim fingers (AH_Right_5F_Slim)
    cad/five_finger/slim_fingers/make_slim_fingers.py: new TPU shells that
    hug the PLA cores (0.25 mm clearance, >= 1.2 mm wall), Ø7.2 spot faces at
    the shell screws and a rounded distal tip on the cores; pins, hinge axes,
    Link, Gimbal, rods and servo drive unchanged (shell screws M2.5x5).
    Proximal 23.8 -> 19.4 mm (-18 %), distal 21.5 -> 14.9 mm (-31 %);
    exposed knuckles and a textured fingertip pad.
    Verified on a 9x9 grid per digit: no new self-contacts (36-44 stock ones
    disappear per digit), ring/pinky touching 712 vs 887, index/middle 783
    vs 973, no contacts with the palm shells/pads. width_analysis.py breaks
    down what sets the width; README covers printa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
    [Distal_Pad_Slim.stl, Distal_Pad_Slim_untextured.step, Distal_Shell_Slim.step, Distal_Shell_Slim.stl, Distal_Shell_Slim_OnePiece.stl, Distal_Slim.step, Distal_Slim.stl, Proximal_Shell_Slim.step]
2026-10-14 Add full-build showcase: wrist + slim fingers + shells
    - build_wrist_model.py --hand AH_Right_5F_Slim builds the wrist/forearm
    around any 5-digit hand variant (default output unchanged) and always
    copies the 5F palm shells/pads for scene_shells.xml.
    - AH_Right_5F_Slim_Wrist: forearm, powered wrist, slim fingers, palm/back
    shells and grip pads (12 actuators).
    - render_showcase.py + renders/showcase.jpg: six poses with the wrist.
    - FIVE_FINGER.md: slim fingers, full build, BOM/IDs/power pointers for
    the wrist.
    [additional.xml, distal_pad_slim.stl, distal_shell_slim.stl, distal_slim.stl, joints_properties.xml, keyframes.xml, proximal_shell_slim.stl, proximal_slim.stl]
2026-10-14 make_5f_shells.py: --model/--out to fit shells to other hand variants
    Samples primitive geoms (pins, links) as well as meshes for the keep-out
    volumes, reads the knuckle line from the chosen model and logs paths
    outside the repo. Default output is unchanged (verified byte-for-byte,
    with and without the keep-out cache).
2026-10-14 Add peace-sign and middle-finger poses (hand_poses.py)
    Poses are defined by intent (straight/curled + spread) and resolved per
    model, then settled and checked for digit-digit clearance. Rendered on
    the slim hand with the wrist.
    [hand_poses.py]
2026-10-14 Centre the forearm on the four fingers; reshape the palm to match
    The stock hand fans its fingers towards the pinky (index along CAD y,
    each next finger 7.5 deg further out), so with a pinky added the hand
    leaned ~11 deg to the ulnar side and the forearm sat ~24 mm towards the
    index: the pinky looked stuck on.
    - wrist_design: the wrist frame W is turned HAND_YAW = 10.5 deg about the
    palm normal (the mean finger direction) and the forearm axis passes
    through the knuckle centroid; C follows from the adapter geometry.
    Fingers now fan symmetrically (-10.2 .. +10.8 deg) and the knuckle line
    arcs down to the pinky (-14 mm) like a human hand.
    - make_wrist: every part is built in W and plac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
    [Elbow_Flange.step, Elbow_Flange.stl, F683ZZ_+x.stl, F683ZZ_+z.stl, F683ZZ_-x.stl, F683ZZ_-z.stl, L-Forearm_Back.step, L-Forearm_Back.stl]
2026-10-14 Lengthen the palm by 20 mm; straight fingers parallel to the forearm
    - wrist_design.PALM_EXT = 20: the wrist sits 20 mm further from the hand
    and the palm shells reach down to it, so the thumb sits higher above
    the wrist (palm 113 mm for 87 mm fingers, a human ratio).
    - make_wrist: the taller hand adapter is hollow (6 mm top flange, 4 mm
    wall, 45 deg conical roof to the cable bore; 52 g), screw access from
    below kept.
    - make_5f_shells: the wrist cut follows the wrist (W y fixed), grid
    extended down.
    - With the longer palm the over-extended thumb clears the forearm by
    >= 7.6 mm everywhere, so thumb_flexion_min() no longer limits it
    (it still does if PALM_EXT < 20).
    - hand_poses: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
    [Elbow_Flange.step, Elbow_Flange.stl, F683ZZ_+x.stl, F683ZZ_+z.stl, F683ZZ_-x.stl, F683ZZ_-z.stl, L-Forearm_Back.step, L-Forearm_Back.stl]
2026-10-14 Parallel finger layout at 30 mm pitch (closer fingers)
    cad/five_finger/layout.py places each finger module (finger, 2 servos,
    frames, bushings, both push-rod linkages) rigidly: parallel to the
    forearm axis at a 30 mm knuckle pitch (stock fan: ~33.3 mm), same knuckle
    arc, knuckle centroid unchanged (the wrist design does not change).
    30 mm is the floor for the stock drive: the push-rod end levers are
    28.4 mm across; at 30 mm parallel fingers keep 1.2-1.8 mm between drives
    over a +-30 deg abduction x full flexion envelope.
    - build_5f_model: layout step after adding the pinky (--layout stock
    keeps the fan); IK targets move with their modules.
    - make_5f_plate (rewritten with a subagent): fing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
    [L-Hand_Plate_5F.step, L-Hand_Plate_5F.stl, L-Palm_Pad_Band_5F.stl, L-Palm_Pad_Palm_5F.stl, L-Palm_Shell_5F.stl, L-Top_Shell_5F.stl, R-Hand_Plate_5F.step, R-Hand_Plate_5F.stl]
2026-10-14 Sculpt the palm/back shells into a hand shape
    The shells were the convex hull of the mechanism with a flat back, which read as a box. make_5f_shells.py
    now lays the outer form out along the forearm axis as a smooth union of a palm slab (straight sides, domed
    back with a transverse arch and knuckle bumps, wedge-shaped palm with a hollow), a round wrist neck the palm
    waists into, and thenar/hypothenar mounds; it is lifted smoothly wherever the mechanism needs room. Adds
    panel lines (a knuckle band on the back, a line around the wrist), rounded opening edges, and one large
    black ribbed TPU grip pad with an even border around the palm and the thumb opening (replaces the two grey
    pads). The thumb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
    [L-Palm_Pad_Band_5F.stl, L-Palm_Pad_Palm_5F.stl, L-Palm_Shell_5F.stl, L-Top_Shell_5F.stl, R-Palm_Pad_Band_5F.stl, R-Palm_Pad_Palm_5F.stl, R-Palm_Shell_5F.stl, R-Top_Shell_5F.stl]
2026-10-14 Restyle the forearm as a tapered oval with a wrist cuff; bevel the palm's wrist edge
    Forearm (make_wrist.py, wrist_design.FOREARM_KEYS): one smooth loft of superellipse sections (n 2.7-2.8),
    narrowest at the wrist (83 x 79 mm), swelling to a muscle belly (100 x 92) in the elbow-side third, with a
    1.5 mm proud cuff ring at the wrist (rounded fork cap, V panel line) and a matching superellipse elbow
    flange. The servo frame is unchanged; it seats on new ribs, pads and side bosses at the old wall planes,
    with recessed countersunk M3x10 / M3x12. Internal clearances are unchanged (horn arms 0.78 mm, rods
    1.25 mm, adapter 1.06 mm); printed forearm parts 239 -> 264 g.
    Palm shells: the wrist cut now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
    [Elbow_Flange.step, Elbow_Flange.stl, L-Forearm_Back.step, L-Forearm_Back.stl, L-Forearm_Front.step, L-Forearm_Front.stl, L-Palm_Shell_5F.stl, L-Wrist_Fork.step]
2026-10-14 Add the styled 3-phalanx finger and the AH_Right_5F_3S hand
    cad/five_finger/ultimate_finger merges the 3-phalanx linkage study, the slim TPU shells and the styled
    pads into one buildable finger on the stock two-servo drive: MCP 89 / PIP 78 / DIP 54 deg, 15.8 / 15.0 /
    13.5 mm wide. Styled after the user's reference hand: white rounded-rectangle sleeves, black ribbed TPU
    pads on every phalanx, and a nail-like fingertip cap the pad wraps. Includes a x0.88 pinky (S088), STEP/STL,
    CAD checks and figures, and the strength analysis (set SCS0009 max_torque_limit = 800).
    Demo/AHSimulation/ultimate_finger builds the single-finger and 5-digit sim models (AH_Right_5F_3S, links in
    metal greys) and verif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
    [Thumb_Distal_Pad.stl, Thumb_Distal_Pad_untextured.step, Thumb_Distal_Shell.step, Thumb_Distal_Shell.stl, Thumb_Proximal_Pad.stl, Thumb_Proximal_Pad_untextured.step, Thumb_Proximal_Shell.step, Thumb_Proximal_Shell.stl]
2026-10-14 Fit the palm shells to both finger types; put the 3-phalanx hand on the wrist
    make_5f_shells.py takes several hand models and clears the merged moving parts of all of them; by default
    AH_Right_5F (2-phalanx) and AH_Right_5F_3S (3-phalanx), so one set of shells fits either finger. The 3-phalanx
    fist curls deeper, so the palm's top edge sits lower and the grip pad is 52 cm2. check_shells: no contacts on
    the right, left, slim and 3-phalanx hands (closest: 3-phalanx pinky 1.50 mm, left thumb 1.14 mm).
    AH_Right_5F_3S_Wrist (build_wrist_model.py --hand AH_Right_5F_3S); verify_wrist_model.py --model checks any
    wrist model: hand vs forearm > 5 mm on the operating ROM, 3.55 mm at the stop corner, se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
    [L-Palm_Pad_Palm_5F.stl, L-Palm_Shell_5F.stl, R-Palm_Pad_Palm_5F.stl, R-Palm_Shell_5F.stl, additional.xml, bushing_0608_04.stl, custom_servo_horn.stl, distal_slim.stl]
2026-10-14 Add a Blender product-shot render pipeline for the full build
    Demo/AHSimulation/render: export_pose.py poses a MuJoCo model (hand + wrist), settles it and exports every
    visible mesh in world space to GLB with a material class (white plastic, black TPU, metal, dark plastic);
    blender_render.py renders it headless in Blender (Cycles on Metal, studio soft boxes on a cyclorama, glossy
    white plastic, ribbed black rubber, satin metal); render_beauty.py renders the shot list (hero, peace,
    pointing, OK, back, finger close-up) in about 30 s per 2000x1500 frame on an M5 Pro.
2026-10-14 Slim the forearm and the elbow flange
    The forearm no longer has to be wider than deep: the shell hugs the horn-arm tips and servo corners (0.25 mm over
    the required clearances), waists in under a lighter 1 mm cuff, and tapers to the elbow: 71 x 75 mm under the cap,
    79 x 84 at the servos, 74 x 74 at the elbow (was 86 x 82 / 90-93 x 86-87 / 98 x 90). The servo frame's side blocks
    stop at the horn arms and its palm-side corners are chamfered (all four frame screws M3x8, recessed). The elbow
    flange is a 116 mm superellipse with the M5 stand screws on an 80 mm square (was 138 x 130, 100 mm square).
    Internal clearances unchanged; hand vs forearm > 5 mm on the operating ROM and 6.75 mm at the stop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
    [Elbow_Flange.step, Elbow_Flange.stl, L-Forearm_Back.step, L-Forearm_Back.stl, L-Forearm_Front.step, L-Forearm_Front.stl, L-Wrist_Fork.step, L-Wrist_Fork.stl]
2026-10-14 Restyle the 3-phalanx finger covers after the reference hands
    Covers rebuilt as implicit solids: capsule segments with ends rounded about their joint pins, a black ribbed
    TPU glove over the palm half of every segment and a smooth white back, and a fingertip 5 mm longer (DIP to tip
    24.8 mm) that tapers to a rounded point (13.3 -> 8.2 mm, 4 mm nose radius) with the glove wrapping the end.
    Proximal / middle covers 16.9 x 19.4 and 15.9 x 15.3 mm; the thumb gets the same glove. Fixes feathered cover
    rims (now full thickness, with a thin-rim check). Pinky (x0.88) likewise.
    Checks: covers >= 1.22 mm skin, 0 overlap with their cores, >= 0.61 mm from everything moving past them; single
    finger PASS;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
    [Thumb_Distal_Pad.stl, Thumb_Distal_Pad_untextured.step, Thumb_Distal_Shell.step, Thumb_Distal_Shell.stl, Thumb_Proximal_Pad.stl, Thumb_Proximal_Pad_untextured.step, Thumb_Proximal_Shell.step, Thumb_Proximal_Shell.stl]
2026-10-15 Slim the wrist connector and re-mount the thumb along the palm's edge
    - Hand adapter: the stock interface plate now ends in a d42 neck (ADAPTER_R 21, MOUNT_Y -95); the old thumb seat
    is filled and the plate trimmed below z -33, so the heel sits ~7 mm higher.
    - Thumb: layout.THUMB_MOUNTS["slim"] turns the whole thumb module 101.4 deg so its servo pack lies along the
    palm's radial edge; the pack bottoms out at CAD z -25.9 instead of -51.1 (palm parts 72.4 -> 54.7 mm thick).
    The plate gets its own thumb unit; models, keyframes and IK targets follow.
    - Thumb command envelope (layout.THUMB_ENVELOPE, thumb_command_ok, clamp_thumb): clear of the palm parts and
    >= 1.2 mm off the closed palm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
    [Elbow_Flange.step, L-Forearm_Back.step, L-Forearm_Front.step, L-Hand_Plate_5F.step, L-Hand_Plate_5F.stl, L-Wrist_Fork.step, L-Wrist_Fork.stl, L-Wrist_Hand_Adapter.step]
2026-10-15 Refit the palm shells around the re-mounted thumb; slimmer, rounder palm
    - Thenar: a superquadric around the thumb's servo pack in the thumb module's frame, capped at the back's height;
    palm slab narrower on the radial side, back 1 mm lower (3 mm arch), heel 6 mm higher, wrist neck d51 around the
    d42 adapter. Shells are up to 19 mm thinner, and up to 30 mm wider across the thenar.
    - The keep-out sweeps the thumb only inside its command envelope; its opening is cut within 37 mm of the knuckle
    (THUMB_ROOT_R), beyond which the envelope keeps it off the closed shell. Pad stays off the thenar (56 cm2); the
    palm flange stops short of the thumb module.
    - check_shells reports the thumb insid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
    [L-Palm_Pad_Palm_5F.stl, L-Palm_Shell_5F.stl, L-Top_Shell_5F.stl, R-Palm_Pad_Palm_5F.stl, R-Palm_Shell_5F.stl, R-Top_Shell_5F.stl, keyframes.xml, l_hand_plate_5f.stl]
2026-10-15 Export the wrist and plate STLs with an absolute 0.01 mm deflection
    cq.exporters.export scales the STL tolerance by each face's size, so the
    forearm shells were faceted by up to 0.84 mm (front 0.71, flange 0.28,
    adapter 0.11, fork 0.10, plate 0.055). make_wrist.py and make_5f_plate.py
    now mesh with BRepMesh_IncrementalMesh at an absolute 0.01 mm / 0.1 rad,
    MinSize 0.1 mm (OCC's default MinSize left ~0.04 mm patches on the loft
    skin). Every wrist STL is now within 0.0194 mm of its STEP, the plates
    within 0.021 mm; all wrist parts watertight. Forearm shells ~5.9 MB each.
    STEP geometry is unchanged.
    Not yet redone: palm shells, sim models, README result numbers, assembly.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
    [Elbow_Flange.stl, F683ZZ_+x.stl, F683ZZ_+z.stl, F683ZZ_-x.stl, F683ZZ_-z.stl, L-Forearm_Back.stl, L-Forearm_Front.stl, L-Hand_Plate_5F.stl]
2026-10-16 Rebuild the palm shells and sim models from the finer wrist STLs
    Followed the wrist README's chain after make_wrist.py: make_5f_shells.py
    (the palm shell moves by <= 0.012 mm: it voxelises the adapter STL),
    build_5f_model.py (right + left: plate and adapter interface meshes),
    build_slim_model.py, ultimate_finger/build_models.py --no-finger and
    build_wrist_model.py --keyframe for the three hands. Every model loads and
    steps; verify_wrist_model.py passes for AH_Right_5F_Wrist and
    AH_Right_5F_3S_Wrist with the same clearances on the operating ROM (hard
    stops within the README's ranges). Each wrist model's assets grow from
    ~31 to ~46 MB.
    Wrist README: refreshed the make_wrist.py results that mo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
    [L-Palm_Shell_5F.stl, R-Palm_Shell_5F.stl, keyframes.xml, l_hand_plate_5f.stl, l_palm_shell_5f.stl, l_wrist_interface.stl, r_hand_plate_5f.stl, r_palm_shell_5f.stl]
2026-10-16 Add an assembled CAD of the final 5-digit right hand
    cad/five_finger/assembly/make_assembly.py takes the assembly from the sim
    model AH_Right_5F_3S_Wrist (zero keyframe; MuJoCo's mesh_pos/mesh_quat
    offsets undone) and writes it in the hand's CAD frame (mm):
    - AH_Right_5F_3S_Wrist_assembly.step: the 98 parts that have a B-rep (their
    STEP, the stock parts registered onto the sim STLs by ICP, the wrist's
    bought-part envelopes rebuilt from make_wrist.py), in sub-assemblies
    palm/index/middle/ring/pinky/thumb/wrist, named per part and coloured.
    - AH_Right_5F_3S_Wrist_assembly.3mf: all 255 parts as the sim meshes,
    including the 157 mesh-only ones (shells, covers, pads, UF_P3_Distal,
    the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
    [AH_Right_5F_3S_Wrist_assembly.3mf, AH_Right_5F_3S_Wrist_assembly.step]
2026-10-16 Regenerate the assembled CAD from the rebuilt AH_Right_5F_3S_Wrist
    make_assembly.py rerun on the sim model rebuilt from the finer wrist and
    plate STLs (re-settled zero keyframe; wrist at -0.107 / +0.168 deg). The
    report's CAD -> sim column now shows the STLs' accuracy: forearm back
    0.84 -> 0.012 mm, front 0.69 -> 0.013, flange 0.28 -> 0.010, adapter
    0.10 -> 0.010, plate 0.055 -> 0.018. Its sim -> CAD max rises to 0.028 mm
    (forearm back, limit 0.05): that is the 0.002 mm reference tessellation's
    own sag; the STL vertices lie within 3e-6 mm of the B-rep. 3MF 31.5 ->
    35.2 MB; STEP unchanged in size.
    [AH_Right_5F_3S_Wrist_assembly.3mf, AH_Right_5F_3S_Wrist_assembly.step]
2026-10-17 Add no-covers and no-shells beauty renders of the final hand
    These were rendered in the five-finger worktree but never committed.
2026-10-17 Move the webcam teleop into Demo/Teleop and point the README at the final hand
    The teleop lived in an untracked amazinghand-teleop/ folder. Its model copy
    was the stock AH_Right plus generated files, so build_model.py now copies the
    stock model from Demo/AHSimulation on first run and models/ is git-ignored,
    as is the auto-downloaded MediaPipe model.
    The top-level README now opens with this fork's final hand,
    AH_Right_5F_3S_Wrist, and where its CAD, STLs and sim model live.
2026-10-17 Drive the final hand from the webcam teleop
    teleop.py now drives AH_Right_5F_3S_Wrist (scene_shells.xml) by default;
    --model stock5 / stock4 keeps the stock hand that build_model.py sets up
    (replaces --fingers 5 / 4).
    Final-hand mapping:
    - 3-phalanx fingers: flex -56 (straight) to +90, never below -60.
    - Abduction limited to +-30 and faded out by the pinch curl; neighbouring
    fingers may converge by at most 20 deg (>= 1.3 mm apart). The sim does
    not collide digits, so the mapping keeps them apart itself.
    - Thumb (slim mount): blended from open towards a rest pose picked by
    the gesture (across the palm, on the curled middle, pinch, fist), from
    the checked poses in ultimate_finger/data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
    [teleop.py, thumb_limits.py]
2026-10-17 Add an all-printed mock-up of the final 5-digit hand with Kobra X plates
    cad/five_finger/mockup/ lets the final hand (AH_Right_5F_3S_Wrist) be test-assembled before any hardware is bought.
    Every real printed part is used unchanged, and every bought part gets a printed stand-in that fills the same holes.
    The mock-up is posable by hand.
    - make_mockup.py builds the stand-ins from the sim's placements:
    - dummy SCS0009 / STS3215 servos with plain output stubs;
    - friction-fit horns with the ball printed on;
    - one-piece push rods with snap-on ball cups at the sim's ball-to-ball lengths;
    - Link balls and axles, pins, press pegs for every screw size, bushings, bearings, ball studs and insert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
    [Axle_D2.1_L20.stl, Ball_Stud_Arm.stl, Ball_Stud_Top.stl, Bushing_0608.stl, Bushing_F683.stl, Disc_Horn.stl, Dummy_SCS0009.stl, Dummy_STS3215.stl]
2026-10-17 Add hardware control code for the final 5-digit hand
    The stock demos drive only 8 servos, assume the 2-phalanx straight pose and
    would push the re-mounted thumb into the palm shell. These new entry points
    are for AH_Right_5F_3S_Wrist.
    - PythonExample/AmazingHand_Demo_5F.py drives 10 SCS0009 servos (pinky on
    9/10).
    - Every thumb command is clamped to the slim mount's envelope (ported
    from layout.py), and the thumb homes at (0, 22.5).
    - The 3-phalanx finger limits and neighbour-convergence limits are
    enforced on every 50 Hz frame and checked again before each bus write.
    - max_torque_limit is set to 800 and read back (--cores petg/pla for lower
    values).
    - It has --dry-run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
2026-10-17 Let neighbours converge up to 30 deg when one is curled in the 5-digit demo
    A sweep of every neighbour pair of AH_Right_5F_3S over both fingers' whole range
    (Demo/AHSimulation/ultimate_finger/neighbour_sweep.py, reports/neighbour_sweep.txt)
    shows that, with one finger curled, the closest parts are the drive levers and
    converging moves them apart. converge_limit() now allows 15 deg, rising linearly
    to 30 deg as the more curled finger goes from f = 60 to 90. The pose pairs it
    adds keep >= 3 mm (grid, local refinement and exact mesh distance), against
    1.3 mm inside the plain 15 deg limit. Victory and Peace from hand_poses.json
    now run unmodified.
    trajectory() adds frames where the clamps would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
2026-10-17 Enforce the AH_Right_5F_3S limits in AHControl
    AHControl drove every motor to command 0 at start and passed the sim's
    commands straight through, so it could push the slim-mount thumb into the
    palm shell and break the 3-phalanx finger limits. r_hand_5f_3s.toml
    therefore left the thumb out.
    - src/limits.rs ports the clamps of PythonExample/AmazingHand_Demo_5F.py
    with the same numbers: thumb envelope, finger limits, converge_limit,
    clamp_hand, check_hand and the re-planning trajectory. A Python
    cross-check over 20k commands and 300 moves is bit-exact (np.interp's
    multiply-add included), and cargo test carries 36 of its vectors.
    - A top-level `limits = "AH_Right_5F_3S"` turns it on. fac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
2026-10-18 Print every mock-up ball separately from its stud
    In the first fit test both ball posts snapped at their necks. A d2.2 neck
    printed upright breaks across its layers as soon as a cup is levered on.
    The horns carried the same neck, and the wrist studs a d3.5 one.
    - Mock_Horn: the printed ball is gone. A nut-sized boss sits under the
    arm, with a press hole through both.
    - Stud_Pin_D2.1_L8 presses through the horn arm and boss. Ball_D5 presses
    flush onto its top.
    - Link_Ball is renamed Ball_D5 (20 of them: Links and horns).
    - The wrist ball studs are now pins printed lying down. Ball_D5.8 presses
    onto each neck.
    - In the fit test, each ball post is now a block, a stud pin and a ball.
    00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
    [Ball_D5.8.stl, Ball_D5.stl, Ball_Stud_Arm.stl, Ball_Stud_Top.stl, Fit_Ball_Hand.stl, Fit_Ball_Hand_Ball.stl, Fit_Ball_Hand_Pin.stl, Fit_Ball_Hand_Post.stl]
2026-10-18 Print the mock-up's cover backs and palm shell in PLA and cut its supports
    Materials: every real part is now white PLA except the finger gloves and
    the palm pad, which stay black TPU 95A. The cover backs moved to a new
    06_covers_PLA_white group at 0.12 mm, and the palm shell joined the
    02_palm plates.
    Supports, from slicing candidate orientations and reading the support
    grams from the G-code:
    - The presets' own support threshold replaces the 40 deg override (20
    deg at 0.12 mm, 30 deg at 0.16 / 0.20 mm).
    - The back shell prints roof down (17 g of support instead of 28 g),
    and the palm shell rim up (31 g instead of 46 g). Standing them on
    their wrist end would need less, but it puts a p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
    [make_plates.py]
2026-10-20 Show the hero render with and without the palm shell and finger covers in the README
